factus10/tspico-hardware/hardware/bom/tspico-v3-bom-full.csv

Value | Reference | Footprint | MPN | LCSC | Qty | Fitted by
100n | C1-C6,C10,C21,C23-C31,C37,C38,C47,C48,C51,C61,C79 | Capacitor_SMD:C_0603_1608Metric | CC0603KRX7R9BB104 | C14663 | 24 | JLCPCB
4.7u | C20,C22,C39 | Capacitor_SMD:C_0402_1005Metric | CL05A475MP5NRNC | C23733 | 3 | JLCPCB
15p | C35,C36 | Capacitor_SMD:C_0603_1608Metric | CL10C150JB8NNNC | C1644 | 2 | JLCPCB
220u | C40,C41,C46 | Capacitor_SMD:CP_Elec_6.3x5.4 | RVT220UF10V67RV0037 | C2833309 | 3 | JLCPCB
10u | C42-C45,C50,C60,C80,C81 | Capacitor_SMD:C_0603_1608Metric | CL10A106KP8NNNC | C19702 | 8 | JLCPCB
1u | C52,C53,C70 | Capacitor_SMD:C_0603_1608Metric | CL10A105KB8NNNC | C15849 | 3 | JLCPCB
10n | C71,C72,C75,C76 | Capacitor_SMD:C_0603_1608Metric | CL10B103KB8NNNC | C57112 | 4 | JLCPCB
100p | C90-C95 | Capacitor_SMD:C_0603_1608Metric | CL10C101JB8NNNC | C14858 | 6 | JLCPCB
SS34 | D2,D3 | Diode_SMD:D_SMA | SS34 | C8678 | 2 | JLCPCB
green | D4 | LED_SMD:LED_0805_2012Metric | KT-0805G | C2297 | 1 | JLCPCB
USB-C | J1 | Connector_USB:USB_C_Receptacle_HRO_TYPE-C-31-M-12 | TYPE-C-31-M-12 | C165948 | 1 | JLCPCB
microSD | J2 | tspico:microSD_TF-01A | TF-01A | C91145 | 1 | JLCPCB
OLED 1.54in 128x64 I2C | J3 | Connector_PinHeader_2.54mm:PinHeader_1x04_P2.54mm_Vertical | 2.54-1x40P (cut to 4) | C2337 | 1 | hand
3.5mm stereo | J4 | Connector_Audio:Jack_3.5mm_PJ320D_Horizontal | PJ-320D | C431535 | 1 | JLCPCB
Joystick | J5 | Connector_Dsub:DSUB-9_Pins_Horizontal_P2.77x2.84mm_EdgePinOffset7.70mm_Housed_MountingHolesOffset9.12mm | DS1037-09MNAKT74-0CC | C75750 | 1 | hand
JOY +5V | JP10 | Jumper:SolderJumper-2_P1.3mm_Open_RoundedPad1.0x1.5mm |  |  | 1 | none (board feature)
TS2068_Edge | P1 | tspico:TS2068_EdgeConnector_2x32 |  |  | 1 | none (board feature)
4k7 | R1,R2,R6,R7,R44,R45 | Resistor_SMD:R_0603_1608Metric | 0603WAF4701T5E | C23162 | 6 | JLCPCB
1k | R3,R20,R23,R71,R72,R75,R76 | Resistor_SMD:R_0603_1608Metric | 0603WAF1001T5E | C21190 | 7 | JLCPCB
100 | R5,R80,R81,R90-R95 | Resistor_SMD:R_0603_1608Metric | 0603WAF1000T5E | C22775 | 9 | JLCPCB
10k | R8-R10,R12,R13,R15-R17,R21,R22,R34-R38,R40,R41,R43,R73,R77,R96-R101 | Resistor_SMD:R_0603_1608Metric | 0603WAF1002T5E | C25804 | 26 | JLCPCB
2k2 | R14 | Resistor_SMD:R_0603_1608Metric | 0603WAF2201T5E | C4190 | 1 | JLCPCB
5k1 | R24,R25 | Resistor_SMD:R_0603_1608Metric | 0603WAF5101T5E | C23186 | 2 | JLCPCB
33 | R26-R28,R30-R33 | Resistor_SMD:R_0603_1608Metric | 0603WAF330JT5E | C23140 | 7 | JLCPCB
0 | R39 | Resistor_SMD:R_0603_1608Metric | 0603WAF0000T5E | C21189 | 1 | JLCPCB
15k | R42 | Resistor_SMD:R_0603_1608Metric | 0603WAF1502T5E | C22809 | 1 | JLCPCB
100k | R70 | Resistor_SMD:R_0603_1608Metric | 0603WAF1003T5E | C25803 | 1 | JLCPCB
22k | R74,R78 | Resistor_SMD:R_0603_1608Metric | 0603WAF2202T5E | C31850 | 2 | JLCPCB
TS Reset | SW1 | Button_Switch_SMD:SW_Push_1P1T_XKB_TS-1187A | TS-1187A-B-A-B | C318884 | 1 | JLCPCB
NMI | SW2 | Button_Switch_SMD:SW_Push_1P1T_XKB_TS-1187A | TS-1187A-B-A-B | C318884 | 1 | JLCPCB
RUN | SW3 | Button_Switch_SMD:SW_Push_1P1T_XKB_TS-1187A | TS-1187A-B-A-B | C318884 | 1 | JLCPCB
BOOTSEL | SW4 | Button_Switch_SMD:SW_Push_1P1T_XKB_TS-1187A | TS-1187A-B-A-B | C318884 | 1 | JLCPCB
SWCLK | TP1 | TestPoint:TestPoint_Pad_1.5x1.5mm |  |  | 1 | none (board feature)
SWDIO | TP2 | TestPoint:TestPoint_Pad_1.5x1.5mm |  |  | 1 | none (board feature)
GND | TP3 | TestPoint:TestPoint_Pad_1.5x1.5mm |  |  | 1 | none (board feature)
74LVC245APW | U1-U4 | Package_SO:TSSOP-20_4.4x6.5mm_P0.65mm | 74LVC245APW,118 | C6082 | 4 | JLCPCB
74LVC32APW | U6 | Package_SO:TSSOP-14_4.4x5mm_P0.65mm | 74LVC32APW,118 | C6087 | 1 | JLCPCB
74LVC06AD | U7 | Package_SO:SOIC-14_3.9x8.7mm_P1.27mm | EM74LVC06AD | C49188178 | 1 | JLCPCB
XL9555 | U15 | Package_SO:TSSOP-24_4.4x7.8mm_P0.65mm | XL9555 | C609791 | 1 | JLCPCB
RP2350B | U20 | Package_DFN_QFN:QFN-80-1EP_10x10mm_P0.4mm_EP3.4x3.4mm | RP2350B | C42415655 | 1 | JLCPCB
GD25Q128ESIGR | U21 | Package_SO:SOIC-8_5.3x5.3mm_P1.27mm | GD25Q128ESIGR | C2928891 | 1 | JLCPCB
APS6404L-3SQR-SN | U22 | Package_SO:SOIC-8_3.9x4.9mm_P1.27mm | APS6404L-3SQR-SN | C5333729 | 1 | hand (DNP)
TLV1117LV33 | U30,U31 | Package_TO_SOT_SMD:SOT-223-3_TabPin2 | TLV1117LV33DCYR | C15578 | 2 | JLCPCB
SY6280AAC | U32 | Package_TO_SOT_SMD:SOT-23-5 | SY6280AAC | C55136 | 1 | JLCPCB
ME6211C12M5G-N | U33 | Package_TO_SOT_SMD:SOT-23-5 | ME6211C12M5G-N | C236672 | 1 | JLCPCB
ESP32-C3-WROOM-02-N4 | U40 | RF_Module:ESP32-C3-WROOM-02 | ESP32-C3-WROOM-02-N4 | C2934560 | 1 | JLCPCB
MCP6002 | U50 | Package_SO:SOIC-8_3.9x4.9mm_P1.27mm | MCP6002T-I/SN | C7377 | 1 | JLCPCB
12MHz | Y1 | Crystal:Crystal_SMD_3225-4Pin_3.2x2.5mm | ABM8-272-T3 | C20625731 | 1 | JLCPCB
