factus10/tspico-hardware/hardware/docs/tspico-v3-pcb.pdf

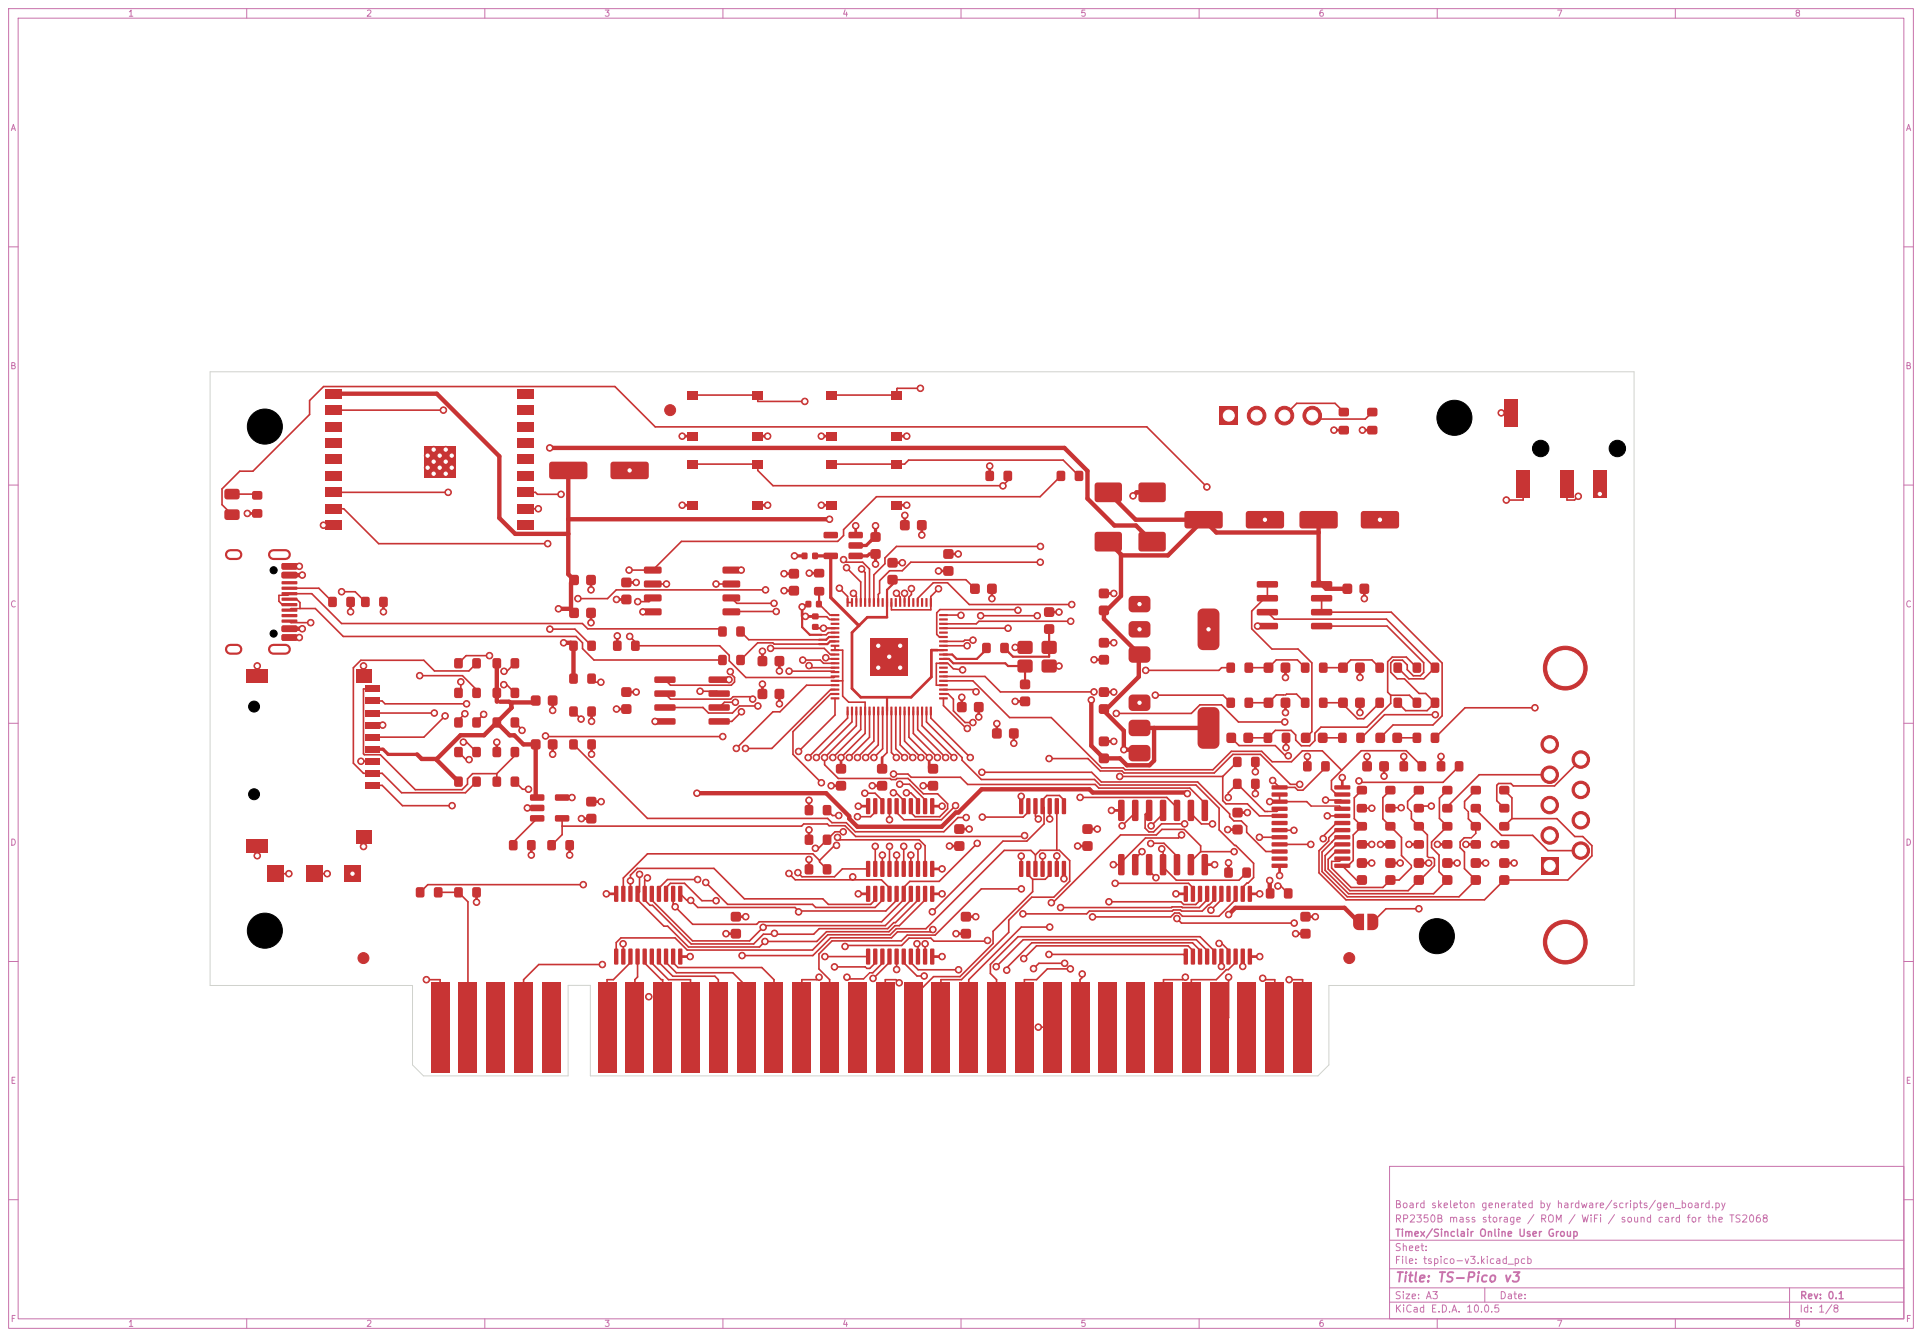
[picture p6: page 1]

Board skeleton generated by hardware/scripts/gen_board.py
RP2350B mass storage / ROM / WiFi / sound card for the TS2068
Timex/Sinclair Online User Group
Sheet:
File: tspico-v3.kicad_pcb
Title: TS-Pico v3

Size: A3 | Rev: 0.1 | F Date:
KiCad E.D.A. 10.0.5 | Id: 1/8

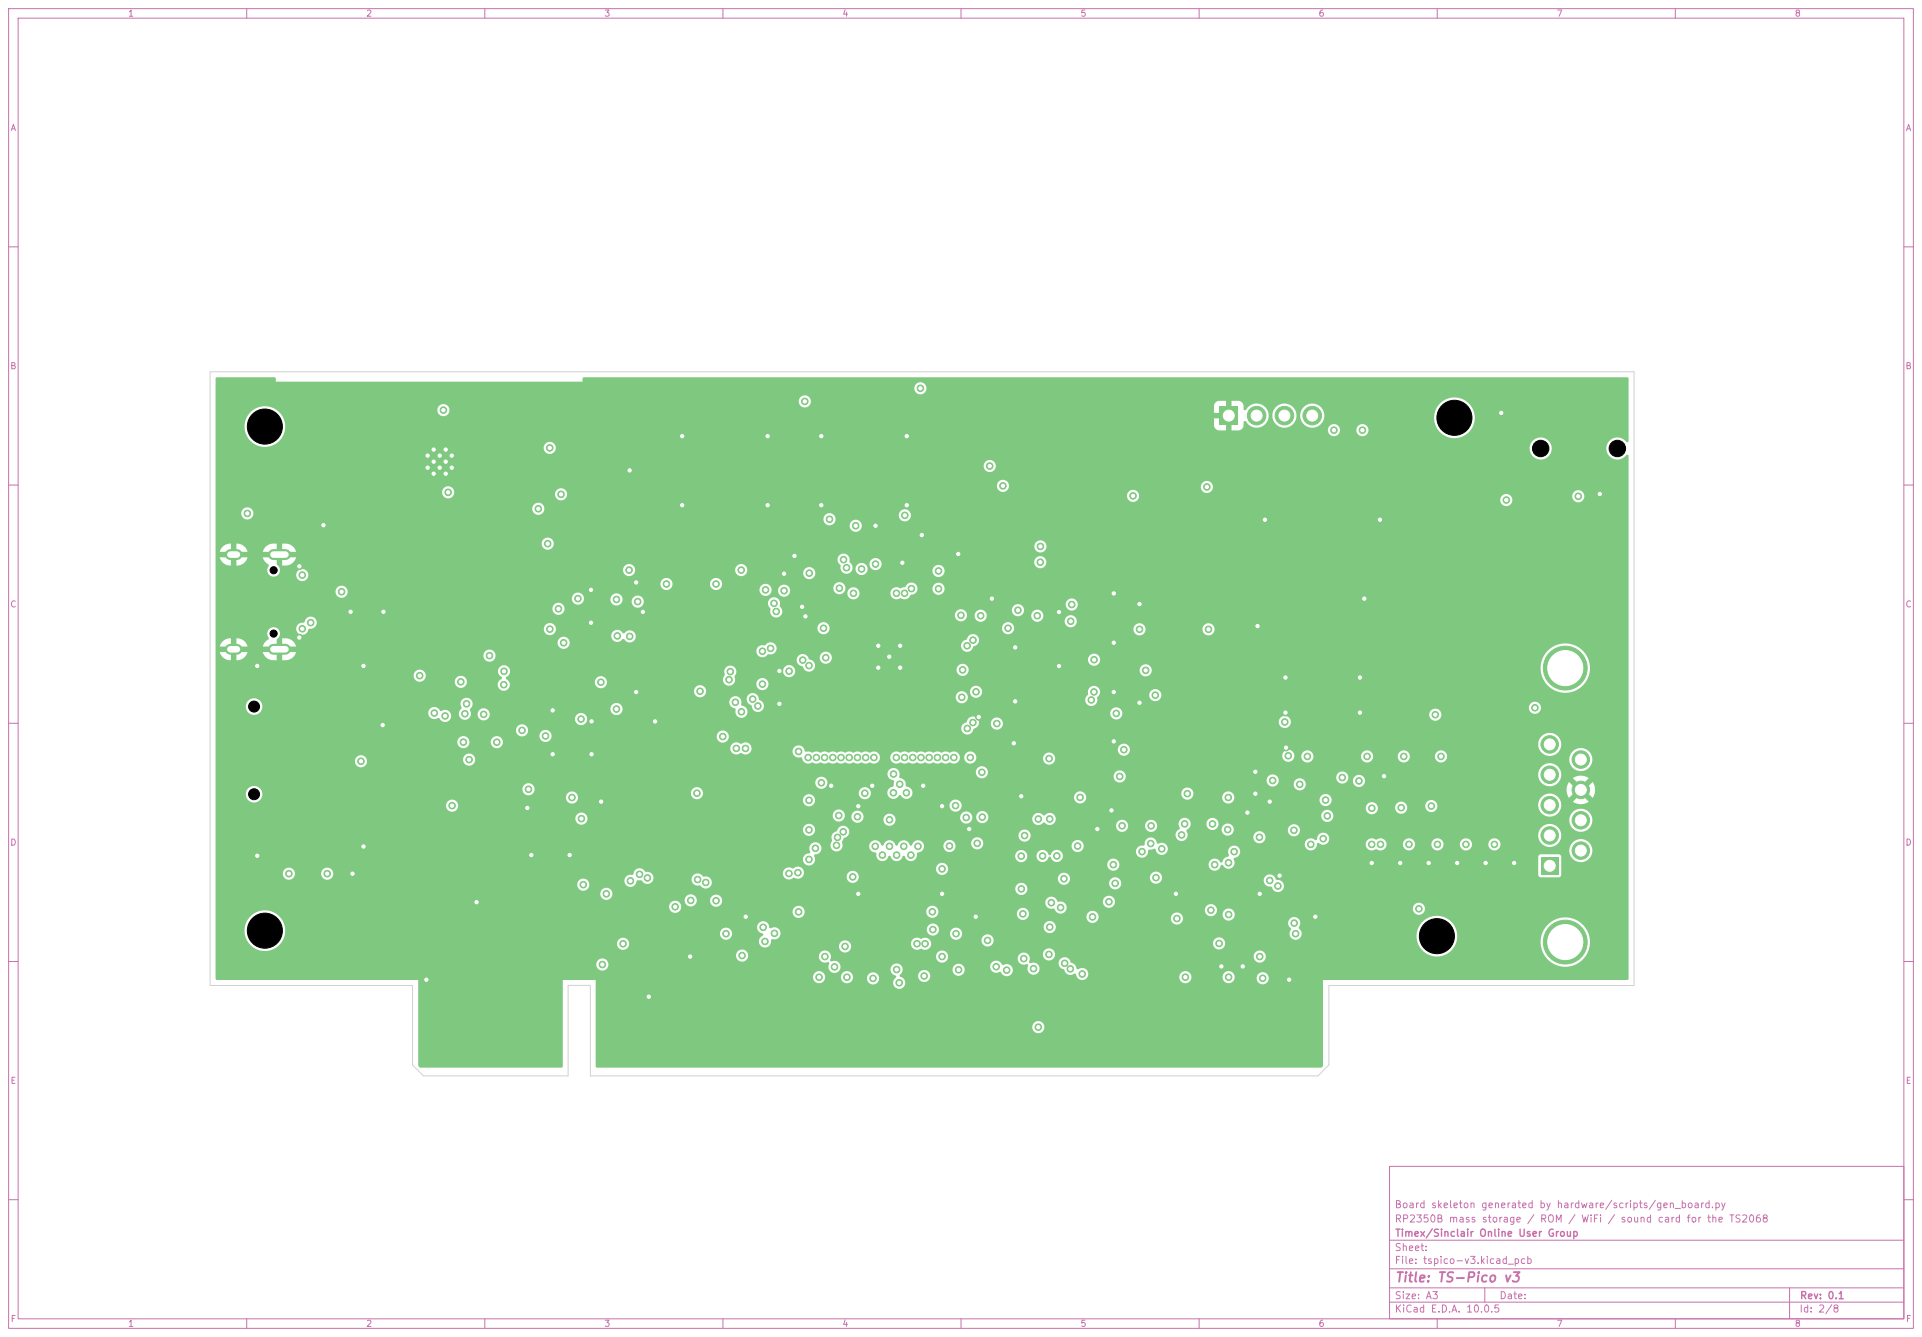
[picture p7: page 2]
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

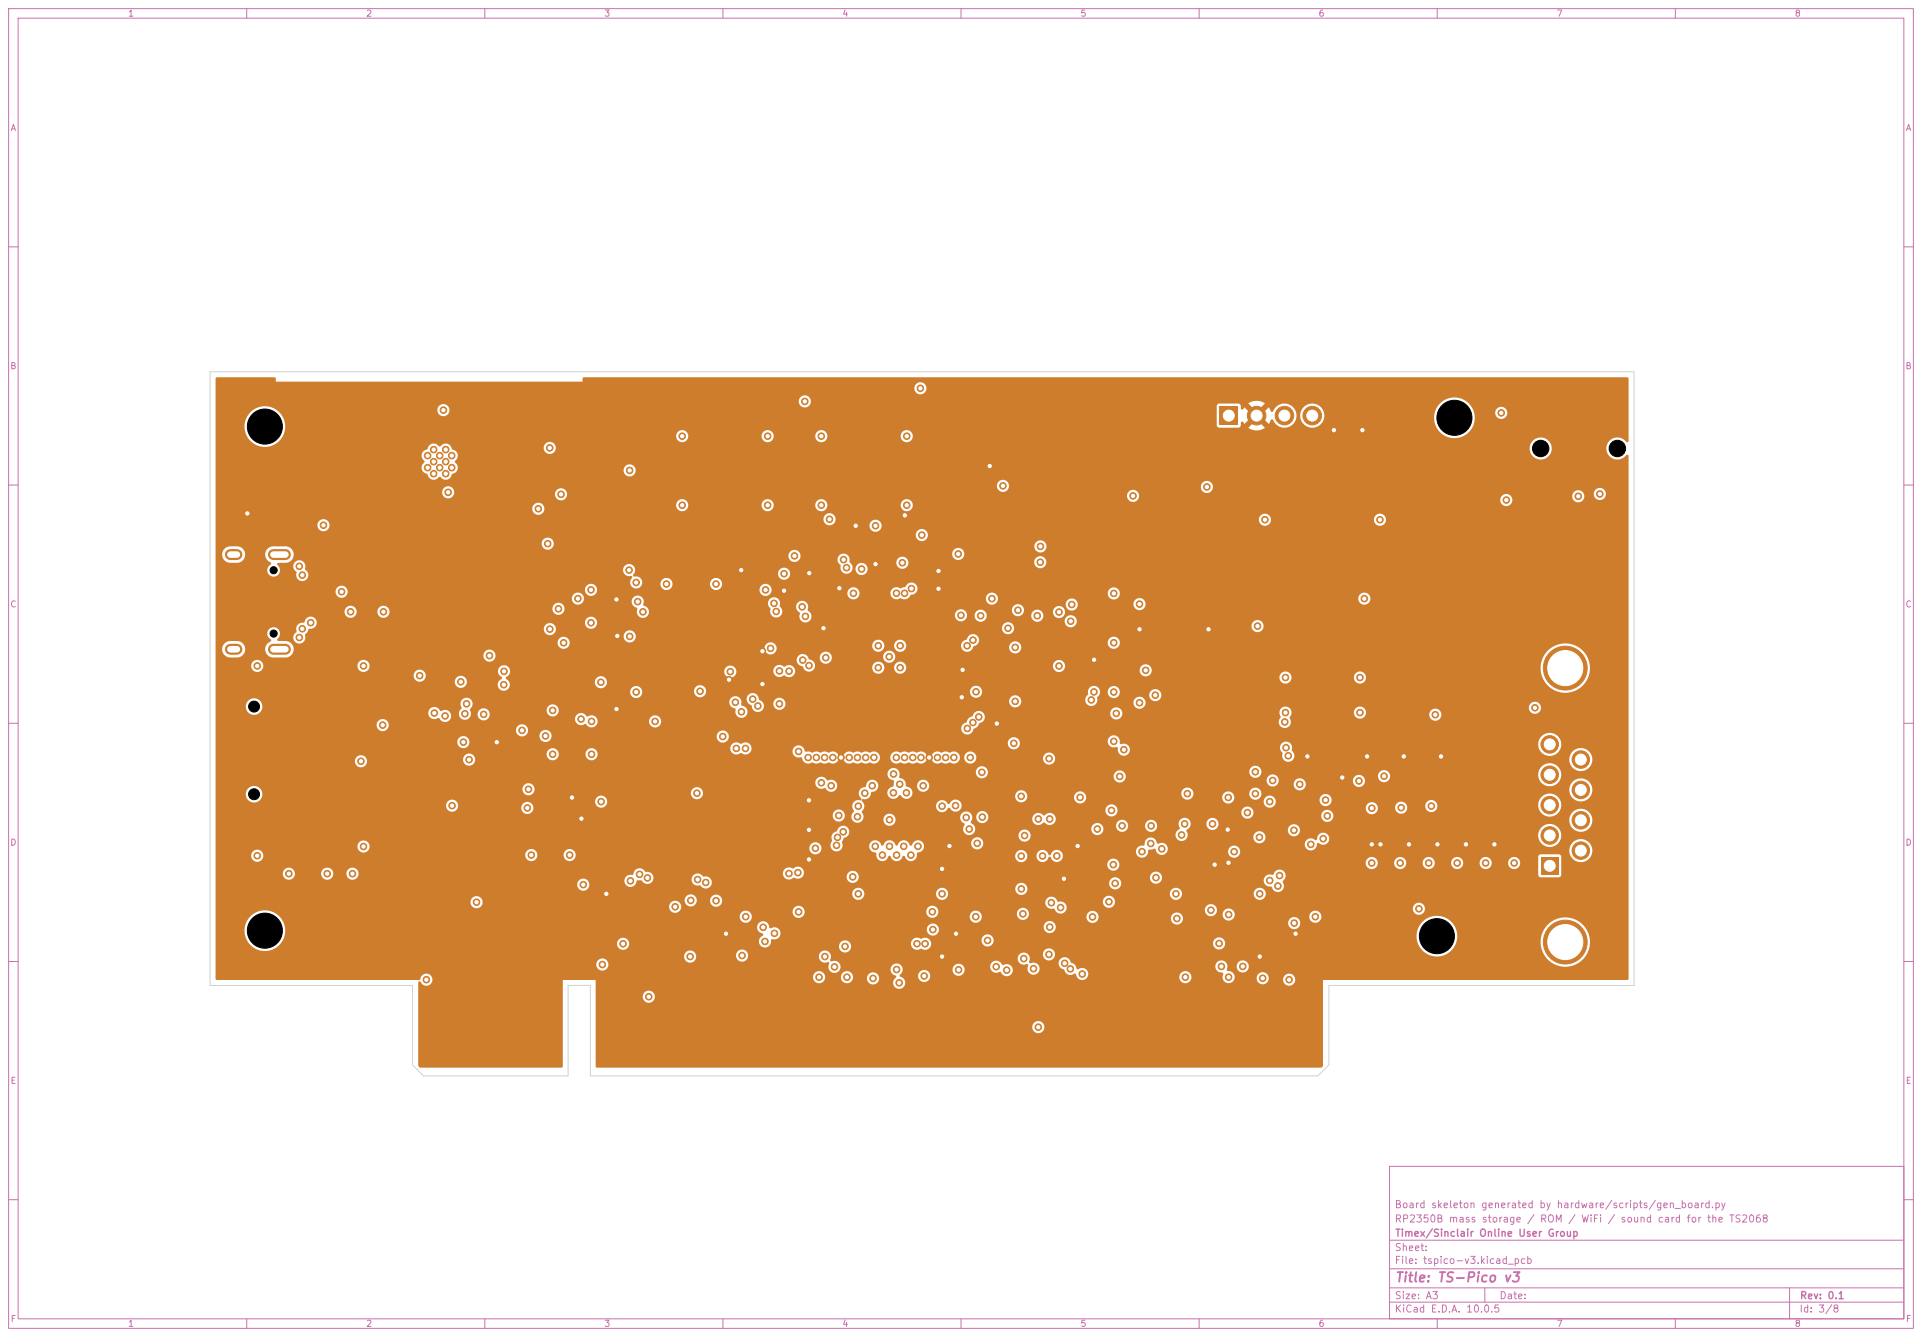
[picture p8: page 3]
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

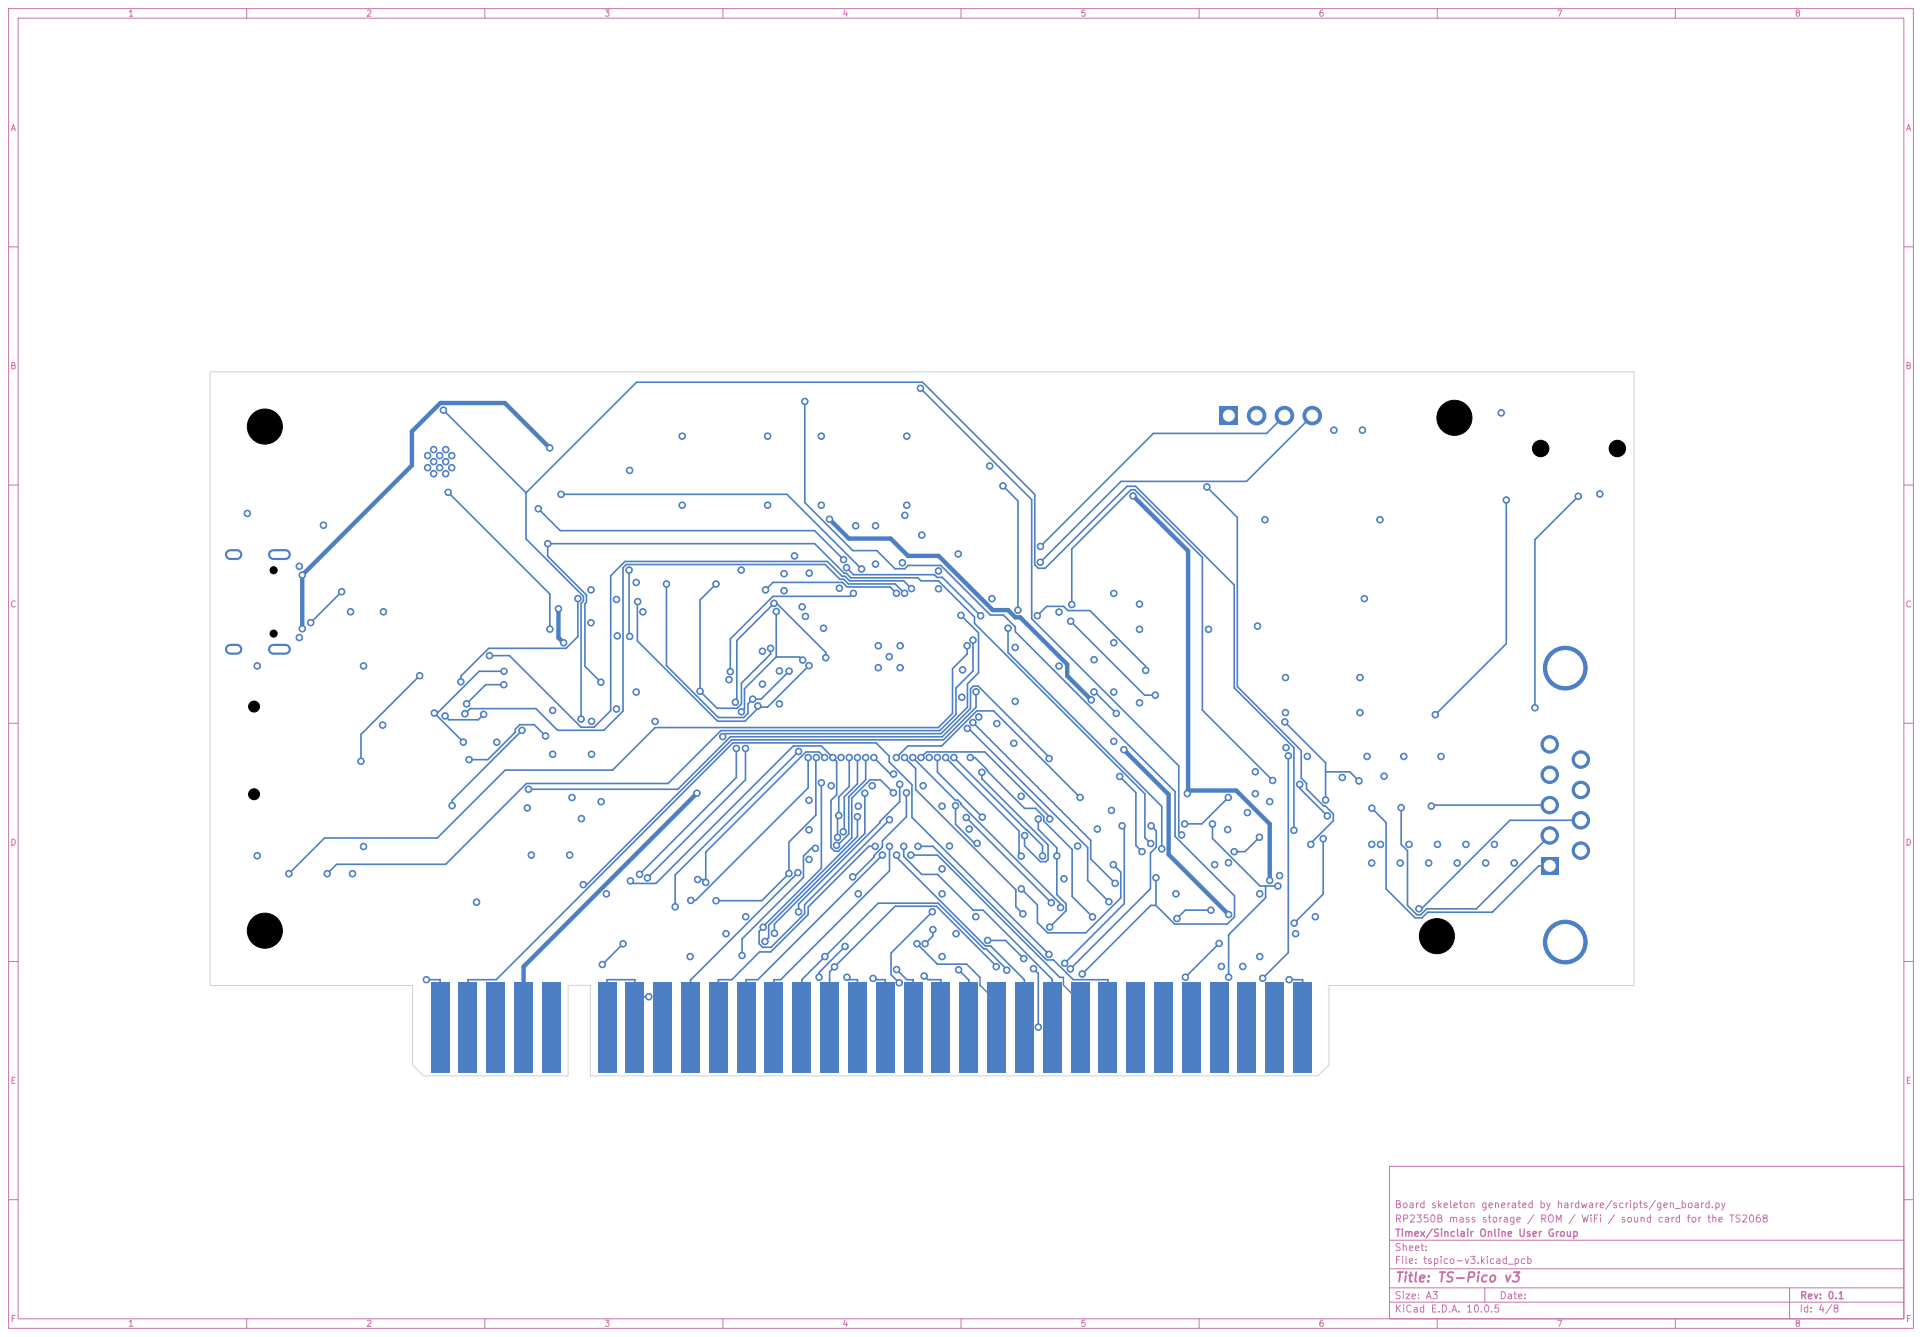
[picture p9: page 4]
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

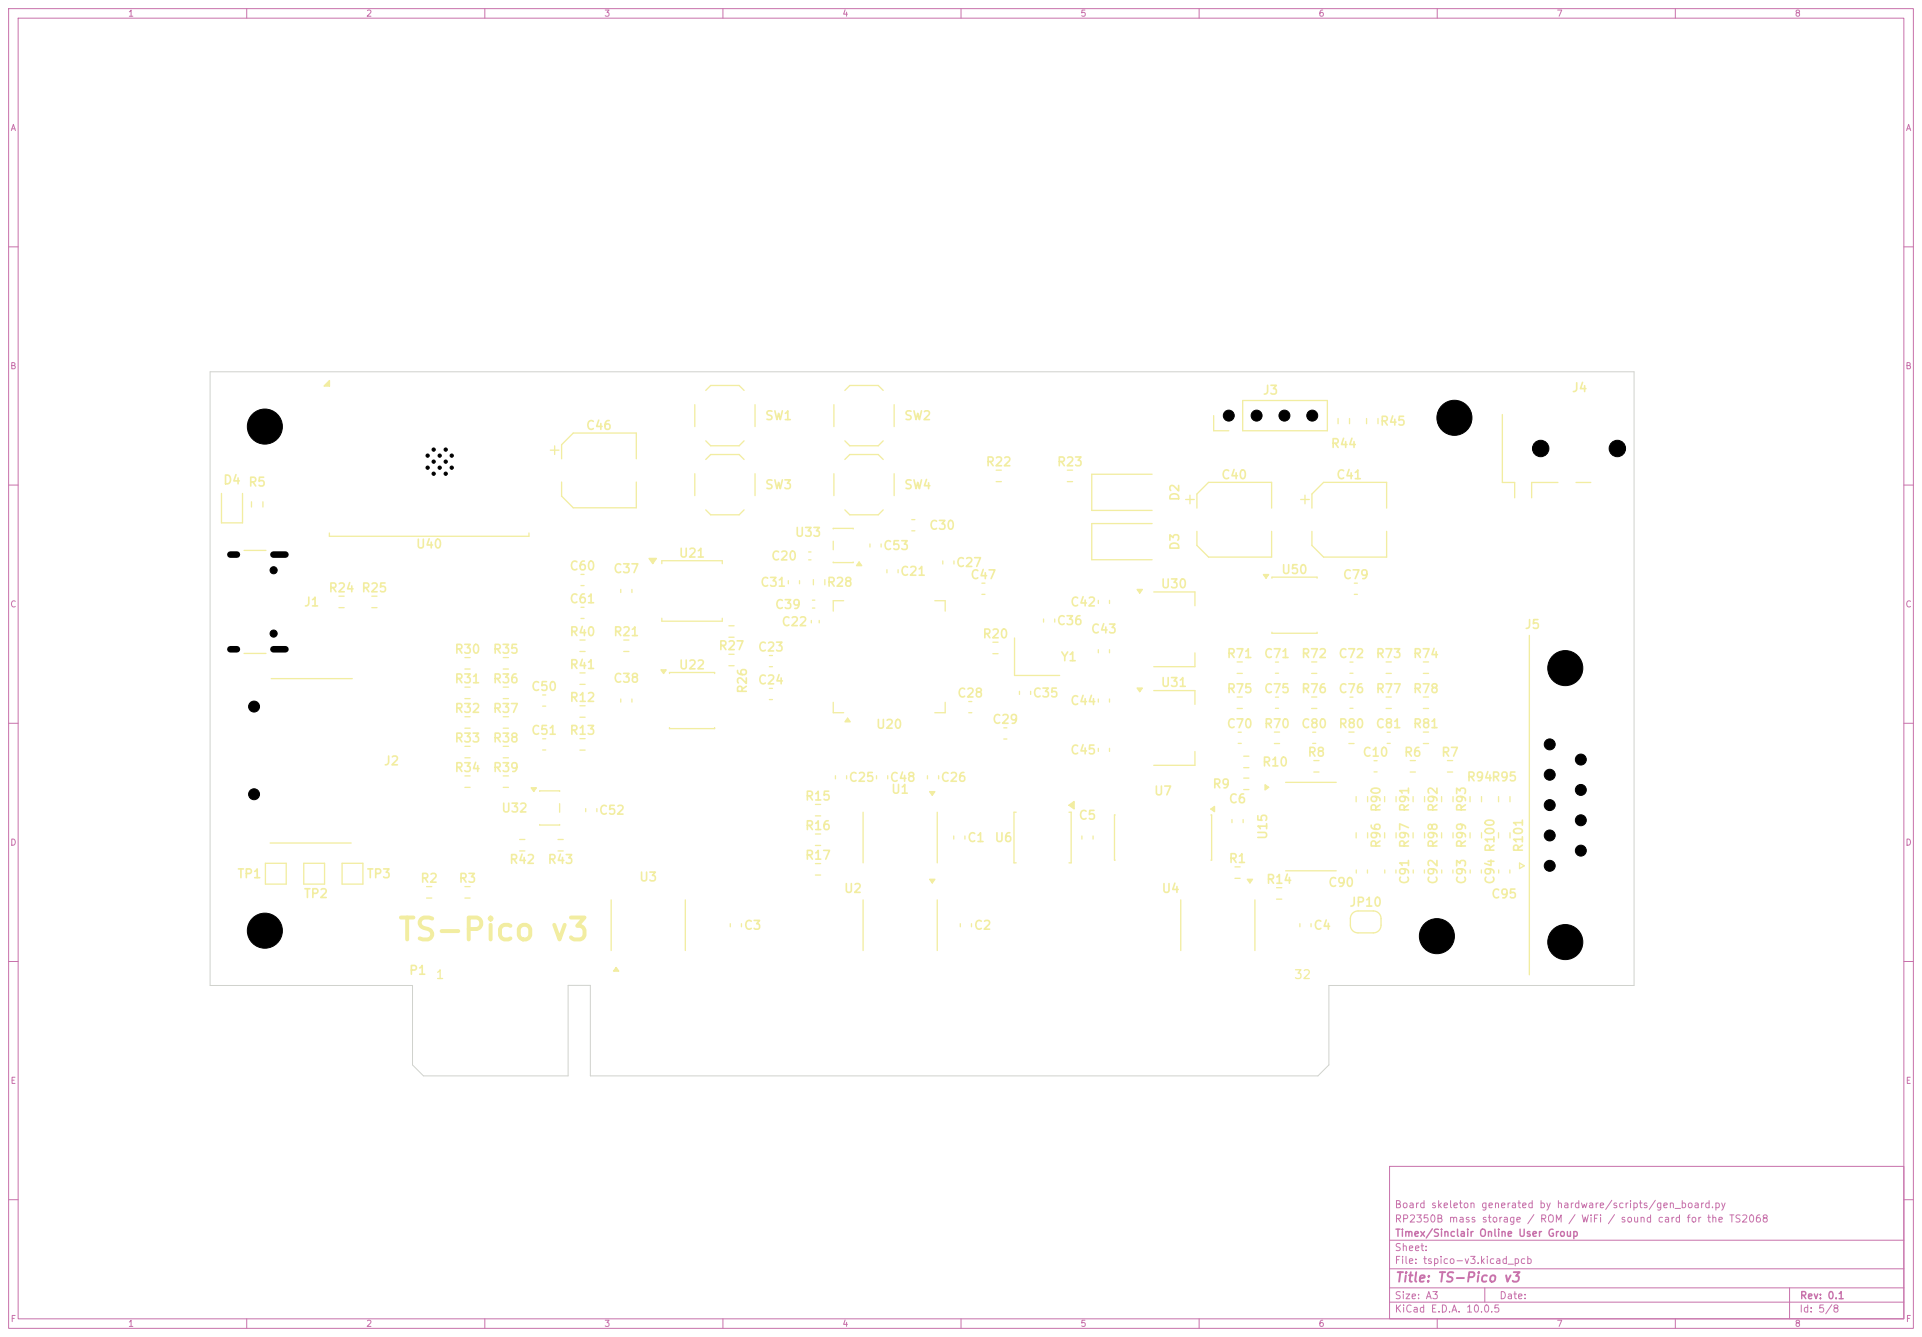
[picture p10: page 5]
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

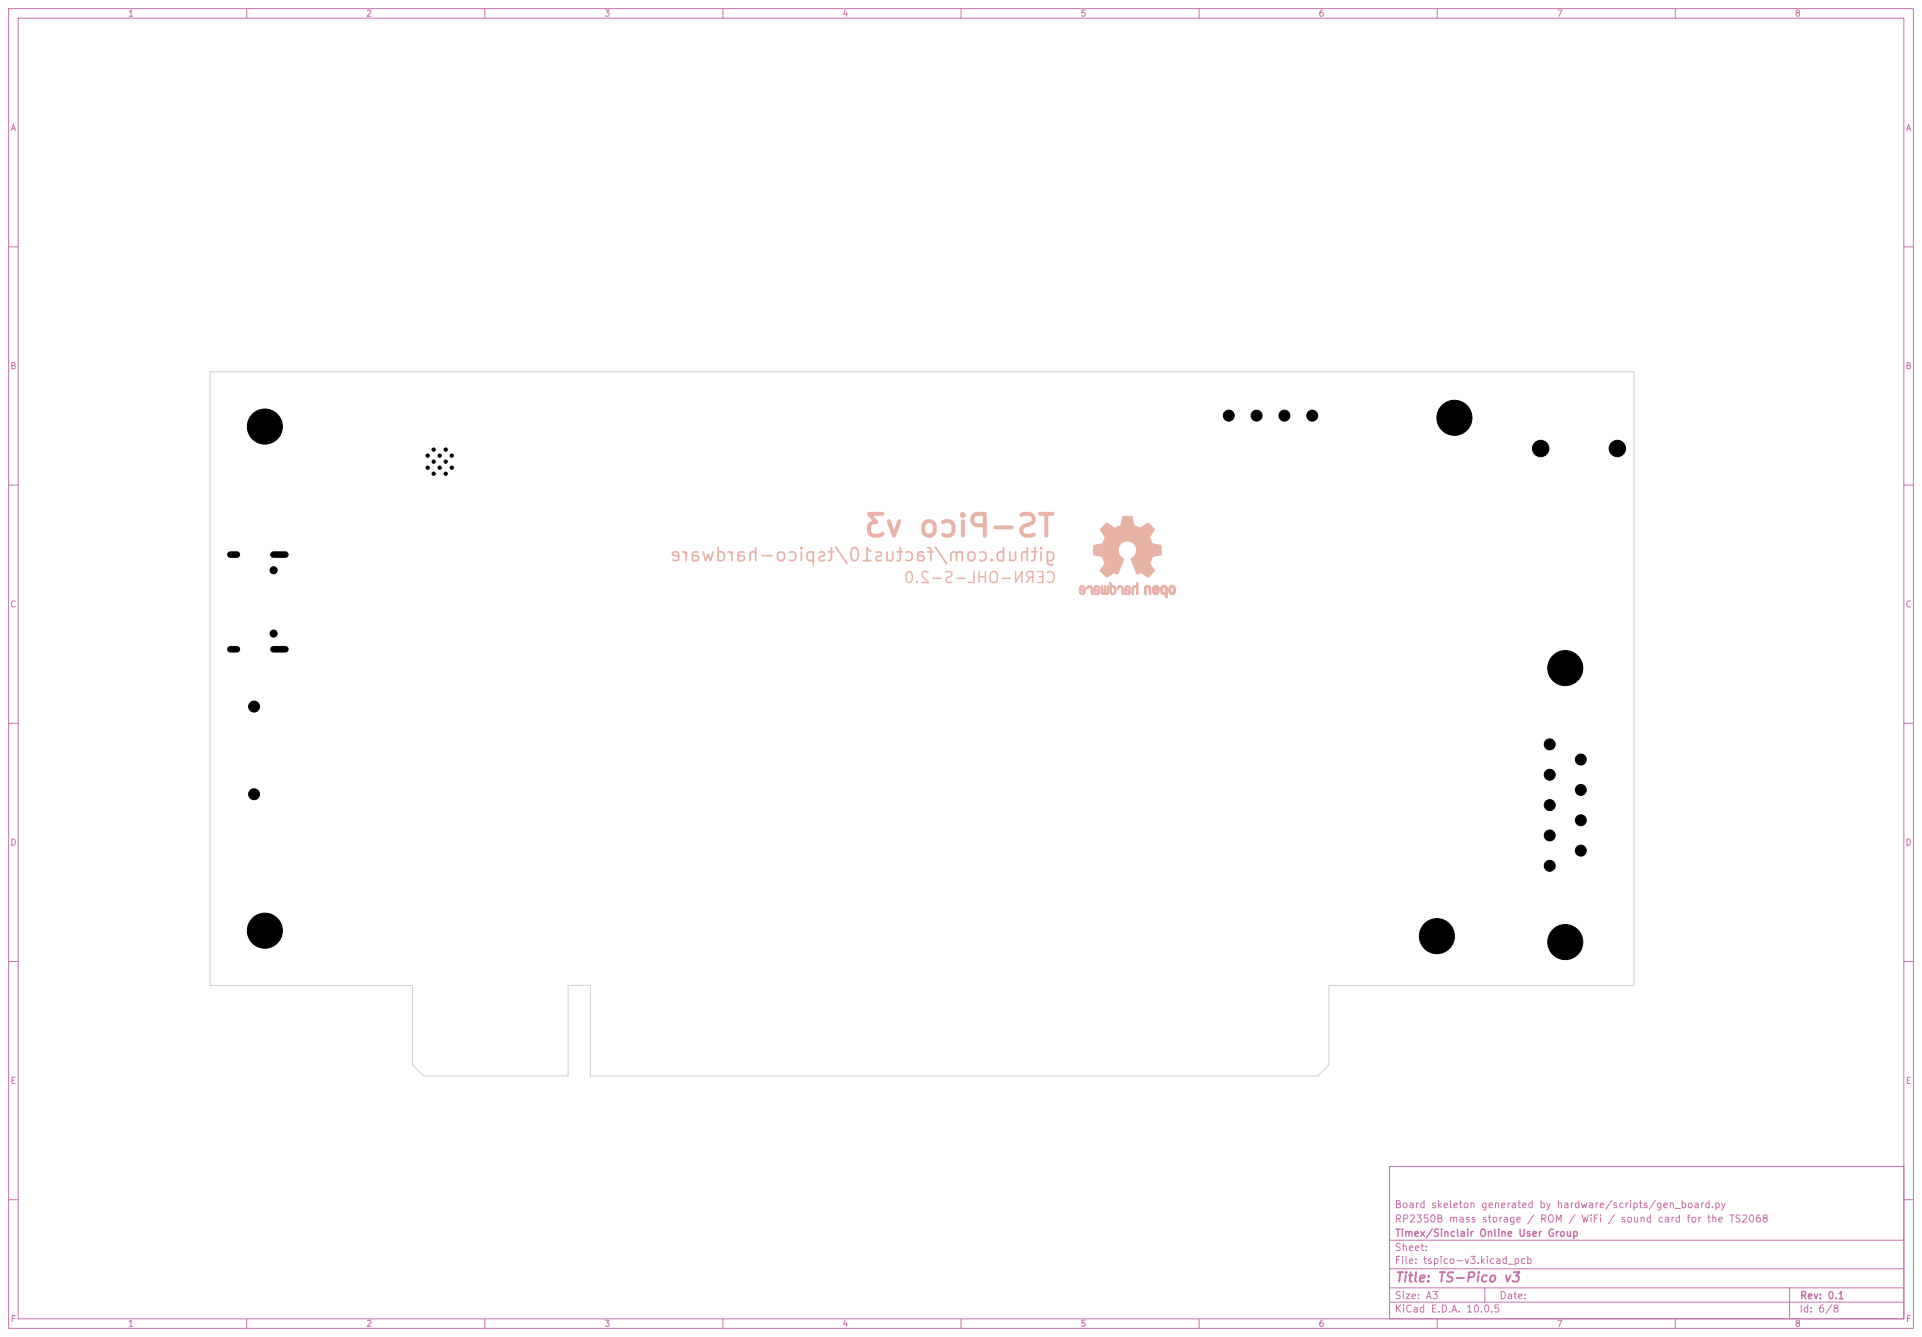
[picture p11: page 6]
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

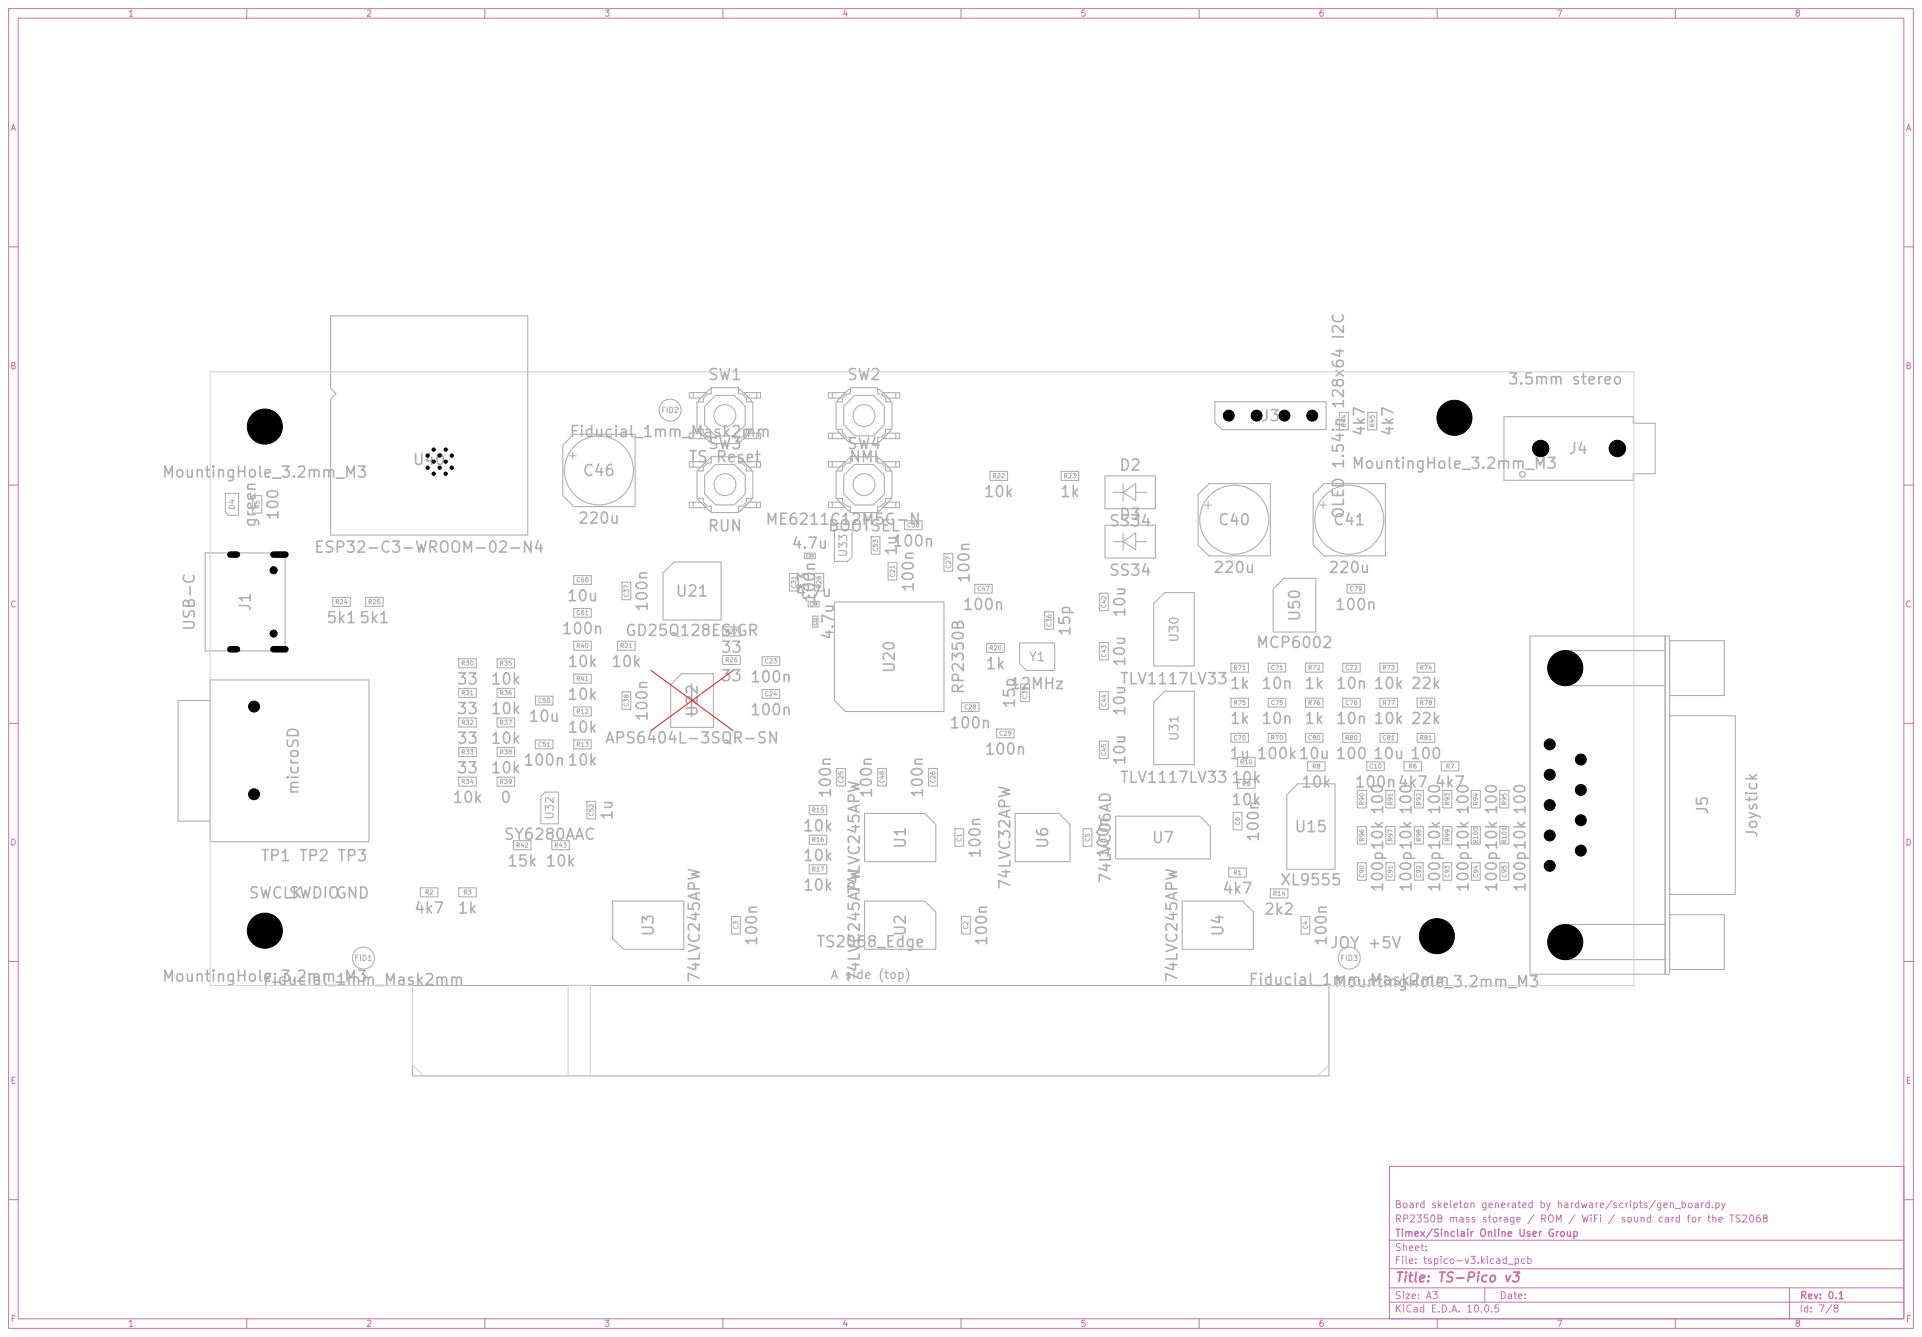
[picture p12: page 7]
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

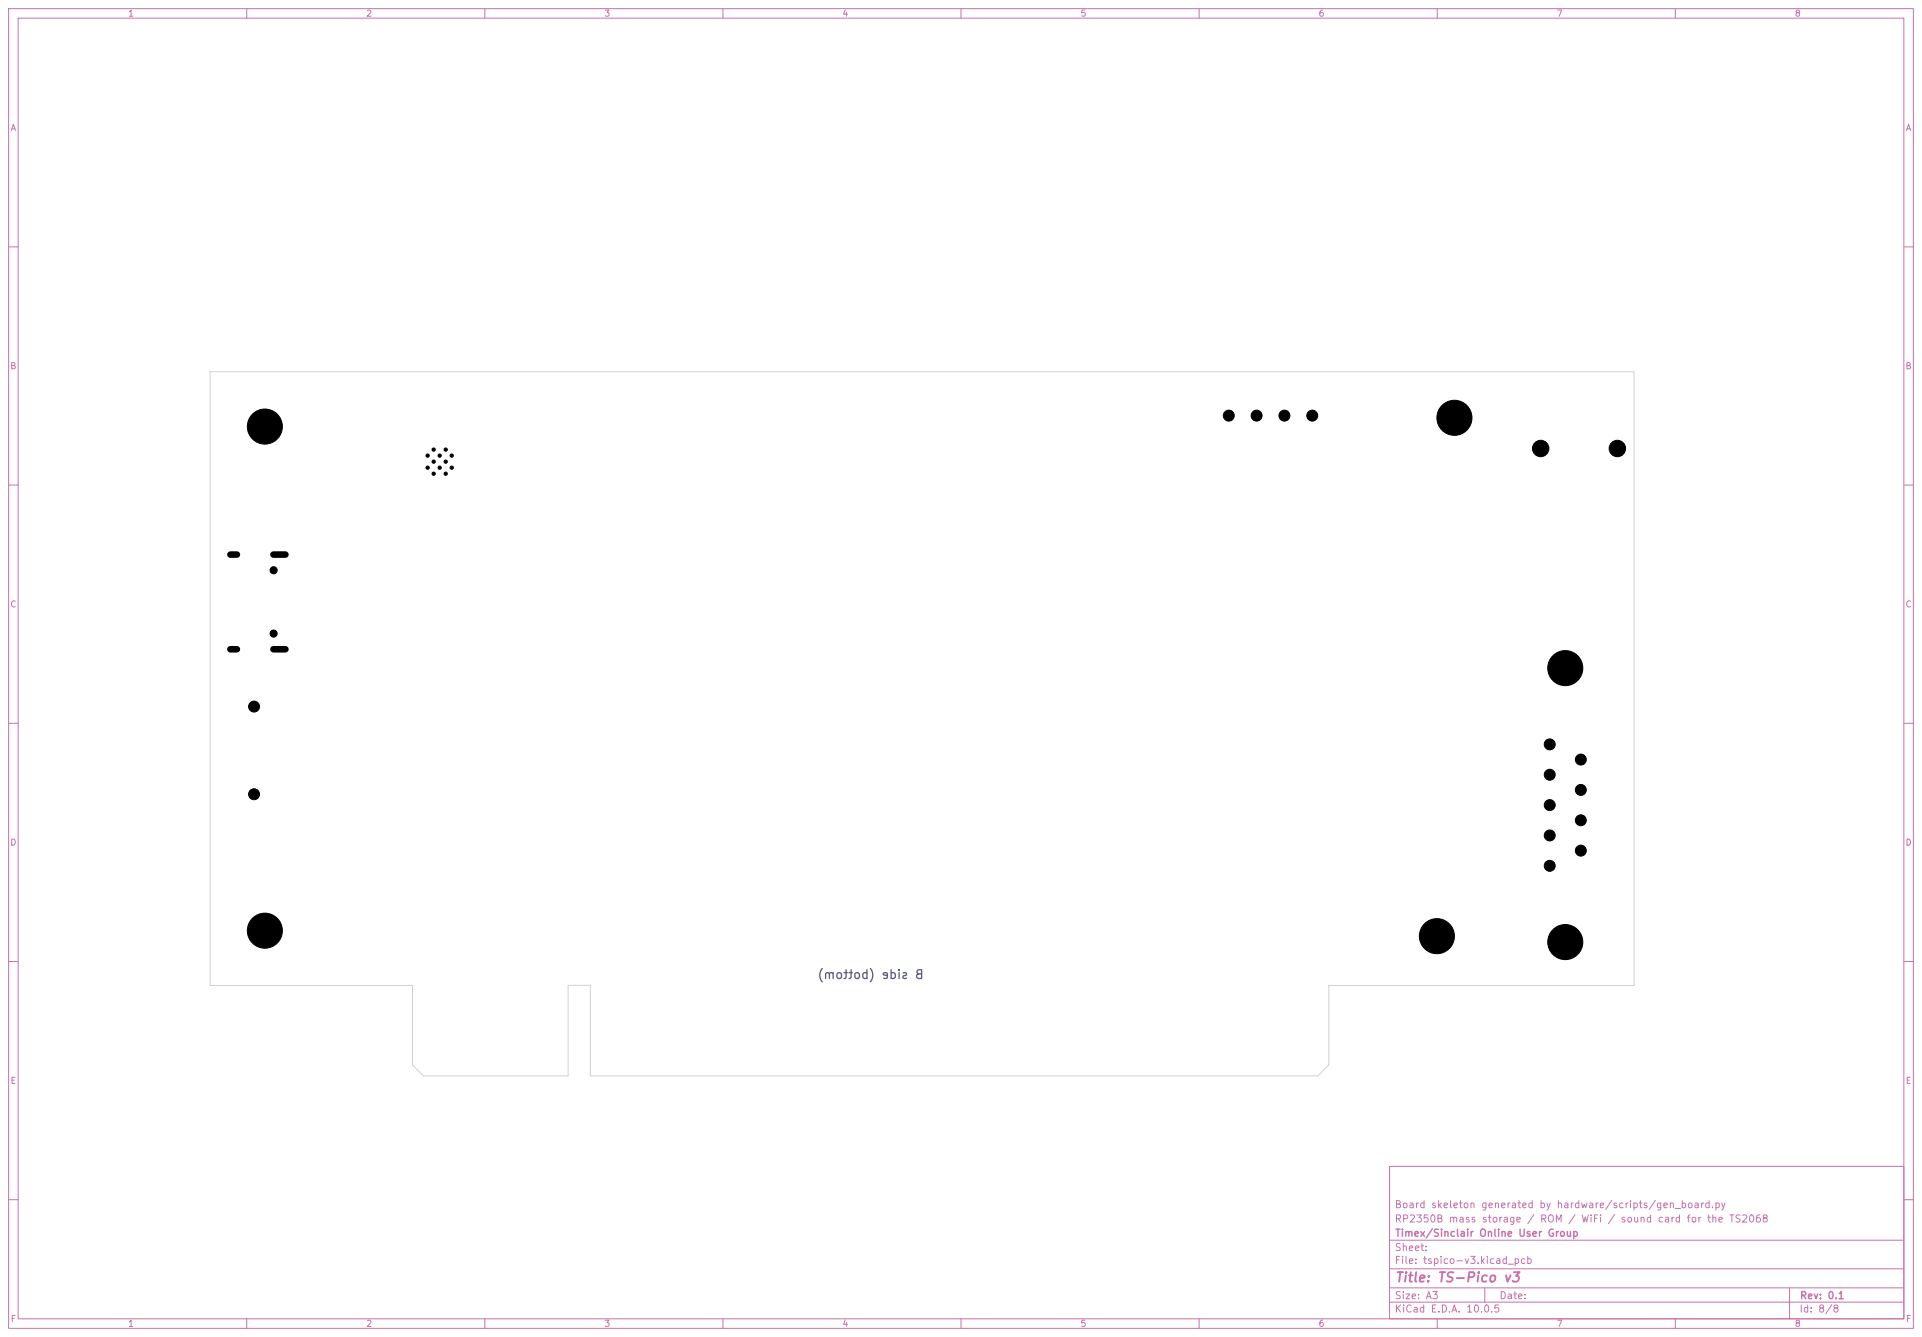
[picture p13: page 8]
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
