factus10/tspico-hardware/hardware/docs/tspico-v3-schematic.pdf

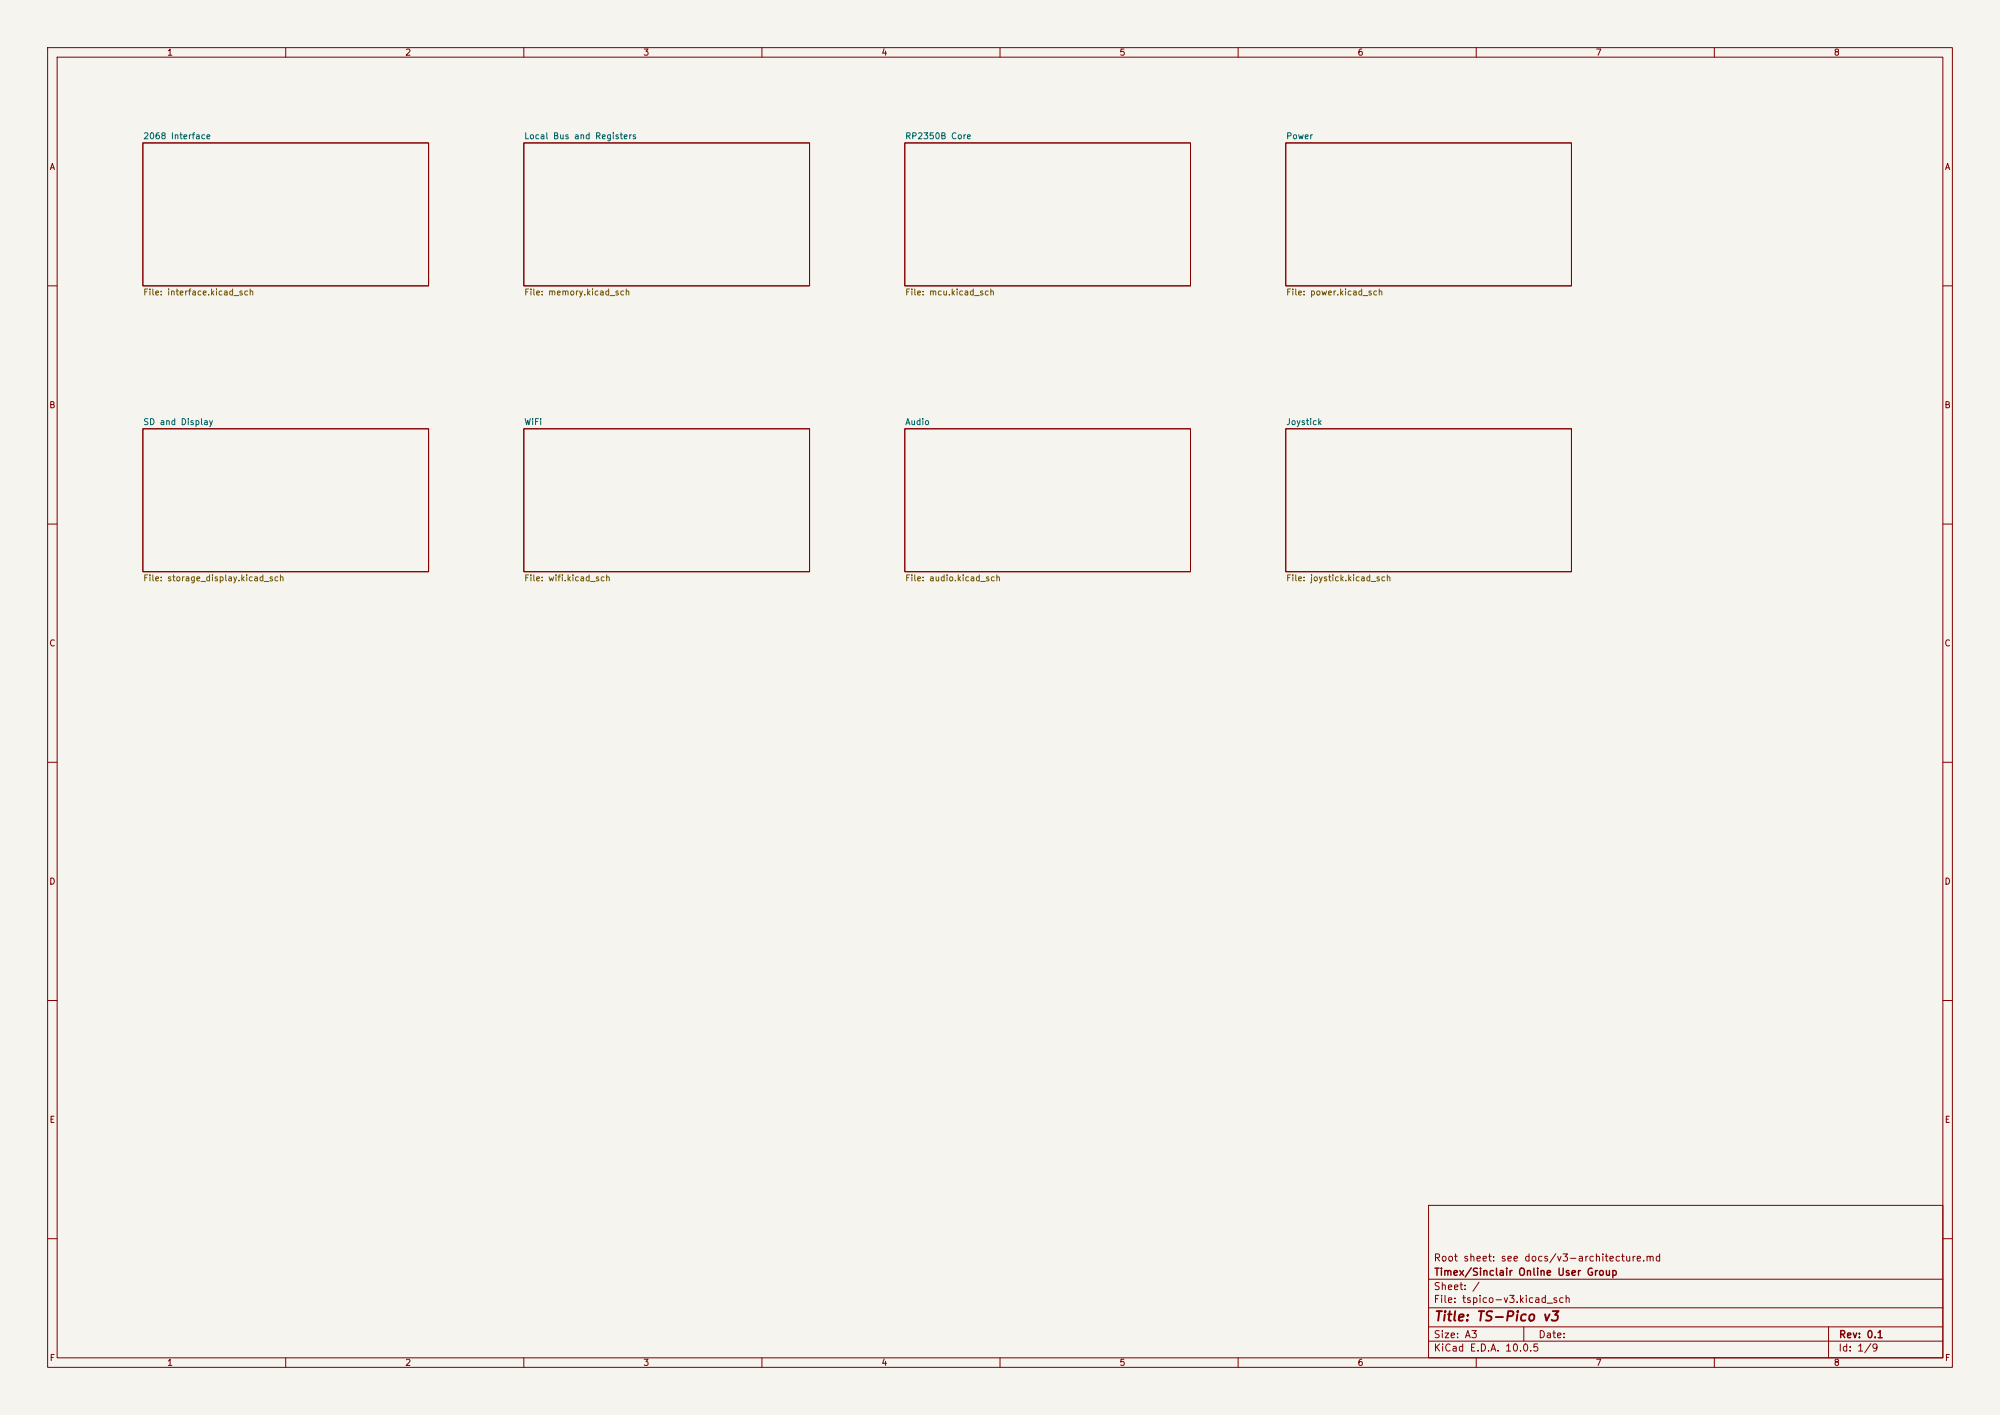
[picture p14: page 1]

Root sheet: see docs/v3-architecture.md
Timex/Sinclair Online User Group
Sheet: /
File: tspico-v3.kicad_sch
Title: TS-Pico v3

Size: A3 | Rev: 0.1 | F Date:
KiCad E.D.A. 10.0.5 | Id: 1/9

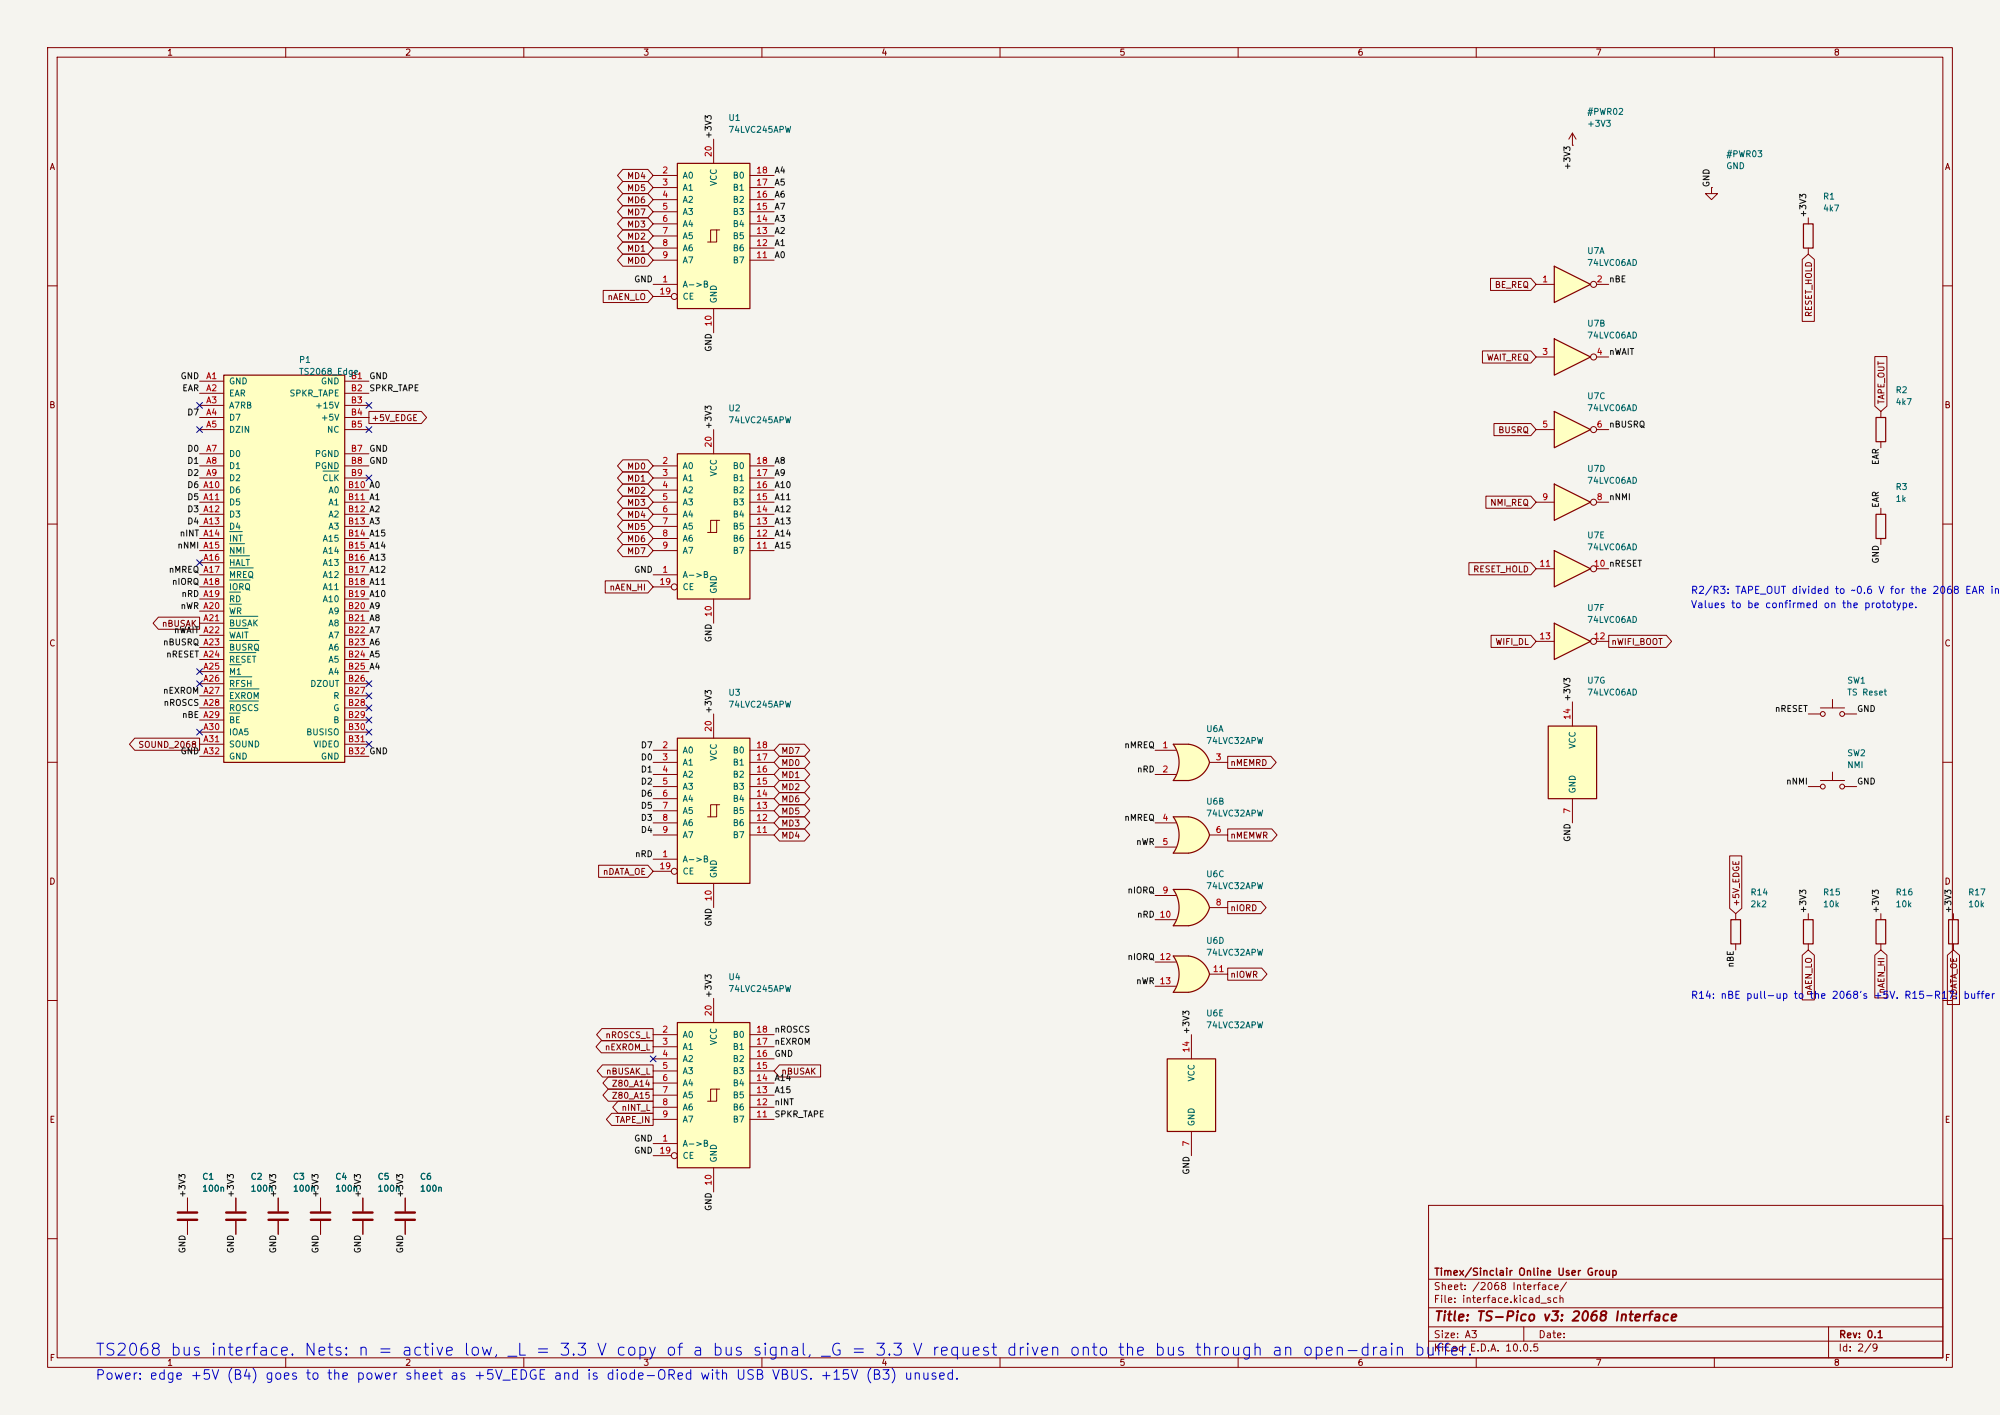
[picture p15: page 2]

R2/R3: TAPE_OUT divided to ~0.6 V for the 2068 EAR input.

Values to be confirmed on the prototype. C6

R14: nBE pull-up to the 2068's +5V. R15-R17: buffer enables held off until the firmware drives GP8-GP10.

Timex/Sinclair Online User Group
Sheet: /2068 Interface/
File: interface.kicad_sch
Title: TS-Pico v3: 2068 Interface

TS2068 bus interface. Nets: n = active low, _L = 3.3 V copy of a bus signal, _G = 3.3 V request driven onto the bus through an open-drain buffer.
Power: edge +5V (B4) goes to the power sheet as +5V_EDGE and is diode-ORed with USB VBUS. +15V (B3) unused.

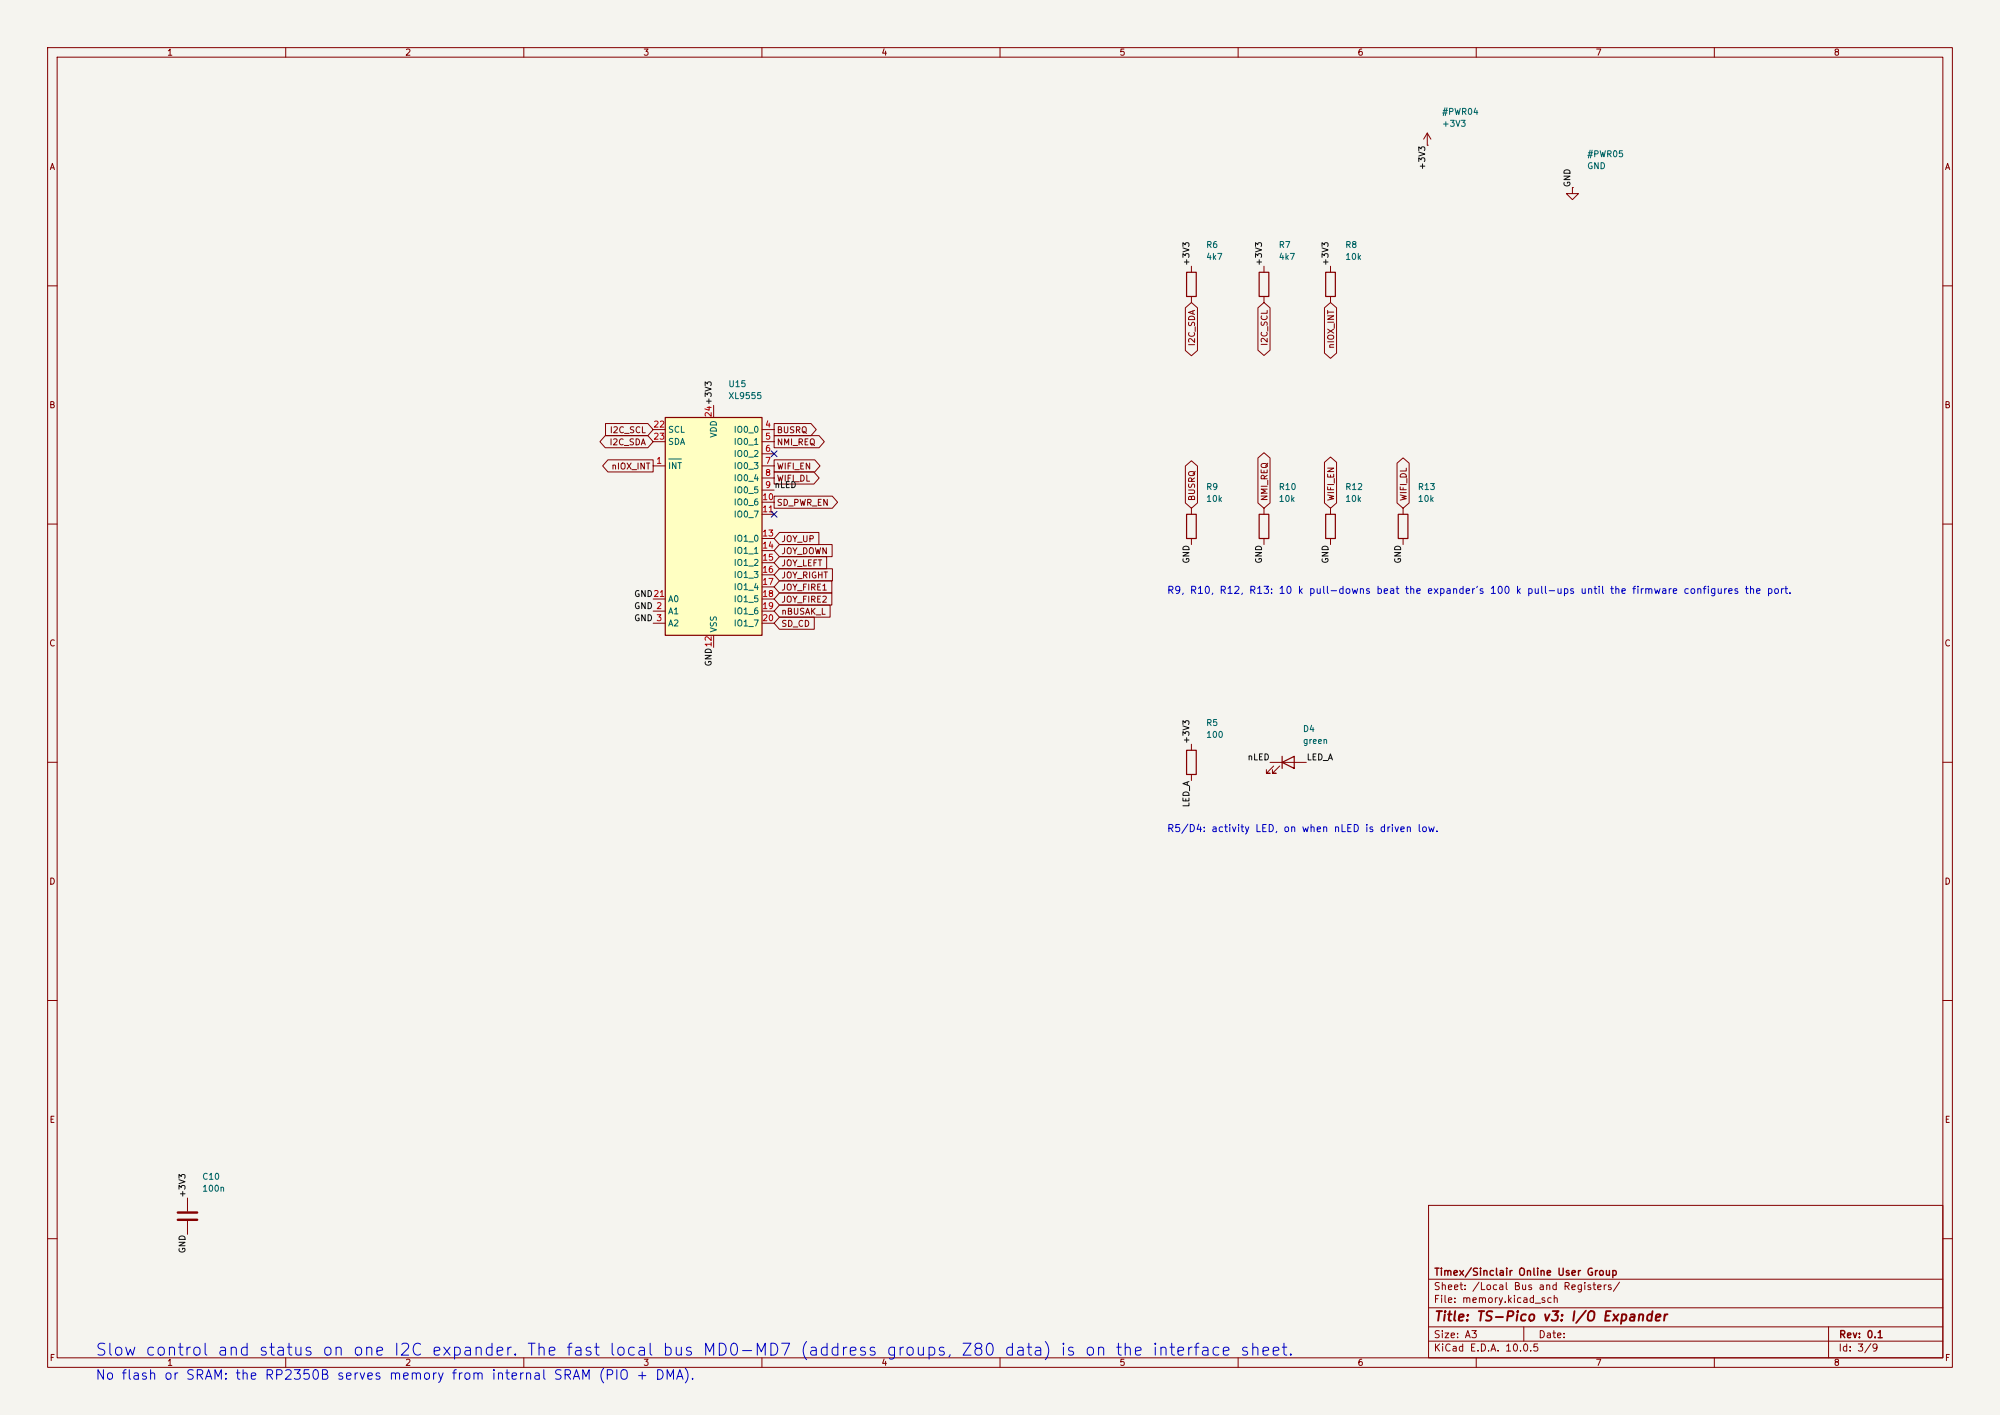
[picture p16: page 3]

R9, R10, R12, R13: 10 k pull-downs beat the expander's 100 k pull-ups until the firmware configures the port.

Timex/Sinclair Online User Group
Sheet: /Local Bus and Registers/
File: memory.kicad_sch
Title: TS-Pico v3: I/O Expander

Slow control and status on one I2C expander. The fast local bus MD0-MD7 (address groups, Z80 data) is on the interface sheet.
No flash or SRAM: the RP2350B serves memory from internal SRAM (PIO + DMA).

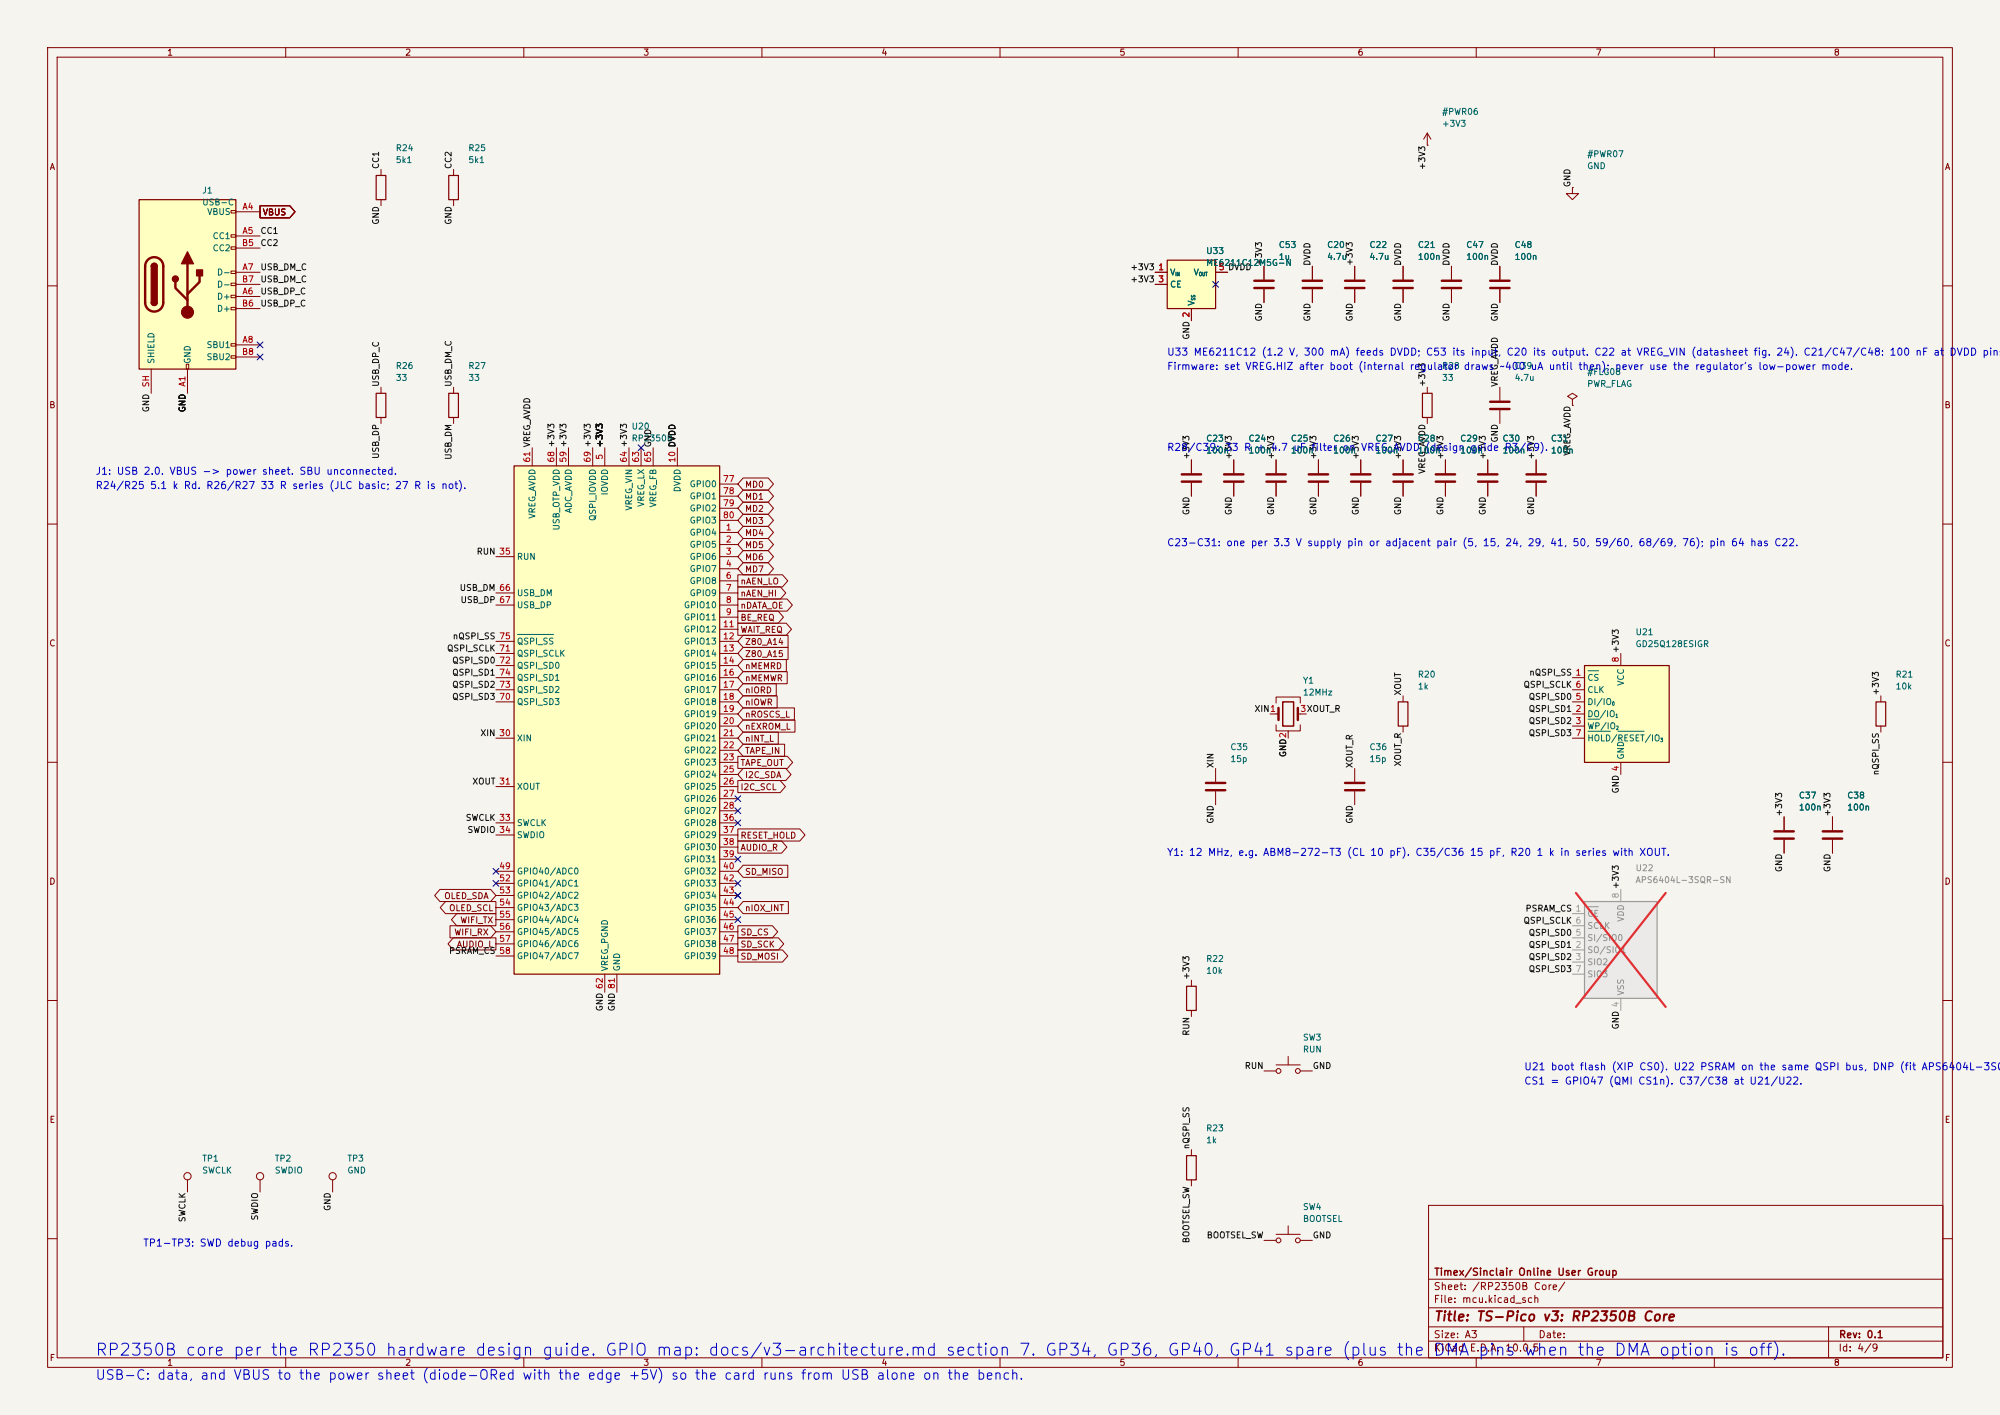
[picture p17: page 4]

C23-C31: one per 3.3 V supply pin or adjacent pair (5, 15, 24, 29, 41, 50, 59/60, 68/69, 76); pin 64 has C22. U33 ME6211C12M5G-N

Timex/Sinclair Online User Group GND A1

U33 ME6211C12 (1.2 V, 300 mA) feeds DVDD; C53 its input, C20 its output. C22 at VREG_VIN (datasheet fig. 24). C21/C47/C48: 100 nF at DVDD pins 51, 32, 10.
Firmware: set VREG.HIZ after boot (internal regulator draws ~400 uA until then); never use the regulator's low-power mode.

R28/C39: 33 R + 4.7 uF filter on VREG_AVDD (design guide R3/C9).

J1: USB 2.0. VBUS -> power sheet. SBU unconnected.
R24/R25 5.1 k Rd. R26/R27 33 R series (JLC basic; 27 R is not).

4 DI/IO0 5 CLK 6 HOLD/RESET/IO3 7 VCC

Y1: 12 MHz, e.g. ABM8-272-T3 (CL 10 pF). C35/C36 15 pF, R20 1 k in series with XOUT.

U21 boot flash (XIP CS0). U22 PSRAM on the same QSPI bus, DNP (fit APS6404L-3SQR-SN or ESP-PSRAM64H; SD-image cache only),
CS1 = GPIO47 (QMI CS1n). C37/C38 at U21/U22.

Sheet: /RP2350B Core/
File: mcu.kicad_sch
Title: TS-Pico v3: RP2350B Core

USB-C: data, and VBUS to the power sheet (diode-ORed with the edge +5V) so the card runs from USB alone on the bench.

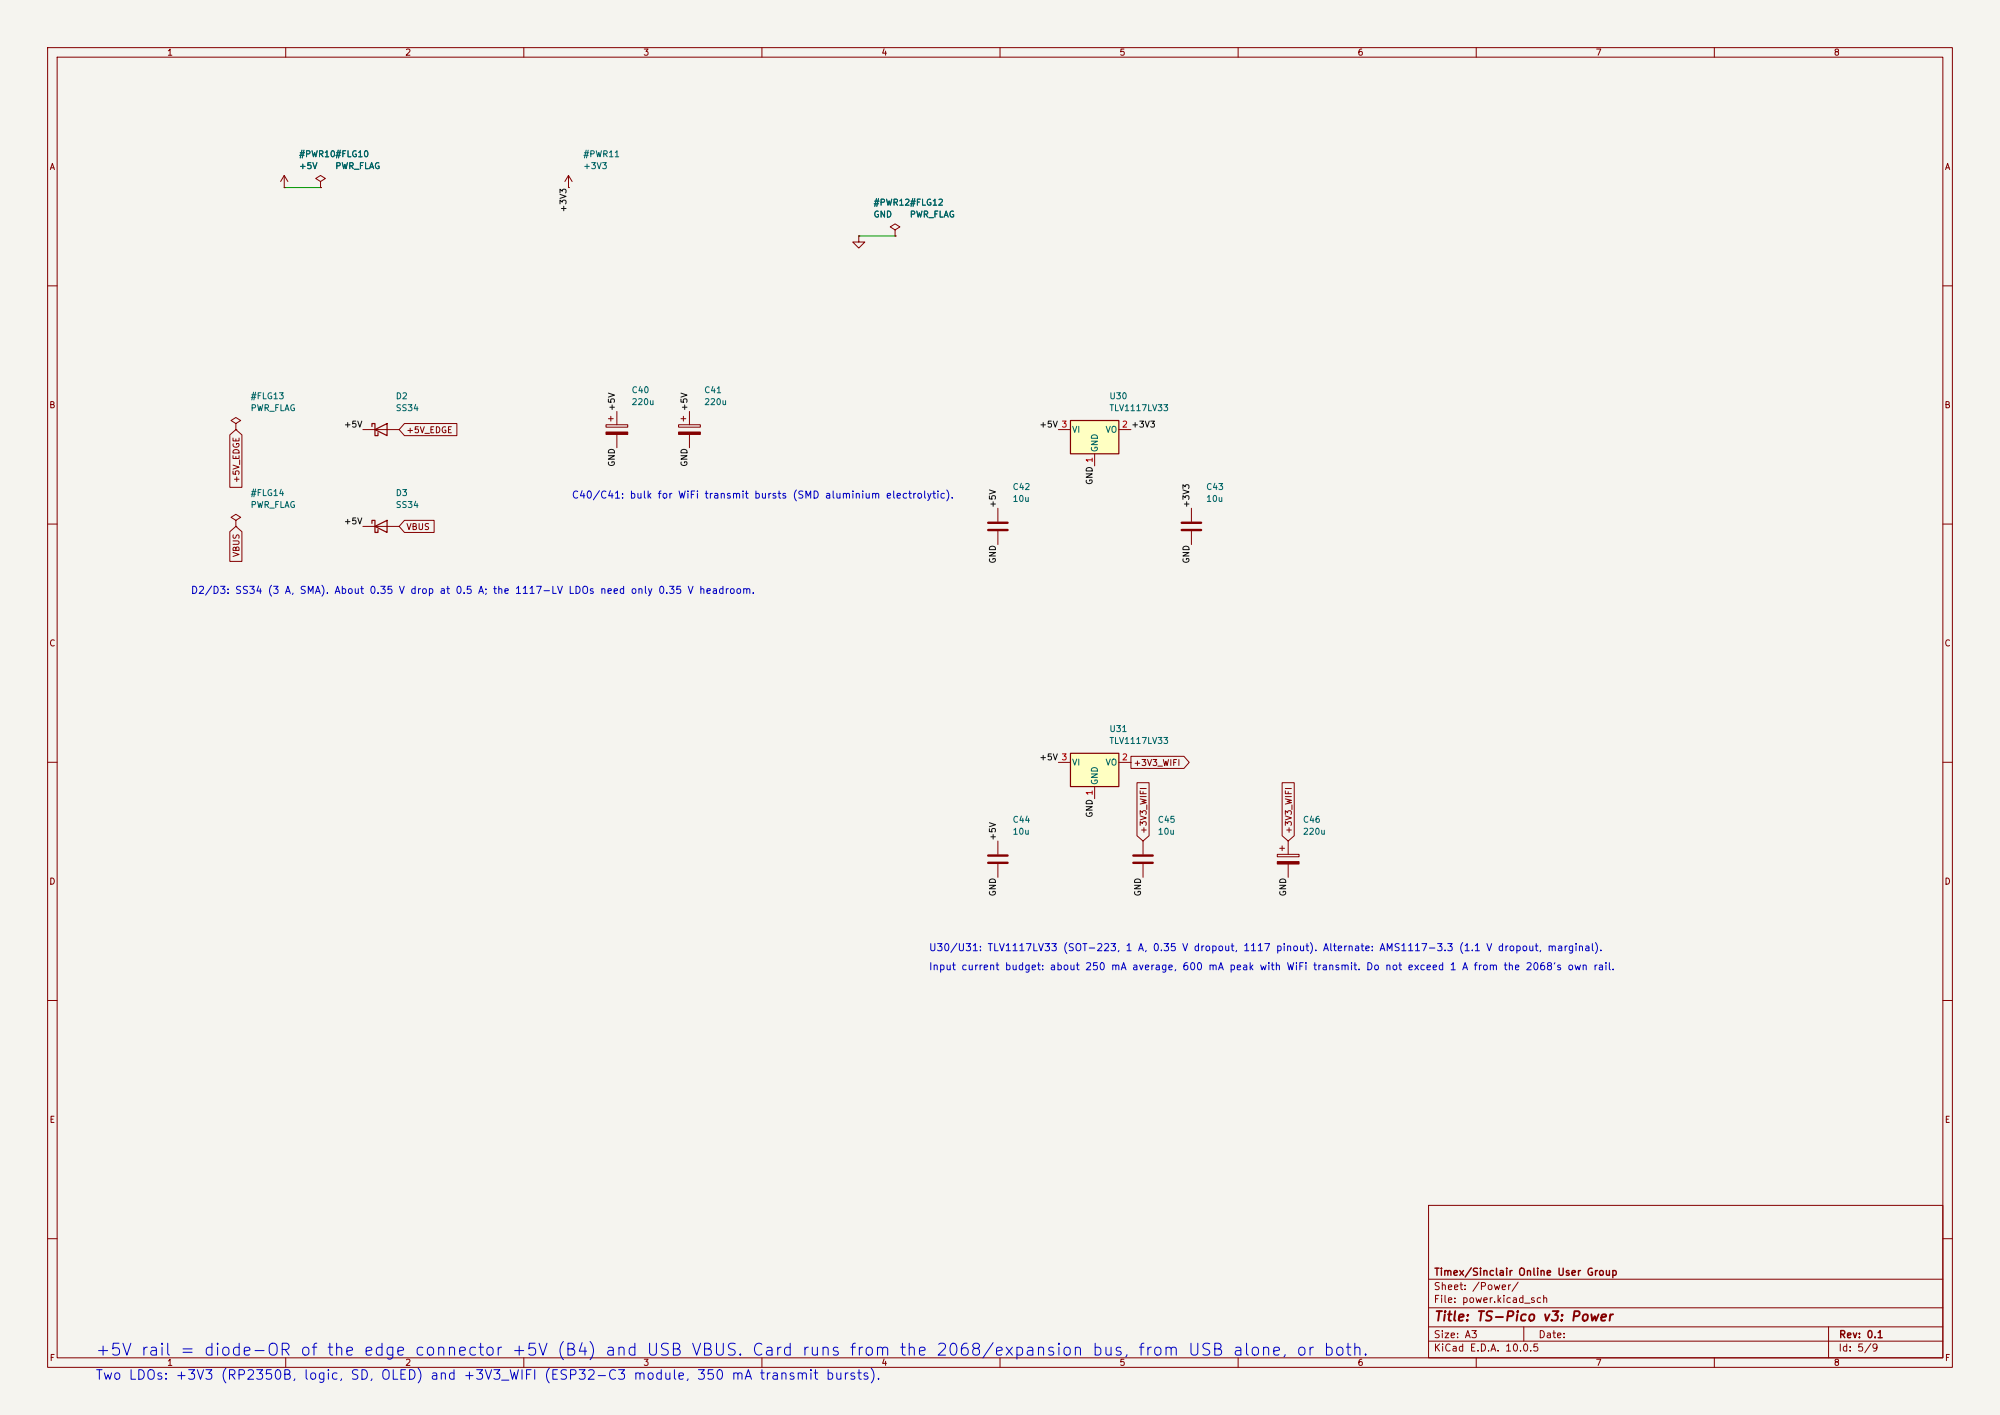
[picture p18: page 5]

C40/C41: bulk for WiFi transmit bursts (SMD aluminium electrolytic).

D2/D3: SS34 (3 A, SMA). About 0.35 V drop at 0.5 A; the 1117-LV LDOs need only 0.35 V headroom.

U30/U31: TLV1117LV33 (SOT-223, 1 A, 0.35 V dropout, 1117 pinout). Alternate: AMS1117-3.3 (1.1 V dropout, marginal).
Input current budget: about 250 mA average, 600 mA peak with WiFi transmit. Do not exceed 1 A from the 2068's own rail.

Timex/Sinclair Online User Group
Sheet: /Power/
File: power.kicad_sch
Title: TS-Pico v3: Power

+5V rail = diode-OR of the edge connector +5V (B4) and USB VBUS. Card runs from the 2068/expansion bus, from USB alone, or both.
Two LDOs: +3V3 (RP2350B, logic, SD, OLED) and +3V3_WIFI (ESP32-C3 module, 350 mA transmit bursts).

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
# Title: TS-Pico v3: SD and Display

## File: storage_display.kicad_sch

## Sheet: /SD and Display/

## Timex/Sinclair Online User Group

R34
10k R42
15k | R38
10k R43

10k OUT 1 GND

2

SET | 3 ON 4
IN 5 | U32
SY6280AAC

1
2
3
4

J3OLED 1.54in 128x64 I2C

R39

0 R33

33 R32
33 C50

10u C51

100n

#PWR14 GND

#PWR13 +3V3 R31

33 R30
33

C52

1u | R45

4k7 R44

4k7 R35

10k | R36
10k DAT2 1 | DAT3/CD 2 | CMD 3
VDD 4 | CLK 5
VSS 6 | DAT0 7 | DAT1 8 | DET_B 9 | DET_A 10
SHIELD | SH

J2microSD

R37

10k SD_CS | SD_MOSI +3V3_SD | SD_CD SD_PWR_EN SD_PWR_EN | +3V3_SD | OLED_SDA OLED_SCL +3V3_SD | SD_MISO | OLED_SDA +3V3_SD | OLED_SCL +3V3_SD | +3V3_SD
+3V3_SD | SD_SCK +3V3_SD SD_CS_J | +3V3 SD_MOSI_J
SD_MOSI_J SD_CS_J | GND | GND+3V3
SD_DAT2 GND | SD_SCK_J | SD_MISO_J | +3V3
SD_MISO_J | +3V3
SD_DAT1 GND | GND
+3V3
SD_CD_SW | SD_DAT1 GND GND | GND | GND GND | SD_CD_SW +3V3 | +3V3 | SD_DAT2

SD_ISET

GND SD_ISET | SD_CS_J | SD_MISO_J | SD_CD_SW
SD_SCK_J | Card present = SD_CD low (the TF-01A switch closes to GND; confirmed on proto1). U32: SD VDD switch, R42 sets 0.45 A, R43 holds it off.

Firmware order: card detected, settle, SD_PWR_EN on, then SPI. SPI lines released (inputs) before SD_PWR_EN goes off.

R30-R33 33 R series; R34-R37 10 k pull-ups (CS, MISO, DAT1, DAT2) on +3V3_SD; R38 pull-up on the detect switch (+3V3), R39 0 R link to SD_CD.

OLED: 4-pin header for a 1.54in 128x64 SSD1309 I2C module on I2C1 (GP42 SDA, GP43 SCL), its own bus so display updates never delay joystick reads.

Micro SD in SPI mode on the RP2350B SPI0 (GP36-GP39); card detect (switch to GND) into STAT bit 7.

J3 pin order matches the module: GND VCC SCL SDA. VCC is +3V3, so the module's own pull-ups stay at 3.3 V.

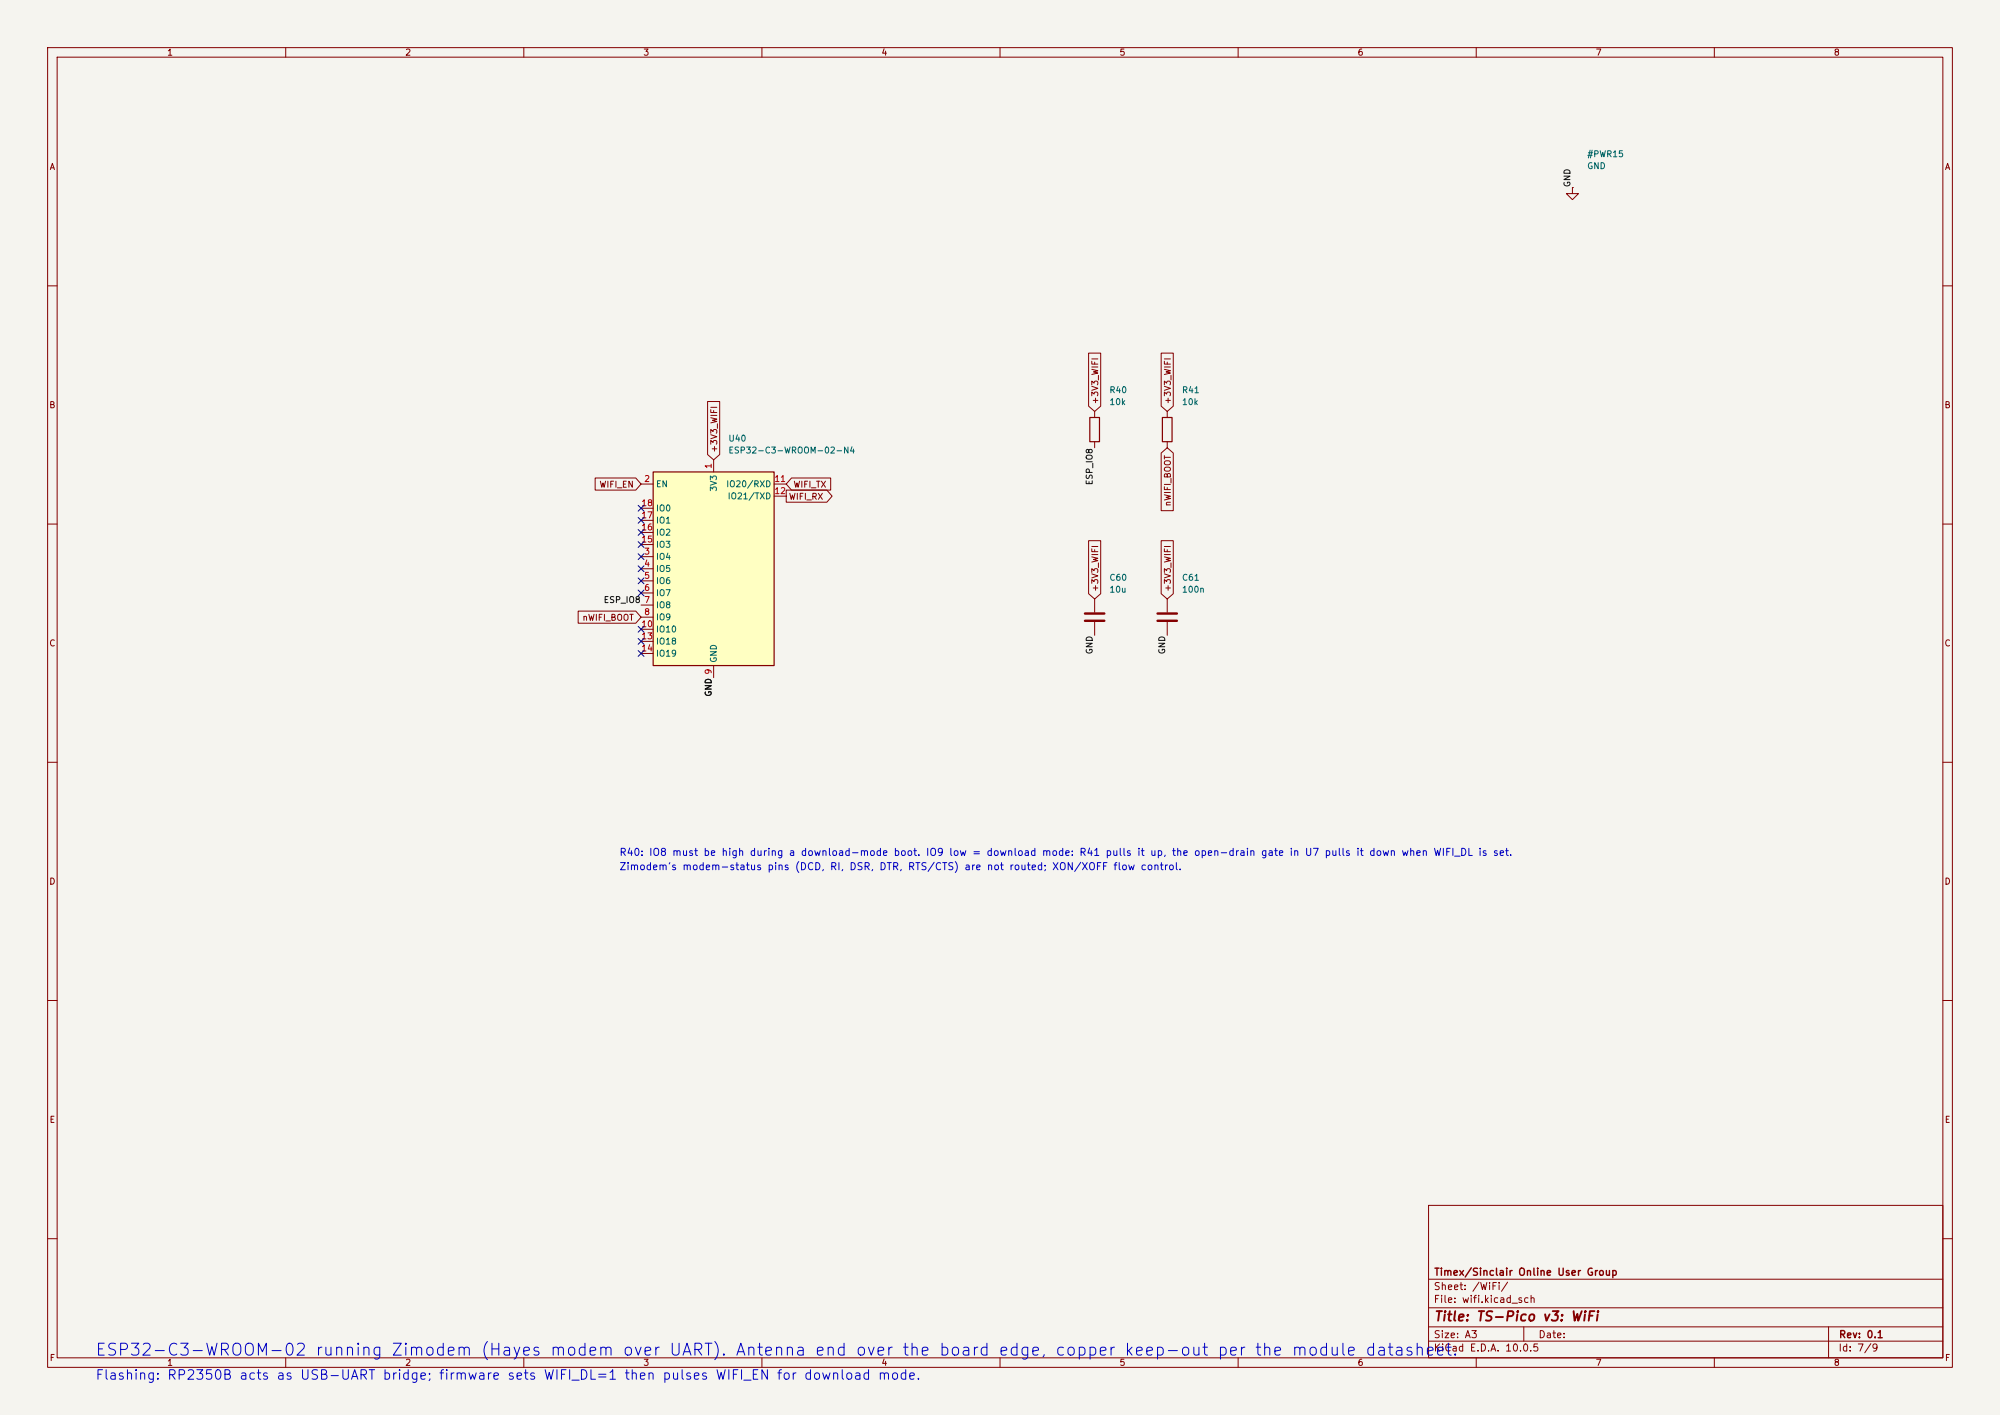
[picture p19: page 7]

ESP_IO8 Zimodem's modem-status pins (DCD, RI, DSR, DTR, RTS/CTS) are not routed; XON/XOFF flow control.

R40: IO8 must be high during a download-mode boot. IO9 low = download mode: R41 pulls it up, the open-drain gate in U7 pulls it down when WIFI_DL is set.

Sheet: /WiFi/
File: wifi.kicad_sch
Title: TS-Pico v3: WiFi

ESP32-C3-WROOM-02 running Zimodem (Hayes modem over UART). Antenna end over the board edge, copper keep-out per the module datasheet.

Flashing: RP2350B acts as USB-UART bridge; firmware sets WIFI_DL=1 then pulses WIFI_EN for download mode.

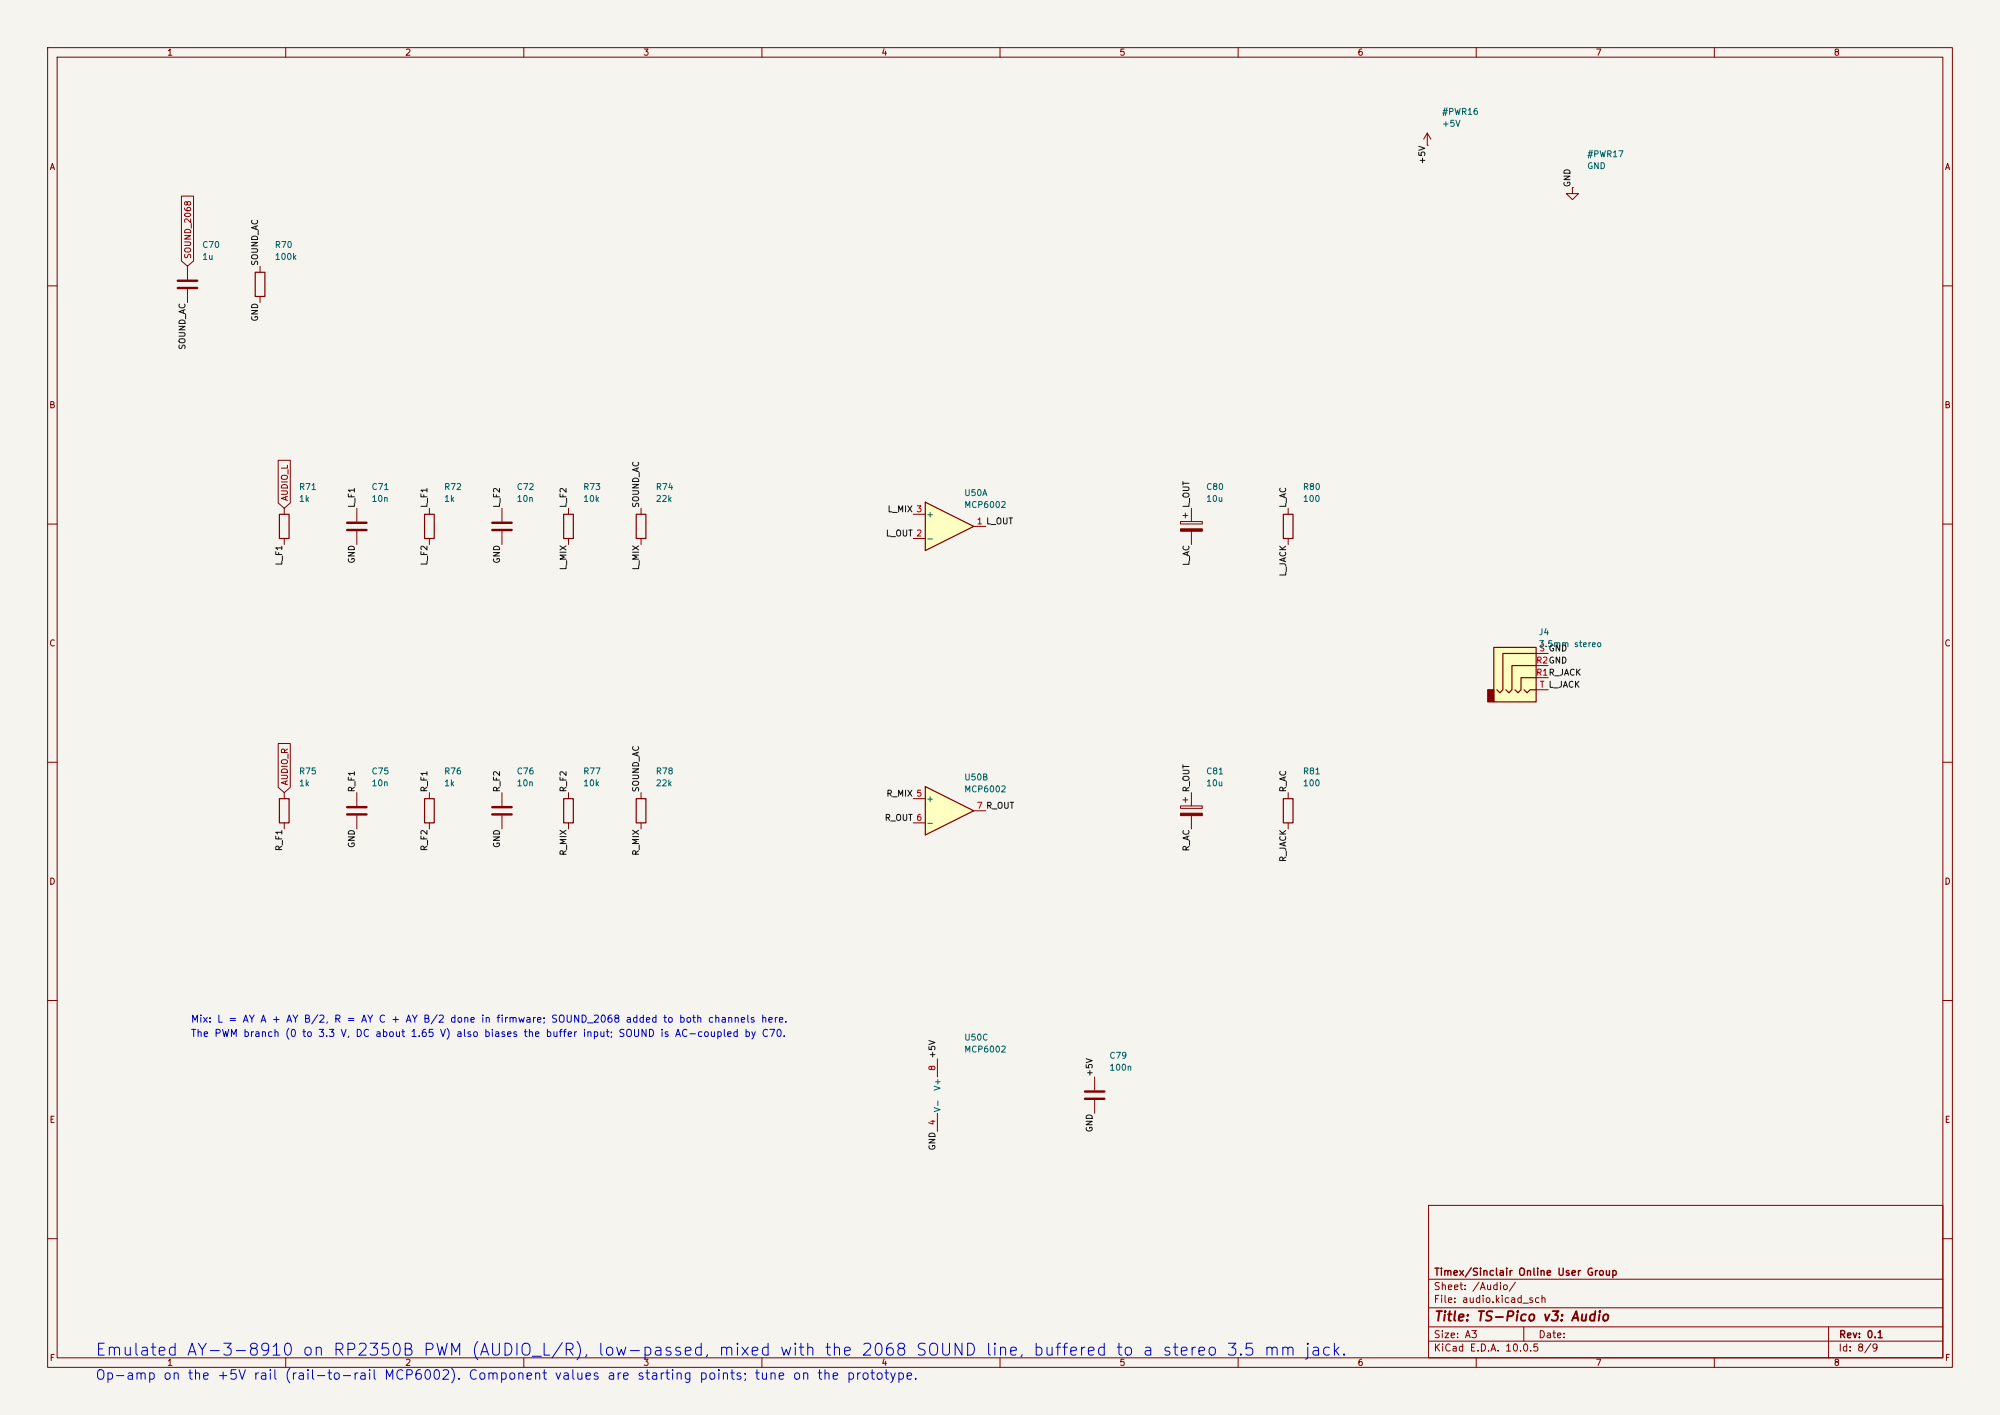
[picture p20: page 8]

Mix: L = AY A + AY B/2, R = AY C + AY B/2 done in firmware; SOUND_2068 added to both channels here.
The PWM branch (0 to 3.3 V, DC about 1.65 V) also biases the buffer input; SOUND is AC-coupled by C70.

Timex/Sinclair Online User Group
Sheet: /Audio/
File: audio.kicad_sch
Title: TS-Pico v3: Audio

Emulated AY-3-8910 on RP2350B PWM (AUDIO_L/R), low-passed, mixed with the 2068 SOUND line, buffered to a stereo 3.5 mm jack.
Op-amp on the +5V rail (rail-to-rail MCP6002). Component values are starting points; tune on the prototype.

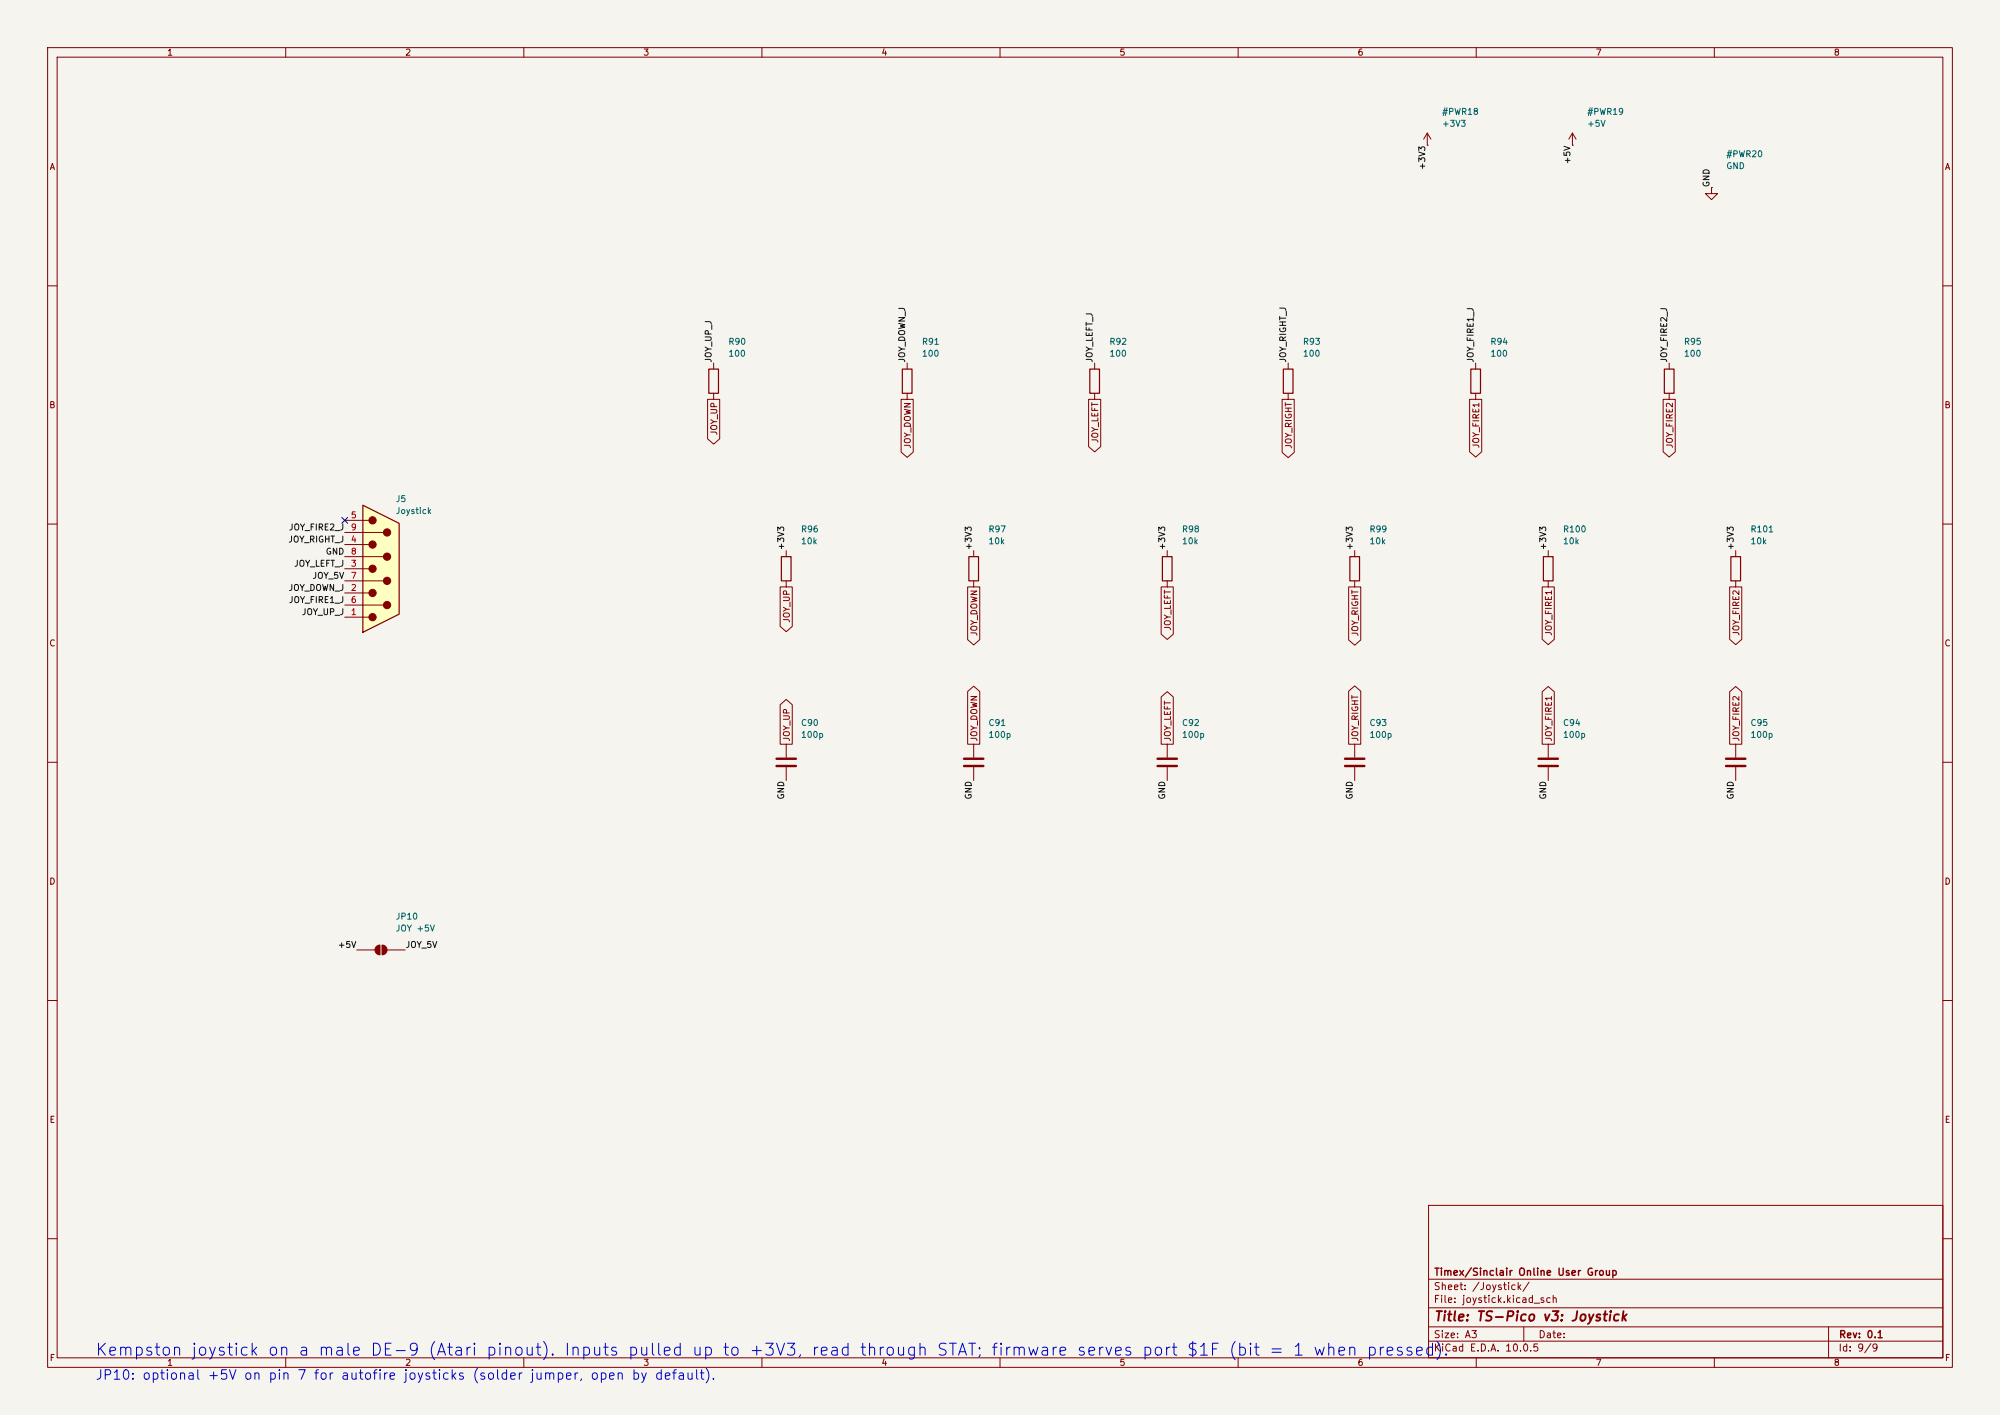
[picture p21: page 9]

Timex/Sinclair Online User Group
Sheet: /Joystick/
File: joystick.kicad_sch
Title: TS-Pico v3: Joystick

Kempston joystick on a male DE-9 (Atari pinout). Inputs pulled up to +3V3, read through STAT; firmware serves port $1F (bit = 1 when pressed).
JP10: optional +5V on pin 7 for autofire joysticks (solder jumper, open by default).
