factus10/tspico-hardware/old/tsPico2_2Fab/tsPico.PDF

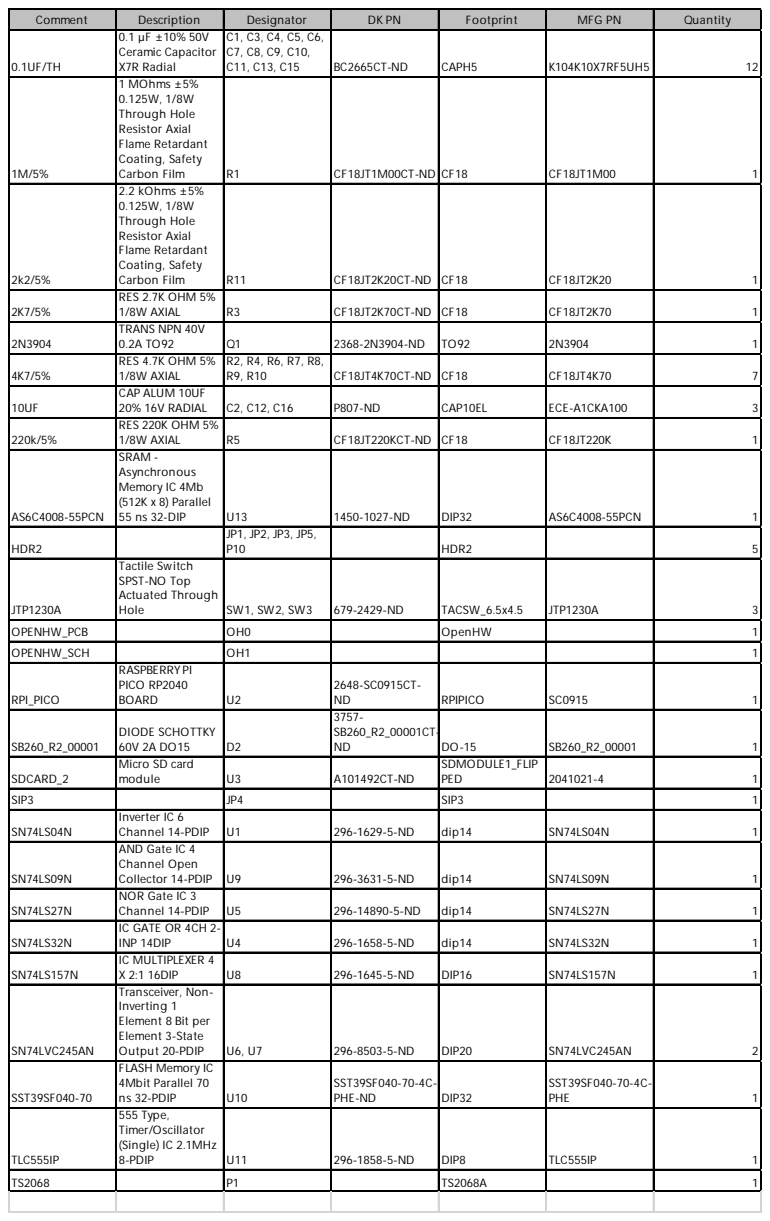
[picture p22: page 1]

Comment | Description | Designator | DK PN | Footprint | MFG PN | Quantity
0.1UF/TH | 0.1 µF ±10% 50V Ceramic Capacitor X7R Radial | C1, C3, C4, C5, C6, C7, C8, C9, C10, C11, C13, C15 | BC2665CT-ND | CAPH5 | K104K10X7RF5UH5 | 12

1M/5% | 1 MOhms ±5% 0.125W, 1/8W Through Hole Resistor Axial Flame Retardant Coating, Safety Carbon Film | R1 | CF18JT1M00CT-ND | CF18 | CF18JT1M00 | 1

2k2/5% | 2.2 kOhms ±5% 0.125W, 1/8W Through Hole Resistor Axial Flame Retardant Coating, Safety Carbon Film | R11 | CF18JT2K20CT-ND | CF18 | CF18JT2K20 | 1

2K7/5% | RES 2.7K OHM 5% 1/8W AXIAL | R3 | CF18JT2K70CT-ND | CF18 | CF18JT2K70 | 1

2N3904 | TRANS NPN 40V 0.2A TO92 | Q1 | 2368-2N3904-ND | TO92 | 2N3904 | 1

4K7/5% | RES 4.7K OHM 5% 1/8W AXIAL | R2, R4, R6, R7, R8, R9, R10 | CF18JT4K70CT-ND | CF18 | CF18JT4K70 | 7

10UF | CAP ALUM 10UF 20% 16V RADIAL | C2, C12, C16 | P807-ND | CAP10EL | ECE-A1CKA100 | 3

220k/5% | RES 220K OHM 5% 1/8W AXIAL | R5 | CF18JT220KCT-ND | CF18 | CF18JT220K | 1

AS6C4008-55PCN | SRAM -Asynchronous Memory IC 4Mb (512K x 8) Parallel 55 ns 32-DIP | U13 | 1450-1027-ND | DIP32 | AS6C4008-55PCN | 1

HDR2 | | JP1, JP2, JP3, JP5, P10 | | HDR2 | | 5

JTP1230A | Tactile Switch SPST-NO Top Actuated Through Hole | SW1, SW2, SW3 | 679-2429-ND | TACSW_6.5x4.5 | JTP1230A | 3

OPENHW_PCB | | OH0 | | OpenHW | | 1

OPENHW_SCH | | OH1 | | | | 1
RPI_PICO | RASPBERRY PI PICO RP2040 BOARD | U2 | 2648-SC0915CT-ND | RPIPICO | SC0915 | 1

SB260_R2_00001 | DIODE SCHOTTKY 60V 2A DO15 | D2 | 3757-SB260_R2_00001CT-ND | DO-15 | SB260_R2_00001 | 1

SDCARD_2 | Micro SD card module | U3 | A101492CT-ND | SDMODULE1_FLIP PED | 2041021-4 | 1

SIP3 | | JP4 | | SIP3 | | 1
SN74LS04N | Inverter IC 6 Channel 14-PDIP | U1 | 296-1629-5-ND | dip14 | SN74LS04N | 1

SN74LS09N | AND Gate IC 4 Channel Open Collector 14-PDIP | U9 | 296-3631-5-ND | dip14 | SN74LS09N | 1

SN74LS27N | NOR Gate IC 3 Channel 14-PDIP | U5 | 296-14890-5-ND | dip14 | SN74LS27N | 1

SN74LS32N | IC GATE OR 4CH 2-INP 14DIP | U4 | 296-1658-5-ND | dip14 | SN74LS32N | 1

SN74LS157N | IC MULTIPLEXER 4 X 2:1 16DIP | U8 | 296-1645-5-ND | DIP16 | SN74LS157N | 1

SN74LVC245AN | Transceiver, Non-Inverting 1 Element 8 Bit per Element 3-State Output 20-PDIP | U6, U7 | 296-8503-5-ND | DIP20 | SN74LVC245AN | 2

SST39SF040-70 | FLASH Memory IC 4Mbit Parallel 70 ns 32-PDIP | U10 | SST39SF040-70-4C-PHE-ND | DIP32 | SST39SF040-70-4C-PHE | 1

TLC555IP | 555 Type, Timer/Oscillator (Single) IC 2.1MHz 8-PDIP | U11 | 296-1858-5-ND | DIP8 | TLC555IP | 1

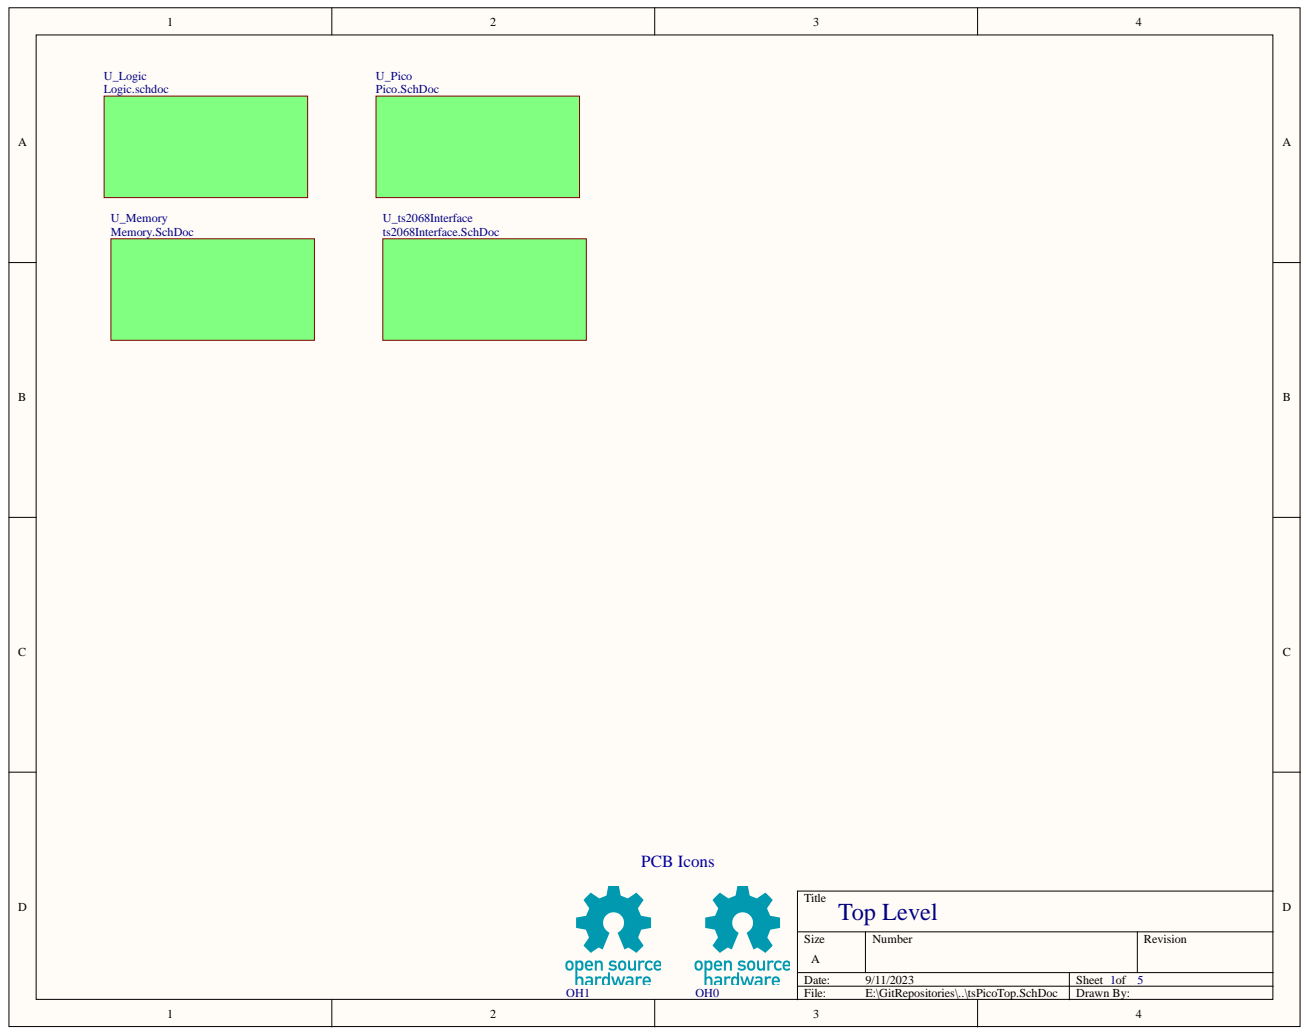
[picture p23: page 2]
Date:; Sheet of; File:; E:\GitRepositories\..\tsPicoTop.SchDoc; Drawn By:; Top Level; PCB Icons

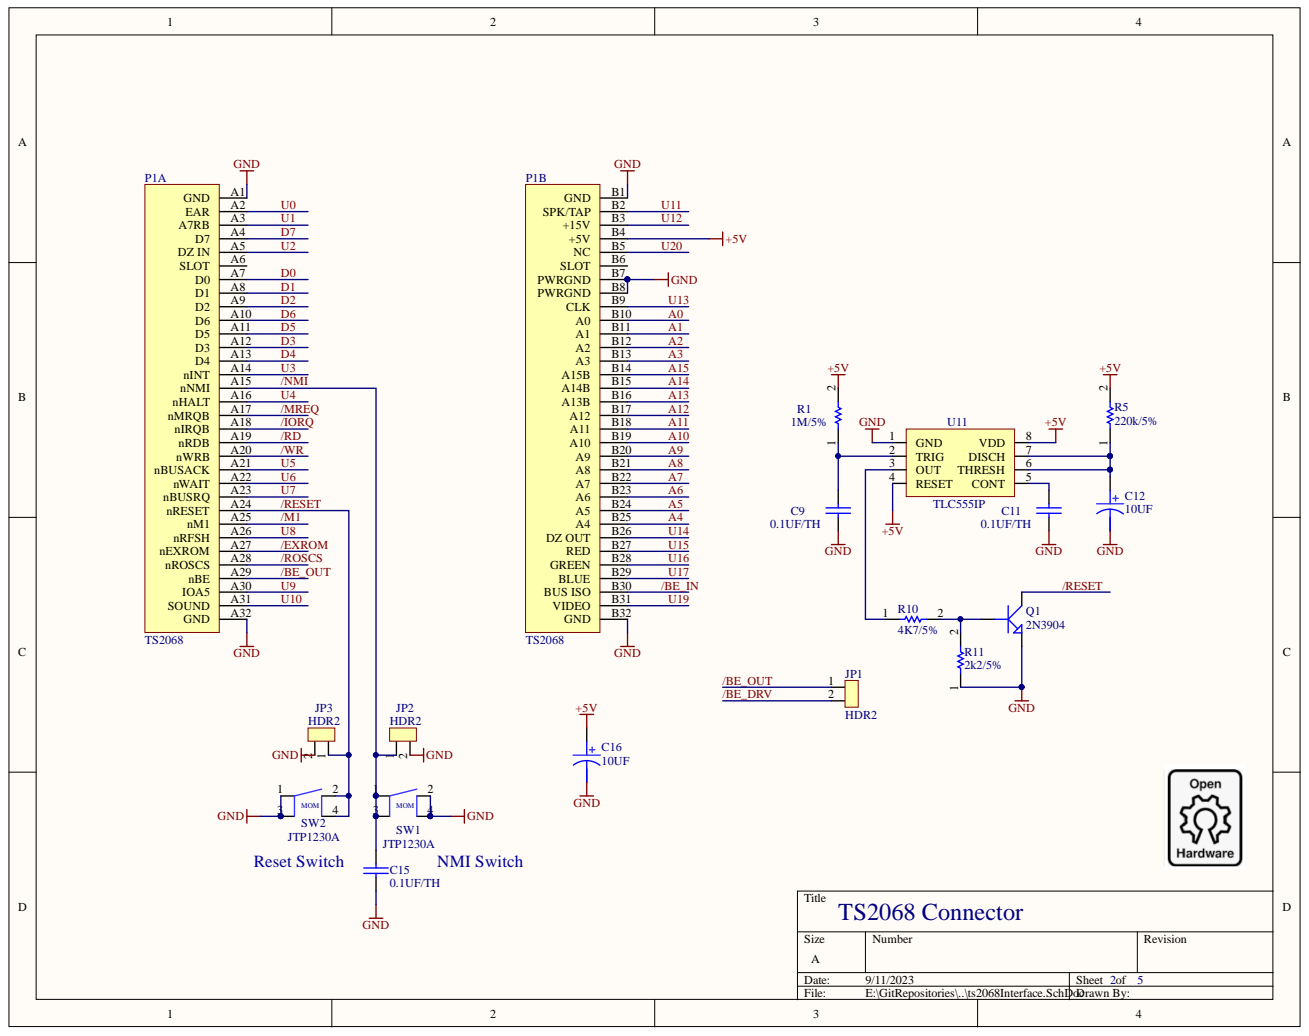
[picture p24: page 3]

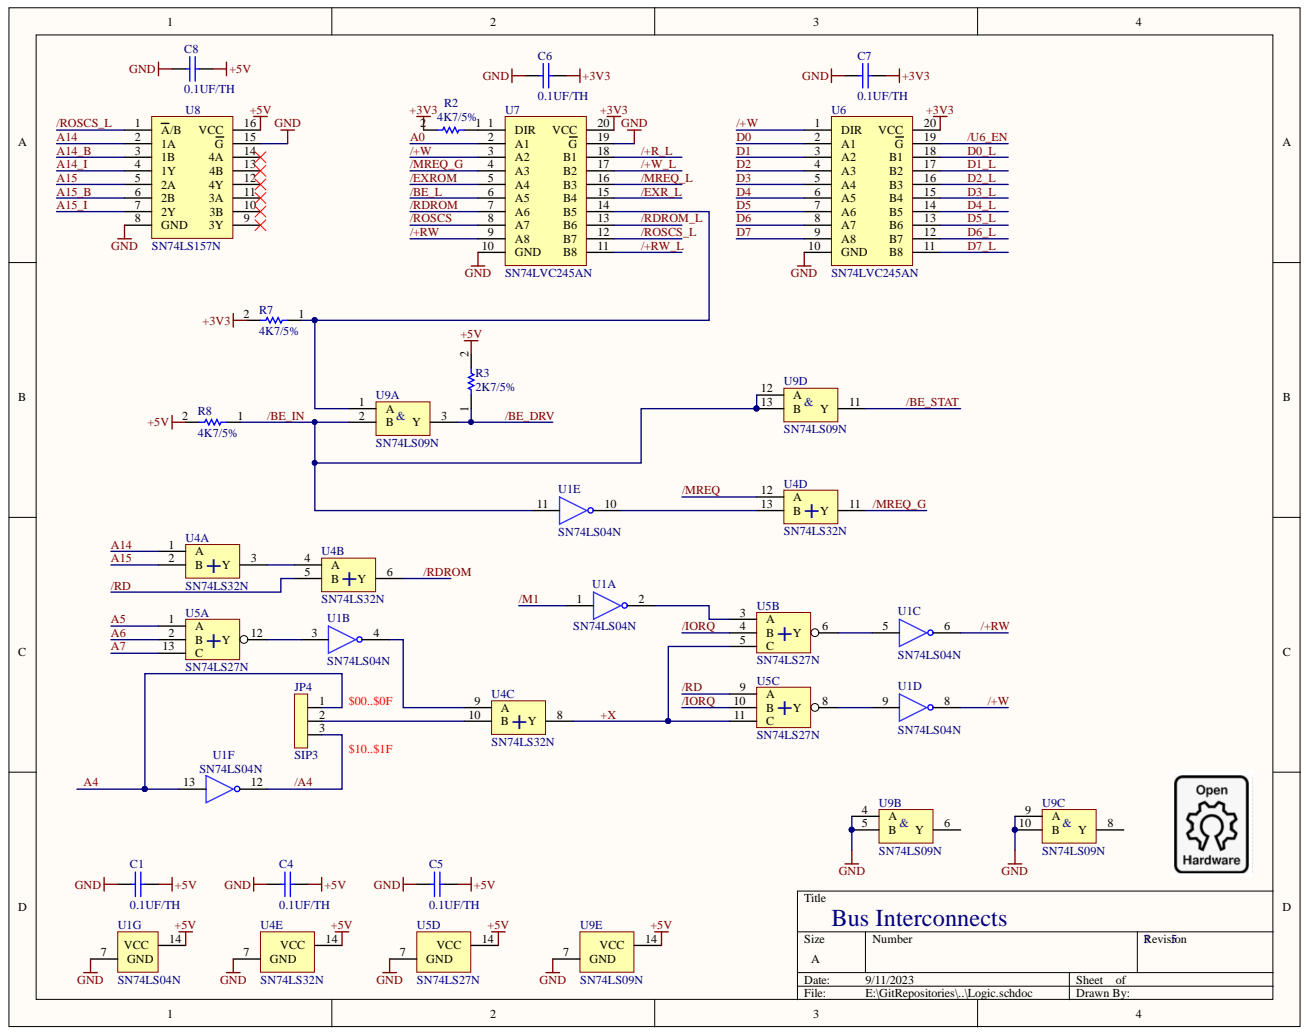
[picture p25: page 4]

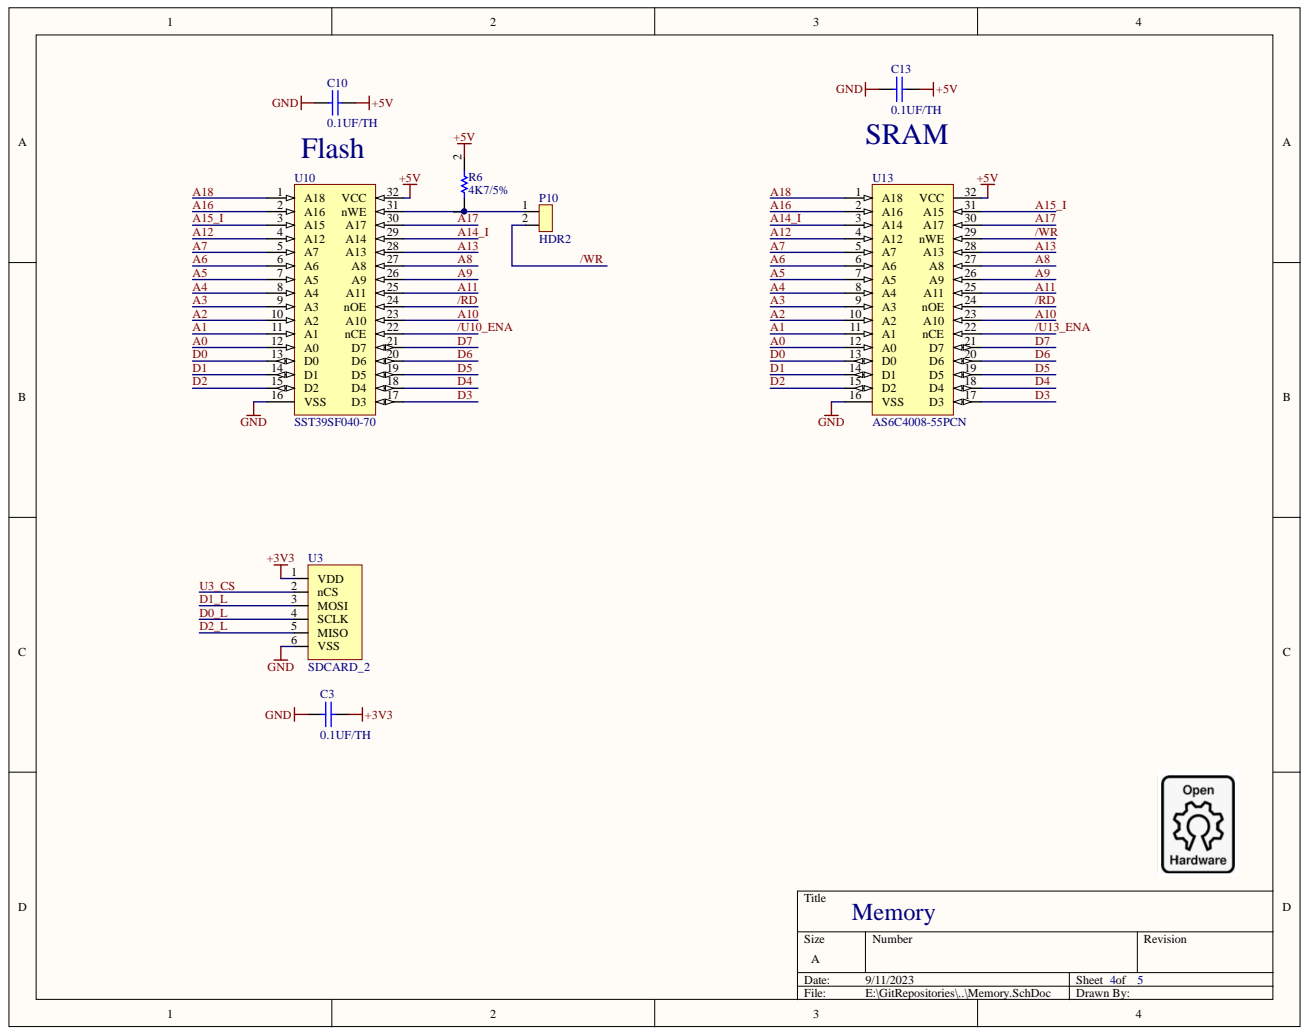
[picture p26: page 5]

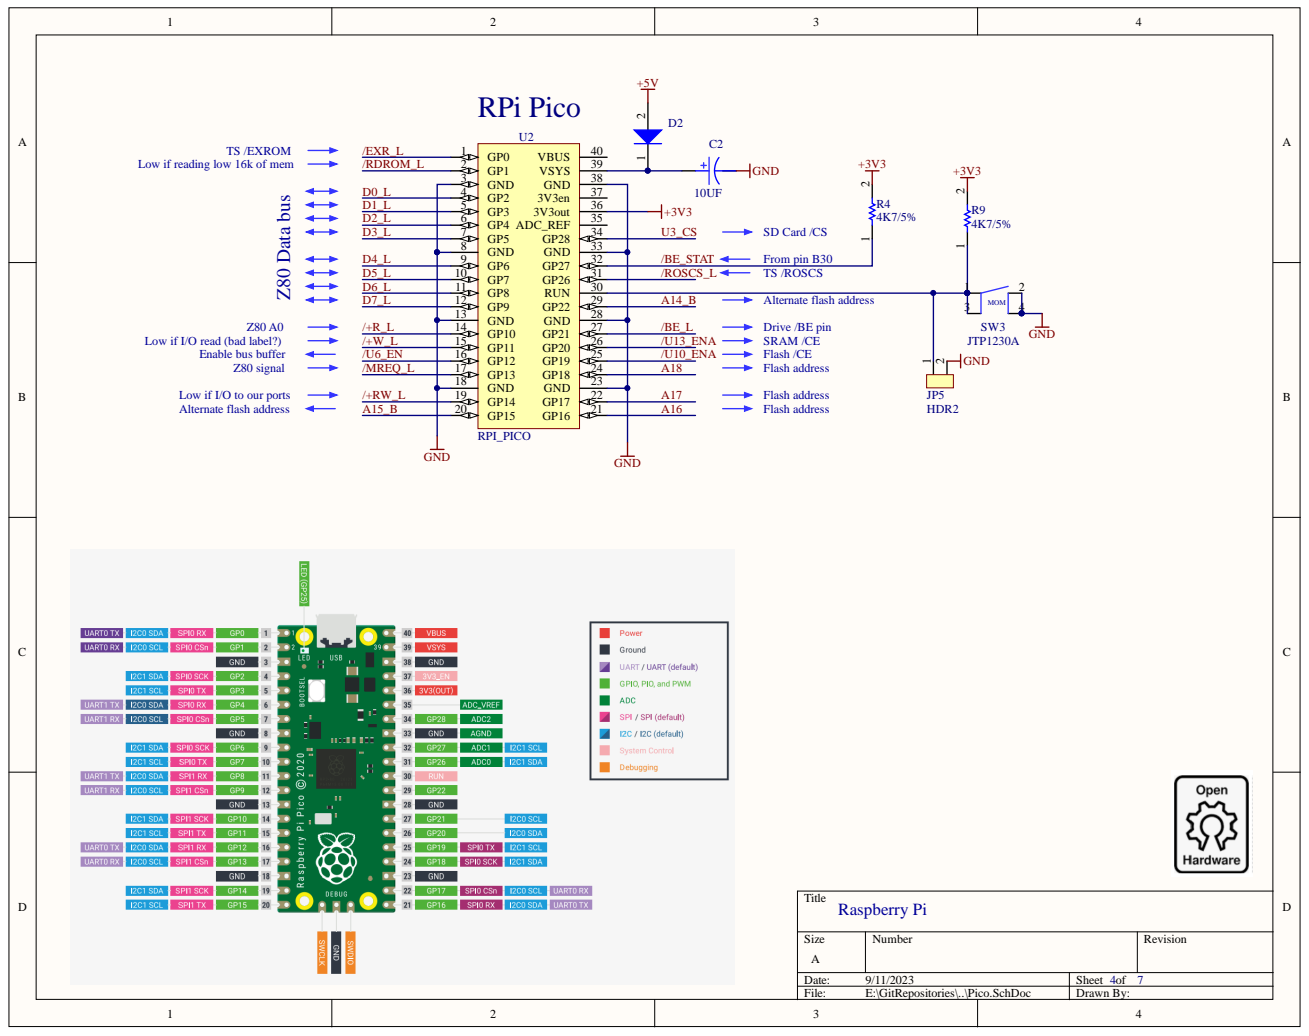
[picture p27: page 6]
GND 13; GND 18; 22 GND; 27 GND; 29 RUN; 32 GND; 35 3V3out; 37 GND; 38 VSYS; 39 VBUS; RPi Pico; D0_L D1_L D2_L D3_L D4_L D5_L D6_L D7_L /+R_L /+W_L /U6_EN /MREQ_L /+RW_L A15_B; /BE_L /ROSCS_L /U10_ENA U3_CS; MZ80 Data bus; D Card; e bus buffe; ad (bad; low 16k of

From pin B30 SRAM /CE Alternate flash

to our port

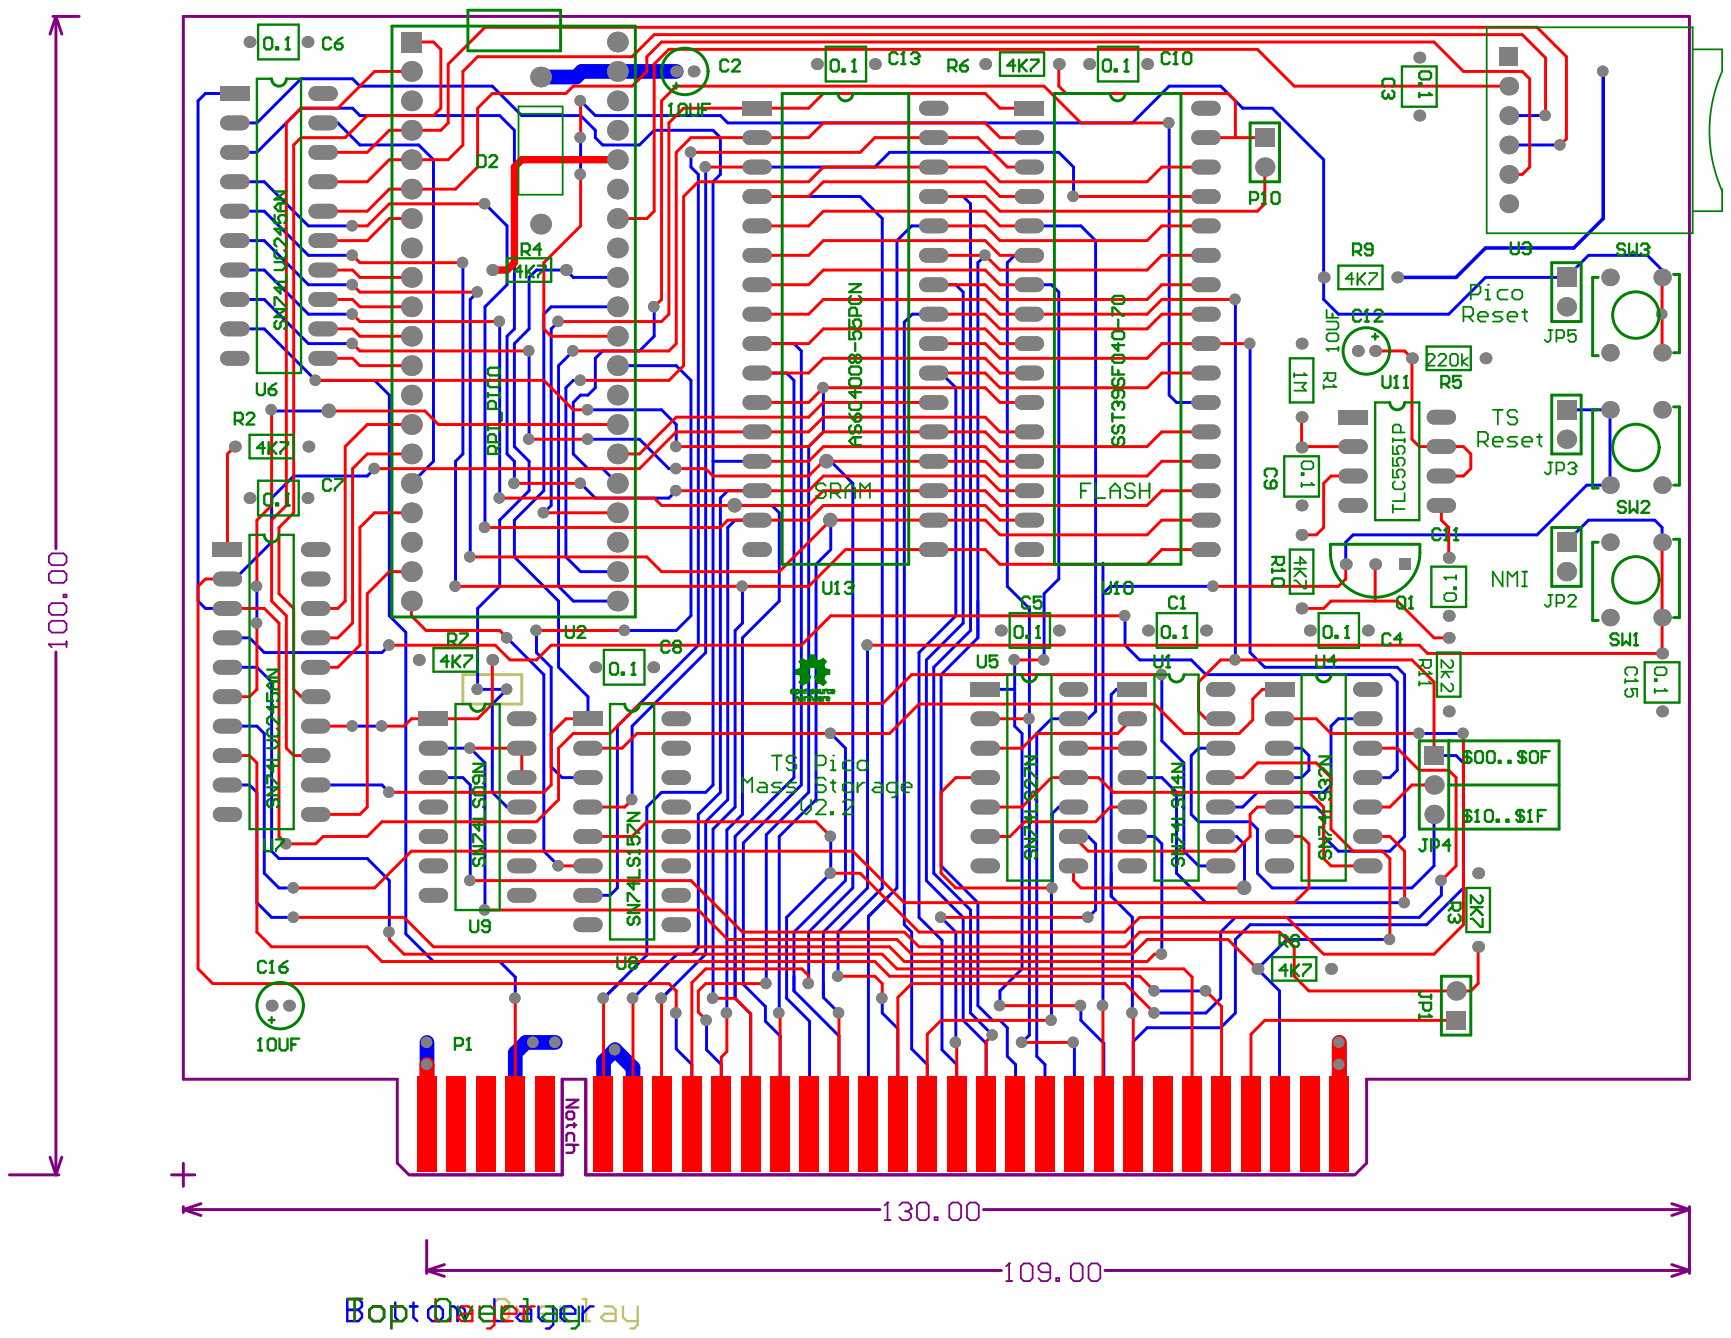
[picture p28: page 7]

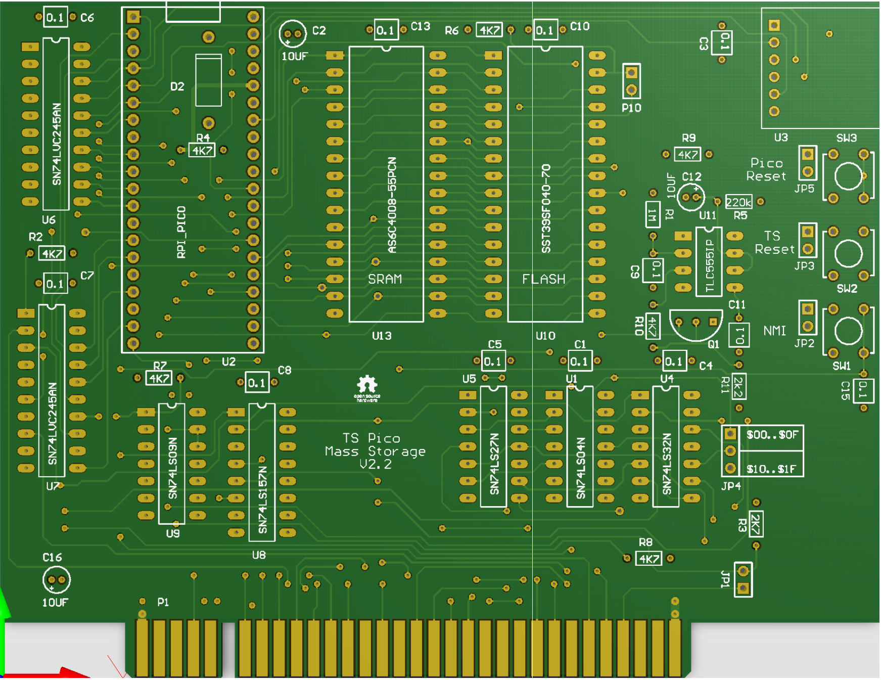
[picture p29: page 8]

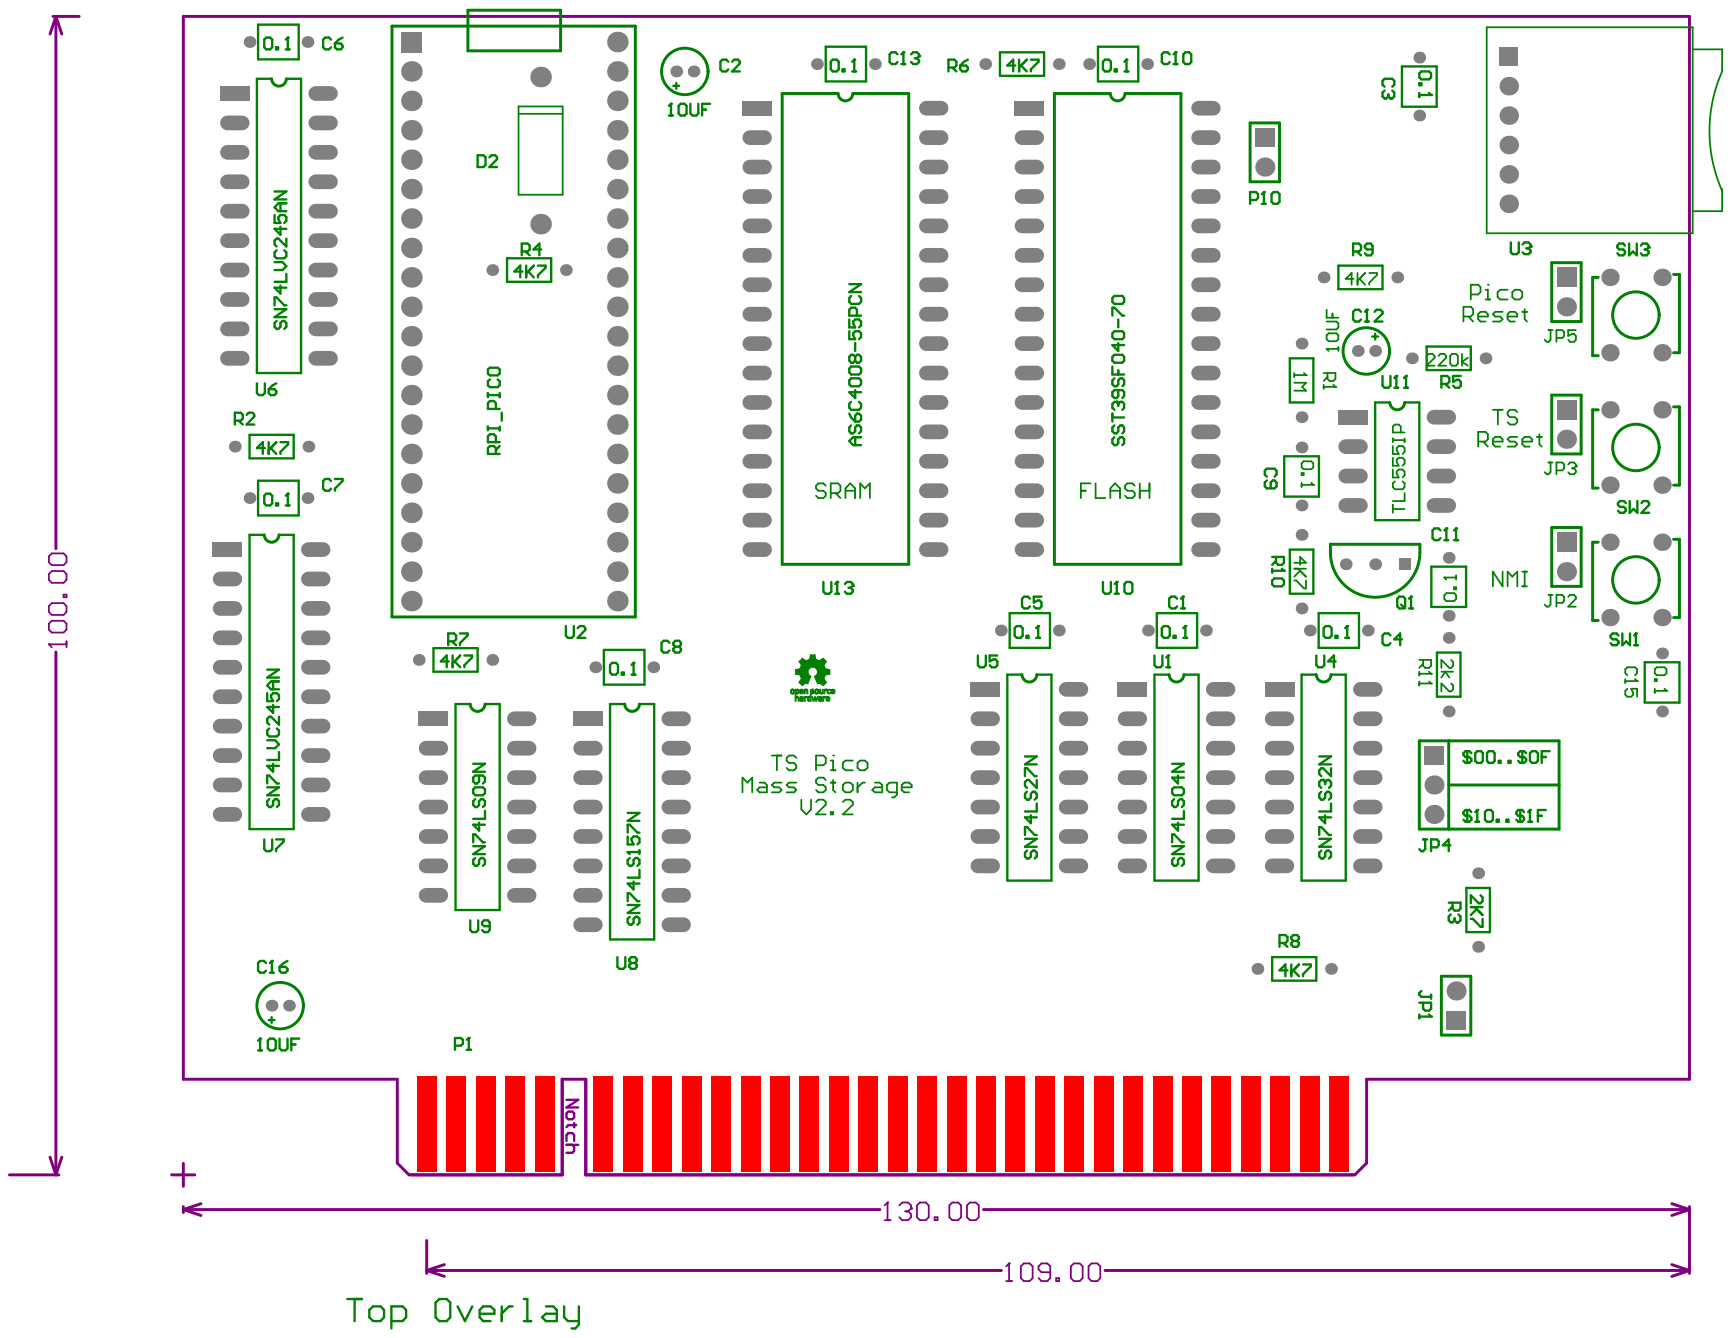
[picture p30: page 9]

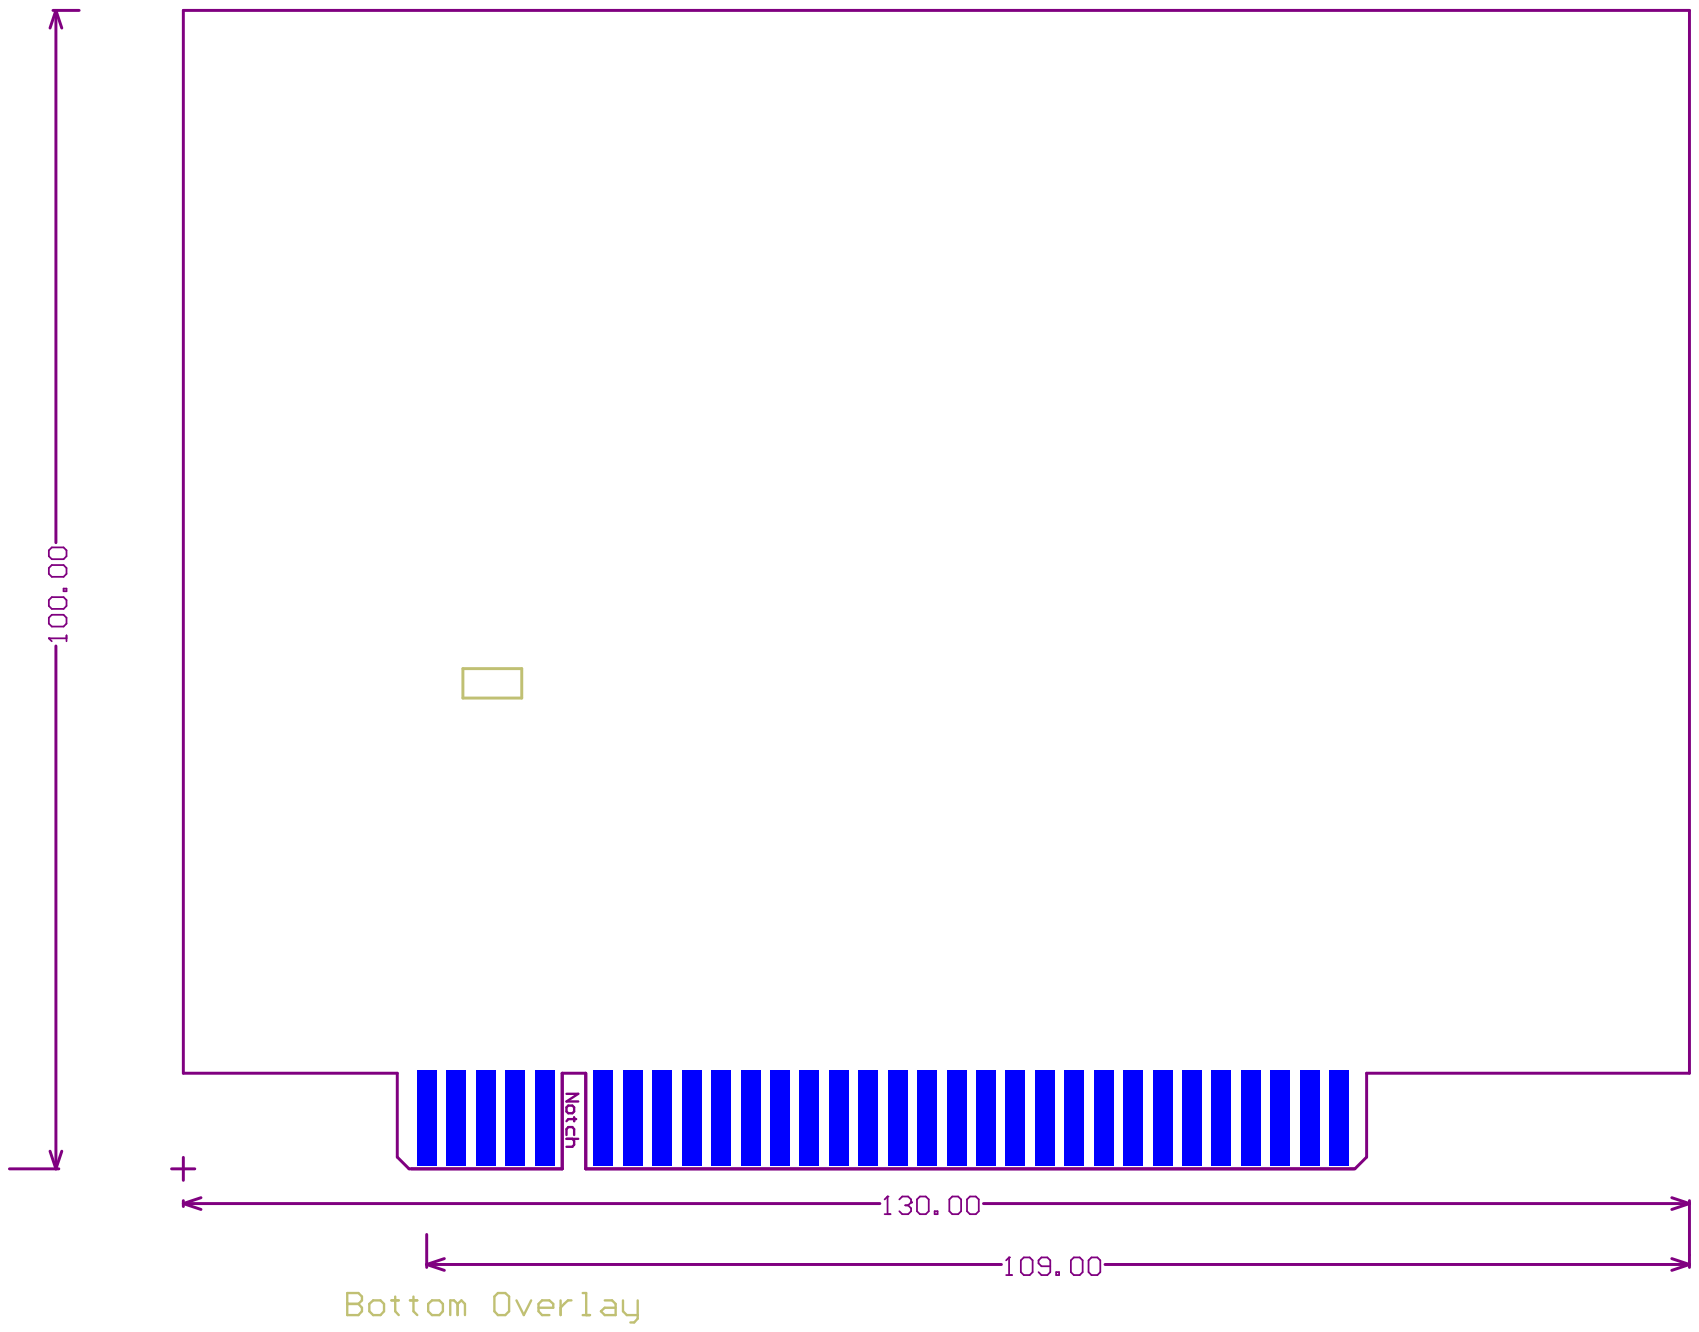
[picture p31: page 10]
