factus10/tspico-hardware/(list of files, drawings)

Other design files:
old/tsPico2_2Altium/Logic.schdoc
old/tsPico2_2Altium/Memory.SchDoc
old/tsPico2_2Altium/Pico.SchDoc
old/tsPico2_2Altium/ts2068Interface.SchDoc
old/tsPico2_2Altium/tsPico.PrjPcb
old/tsPico2_2Altium/tsPicoTop.SchDoc
