factus10/tspico-hardware/hardware/tspico-v3.kicad_pcb

## KiCad design hardware/tspico-v3.kicad_pcb (2026-11-13)

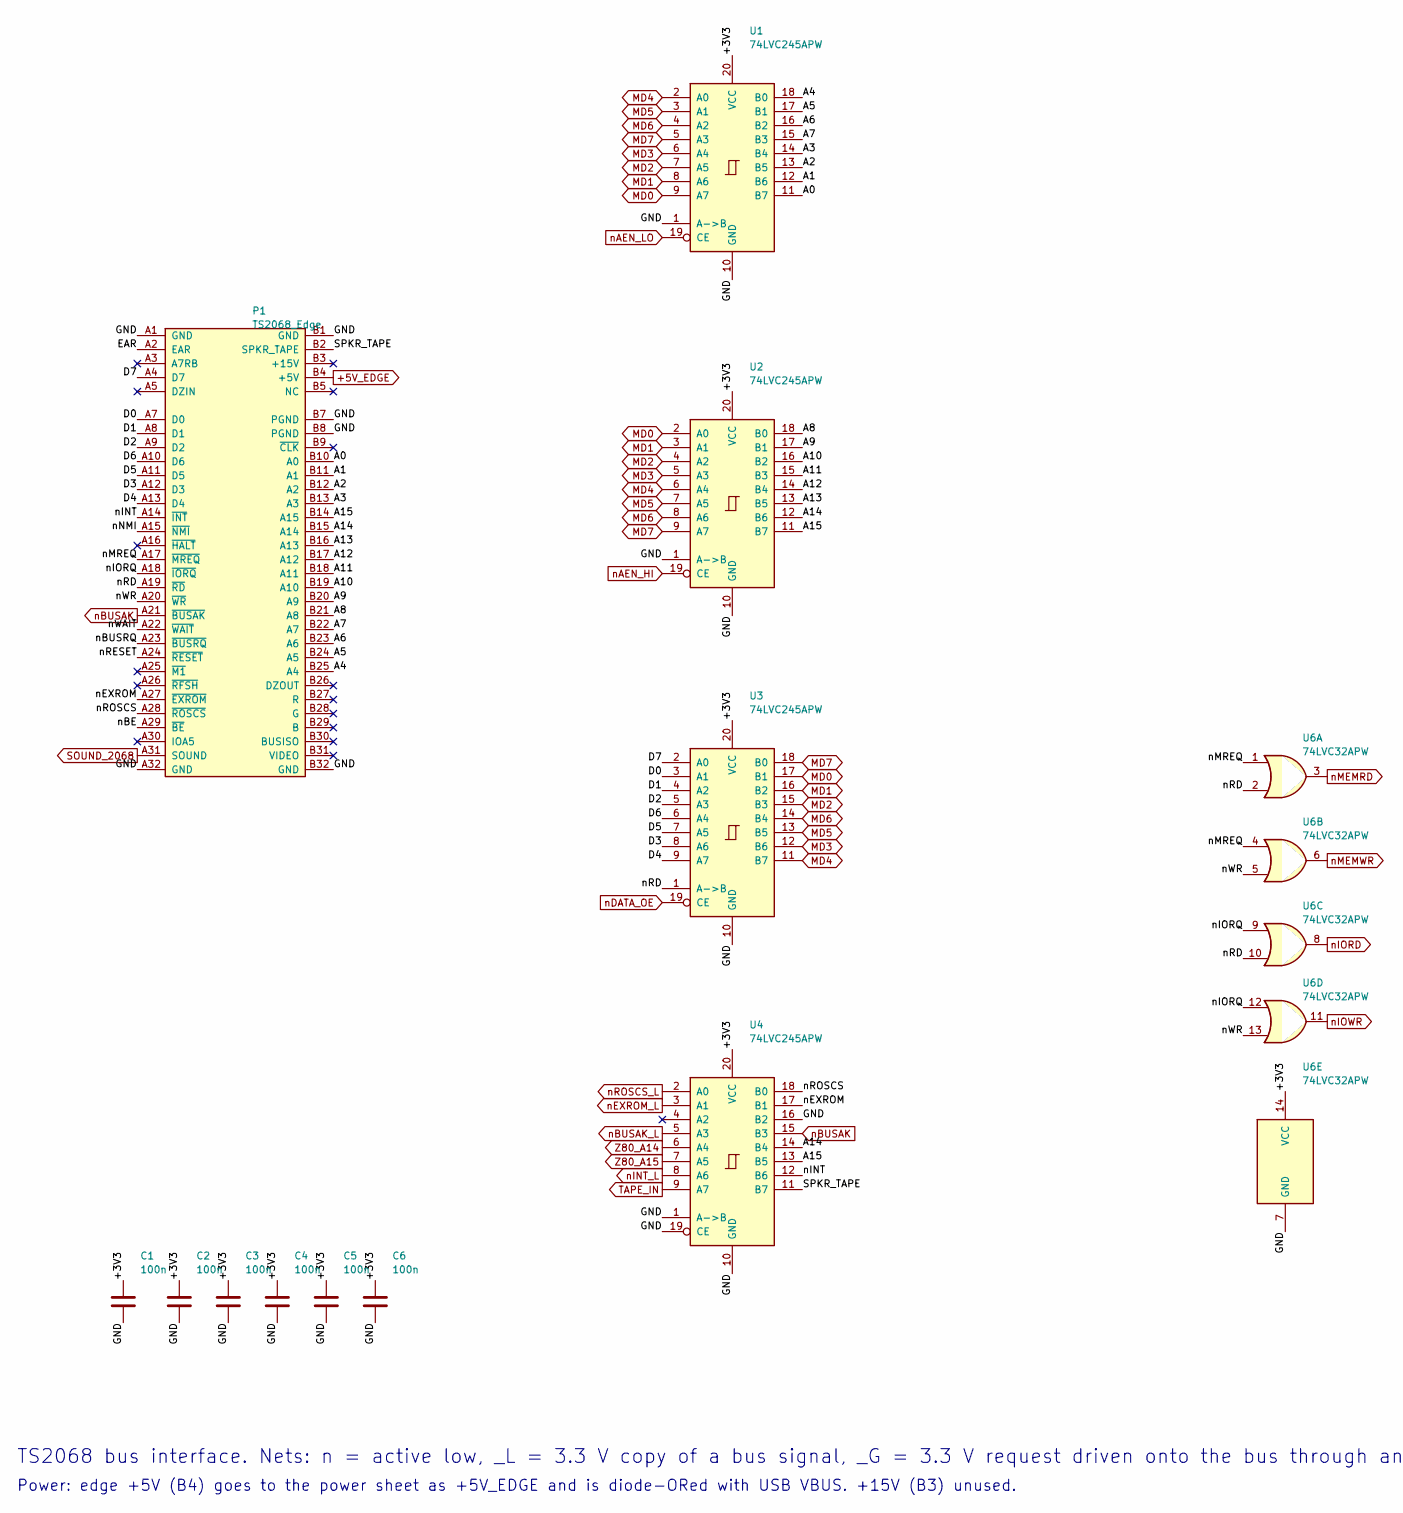
[picture p32: schematic interface.kicad_sch, TS-Pico v3: 2068 Interface, part in row 1, column 1]

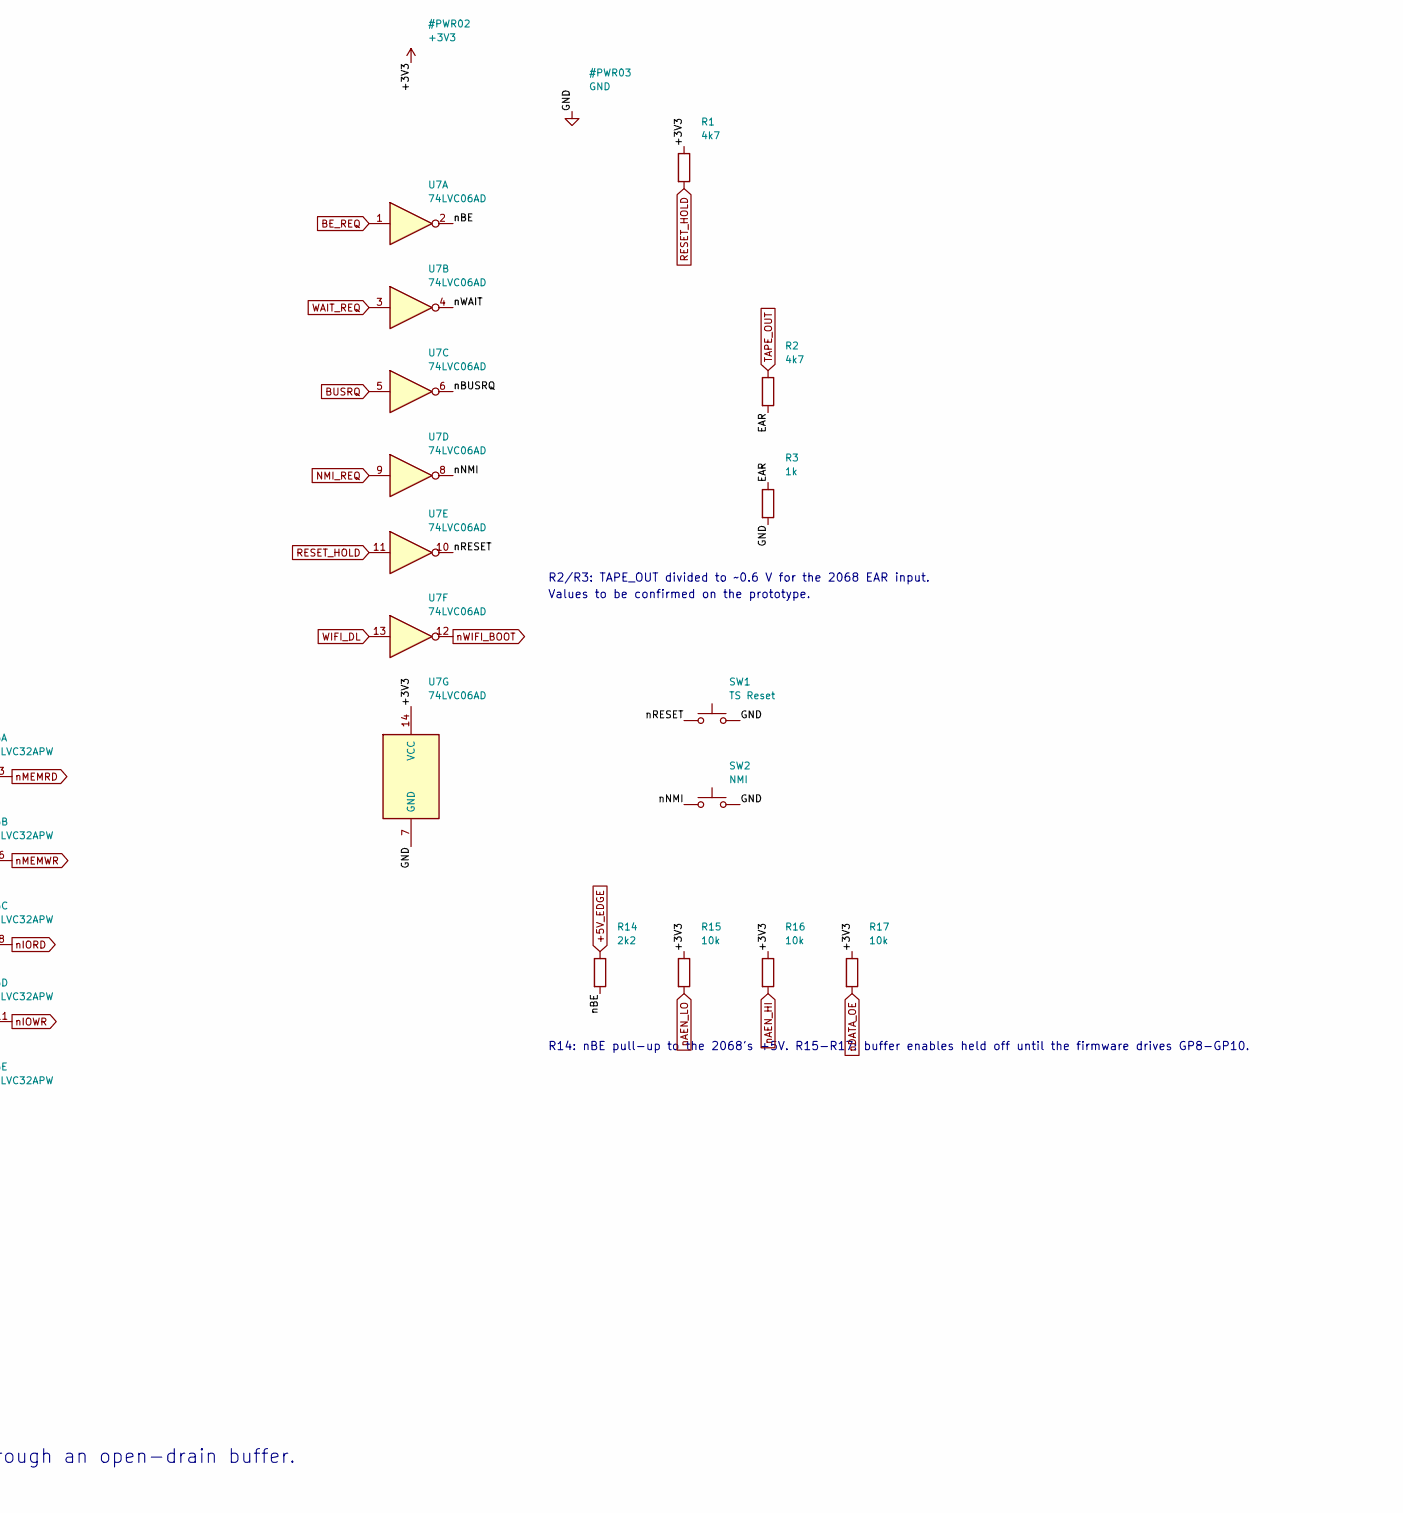
[picture p33: schematic interface.kicad_sch, TS-Pico v3: 2068 Interface, part in row 1, column 2]

Parts:
C1, C2, C3, C4, C5, C6: 100n; C_0603_1608Metric; MPN CC0603KRX7R9BB104; LCSC C14663
P1: TS2068_Edge; TS2068_EdgeConnector_2x32
R1, R2: 4k7; R_0603_1608Metric; MPN 0603WAF4701T5E; LCSC C23162
R3: 1k; R_0603_1608Metric; MPN 0603WAF1001T5E; LCSC C21190
R14: 2k2; R_0603_1608Metric; MPN 0603WAF2201T5E; LCSC C4190
R15, R16, R17: 10k; R_0603_1608Metric; MPN 0603WAF1002T5E; LCSC C25804
SW1: TS Reset; SW_Push_1P1T_XKB_TS-1187A; MPN TS-1187A-B-A-B; LCSC C318884
SW2: NMI; SW_Push_1P1T_XKB_TS-1187A; MPN TS-1187A-B-A-B; LCSC C318884
U1, U2, U3, U4: 74LVC245APW; TSSOP-20_4.4x6.5mm_P0.65mm; MPN 74LVC245APW,118; LCSC C6082
U6: 74LVC32APW; TSSOP-14_4.4x5mm_P0.65mm; MPN 74LVC32APW,118; LCSC C6087
U7: 74LVC06AD; SOIC-14_3.9x8.7mm_P1.27mm; MPN EM74LVC06AD; LCSC C49188178

Connections:
+3V3: C1.1, C2.1, C3.1, C4.1, C5.1, C6.1, R1.1, R15.1, R16.1, R17.1, U1.20 (VCC), U2.20 (VCC), U3.20 (VCC), U4.20 (VCC), U6.14 (VCC), U7.14 (VCC); also elsewhere on the board
+5V_EDGE: P1.B4 (+5V), R14.1; also elsewhere on the board
/2068 Interface/A0: P1.B10 (A0), U1.11 (B7)
/2068 Interface/A1: P1.B11 (A1), U1.12 (B6)
/2068 Interface/A2: P1.B12 (A2), U1.13 (B5)
/2068 Interface/A3: P1.B13 (A3), U1.14 (B4)
/2068 Interface/A4: P1.B25 (A4), U1.18 (B0)
/2068 Interface/A5: P1.B24 (A5), U1.17 (B1)
/2068 Interface/A6: P1.B23 (A6), U1.16 (B2)
/2068 Interface/A7: P1.B22 (A7), U1.15 (B3)
/2068 Interface/A8: P1.B21 (A8), U2.18 (B0)
/2068 Interface/A9: P1.B20 (A9), U2.17 (B1)
/2068 Interface/A10: P1.B19 (A10), U2.16 (B2)
/2068 Interface/A11: P1.B18 (A11), U2.15 (B3)
/2068 Interface/A12: P1.B17 (A12), U2.14 (B4)
/2068 Interface/A13: P1.B16 (A13), U2.13 (B5)
/2068 Interface/A14: P1.B15 (A14), U2.12 (B6), U4.14 (B4)
/2068 Interface/A15: P1.B14 (A15), U2.11 (B7), U4.13 (B5)
/2068 Interface/D0: P1.A7 (D0), U3.3 (A1)
/2068 Interface/D1: P1.A8 (D1), U3.4 (A2)
/2068 Interface/D2: P1.A9 (D2), U3.5 (A3)
/2068 Interface/D3: P1.A12 (D3), U3.8 (A6)
/2068 Interface/D4: P1.A13 (D4), U3.9 (A7)
/2068 Interface/D5: P1.A11 (D5), U3.7 (A5)
/2068 Interface/D6: P1.A10 (D6), U3.6 (A4)
/2068 Interface/D7: P1.A4 (D7), U3.2 (A0)
/2068 Interface/EAR: P1.A2 (EAR), R2.2, R3.1
/2068 Interface/SPKR_TAPE: P1.B2 (SPKR_TAPE), U4.11 (B7)
/2068 Interface/nBE: P1.A29 (~BE), R14.2, U7.2
/2068 Interface/nBUSRQ: P1.A23 (~BUSRQ), U7.6
/2068 Interface/nEXROM: P1.A27 (~EXROM), U4.17 (B1)
/2068 Interface/nINT: P1.A14 (~INT), U4.12 (B6)
/2068 Interface/nIORQ: P1.A18 (~IORQ), U6.9, U6.12
/2068 Interface/nMREQ: P1.A17 (~MREQ), U6.1, U6.4
/2068 Interface/nNMI: P1.A15 (~NMI), SW2.1, U7.8
/2068 Interface/nRD: P1.A19 (~RD), U3.1 (A->B), U6.2, U6.10
/2068 Interface/nRESET: P1.A24 (~RESET), SW1.1, U7.10
/2068 Interface/nROSCS: P1.A28 (~ROSCS), U4.18 (B0)
/2068 Interface/nWAIT: P1.A22 (~WAIT), U7.4
/2068 Interface/nWR: P1.A20 (~WR), U6.5, U6.13
BE_REQ: U7.1; also elsewhere on the board
BUSRQ: U7.5; also elsewhere on the board
GND: C1.2, C2.2, C3.2, C4.2, C5.2, C6.2, P1.A1 (GND), P1.A32 (GND), P1.B1 (GND), P1.B7 (PGND), P1.B8 (PGND), P1.B32 (GND), R3.2, SW1.2, SW2.2, U1.1 (A->B), U1.10 (GND), U2.1 (A->B), U2.10 (GND), U3.10 (GND), U4.1 (A->B), U4.10 (GND), U4.16 (B2), U4.19 (CE), U6.7 (GND), U7.7 (GND); also elsewhere on the board
MD0: U1.9 (A7), U2.2 (A0), U3.17 (B1); also elsewhere on the board
MD1: U1.8 (A6), U2.3 (A1), U3.16 (B2); also elsewhere on the board
MD2: U1.7 (A5), U2.4 (A2), U3.15 (B3); also elsewhere on the board
MD3: U1.6 (A4), U2.5 (A3), U3.12 (B6); also elsewhere on the board
MD4: U1.2 (A0), U2.6 (A4), U3.11 (B7); also elsewhere on the board
MD5: U1.3 (A1), U2.7 (A5), U3.13 (B5); also elsewhere on the board
MD6: U1.4 (A2), U2.8 (A6), U3.14 (B4); also elsewhere on the board
MD7: U1.5 (A3), U2.9 (A7), U3.18 (B0); also elsewhere on the board
NMI_REQ: U7.9; also elsewhere on the board
RESET_HOLD: R1.2, U7.11; also elsewhere on the board
SOUND_2068: P1.A31 (SOUND); also elsewhere on the board
TAPE_IN: U4.9 (A7); also elsewhere on the board
TAPE_OUT: R2.1; also elsewhere on the board
WAIT_REQ: U7.3; also elsewhere on the board
WIFI_DL: U7.13; also elsewhere on the board
Z80_A14: U4.6 (A4); also elsewhere on the board
Z80_A15: U4.7 (A5); also elsewhere on the board
nAEN_HI: R16.2, U2.19 (CE); also elsewhere on the board
nAEN_LO: R15.2, U1.19 (CE); also elsewhere on the board
nBUSAK: P1.A21 (~BUSAK), U4.15 (B3)
nBUSAK_L: U4.5 (A3); also elsewhere on the board
nDATA_OE: R17.2, U3.19 (CE); also elsewhere on the board
nEXROM_L: U4.3 (A1); also elsewhere on the board
nINT_L: U4.8 (A6); also elsewhere on the board
nIORD: U6.8; also elsewhere on the board
nIOWR: U6.11; also elsewhere on the board
nMEMRD: U6.3; also elsewhere on the board
nMEMWR: U6.6; also elsewhere on the board
nROSCS_L: U4.2 (A0); also elsewhere on the board
nWIFI_BOOT: U7.12; also elsewhere on the board

Notes on the sheet:
TS2068 bus interface. Nets: n = active low, _L = 3.3 V copy of a bus signal, _G = 3.3 V request driven onto the bus through an open-drain buffer.
Power: edge +5V (B4) goes to the power sheet as +5V_EDGE and is diode-ORed with USB VBUS. +15V (B3) unused.
R2/R3: TAPE_OUT divided to ~0.6 V for the 2068 EAR input.
Values to be confirmed on the prototype.
R14: nBE pull-up to the 2068's +5V. R15-R17: buffer enables held off until the firmware drives GP8-GP10.

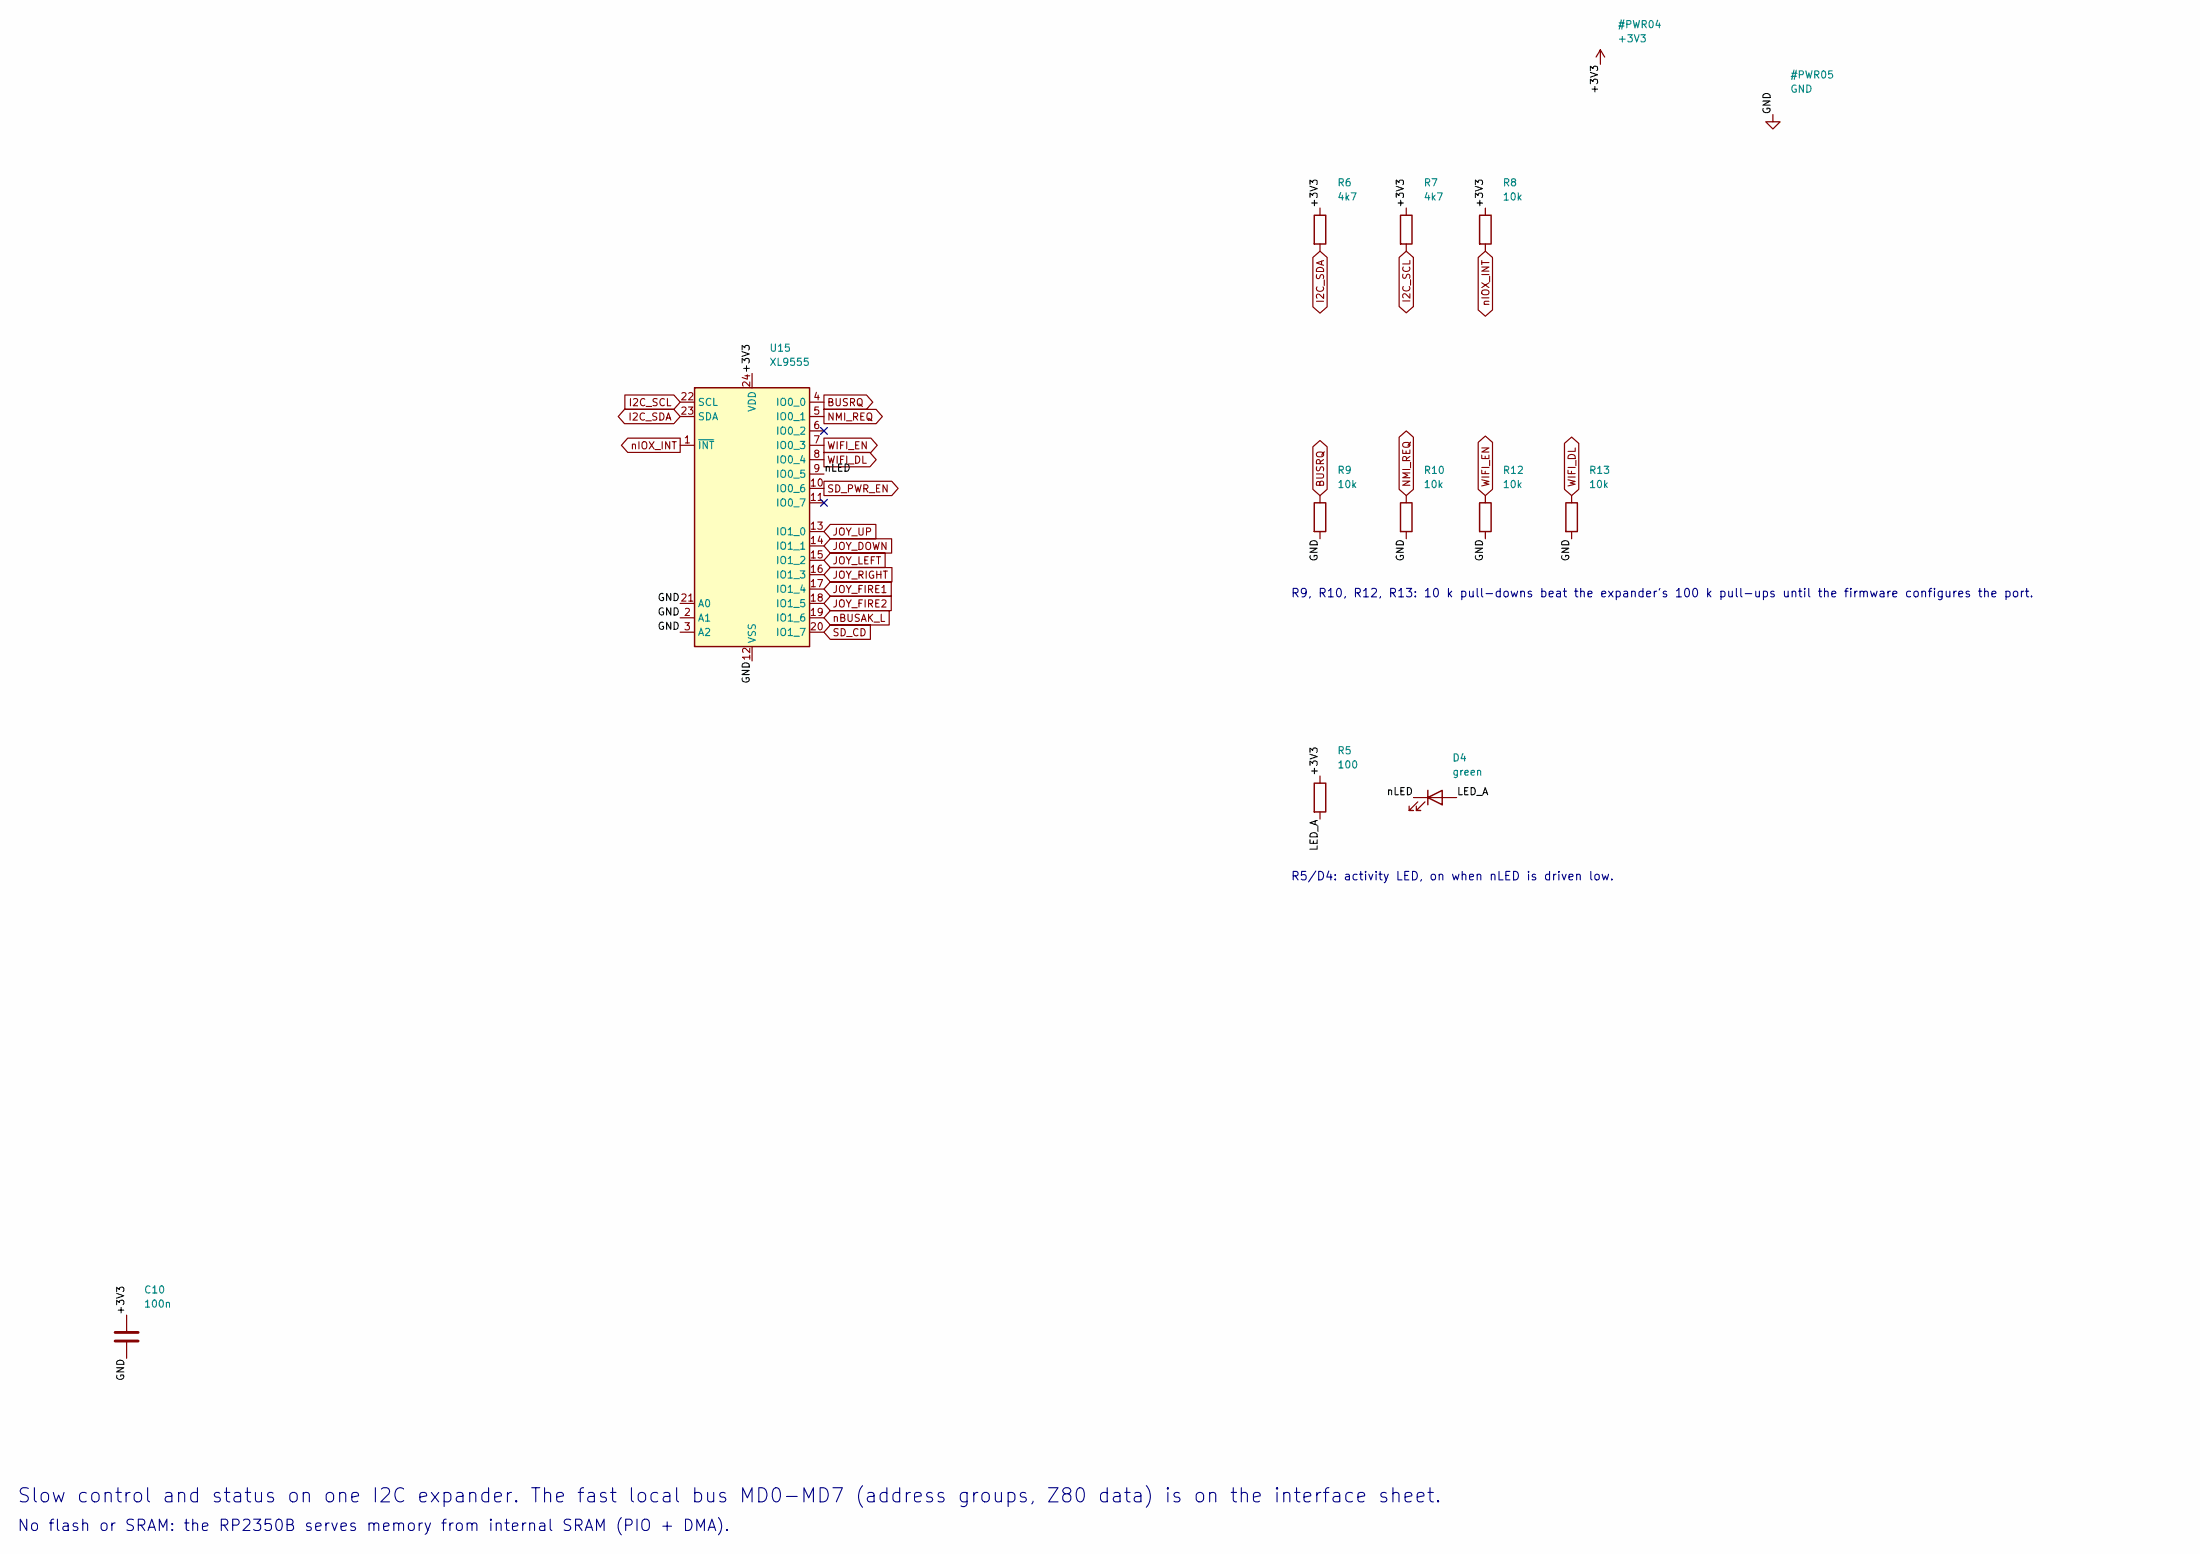
[picture p34: schematic memory.kicad_sch, TS-Pico v3: I/O Expander]

Parts:
C10: 100n; C_0603_1608Metric; MPN CC0603KRX7R9BB104; LCSC C14663
D4: green; LED_0805_2012Metric; MPN KT-0805G; LCSC C2297
R5: 100; R_0603_1608Metric; MPN 0603WAF1000T5E; LCSC C22775
R6, R7: 4k7; R_0603_1608Metric; MPN 0603WAF4701T5E; LCSC C23162
R8, R9, R10, R12, R13: 10k; R_0603_1608Metric; MPN 0603WAF1002T5E; LCSC C25804
U15: XL9555; TSSOP-24_4.4x7.8mm_P0.65mm; MPN XL9555; LCSC C609791

Connections:
+3V3: C10.1, R5.1, R6.1, R7.1, R8.1, U15.24 (VDD); also elsewhere on the board
/Local Bus and Registers/LED_A: D4.2 (A), R5.2
/Local Bus and Registers/nLED: D4.1 (K), U15.9 (IO0_5)
BUSRQ: R9.1, U15.4 (IO0_0); also elsewhere on the board
GND: C10.2, R9.2, R10.2, R12.2, R13.2, U15.2 (A1), U15.3 (A2), U15.12 (VSS), U15.21 (A0); also elsewhere on the board
I2C_SCL: R7.2, U15.22 (SCL); also elsewhere on the board
I2C_SDA: R6.2, U15.23 (SDA); also elsewhere on the board
JOY_DOWN: U15.14 (IO1_1); also elsewhere on the board
JOY_FIRE1: U15.17 (IO1_4); also elsewhere on the board
JOY_FIRE2: U15.18 (IO1_5); also elsewhere on the board
JOY_LEFT: U15.15 (IO1_2); also elsewhere on the board
JOY_RIGHT: U15.16 (IO1_3); also elsewhere on the board
JOY_UP: U15.13 (IO1_0); also elsewhere on the board
NMI_REQ: R10.1, U15.5 (IO0_1); also elsewhere on the board
SD_CD: U15.20 (IO1_7); also elsewhere on the board
SD_PWR_EN: U15.10 (IO0_6); also elsewhere on the board
WIFI_DL: R13.1, U15.8 (IO0_4); also elsewhere on the board
WIFI_EN: R12.1, U15.7 (IO0_3); also elsewhere on the board
nBUSAK_L: U15.19 (IO1_6); also elsewhere on the board
nIOX_INT: R8.2, U15.1 (~INT); also elsewhere on the board

Notes on the sheet:
Slow control and status on one I2C expander. The fast local bus MD0-MD7 (address groups, Z80 data) is on the interface sheet.
No flash or SRAM: the RP2350B serves memory from internal SRAM (PIO + DMA).
R9, R10, R12, R13: 10 k pull-downs beat the expander's 100 k pull-ups until the firmware configures the port.
R5/D4: activity LED, on when nLED is driven low.

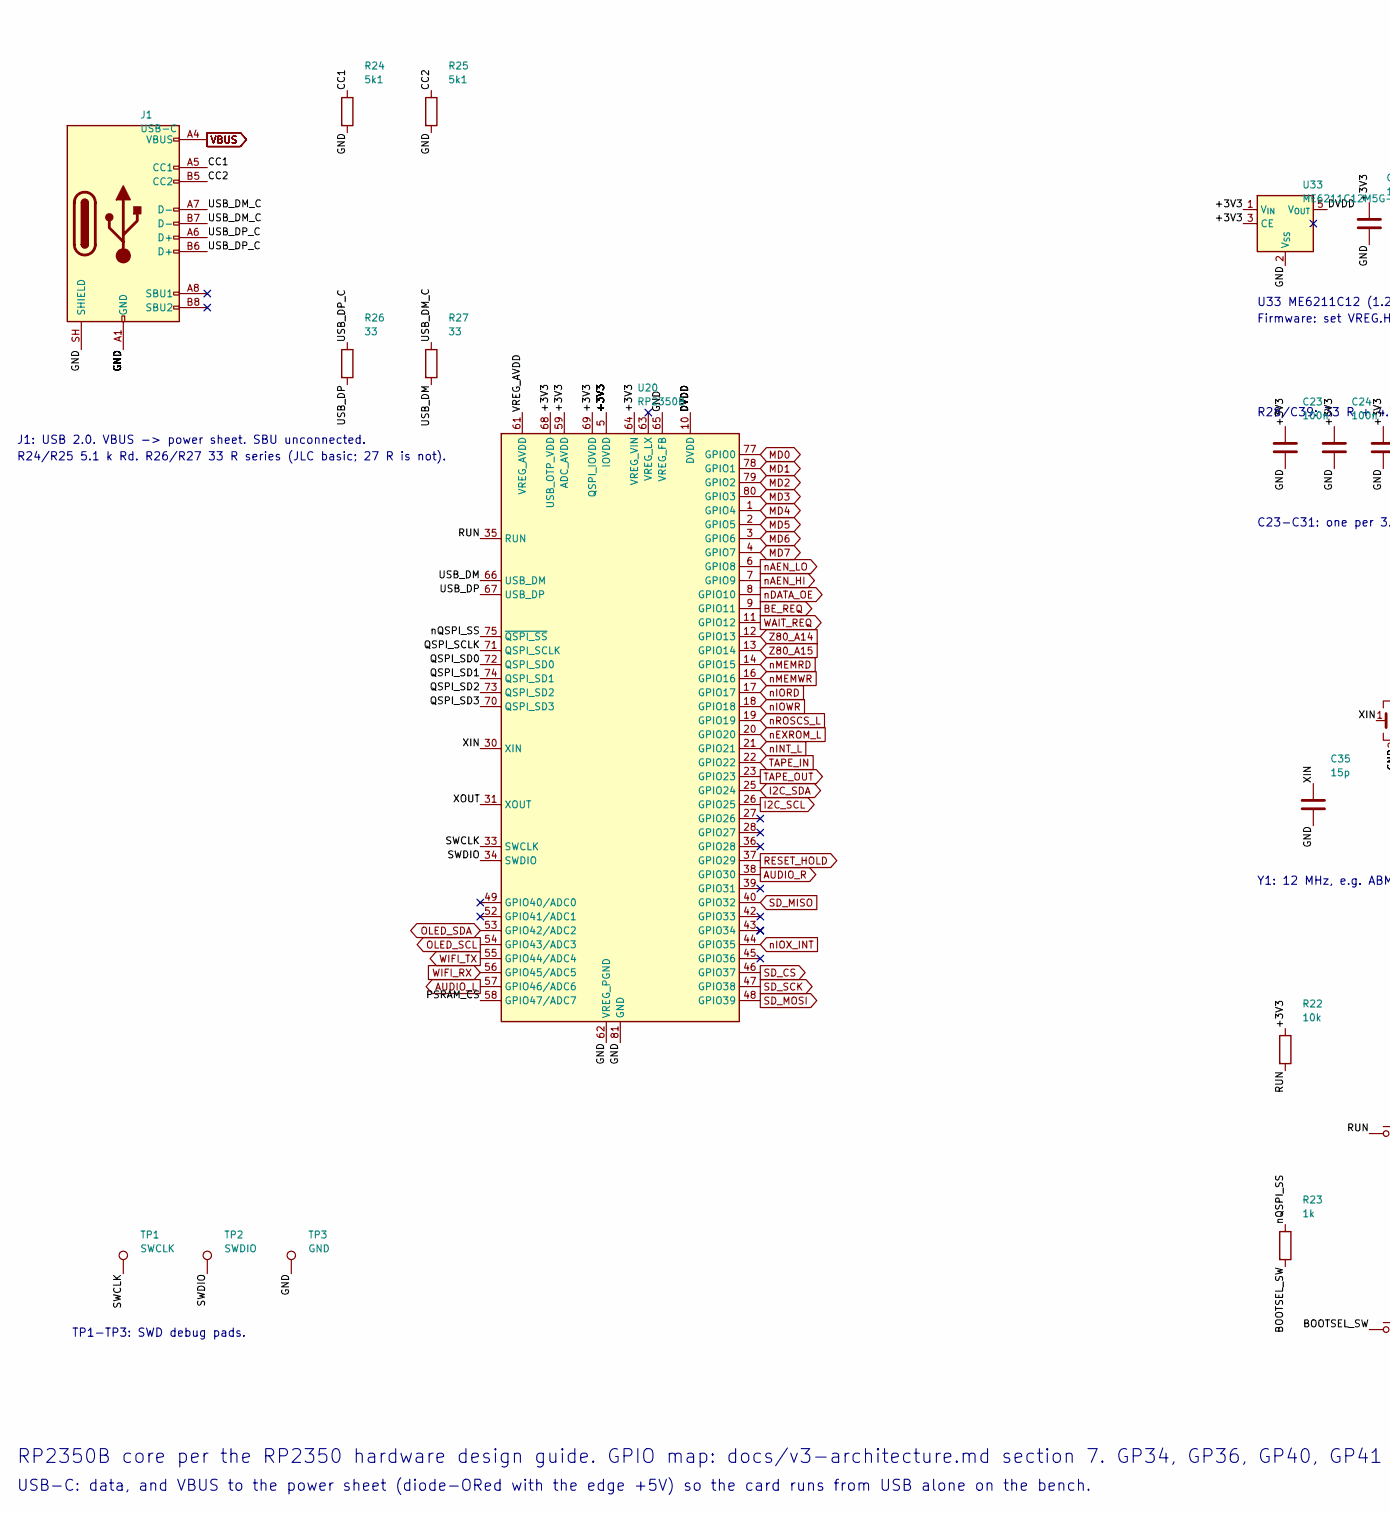
[picture p35: schematic mcu.kicad_sch, TS-Pico v3: RP2350B Core, part in row 1, column 1]

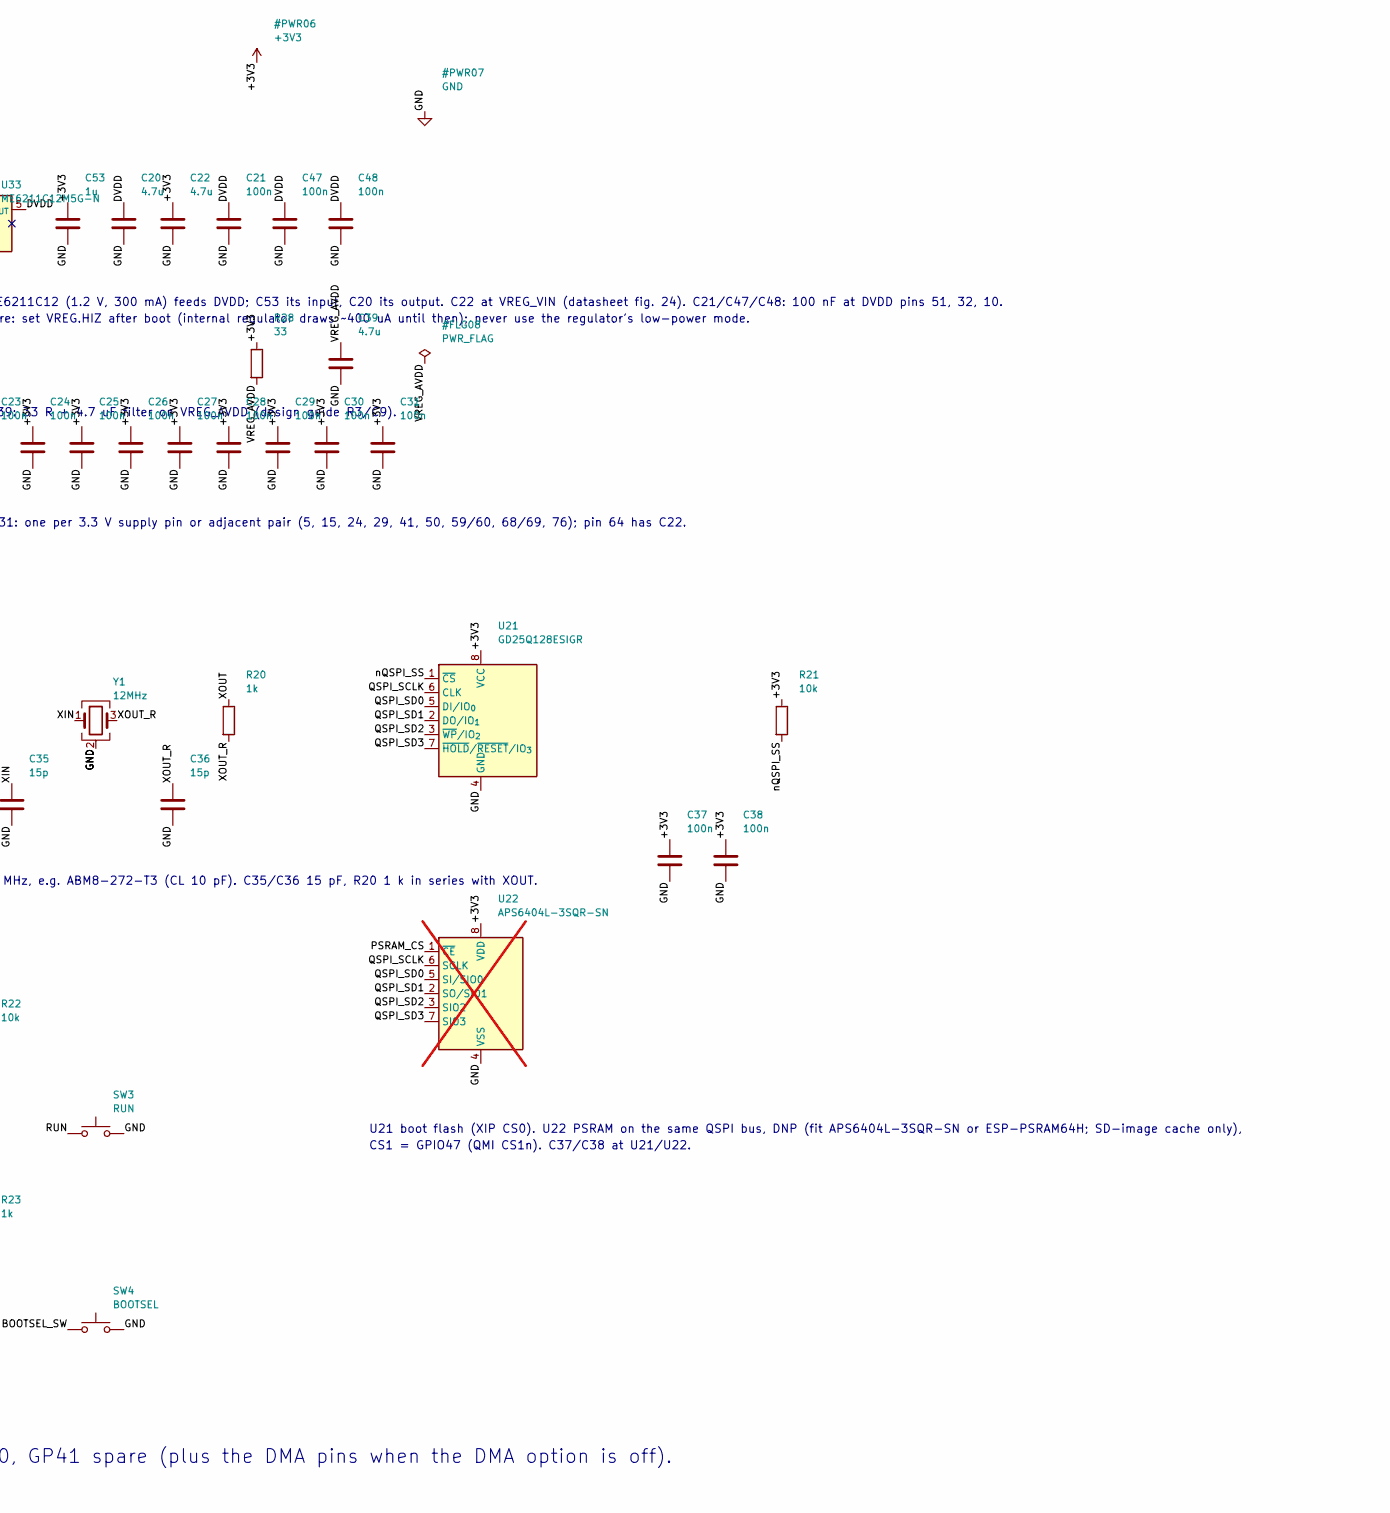
[picture p36: schematic mcu.kicad_sch, TS-Pico v3: RP2350B Core, part in row 1, column 2]

Parts:
C20, C22, C39: 4.7u; C_0402_1005Metric; MPN CL05A475MP5NRNC; LCSC C23733
C21, C23, C24, C25, C26, C27, C28, C29, C30, C31, C37, C38, C47, C48: 100n; C_0603_1608Metric; MPN CC0603KRX7R9BB104; LCSC C14663
C35, C36: 15p; C_0603_1608Metric; MPN CL10C150JB8NNNC; LCSC C1644
C53: 1u; C_0603_1608Metric; MPN CL10A105KB8NNNC; LCSC C15849
J1: USB-C; USB_C_Receptacle_HRO_TYPE-C-31-M-12; MPN TYPE-C-31-M-12; LCSC C165948
R20, R23: 1k; R_0603_1608Metric; MPN 0603WAF1001T5E; LCSC C21190
R21, R22: 10k; R_0603_1608Metric; MPN 0603WAF1002T5E; LCSC C25804
R24, R25: 5k1; R_0603_1608Metric; MPN 0603WAF5101T5E; LCSC C23186
R26, R27, R28: 33; R_0603_1608Metric; MPN 0603WAF330JT5E; LCSC C23140
SW3: RUN; SW_Push_1P1T_XKB_TS-1187A; MPN TS-1187A-B-A-B; LCSC C318884
SW4: BOOTSEL; SW_Push_1P1T_XKB_TS-1187A; MPN TS-1187A-B-A-B; LCSC C318884
TP1: SWCLK; TestPoint_Pad_1.5x1.5mm
TP2: SWDIO; TestPoint_Pad_1.5x1.5mm
TP3: GND; TestPoint_Pad_1.5x1.5mm
U20: RP2350B; QFN-80-1EP_10x10mm_P0.4mm_EP3.4x3.4mm; MPN RP2350B; LCSC C42415655
U21: GD25Q128ESIGR; SOIC-8_5.3x5.3mm_P1.27mm; MPN GD25Q128ESIGR; LCSC C2928891
U22: APS6404L-3SQR-SN; SOIC-8_3.9x4.9mm_P1.27mm; MPN APS6404L-3SQR-SN; LCSC C5333729; not fitted
U33: ME6211C12M5G-N; SOT-23-5; MPN ME6211C12M5G-N; LCSC C236672
Y1: 12MHz; Crystal_SMD_3225-4Pin_3.2x2.5mm; MPN ABM8-272-T3; LCSC C20625731

Connections:
+3V3: C22.1, C23.1, C24.1, C25.1, C26.1, C27.1, C28.1, C29.1, C30.1, C31.1, C37.1, C38.1, C53.1, R21.1, R22.1, R28.1, U20.5 (IOVDD), U20.15 (IOVDD), U20.24 (IOVDD), U20.29 (IOVDD), U20.41 (IOVDD), U20.50 (IOVDD), U20.59 (ADC_AVDD), U20.60 (IOVDD), U20.64 (VREG_VIN), U20.68 (USB_OTP_VDD), U20.69 (QSPI_IOVDD), U20.76 (IOVDD), U21.8 (VCC), U22.8 (VDD), U33.1 (V_{IN}), U33.3 (CE); also elsewhere on the board
/RP2350B Core/BOOTSEL_SW: R23.2, SW4.1
/RP2350B Core/CC1: J1.A5 (CC1), R24.1
/RP2350B Core/CC2: J1.B5 (CC2), R25.1
/RP2350B Core/DVDD: C20.1, C21.1, C47.1, C48.1, U20.10 (DVDD), U20.32 (DVDD), U20.51 (DVDD), U33.5 (V_{OUT})
/RP2350B Core/PSRAM_CS: U20.58 (GPIO47/ADC7), U22.1 (~CE)
/RP2350B Core/QSPI_SCLK: U20.71 (QSPI_SCLK), U21.6 (CLK), U22.6 (SCLK)
/RP2350B Core/QSPI_SD0: U20.72 (QSPI_SD0), U21.5 (DI/IO_{0}), U22.5 (SI/SIO0)
/RP2350B Core/QSPI_SD1: U20.74 (QSPI_SD1), U21.2 (DO/IO_{1}), U22.2 (SO/SIO1)
/RP2350B Core/QSPI_SD2: U20.73 (QSPI_SD2), U21.3 (~WP/IO_{2}), U22.3 (SIO2)
/RP2350B Core/QSPI_SD3: U20.70 (QSPI_SD3), U21.7 (~HOLD/~RESET/IO_{3}), U22.7 (SIO3)
/RP2350B Core/RUN: R22.2, SW3.1, U20.35 (RUN)
/RP2350B Core/SWCLK: TP1.1, U20.33 (SWCLK)
/RP2350B Core/SWDIO: TP2.1, U20.34 (SWDIO)
/RP2350B Core/USB_DM: R27.2, U20.66 (USB_DM)
/RP2350B Core/USB_DM_C: J1.A7 (D-), J1.B7 (D-), R27.1
/RP2350B Core/USB_DP: R26.2, U20.67 (USB_DP)
/RP2350B Core/USB_DP_C: J1.A6 (D+), J1.B6 (D+), R26.1
/RP2350B Core/VREG_AVDD: C39.1, R28.2, U20.61 (VREG_AVDD)
/RP2350B Core/XIN: C35.1, U20.30 (XIN), Y1.1
/RP2350B Core/XOUT: R20.1, U20.31 (XOUT)
/RP2350B Core/XOUT_R: C36.1, R20.2, Y1.3
/RP2350B Core/nQSPI_SS: R21.2, R23.1, U20.75 (~QSPI_SS), U21.1 (~CS)
AUDIO_L: U20.57 (GPIO46/ADC6); also elsewhere on the board
AUDIO_R: U20.38 (GPIO30); also elsewhere on the board
BE_REQ: U20.9 (GPIO11); also elsewhere on the board
GND: C20.2, C21.2, C22.2, C23.2, C24.2, C25.2, C26.2, C27.2, C28.2, C29.2, C30.2, C31.2, C35.2, C36.2, C37.2, C38.2, C39.2, C47.2, C48.2, C53.2, J1.A1 (GND), J1.A12 (GND), J1.B1 (GND), J1.B12 (GND), J1.SH (SHIELD), R24.2, R25.2, SW3.2, SW4.2, TP3.1, U20.62 (VREG_PGND), U20.65 (VREG_FB), U20.81 (GND), U21.4 (GND), U22.4 (VSS), U33.2 (V_{SS}), Y1.2 (G), Y1.4 (G); also elsewhere on the board
I2C_SCL: U20.26 (GPIO25); also elsewhere on the board
I2C_SDA: U20.25 (GPIO24); also elsewhere on the board
MD0: U20.77 (GPIO0); also elsewhere on the board
MD1: U20.78 (GPIO1); also elsewhere on the board
MD2: U20.79 (GPIO2); also elsewhere on the board
MD3: U20.80 (GPIO3); also elsewhere on the board
MD4: U20.1 (GPIO4); also elsewhere on the board
MD5: U20.2 (GPIO5); also elsewhere on the board
MD6: U20.3 (GPIO6); also elsewhere on the board
MD7: U20.4 (GPIO7); also elsewhere on the board
OLED_SCL: U20.54 (GPIO43/ADC3); also elsewhere on the board
OLED_SDA: U20.53 (GPIO42/ADC2); also elsewhere on the board
RESET_HOLD: U20.37 (GPIO29); also elsewhere on the board
SD_CS: U20.46 (GPIO37); also elsewhere on the board
SD_MISO: U20.40 (GPIO32); also elsewhere on the board
SD_MOSI: U20.48 (GPIO39); also elsewhere on the board
SD_SCK: U20.47 (GPIO38); also elsewhere on the board
TAPE_IN: U20.22 (GPIO22); also elsewhere on the board
TAPE_OUT: U20.23 (GPIO23); also elsewhere on the board
VBUS: J1.A4 (VBUS), J1.A9 (VBUS), J1.B4 (VBUS), J1.B9 (VBUS); also elsewhere on the board
WAIT_REQ: U20.11 (GPIO12); also elsewhere on the board
WIFI_RX: U20.56 (GPIO45/ADC5); also elsewhere on the board
WIFI_TX: U20.55 (GPIO44/ADC4); also elsewhere on the board
Z80_A14: U20.12 (GPIO13); also elsewhere on the board
Z80_A15: U20.13 (GPIO14); also elsewhere on the board
nAEN_HI: U20.7 (GPIO9); also elsewhere on the board
nAEN_LO: U20.6 (GPIO8); also elsewhere on the board
nDATA_OE: U20.8 (GPIO10); also elsewhere on the board
nEXROM_L: U20.20 (GPIO20); also elsewhere on the board
nINT_L: U20.21 (GPIO21); also elsewhere on the board
nIORD: U20.17 (GPIO17); also elsewhere on the board
nIOWR: U20.18 (GPIO18); also elsewhere on the board
nIOX_INT: U20.44 (GPIO35); also elsewhere on the board
nMEMRD: U20.14 (GPIO15); also elsewhere on the board
nMEMWR: U20.16 (GPIO16); also elsewhere on the board
nROSCS_L: U20.19 (GPIO19); also elsewhere on the board

Notes on the sheet:
RP2350B core per the RP2350 hardware design guide. GPIO map: docs/v3-architecture.md section 7. GP34, GP36, GP40, GP41 spare (plus the DMA pins when the DMA option is off).
USB-C: data, and VBUS to the power sheet (diode-ORed with the edge +5V) so the card runs from USB alone on the bench.
U33 ME6211C12 (1.2 V, 300 mA) feeds DVDD; C53 its input, C20 its output. C22 at VREG_VIN (datasheet fig. 24). C21/C47/C48: 100 nF at DVDD pins 51, 32, 10.
Firmware: set VREG.HIZ after boot (internal regulator draws ~400 uA until then); never use the regulator's low-power mode.
R28/C39: 33 R + 4.7 uF filter on VREG_AVDD (design guide R3/C9).
C23-C31: one per 3.3 V supply pin or adjacent pair (5, 15, 24, 29, 41, 50, 59/60, 68/69, 76); pin 64 has C22.
Y1: 12 MHz, e.g. ABM8-272-T3 (CL 10 pF). C35/C36 15 pF, R20 1 k in series with XOUT.
U21 boot flash (XIP CS0). U22 PSRAM on the same QSPI bus, DNP (fit APS6404L-3SQR-SN or ESP-PSRAM64H; SD-image cache only),
CS1 = GPIO47 (QMI CS1n). C37/C38 at U21/U22.
J1: USB 2.0. VBUS -> power sheet. SBU unconnected.
R24/R25 5.1 k Rd. R26/R27 33 R series (JLC basic; 27 R is not).
TP1-TP3: SWD debug pads.
