factus10/tspico-hardware/hardware/tspico-v3.kicad_pcb

## KiCad design hardware/tspico-v3.kicad_pcb (continued)

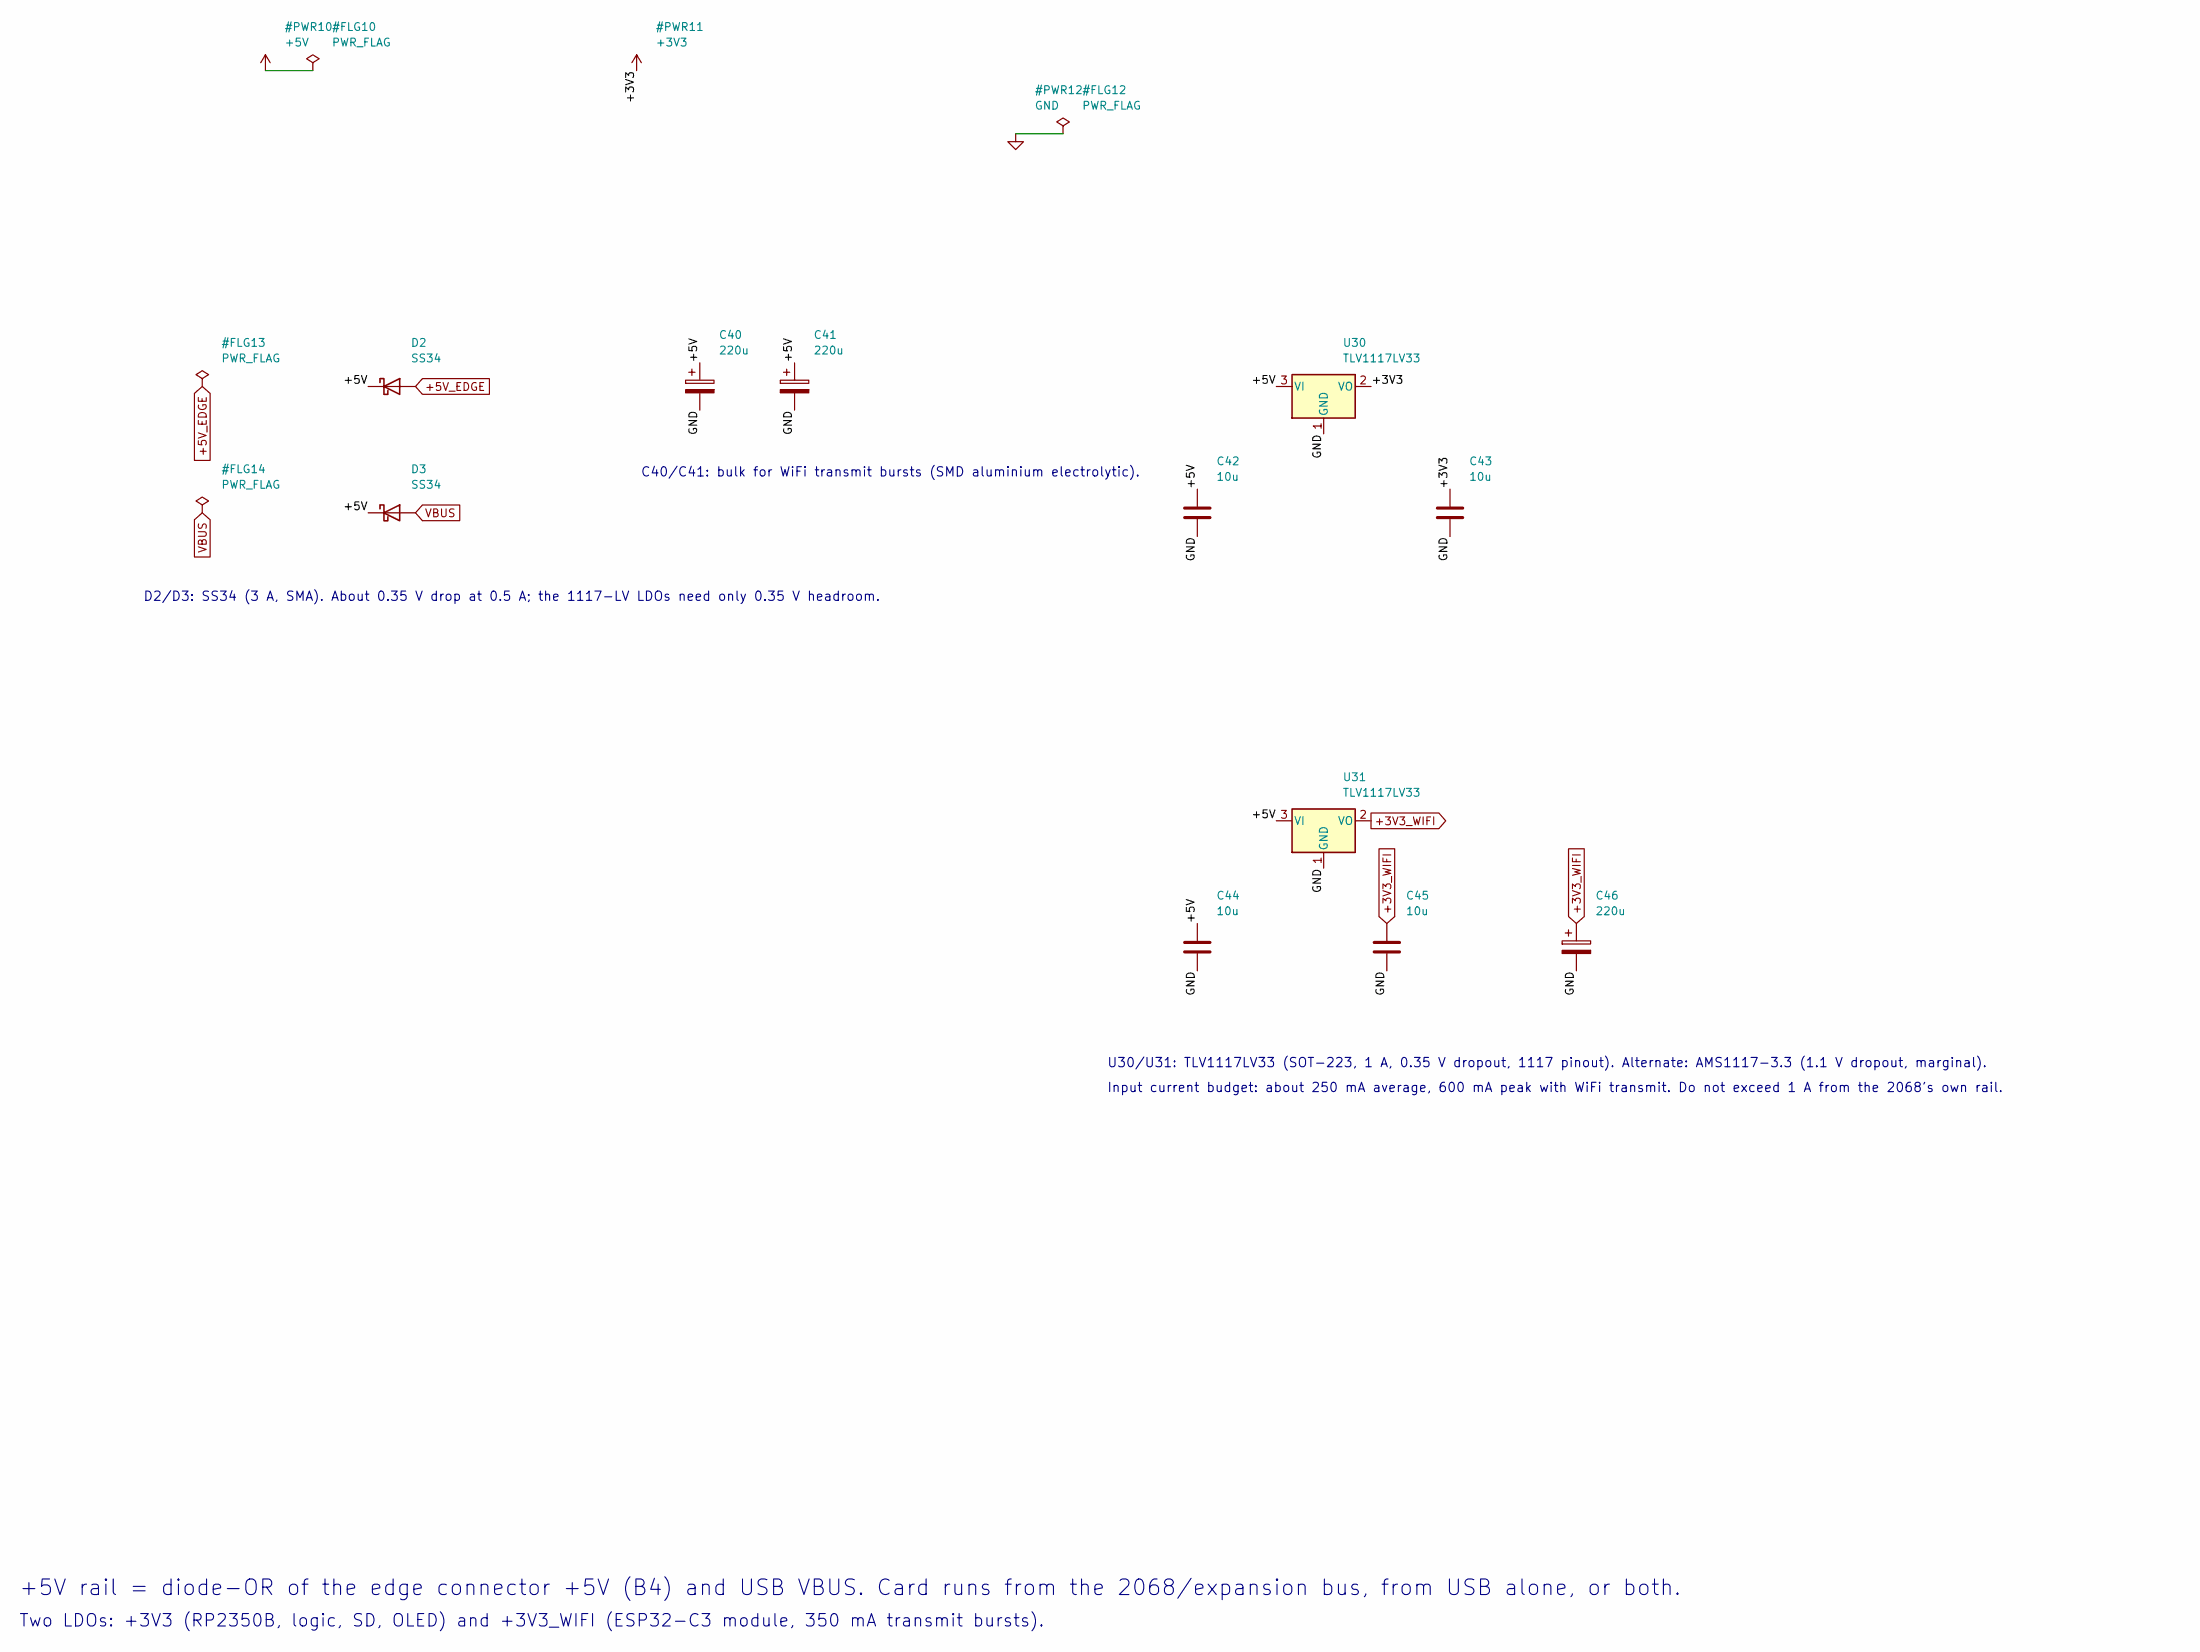
[picture p37: schematic power.kicad_sch, TS-Pico v3: Power]

Parts:
C40, C41, C46: 220u; CP_Elec_6.3x5.4; MPN RVT220UF10V67RV0037; LCSC C2833309
C42, C43, C44, C45: 10u; C_0603_1608Metric; MPN CL10A106KP8NNNC; LCSC C19702
D2, D3: SS34; D_SMA; MPN SS34; LCSC C8678
U30, U31: TLV1117LV33; SOT-223-3_TabPin2; MPN TLV1117LV33DCYR; LCSC C15578

Connections:
+3V3: C43.1, U30.2 (VO); also elsewhere on the board
+3V3_WIFI: C45.1, C46.1, U31.2 (VO); also elsewhere on the board
+5V: C40.1, C41.1, C42.1, C44.1, D2.1 (K), D3.1 (K), U30.3 (VI), U31.3 (VI); also elsewhere on the board
+5V_EDGE: D2.2 (A); also elsewhere on the board
GND: C40.2, C41.2, C42.2, C43.2, C44.2, C45.2, C46.2, U30.1 (GND), U31.1 (GND); also elsewhere on the board
VBUS: D3.2 (A); also elsewhere on the board

Notes on the sheet:
+5V rail = diode-OR of the edge connector +5V (B4) and USB VBUS. Card runs from the 2068/expansion bus, from USB alone, or both.
Two LDOs: +3V3 (RP2350B, logic, SD, OLED) and +3V3_WIFI (ESP32-C3 module, 350 mA transmit bursts).
D2/D3: SS34 (3 A, SMA). About 0.35 V drop at 0.5 A; the 1117-LV LDOs need only 0.35 V headroom.
C40/C41: bulk for WiFi transmit bursts (SMD aluminium electrolytic).
U30/U31: TLV1117LV33 (SOT-223, 1 A, 0.35 V dropout, 1117 pinout). Alternate: AMS1117-3.3 (1.1 V dropout, marginal).
Input current budget: about 250 mA average, 600 mA peak with WiFi transmit. Do not exceed 1 A from the 2068's own rail.

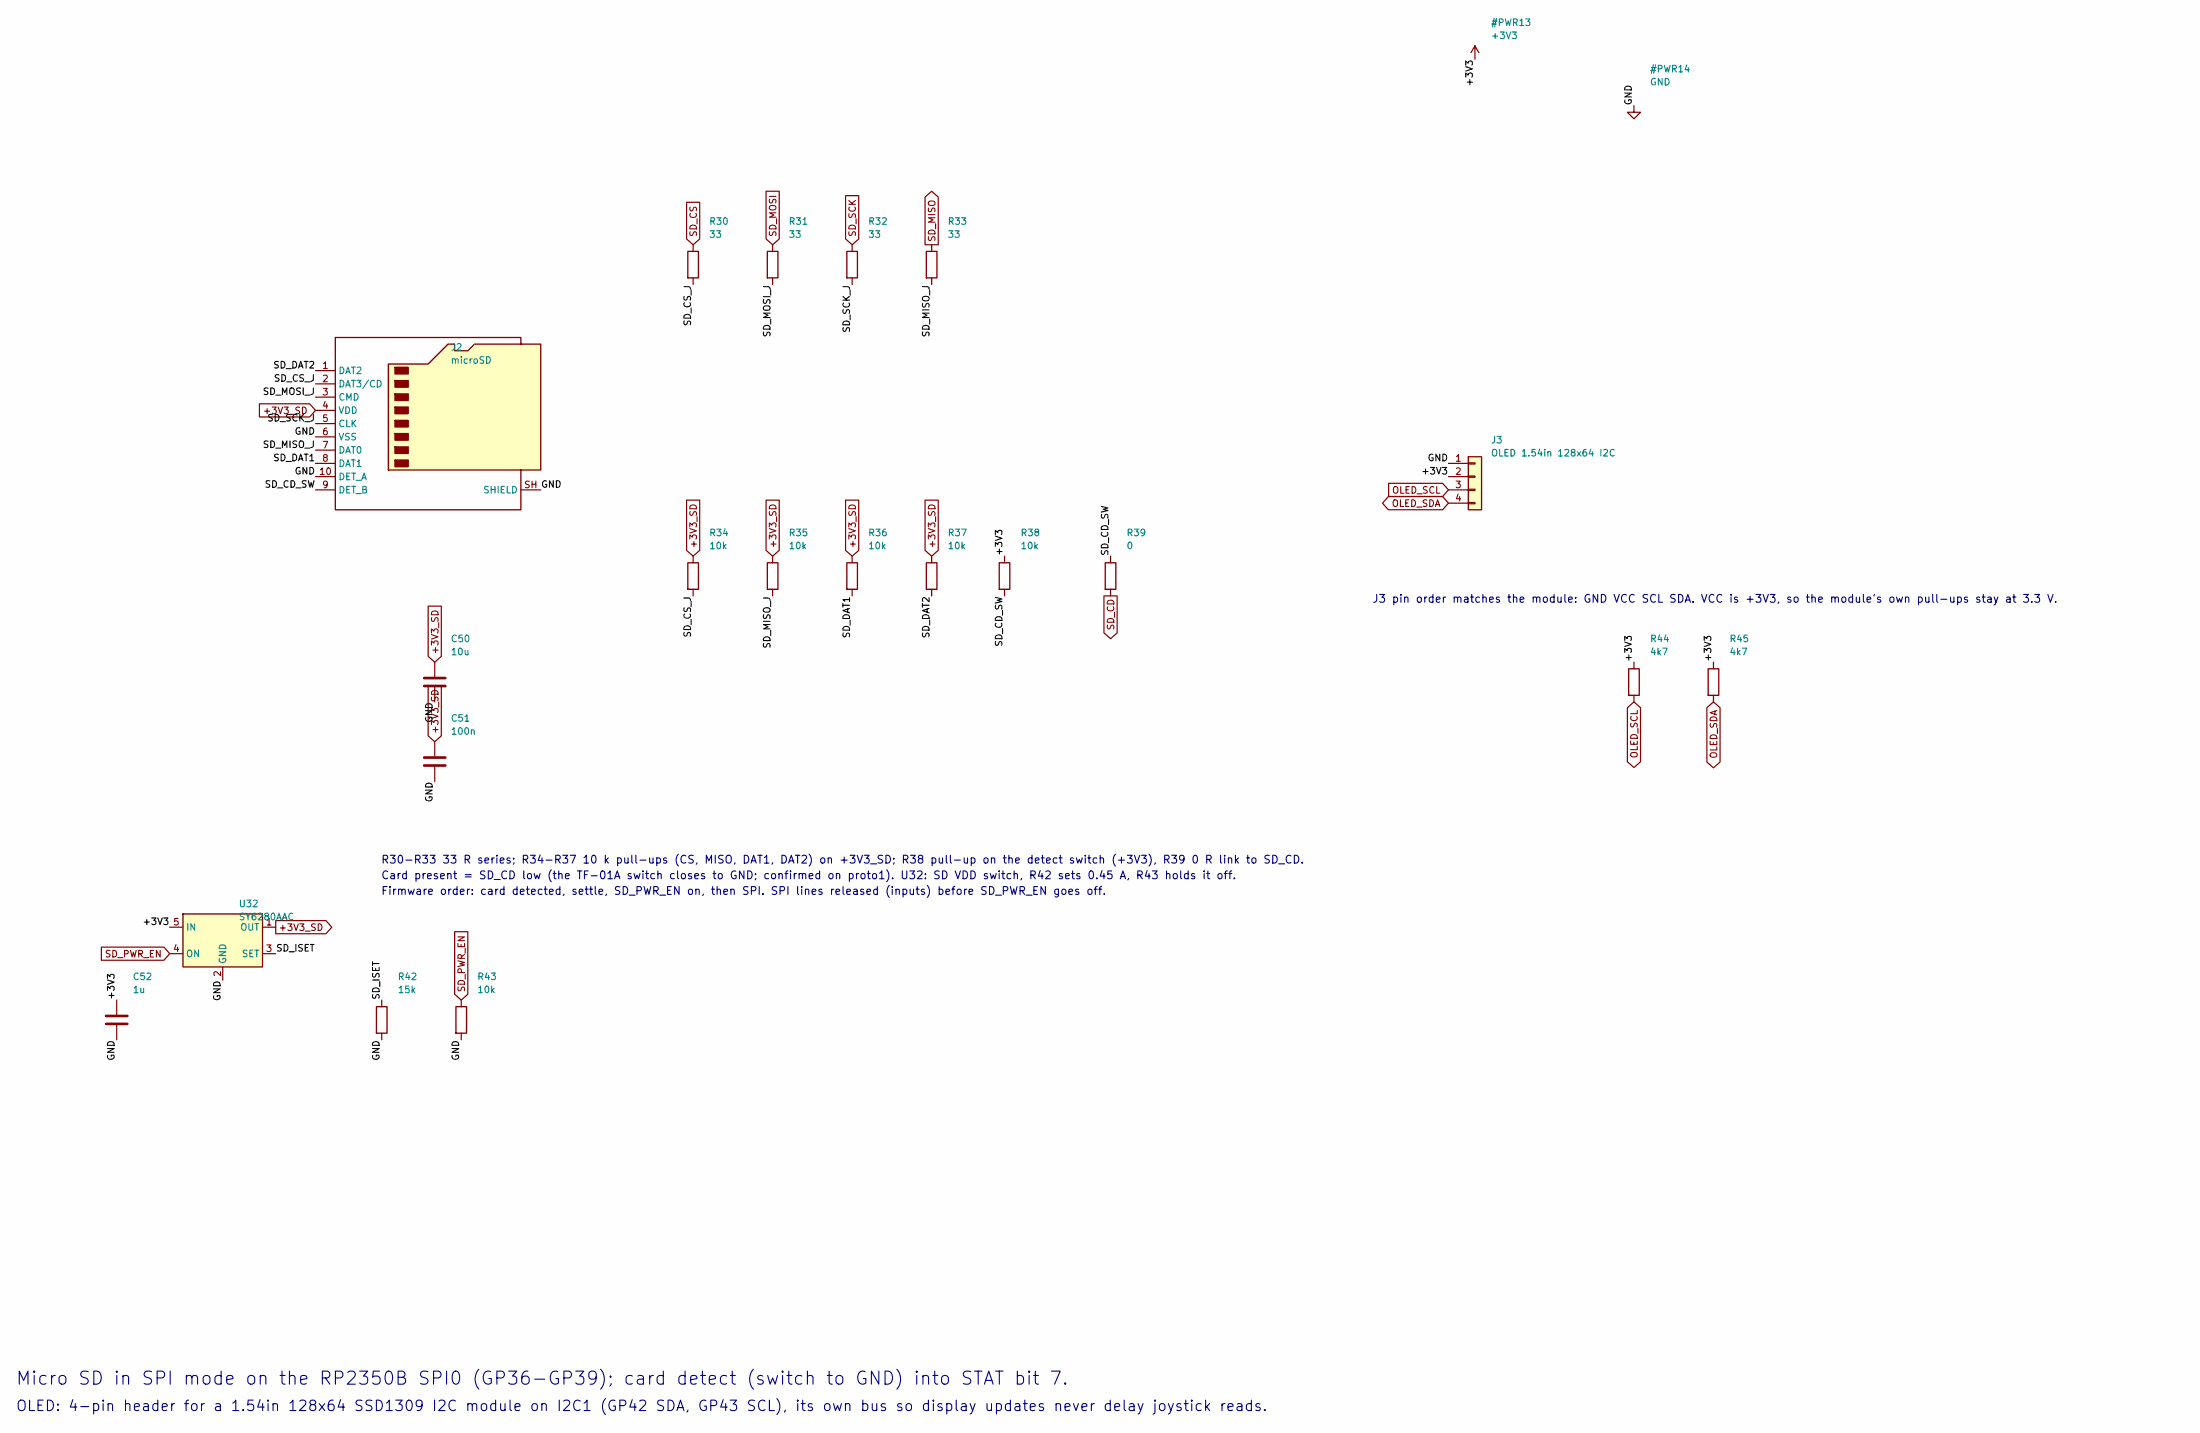
[picture p38: schematic storage_display.kicad_sch, TS-Pico v3: SD and Display]

Parts:
C50: 10u; C_0603_1608Metric; MPN CL10A106KP8NNNC; LCSC C19702
C51: 100n; C_0603_1608Metric; MPN CC0603KRX7R9BB104; LCSC C14663
C52: 1u; C_0603_1608Metric; MPN CL10A105KB8NNNC; LCSC C15849
J2: microSD; microSD_TF-01A; MPN TF-01A; LCSC C91145
J3: OLED 1.54in 128x64 I2C; PinHeader_1x04_P2.54mm_Vertical; MPN 2.54-1x40P (cut to 4); LCSC C2337
R30, R31, R32, R33: 33; R_0603_1608Metric; MPN 0603WAF330JT5E; LCSC C23140
R34, R35, R36, R37, R38, R43: 10k; R_0603_1608Metric; MPN 0603WAF1002T5E; LCSC C25804
R39: 0; R_0603_1608Metric; MPN 0603WAF0000T5E; LCSC C21189
R42: 15k; R_0603_1608Metric; MPN 0603WAF1502T5E; LCSC C22809
R44, R45: 4k7; R_0603_1608Metric; MPN 0603WAF4701T5E; LCSC C23162
U32: SY6280AAC; SOT-23-5; MPN SY6280AAC; LCSC C55136

Connections:
+3V3: C52.1, J3.2, R38.1, R44.1, R45.1, U32.5 (IN); also elsewhere on the board
+3V3_SD: C50.1, C51.1, J2.4 (VDD), R34.1, R35.1, R36.1, R37.1, U32.1 (OUT)
/SD and Display/SD_CD_SW: J2.9 (DET_B), R38.2, R39.1
/SD and Display/SD_CS_J: J2.2 (DAT3/CD), R30.2, R34.2
/SD and Display/SD_DAT1: J2.8 (DAT1), R36.2
/SD and Display/SD_DAT2: J2.1 (DAT2), R37.2
/SD and Display/SD_ISET: R42.1, U32.3 (SET)
/SD and Display/SD_MISO_J: J2.7 (DAT0), R33.2, R35.2
/SD and Display/SD_MOSI_J: J2.3 (CMD), R31.2
/SD and Display/SD_SCK_J: J2.5 (CLK), R32.2
GND: C50.2, C51.2, C52.2, J2.6 (VSS), J2.10 (DET_A), J2.SH (SHIELD), J3.1, R42.2, R43.2, U32.2 (GND); also elsewhere on the board
OLED_SCL: J3.3, R44.2; also elsewhere on the board
OLED_SDA: J3.4, R45.2; also elsewhere on the board
SD_CD: R39.2; also elsewhere on the board
SD_CS: R30.1; also elsewhere on the board
SD_MISO: R33.1; also elsewhere on the board
SD_MOSI: R31.1; also elsewhere on the board
SD_PWR_EN: R43.1, U32.4 (ON); also elsewhere on the board
SD_SCK: R32.1; also elsewhere on the board

Notes on the sheet:
Micro SD in SPI mode on the RP2350B SPI0 (GP36-GP39); card detect (switch to GND) into STAT bit 7.
OLED: 4-pin header for a 1.54in 128x64 SSD1309 I2C module on I2C1 (GP42 SDA, GP43 SCL), its own bus so display updates never delay joystick reads.
R30-R33 33 R series; R34-R37 10 k pull-ups (CS, MISO, DAT1, DAT2) on +3V3_SD; R38 pull-up on the detect switch (+3V3), R39 0 R link to SD_CD.
Card present = SD_CD low (the TF-01A switch closes to GND; confirmed on proto1). U32: SD VDD switch, R42 sets 0.45 A, R43 holds it off.
Firmware order: card detected, settle, SD_PWR_EN on, then SPI. SPI lines released (inputs) before SD_PWR_EN goes off.
J3 pin order matches the module: GND VCC SCL SDA. VCC is +3V3, so the module's own pull-ups stay at 3.3 V.

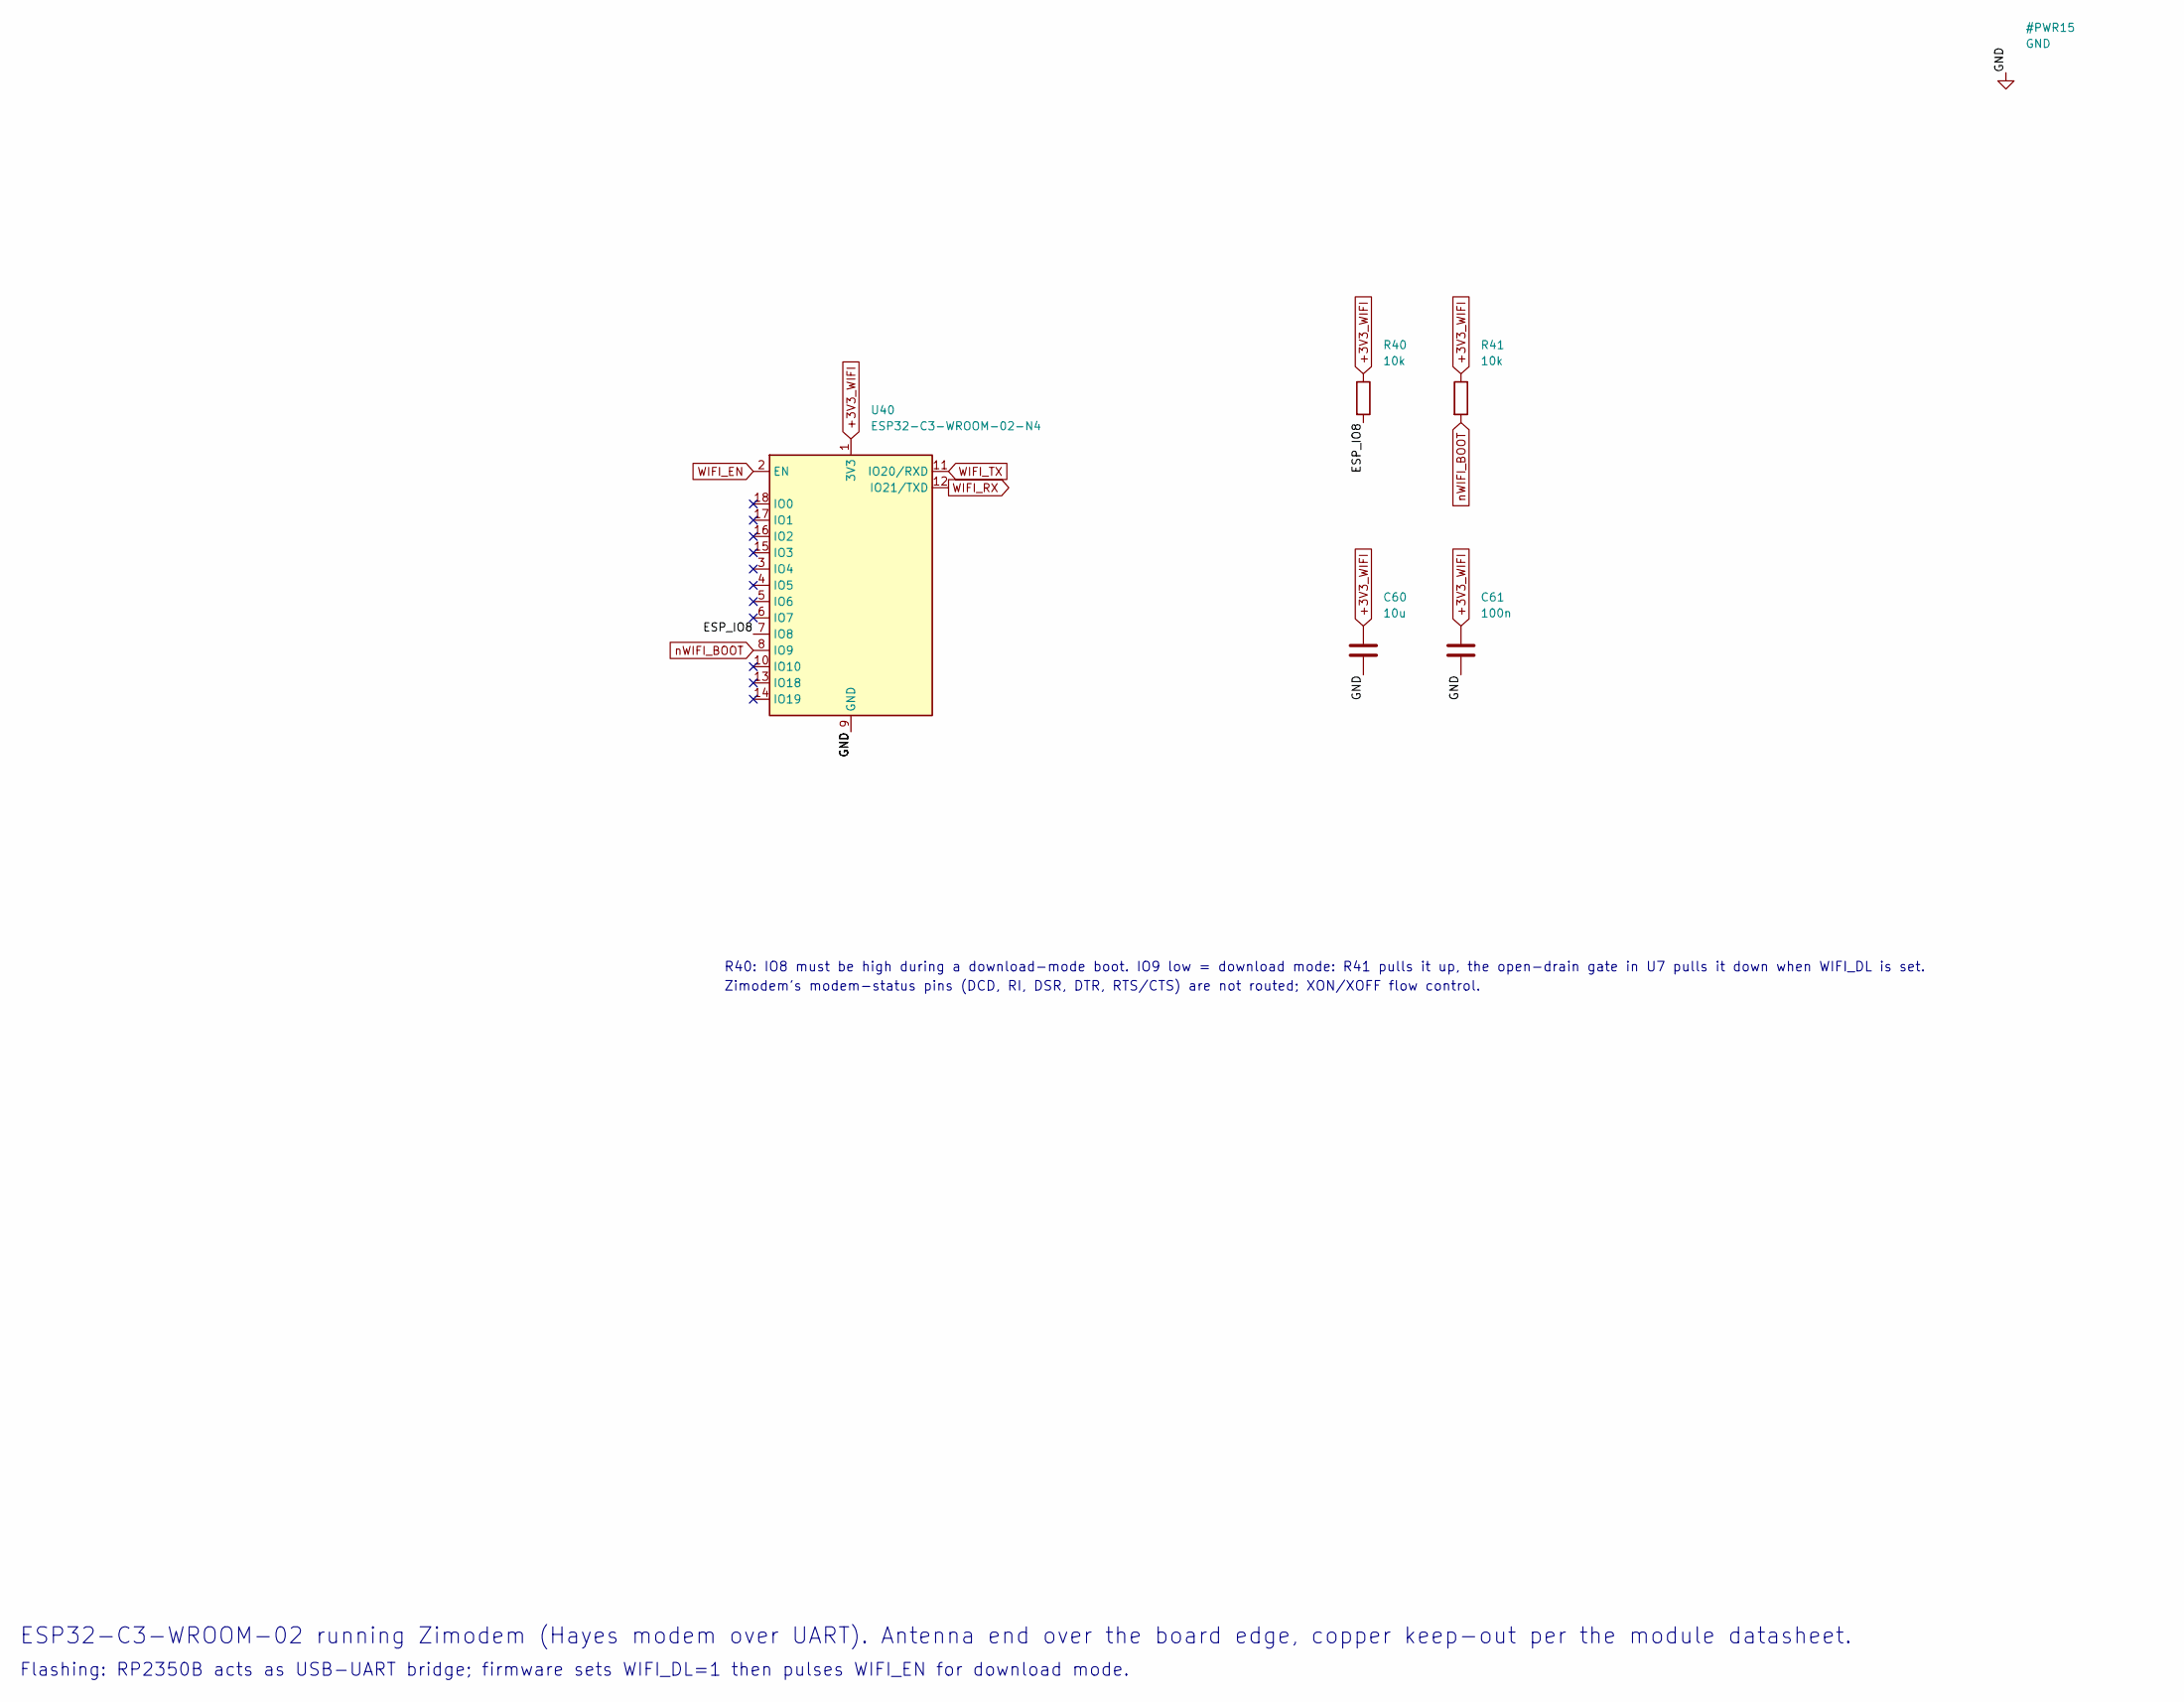
[picture p39: schematic wifi.kicad_sch, TS-Pico v3: WiFi]

Parts:
C60: 10u; C_0603_1608Metric; MPN CL10A106KP8NNNC; LCSC C19702
C61: 100n; C_0603_1608Metric; MPN CC0603KRX7R9BB104; LCSC C14663
R40, R41: 10k; R_0603_1608Metric; MPN 0603WAF1002T5E; LCSC C25804
U40: ESP32-C3-WROOM-02-N4; ESP32-C3-WROOM-02; MPN ESP32-C3-WROOM-02-N4; LCSC C2934560

Connections:
+3V3_WIFI: C60.1, C61.1, R40.1, R41.1, U40.1 (3V3); also elsewhere on the board
/WiFi/ESP_IO8: R40.2, U40.7 (IO8)
GND: C60.2, C61.2, U40.9 (GND), U40.19 (GND); also elsewhere on the board
WIFI_EN: U40.2 (EN); also elsewhere on the board
WIFI_RX: U40.12 (IO21/TXD); also elsewhere on the board
WIFI_TX: U40.11 (IO20/RXD); also elsewhere on the board
nWIFI_BOOT: R41.2, U40.8 (IO9); also elsewhere on the board

Notes on the sheet:
ESP32-C3-WROOM-02 running Zimodem (Hayes modem over UART). Antenna end over the board edge, copper keep-out per the module datasheet.
Flashing: RP2350B acts as USB-UART bridge; firmware sets WIFI_DL=1 then pulses WIFI_EN for download mode.
R40: IO8 must be high during a download-mode boot. IO9 low = download mode: R41 pulls it up, the open-drain gate in U7 pulls it down when WIFI_DL is set.
Zimodem's modem-status pins (DCD, RI, DSR, DTR, RTS/CTS) are not routed; XON/XOFF flow control.

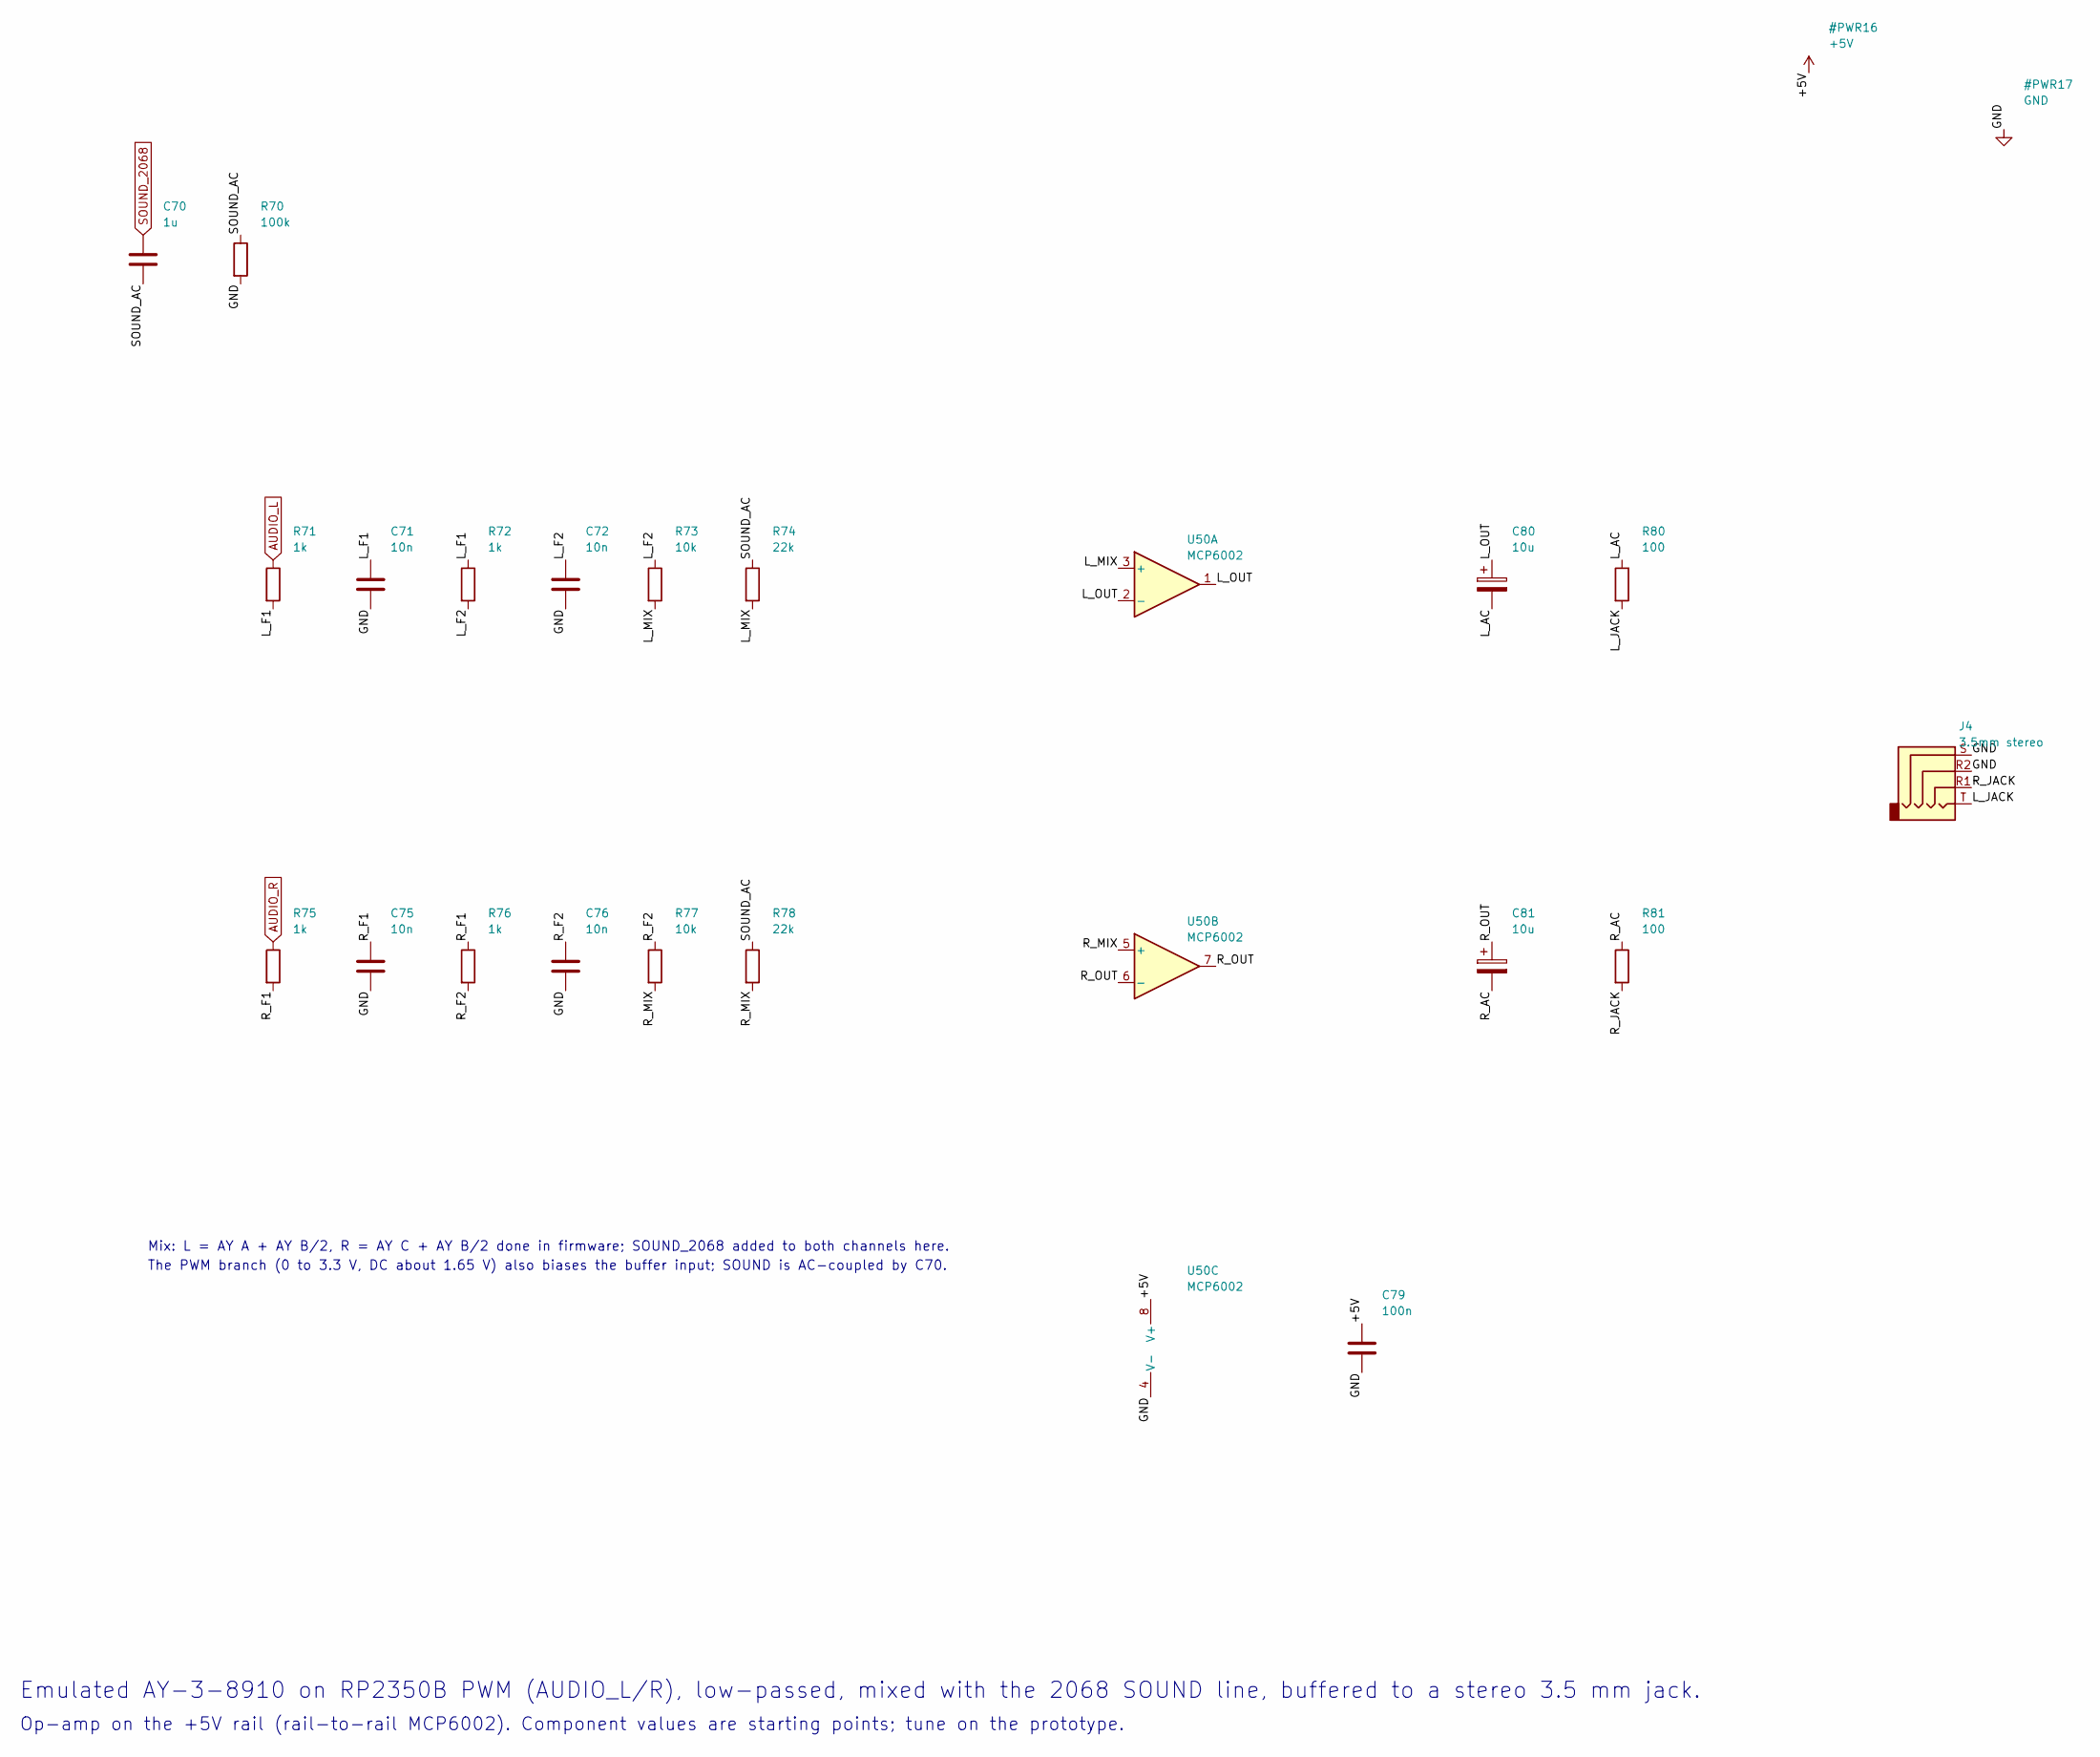
[picture p40: schematic audio.kicad_sch, TS-Pico v3: Audio]

Parts:
C70: 1u; C_0603_1608Metric; MPN CL10A105KB8NNNC; LCSC C15849
C71, C72, C75, C76: 10n; C_0603_1608Metric; MPN CL10B103KB8NNNC; LCSC C57112
C79: 100n; C_0603_1608Metric; MPN CC0603KRX7R9BB104; LCSC C14663
C80, C81: 10u; C_0603_1608Metric; MPN CL10A106KP8NNNC; LCSC C19702
J4: 3.5mm stereo; Jack_3.5mm_PJ320D_Horizontal; MPN PJ-320D; LCSC C431535
R70: 100k; R_0603_1608Metric; MPN 0603WAF1003T5E; LCSC C25803
R71, R72, R75, R76: 1k; R_0603_1608Metric; MPN 0603WAF1001T5E; LCSC C21190
R73, R77: 10k; R_0603_1608Metric; MPN 0603WAF1002T5E; LCSC C25804
R74, R78: 22k; R_0603_1608Metric; MPN 0603WAF2202T5E; LCSC C31850
R80, R81: 100; R_0603_1608Metric; MPN 0603WAF1000T5E; LCSC C22775
U50: MCP6002; SOIC-8_3.9x4.9mm_P1.27mm; MPN MCP6002T-I/SN; LCSC C7377

Connections:
+5V: C79.1, U50.8 (V+); also elsewhere on the board
/Audio/L_AC: C80.2, R80.1
/Audio/L_F1: C71.1, R71.2, R72.1
/Audio/L_F2: C72.1, R72.2, R73.1
/Audio/L_JACK: J4.T, R80.2
/Audio/L_MIX: R73.2, R74.2, U50.3 (+)
/Audio/L_OUT: C80.1, U50.1, U50.2 (-)
/Audio/R_AC: C81.2, R81.1
/Audio/R_F1: C75.1, R75.2, R76.1
/Audio/R_F2: C76.1, R76.2, R77.1
/Audio/R_JACK: J4.R1, R81.2
/Audio/R_MIX: R77.2, R78.2, U50.5 (+)
/Audio/R_OUT: C81.1, U50.6 (-), U50.7
/Audio/SOUND_AC: C70.2, R70.1, R74.1, R78.1
AUDIO_L: R71.1; also elsewhere on the board
AUDIO_R: R75.1; also elsewhere on the board
GND: C71.2, C72.2, C75.2, C76.2, C79.2, J4.R2, J4.S, R70.2, U50.4 (V-); also elsewhere on the board
SOUND_2068: C70.1; also elsewhere on the board

Notes on the sheet:
Emulated AY-3-8910 on RP2350B PWM (AUDIO_L/R), low-passed, mixed with the 2068 SOUND line, buffered to a stereo 3.5 mm jack.
Op-amp on the +5V rail (rail-to-rail MCP6002). Component values are starting points; tune on the prototype.
Mix: L = AY A + AY B/2, R = AY C + AY B/2 done in firmware; SOUND_2068 added to both channels here.
The PWM branch (0 to 3.3 V, DC about 1.65 V) also biases the buffer input; SOUND is AC-coupled by C70.

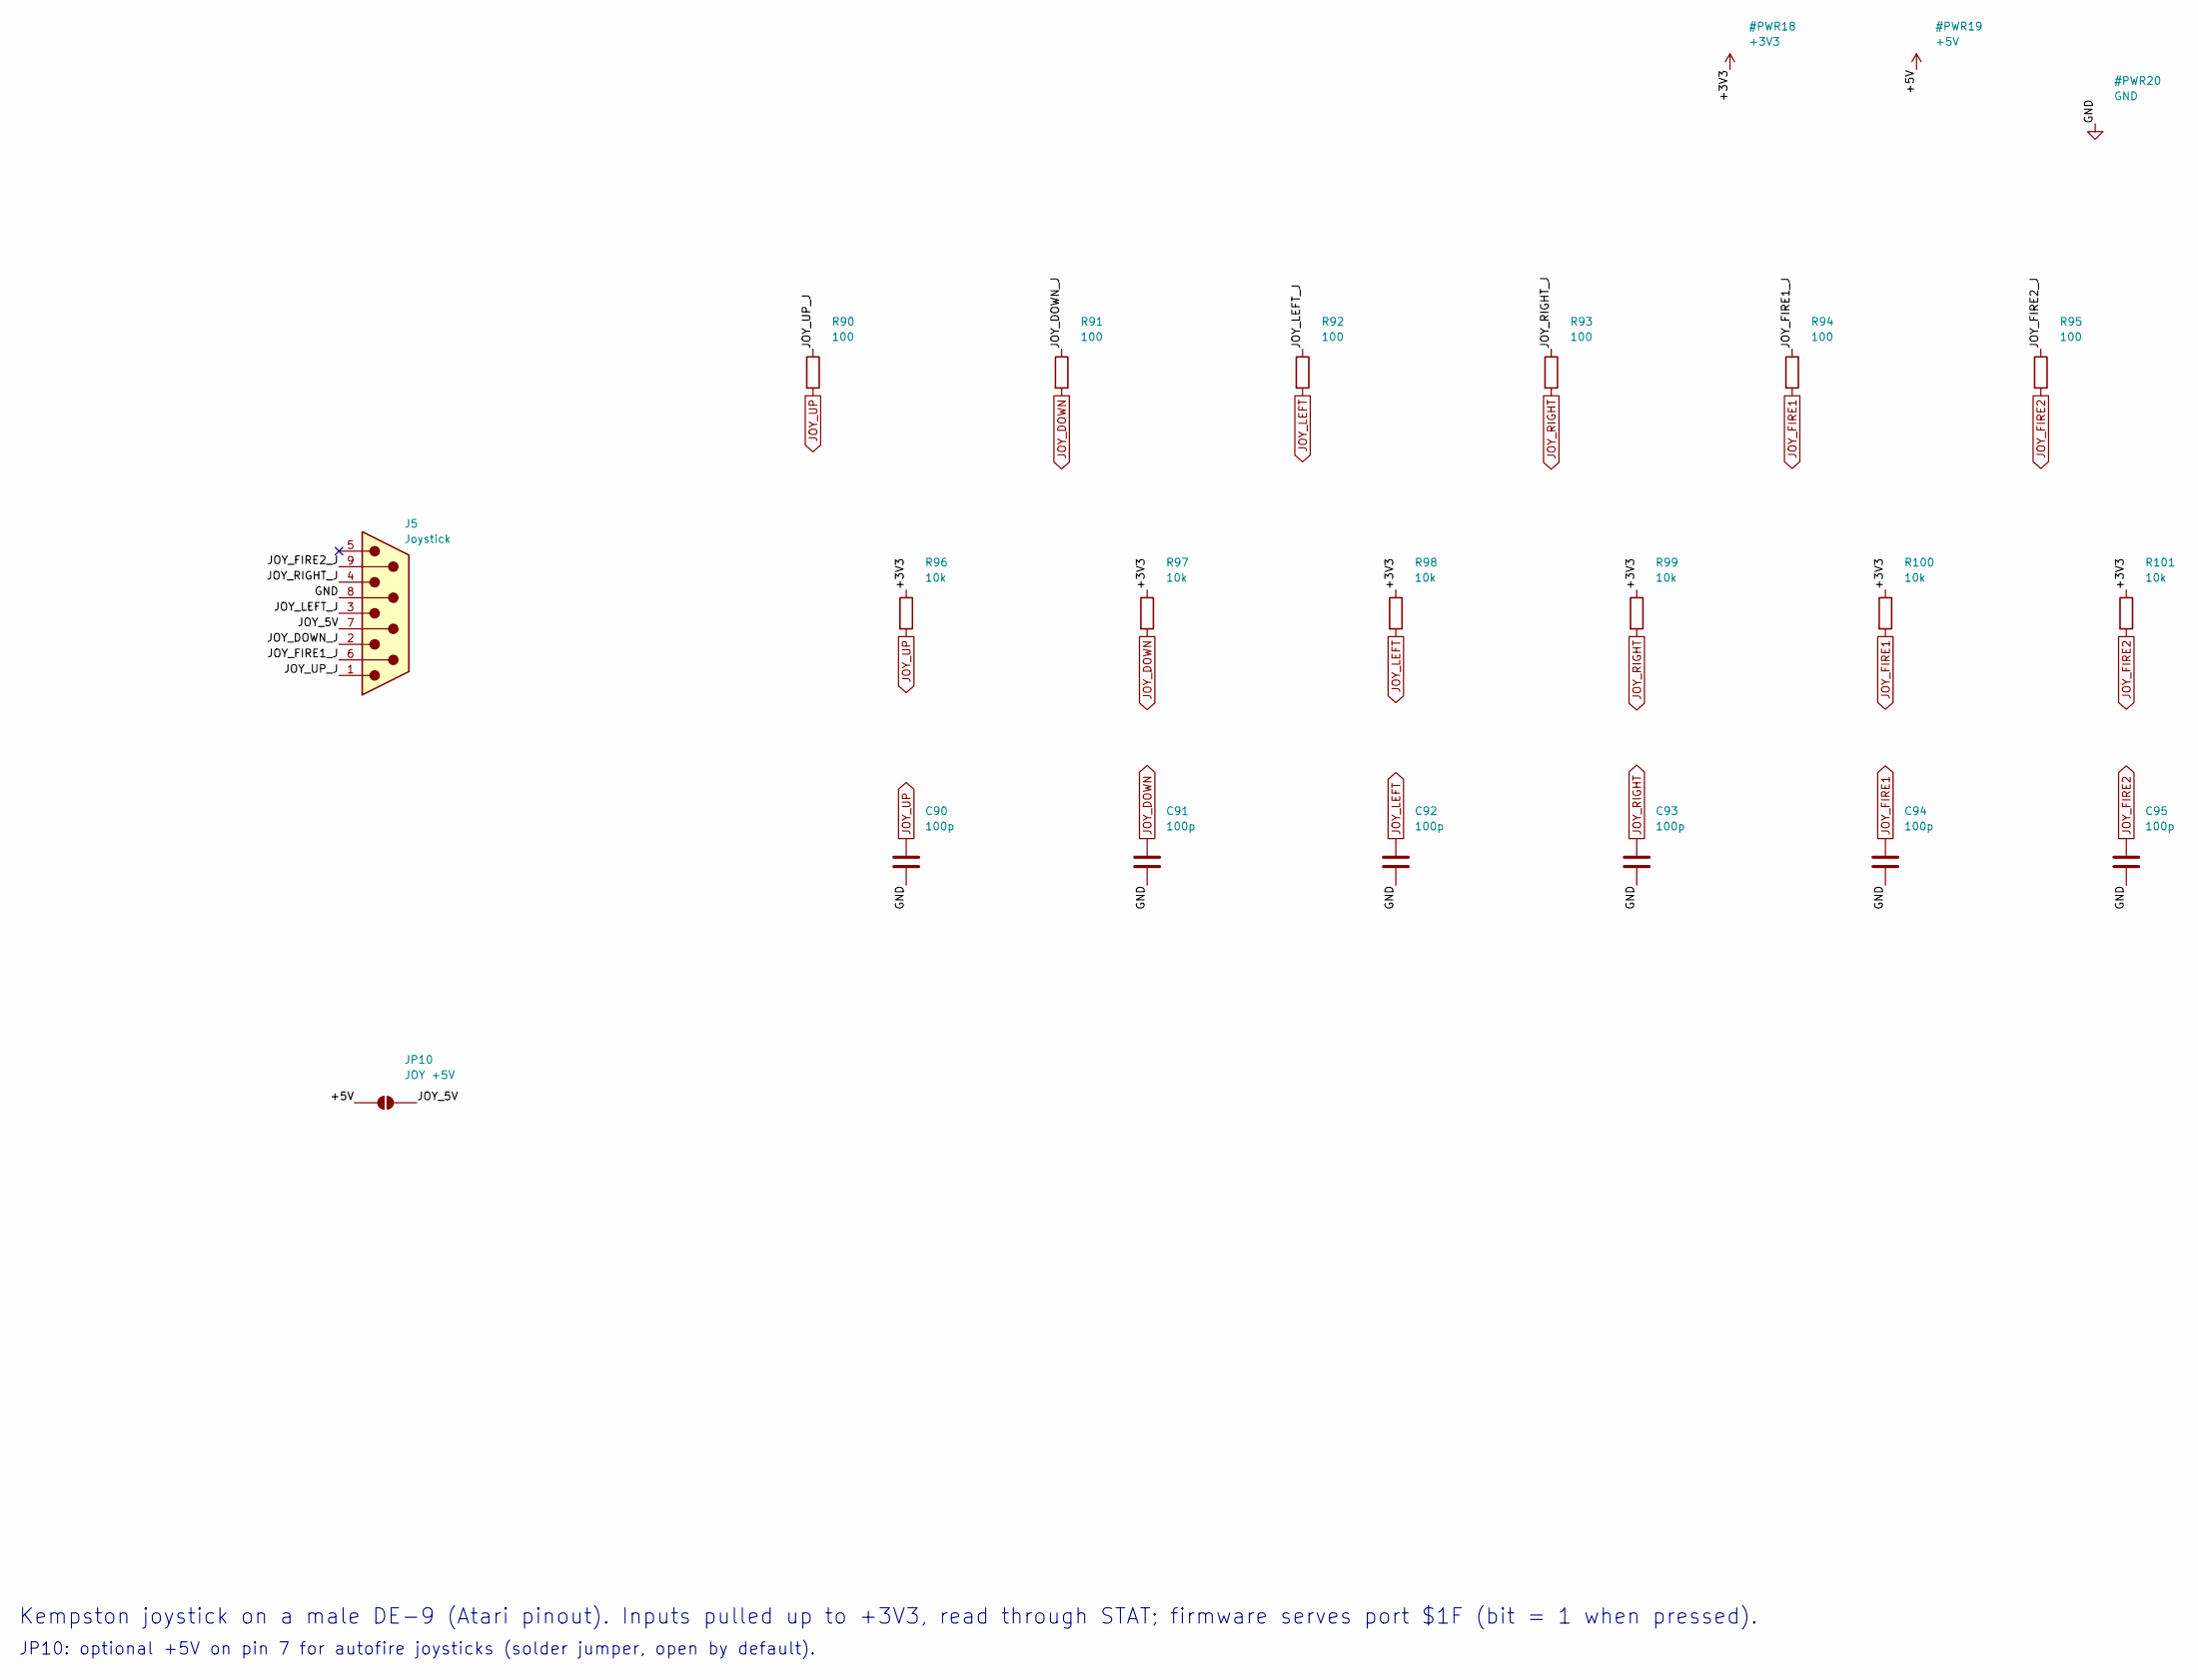
[picture p41: schematic joystick.kicad_sch, TS-Pico v3: Joystick]

Parts:
C90, C91, C92, C93, C94, C95: 100p; C_0603_1608Metric; MPN CL10C101JB8NNNC; LCSC C14858
J5: Joystick; DSUB-9_Pins_Horizontal_P2.77x2.84mm_EdgePinOffset7.70mm_Hou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; MPN DS1037-09MNAKT74-0CC; LCSC C75750
JP10: JOY +5V; SolderJumper-2_P1.3mm_Open_RoundedPad1.0x1.5mm
R90, R91, R92, R93, R94, R95: 100; R_0603_1608Metric; MPN 0603WAF1000T5E; LCSC C22775
R96, R97, R98, R99, R100, R101: 10k; R_0603_1608Metric; MPN 0603WAF1002T5E; LCSC C25804

Connections:
+3V3: R96.1, R97.1, R98.1, R99.1, R100.1, R101.1; also elsewhere on the board
+5V: JP10.1 (A); also elsewhere on the board
/Joystick/JOY_5V: J5.7, JP10.2 (B)
/Joystick/JOY_DOWN_J: J5.2, R91.1
/Joystick/JOY_FIRE1_J: J5.6, R94.1
/Joystick/JOY_FIRE2_J: J5.9, R95.1
/Joystick/JOY_LEFT_J: J5.3, R92.1
/Joystick/JOY_RIGHT_J: J5.4, R93.1
/Joystick/JOY_UP_J: J5.1, R90.1
GND: C90.2, C91.2, C92.2, C93.2, C94.2, C95.2, J5.8; also elsewhere on the board
JOY_DOWN: C91.1, R91.2, R97.2; also elsewhere on the board
JOY_FIRE1: C94.1, R94.2, R100.2; also elsewhere on the board
JOY_FIRE2: C95.1, R95.2, R101.2; also elsewhere on the board
JOY_LEFT: C92.1, R92.2, R98.2; also elsewhere on the board
JOY_RIGHT: C93.1, R93.2, R99.2; also elsewhere on the board
JOY_UP: C90.1, R90.2, R96.2; also elsewhere on the board

Notes on the sheet:
Kempston joystick on a male DE-9 (Atari pinout). Inputs pulled up to +3V3, read through STAT; firmware serves port $1F (bit = 1 when pressed).
JP10: optional +5V on pin 7 for autofire joysticks (solder jumper, open by default).
