factus10/tspico-hardware/hardware/tspico-v3.kicad_pcb

## KiCad design hardware/tspico-v3.kicad_pcb (continued)

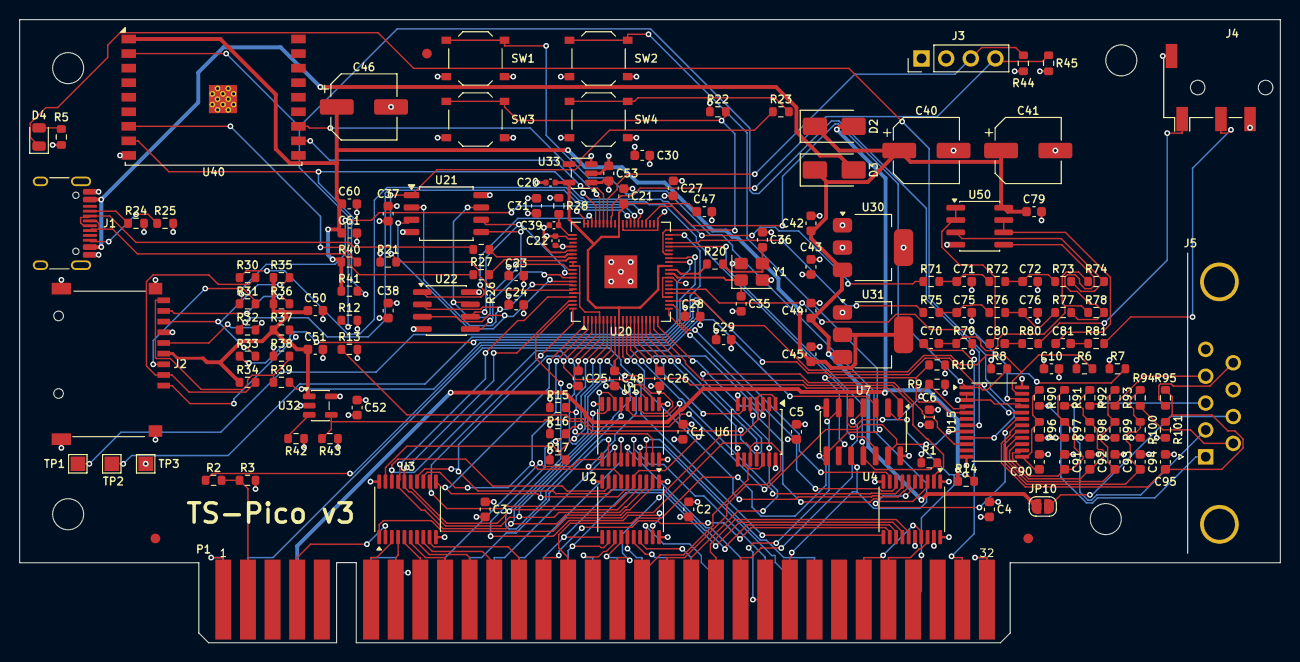
[picture p42: board tspico-v3.kicad_pcb from above]

Board: 4 copper layers, 130.0 x 64.2 mm, 157 parts (0 on the bottom side), 152 nets.

Other parts of the board:
FID1, FID2, FID3: Fiducial_1mm_Mask2mm
H1, H2, H3, H4: MountingHole_3.2mm_M3
