factus10/tspico-hardware/hardware-v2.6/tspico-v2.6.kicad_pcb

## KiCad design hardware-v2.6/tspico-v2.6.kicad_pcb (2026-10-19, an earlier design)

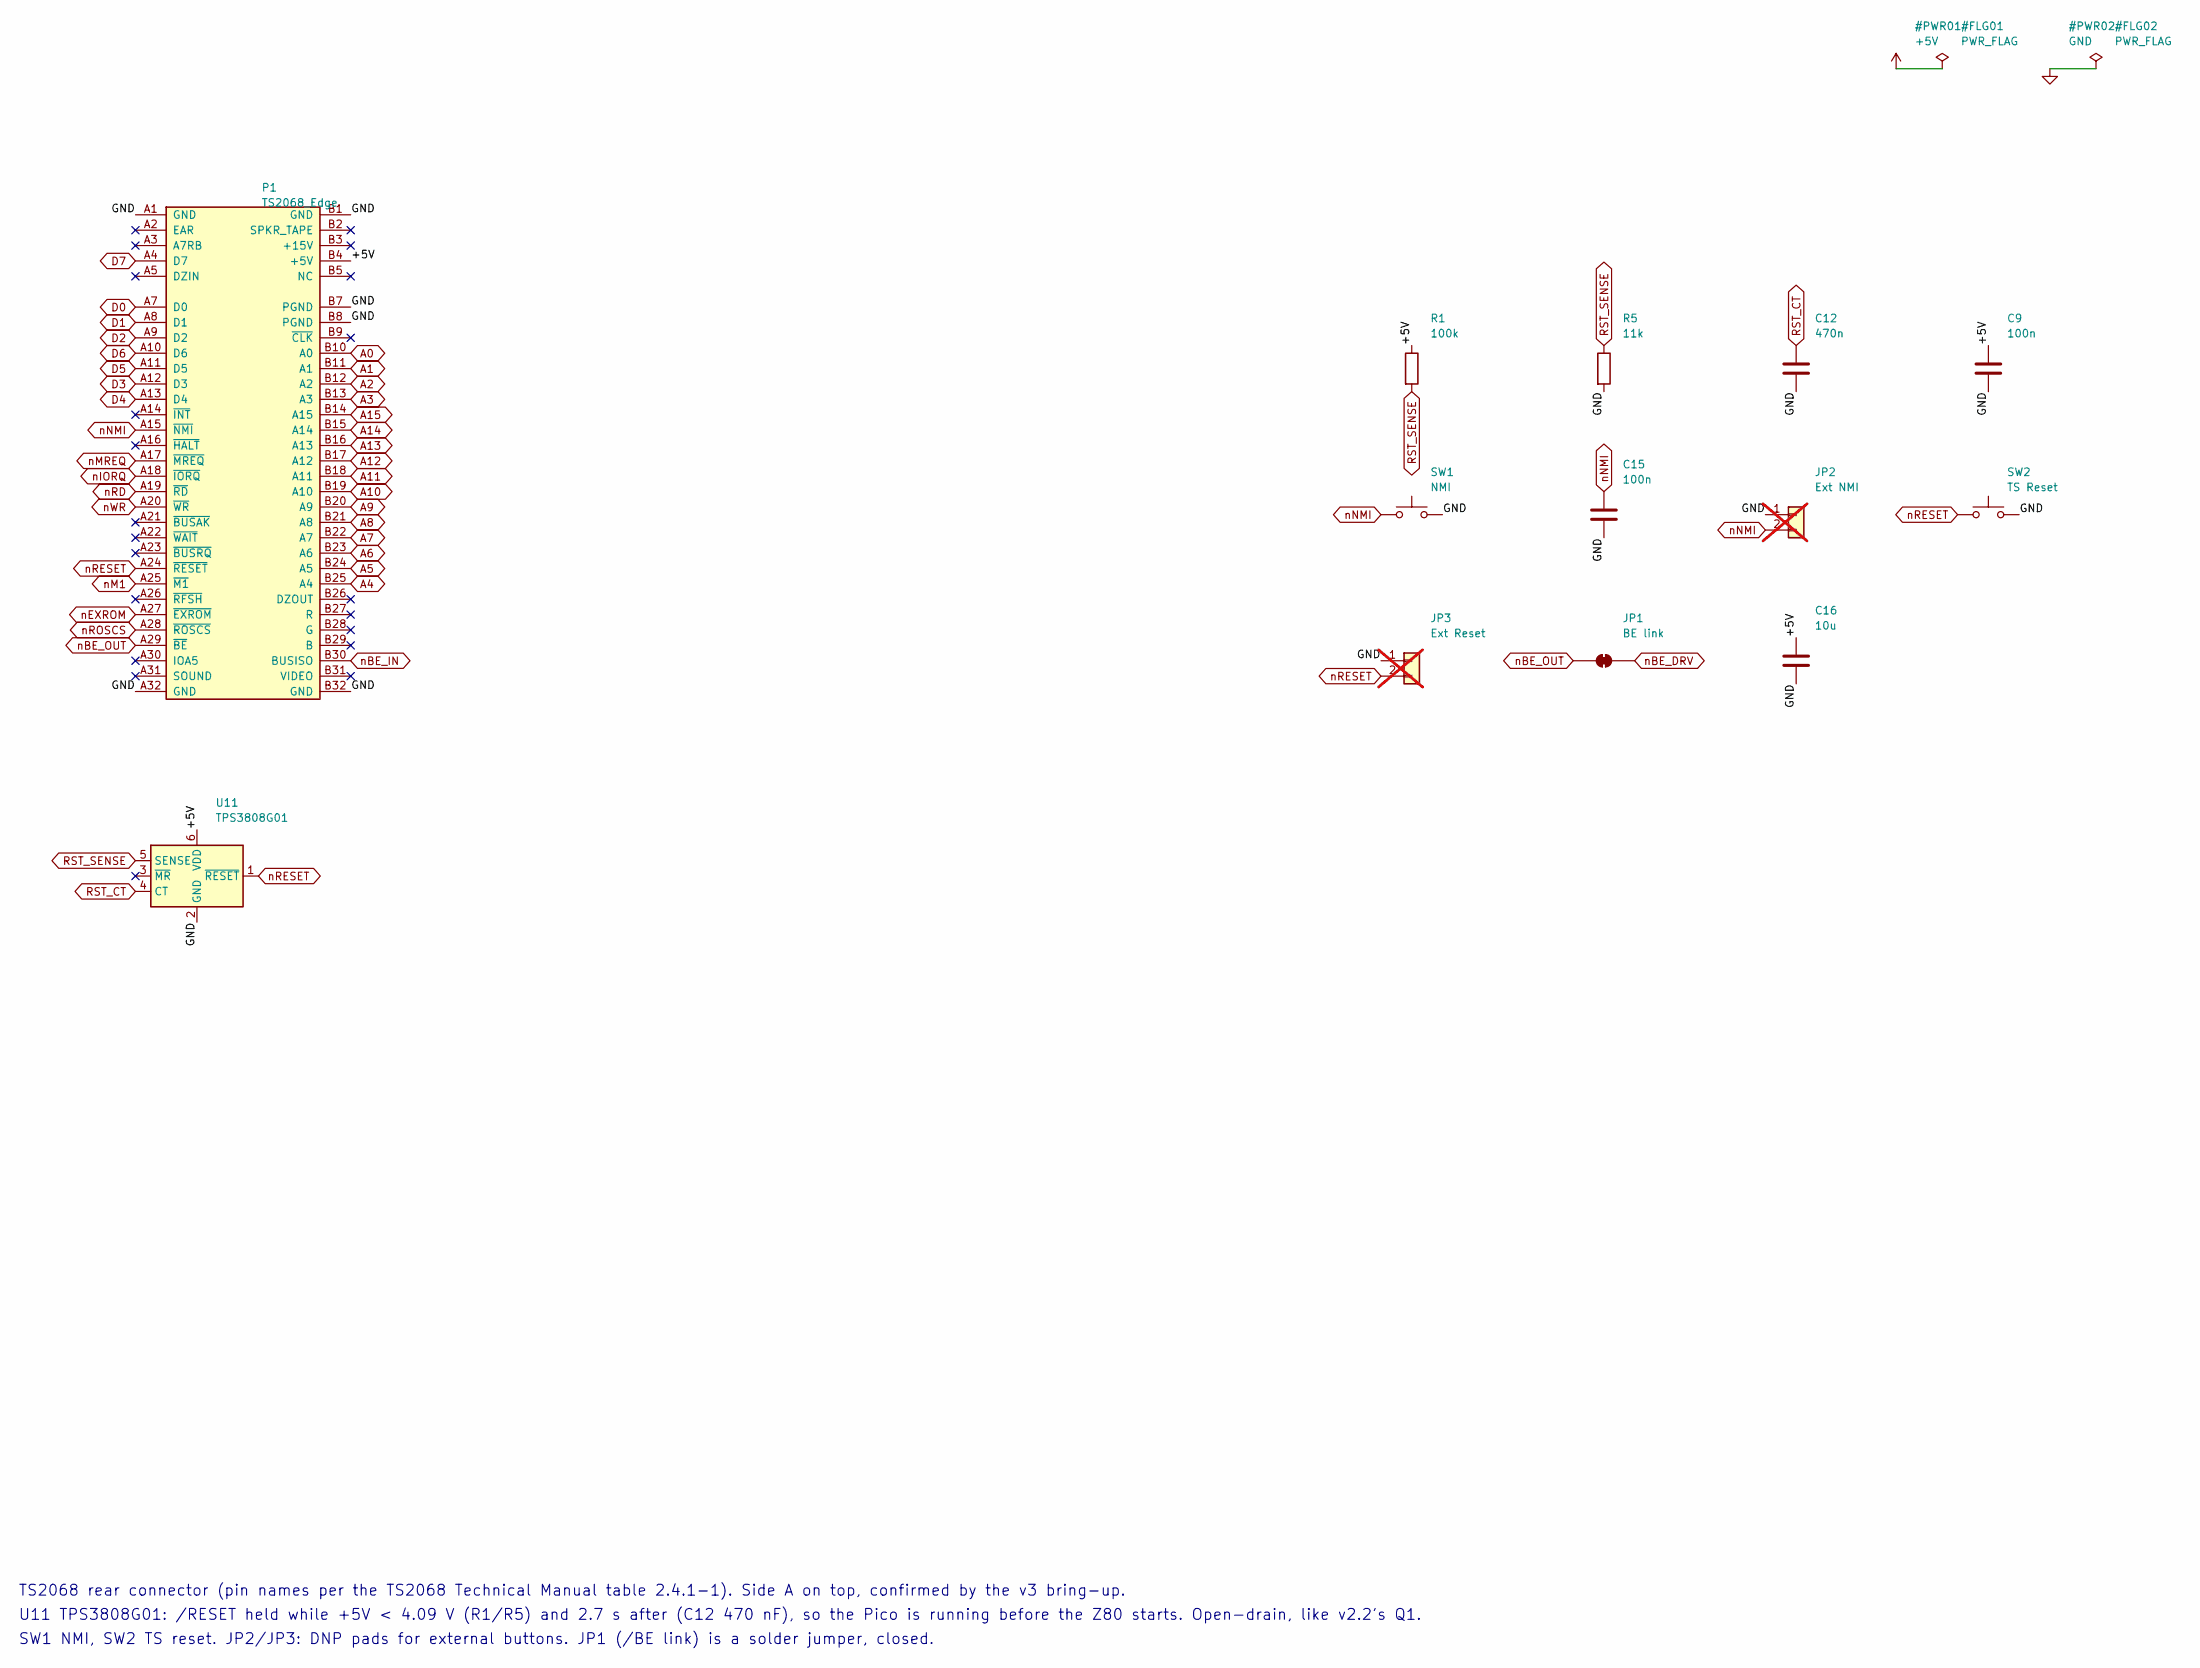
[picture p43: schematic interface.kicad_sch, TS-Pico v2.6: 2068 Interface and Reset]

Parts:
C9, C15: 100n; C_0603_1608Metric; MPN CC0603KRX7R9BB104; LCSC C14663
C12: 470n; C_0603_1608Metric; MPN CL10B474KA8NNNC; LCSC C1623
C16: 10u; C_0805_2012Metric; MPN CL21A106KAYNNNE; LCSC C15850
JP1: BE link; SolderJumper-2_P1.3mm_Bridged_RoundedPad1.0x1.5mm
JP2: Ext NMI; PinHeader_1x02_P2.54mm_Vertical_SMD_Pin1Left; not fitted
JP3: Ext Reset; PinHeader_1x02_P2.54mm_Vertical_SMD_Pin1Left; not fitted
P1: TS2068_Edge; TS2068_EdgeConnector_2x32
R1: 100k; R_0603_1608Metric; MPN 0603WAF1003T5E; LCSC C25803
R5: 11k; R_0603_1608Metric; MPN 0603WAF1102T5E; LCSC C25950
SW1: NMI; SW_Push_1P1T_XKB_TS-1187A; MPN TS-1187A-B-A-B; LCSC C318884
SW2: TS Reset; SW_Push_1P1T_XKB_TS-1187A; MPN TS-1187A-B-A-B; LCSC C318884
U11: TPS3808G01; SOT-23-6; MPN TPS3808G01DBVR; LCSC C19653

Connections:
+5V: C9.1, C16.1, P1.B4 (+5V), R1.1, U11.6 (VDD); also elsewhere on the board
A0: P1.B10 (A0); also elsewhere on the board
A1: P1.B11 (A1); also elsewhere on the board
A2: P1.B12 (A2); also elsewhere on the board
A3: P1.B13 (A3); also elsewhere on the board
A4: P1.B25 (A4); also elsewhere on the board
A5: P1.B24 (A5); also elsewhere on the board
A6: P1.B23 (A6); also elsewhere on the board
A7: P1.B22 (A7); also elsewhere on the board
A8: P1.B21 (A8); also elsewhere on the board
A9: P1.B20 (A9); also elsewhere on the board
A10: P1.B19 (A10); also elsewhere on the board
A11: P1.B18 (A11); also elsewhere on the board
A12: P1.B17 (A12); also elsewhere on the board
A13: P1.B16 (A13); also elsewhere on the board
A14: P1.B15 (A14); also elsewhere on the board
A15: P1.B14 (A15); also elsewhere on the board
D0: P1.A7 (D0); also elsewhere on the board
D1: P1.A8 (D1); also elsewhere on the board
D2: P1.A9 (D2); also elsewhere on the board
D3: P1.A12 (D3); also elsewhere on the board
D4: P1.A13 (D4); also elsewhere on the board
D5: P1.A11 (D5); also elsewhere on the board
D6: P1.A10 (D6); also elsewhere on the board
D7: P1.A4 (D7); also elsewhere on the board
GND: C9.2, C12.2, C15.2, C16.2, JP2.1, JP3.1, P1.A1 (GND), P1.A32 (GND), P1.B1 (GND), P1.B7 (PGND), P1.B8 (PGND), P1.B32 (GND), R5.2, SW1.2, SW2.2, U11.2 (GND); also elsewhere on the board
RST_CT: C12.1, U11.4 (CT)
RST_SENSE: R1.2, R5.1, U11.5 (SENSE)
nBE_DRV: JP1.2 (B); also elsewhere on the board
nBE_IN: P1.B30 (BUSISO); also elsewhere on the board
nBE_OUT: JP1.1 (A), P1.A29 (~BE)
nEXROM: P1.A27 (~EXROM); also elsewhere on the board
nIORQ: P1.A18 (~IORQ); also elsewhere on the board
nM1: P1.A25 (~M1); also elsewhere on the board
nMREQ: P1.A17 (~MREQ); also elsewhere on the board
nNMI: C15.1, JP2.2, P1.A15 (~NMI), SW1.1
nRD: P1.A19 (~RD); also elsewhere on the board
nRESET: JP3.2, P1.A24 (~RESET), SW2.1, U11.1 (~RESET)
nROSCS: P1.A28 (~ROSCS); also elsewhere on the board
nWR: P1.A20 (~WR); also elsewhere on the board

Notes on the sheet:
TS2068 rear connector (pin names per the TS2068 Technical Manual table 2.4.1-1). Side A on top, confirmed by the v3 bring-up.
U11 TPS3808G01: /RESET held while +5V < 4.09 V (R1/R5) and 2.7 s after (C12 470 nF), so the Pico is running before the Z80 starts. Open-drain, like v2.2's Q1.
SW1 NMI, SW2 TS reset. JP2/JP3: DNP pads for external buttons. JP1 (/BE link) is a solder jumper, closed.

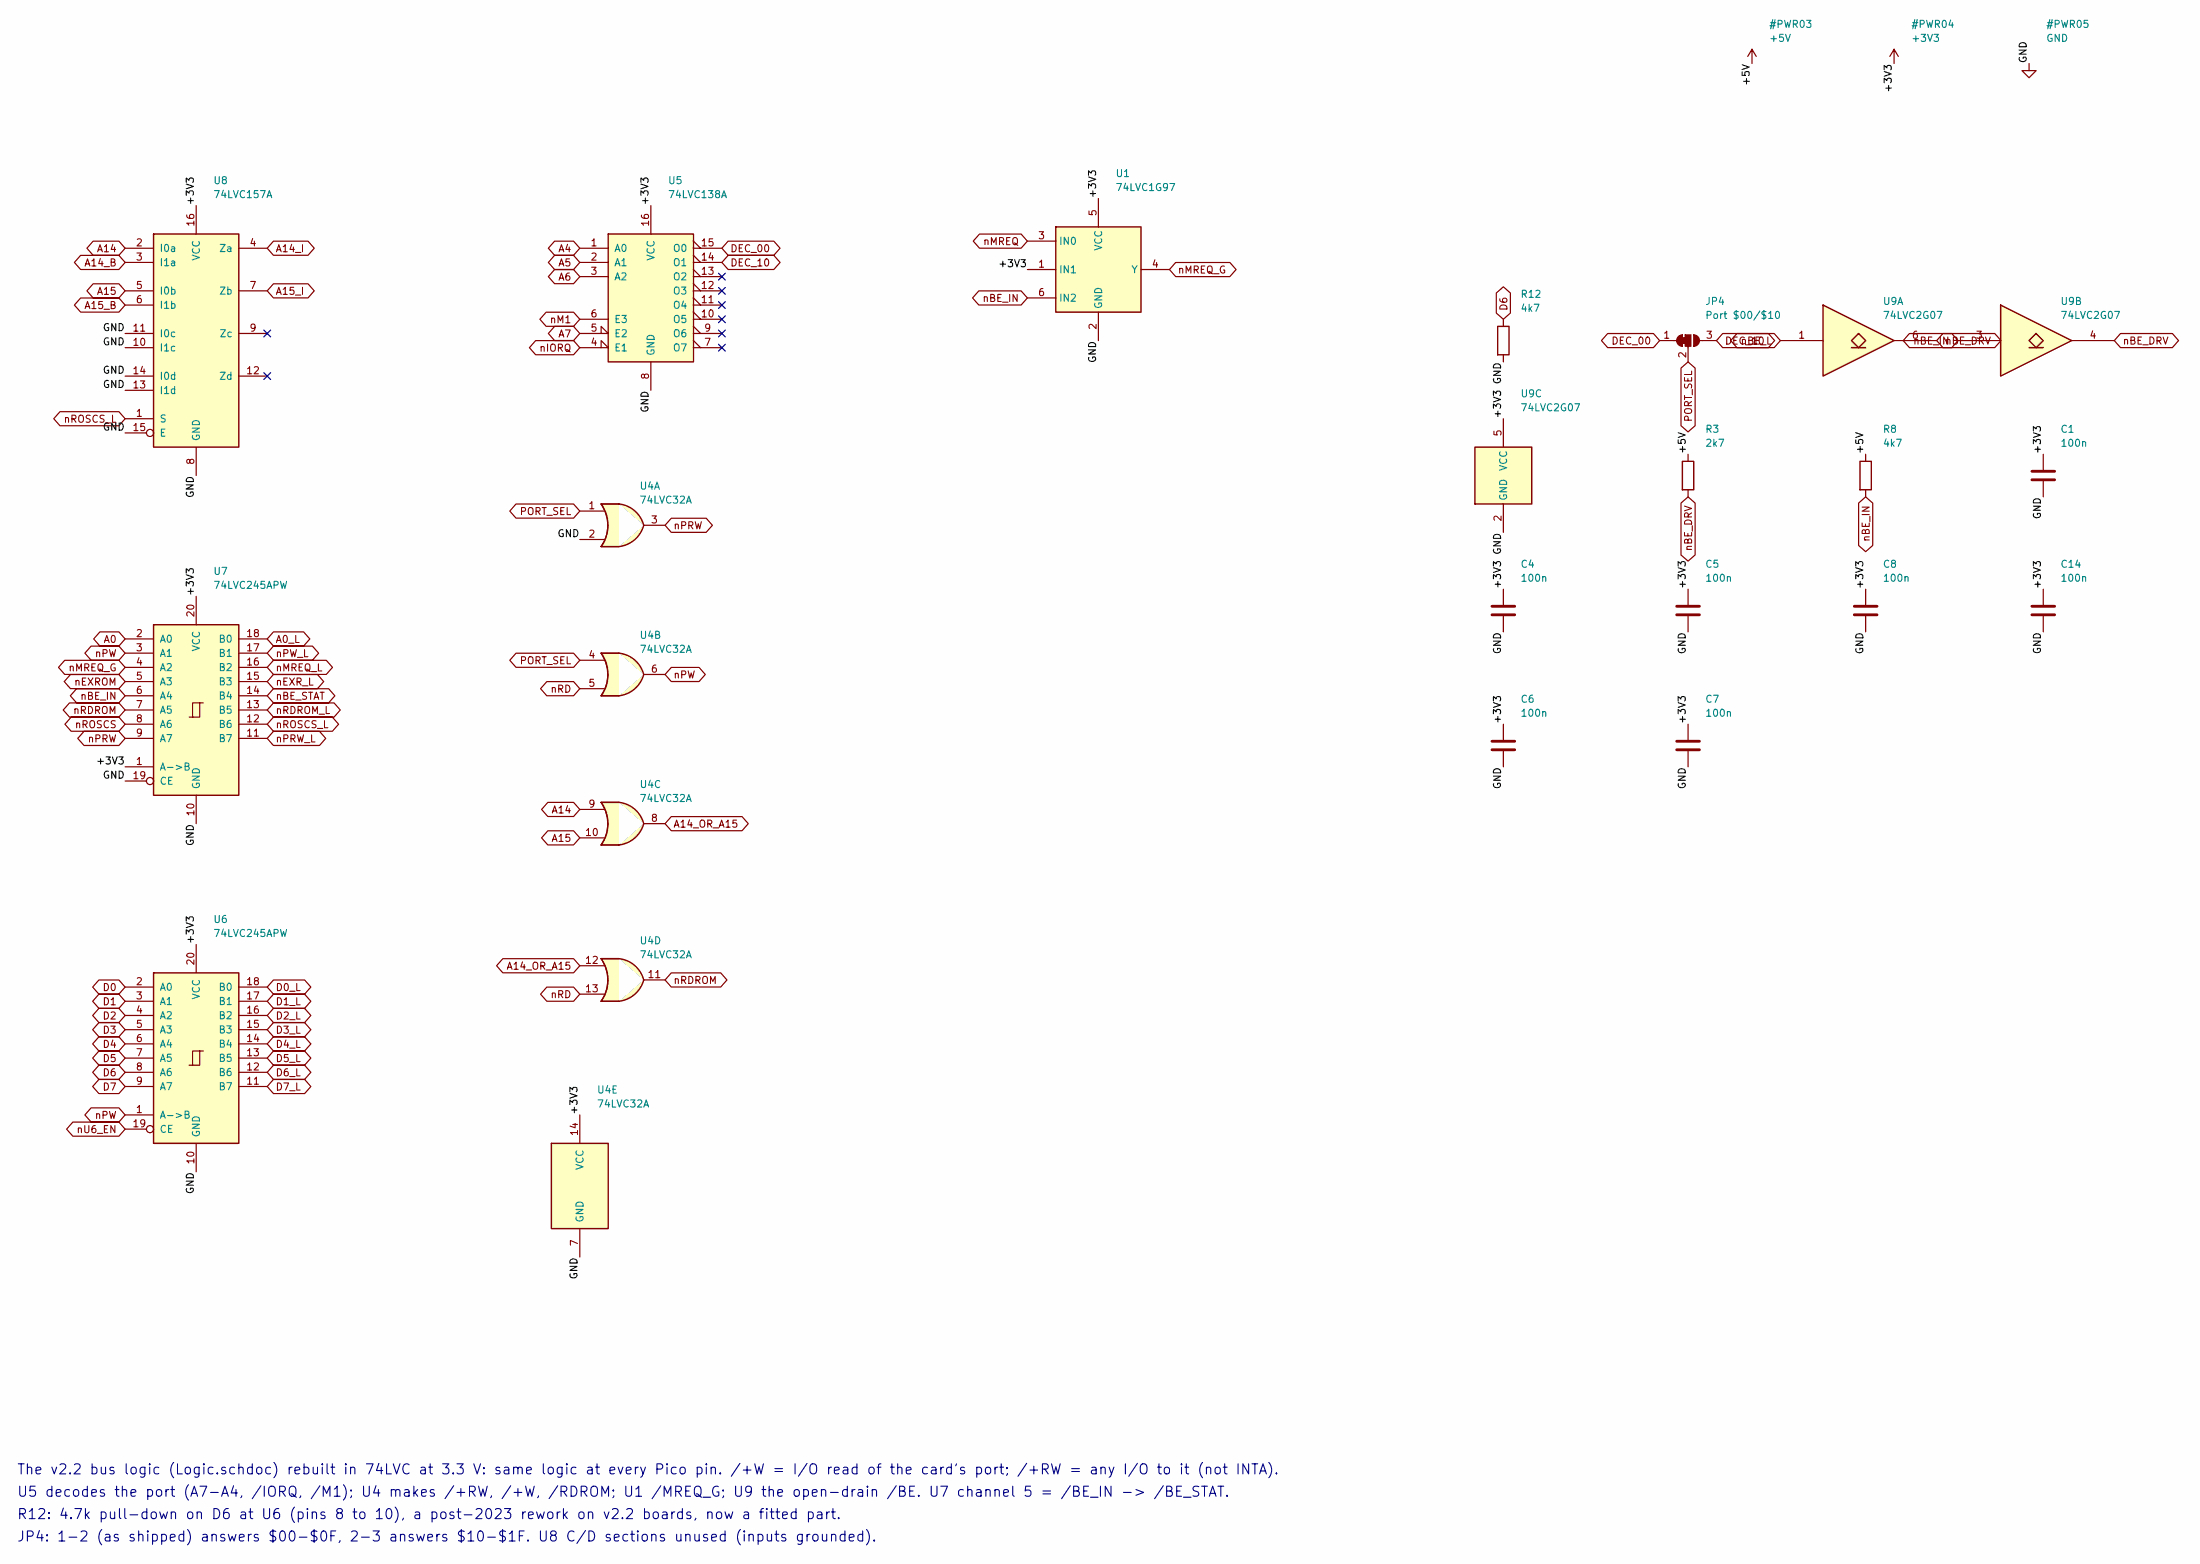
[picture p44: schematic logic.kicad_sch, TS-Pico v2.6: Bus Logic]

Parts:
C1, C4, C5, C6, C7, C8, C14: 100n; C_0603_1608Metric; MPN CC0603KRX7R9BB104; LCSC C14663
JP4: Port $00/$10; SolderJumper-3_P1.3mm_Bridged12_RoundedPad1.0x1.5mm_NumberL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
R3: 2k7; R_0603_1608Metric; MPN 0603WAF2701T5E; LCSC C13167
R8, R12: 4k7; R_0603_1608Metric; MPN 0603WAF4701T5E; LCSC C23162
U1: 74LVC1G97; SOT-23-6; MPN SN74LVC1G97DBVR; LCSC C128411
U4: 74LVC32A; TSSOP-14_4.4x5mm_P0.65mm; MPN 74LVC32APW,118; LCSC C6087
U5: 74LVC138A; TSSOP-16_4.4x5mm_P0.65mm; MPN SN74LVC138APWR; LCSC C485077
U6, U7: 74LVC245APW; TSSOP-20_4.4x6.5mm_P0.65mm; MPN 74LVC245APW,118; LCSC C6082
U8: 74LVC157A; TSSOP-16_4.4x5mm_P0.65mm; MPN SN74LVC157APWR; LCSC C406871
U9: 74LVC2G07; SOT-23-6; MPN 74LVC2G07GV; LCSC C19829597

Connections:
+3V3: C1.1, C4.1, C5.1, C6.1, C7.1, C8.1, C14.1, U1.1 (IN1), U1.5 (VCC), U4.14 (VCC), U5.16 (VCC), U6.20 (VCC), U7.1 (A->B), U7.20 (VCC), U8.16 (VCC), U9.5 (VCC); also elsewhere on the board
+5V: R3.1, R8.1; also elsewhere on the board
A0: U7.2 (A0); also elsewhere on the board
A0_L: U7.18 (B0); also elsewhere on the board
A4: U5.1 (A0); also elsewhere on the board
A5: U5.2 (A1); also elsewhere on the board
A6: U5.3 (A2); also elsewhere on the board
A7: U5.5 (E2); also elsewhere on the board
A14: U4.9, U8.2 (I0a); also elsewhere on the board
A14_B: U8.3 (I1a); also elsewhere on the board
A14_I: U8.4 (Za); also elsewhere on the board
A14_OR_A15: U4.8, U4.12
A15: U4.10, U8.5 (I0b); also elsewhere on the board
A15_B: U8.6 (I1b); also elsewhere on the board
A15_I: U8.7 (Zb); also elsewhere on the board
D0: U6.2 (A0); also elsewhere on the board
D0_L: U6.18 (B0); also elsewhere on the board
D1: U6.3 (A1); also elsewhere on the board
D1_L: U6.17 (B1); also elsewhere on the board
D2: U6.4 (A2); also elsewhere on the board
D2_L: U6.16 (B2); also elsewhere on the board
D3: U6.5 (A3); also elsewhere on the board
D3_L: U6.15 (B3); also elsewhere on the board
D4: U6.6 (A4); also elsewhere on the board
D4_L: U6.14 (B4); also elsewhere on the board
D5: U6.7 (A5); also elsewhere on the board
D5_L: U6.13 (B5); also elsewhere on the board
D6: R12.1, U6.8 (A6); also elsewhere on the board
D6_L: U6.12 (B6); also elsewhere on the board
D7: U6.9 (A7); also elsewhere on the board
D7_L: U6.11 (B7); also elsewhere on the board
DEC_00: JP4.1 (A), U5.15 (O0)
DEC_10: JP4.3 (B), U5.14 (O1)
GND: C1.2, C4.2, C5.2, C6.2, C7.2, C8.2, C14.2, R12.2, U1.2 (GND), U4.2, U4.7 (GND), U5.8 (GND), U6.10 (GND), U7.10 (GND), U7.19 (CE), U8.8 (GND), U8.10 (I1c), U8.11 (I0c), U8.13 (I1d), U8.14 (I0d), U8.15 (E), U9.2 (GND); also elsewhere on the board
PORT_SEL: JP4.2 (C), U4.1, U4.4
nBE_DRV: R3.2, U9.4, U9.6; also elsewhere on the board
nBE_IN: R8.2, U1.6 (IN2), U7.6 (A4), U9.3; also elsewhere on the board
nBE_L: U9.1; also elsewhere on the board
nBE_STAT: U7.14 (B4); also elsewhere on the board
nEXROM: U7.5 (A3); also elsewhere on the board
nEXR_L: U7.15 (B3); also elsewhere on the board
nIORQ: U5.4 (E1); also elsewhere on the board
nM1: U5.6 (E3); also elsewhere on the board
nMREQ: U1.3 (IN0); also elsewhere on the board
nMREQ_G: U1.4 (Y), U7.4 (A2)
nMREQ_L: U7.16 (B2); also elsewhere on the board
nPRW: U4.3, U7.9 (A7)
nPRW_L: U7.11 (B7); also elsewhere on the board
nPW: U4.6, U6.1 (A->B), U7.3 (A1)
nPW_L: U7.17 (B1); also elsewhere on the board
nRD: U4.5, U4.13; also elsewhere on the board
nRDROM: U4.11, U7.7 (A5)
nRDROM_L: U7.13 (B5); also elsewhere on the board
nROSCS: U7.8 (A6); also elsewhere on the board
nROSCS_L: U7.12 (B6), U8.1 (S); also elsewhere on the board
nU6_EN: U6.19 (CE); also elsewhere on the board

Notes on the sheet:
The v2.2 bus logic (Logic.schdoc) rebuilt in 74LVC at 3.3 V: same logic at every Pico pin. /+W = I/O read of the card's port; /+RW = any I/O to it (not INTA).
U5 decodes the port (A7-A4, /IORQ, /M1); U4 makes /+RW, /+W, /RDROM; U1 /MREQ_G; U9 the open-drain /BE. U7 channel 5 = /BE_IN -> /BE_STAT.
R12: 4.7k pull-down on D6 at U6 (pins 8 to 10), a post-2023 rework on v2.2 boards, now a fitted part.
JP4: 1-2 (as shipped) answers $00-$0F, 2-3 answers $10-$1F. U8 C/D sections unused (inputs grounded).

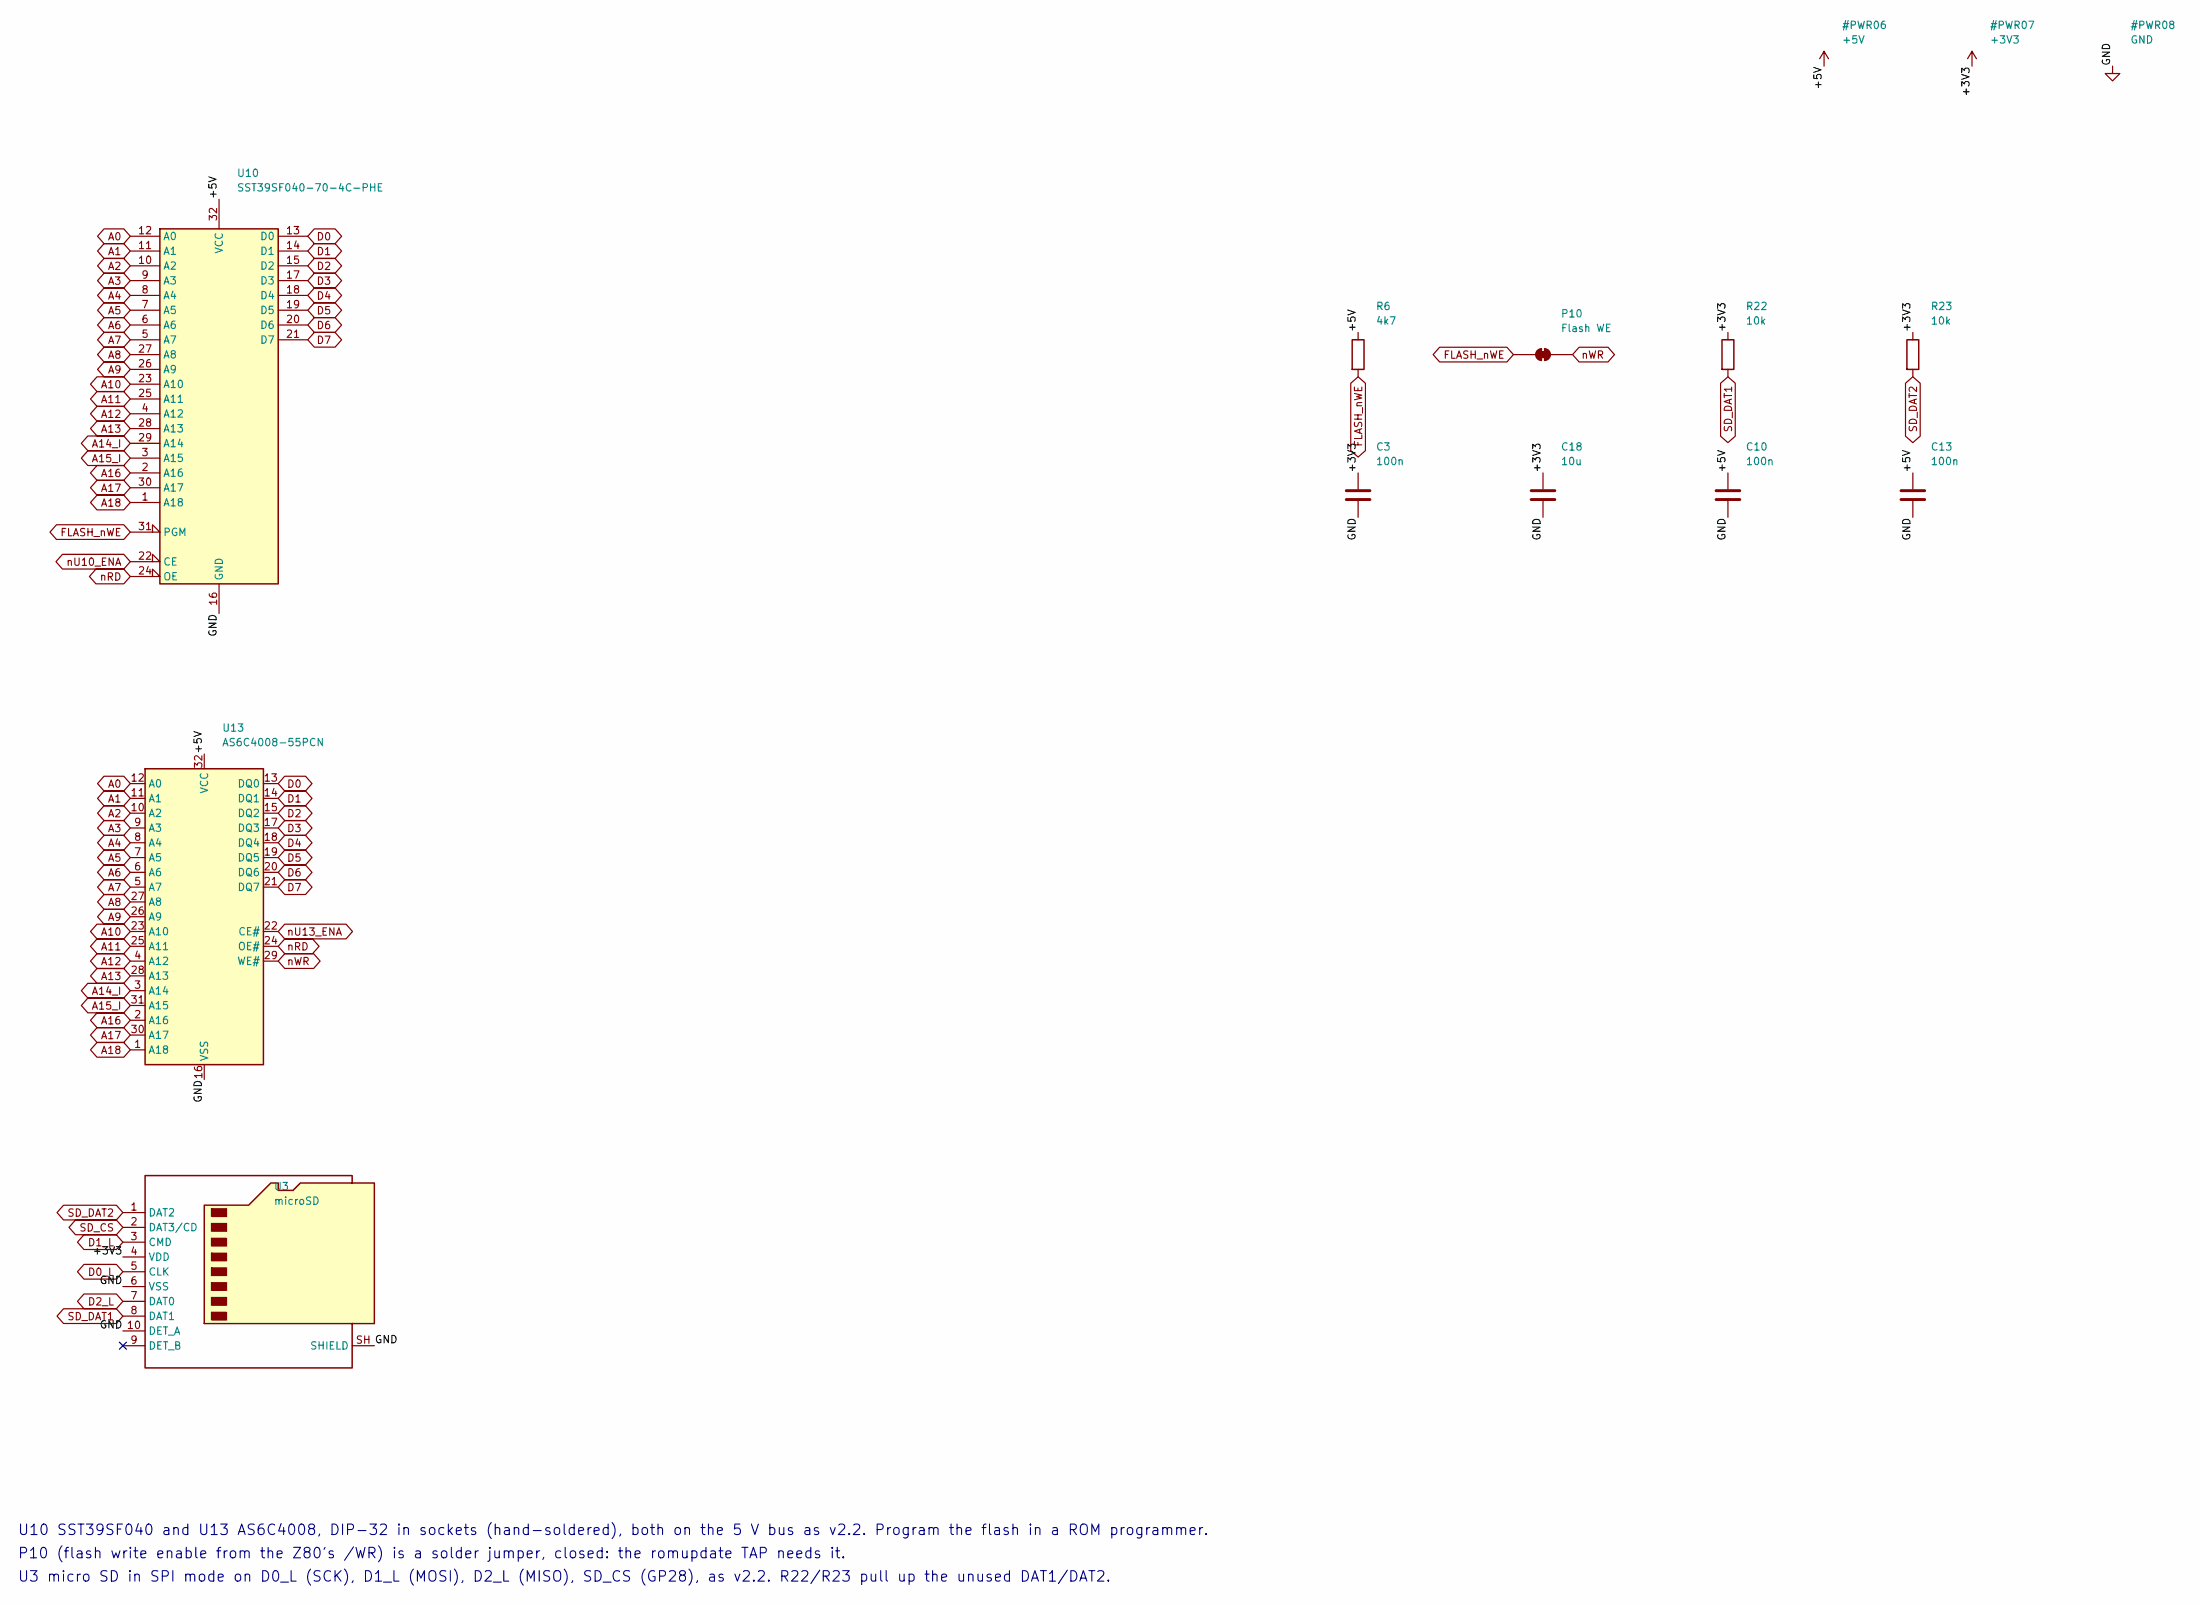
[picture p45: schematic memory.kicad_sch, TS-Pico v2.6: Memory and SD]

Parts:
C3, C10, C13: 100n; C_0603_1608Metric; MPN CC0603KRX7R9BB104; LCSC C14663
C18: 10u; C_0805_2012Metric; MPN CL21A106KAYNNNE; LCSC C15850
P10: Flash WE; SolderJumper-2_P1.3mm_Bridged_RoundedPad1.0x1.5mm
R6: 4k7; R_0603_1608Metric; MPN 0603WAF4701T5E; LCSC C23162
R22, R23: 10k; R_0603_1608Metric; MPN 0603WAF1002T5E; LCSC C25804
U3: microSD; microSD_TF-01A; MPN TF-01A; LCSC C91145
U10: SST39SF040-70-4C-PHE; DIP-32_W15.24mm_Socket
U13: AS6C4008-55PCN; DIP-32_W15.24mm_Socket

Connections:
+3V3: C3.1, C18.1, R22.1, R23.1, U3.4 (VDD); also elsewhere on the board
+5V: C10.1, C13.1, R6.1, U10.32 (VCC), U13.32 (VCC); also elsewhere on the board
A0: U10.12 (A0), U13.12 (A0); also elsewhere on the board
A1: U10.11 (A1), U13.11 (A1); also elsewhere on the board
A2: U10.10 (A2), U13.10 (A2); also elsewhere on the board
A3: U10.9 (A3), U13.9 (A3); also elsewhere on the board
A4: U10.8 (A4), U13.8 (A4); also elsewhere on the board
A5: U10.7 (A5), U13.7 (A5); also elsewhere on the board
A6: U10.6 (A6), U13.6 (A6); also elsewhere on the board
A7: U10.5 (A7), U13.5 (A7); also elsewhere on the board
A8: U10.27 (A8), U13.27 (A8); also elsewhere on the board
A9: U10.26 (A9), U13.26 (A9); also elsewhere on the board
A10: U10.23 (A10), U13.23 (A10); also elsewhere on the board
A11: U10.25 (A11), U13.25 (A11); also elsewhere on the board
A12: U10.4 (A12), U13.4 (A12); also elsewhere on the board
A13: U10.28 (A13), U13.28 (A13); also elsewhere on the board
A14_I: U10.29 (A14), U13.3 (A14); also elsewhere on the board
A15_I: U10.3 (A15), U13.31 (A15); also elsewhere on the board
A16: U10.2 (A16), U13.2 (A16); also elsewhere on the board
A17: U10.30 (A17), U13.30 (A17); also elsewhere on the board
A18: U10.1 (A18), U13.1 (A18); also elsewhere on the board
D0: U10.13 (D0), U13.13 (DQ0); also elsewhere on the board
D0_L: U3.5 (CLK); also elsewhere on the board
D1: U10.14 (D1), U13.14 (DQ1); also elsewhere on the board
D1_L: U3.3 (CMD); also elsewhere on the board
D2: U10.15 (D2), U13.15 (DQ2); also elsewhere on the board
D2_L: U3.7 (DAT0); also elsewhere on the board
D3: U10.17 (D3), U13.17 (DQ3); also elsewhere on the board
D4: U10.18 (D4), U13.18 (DQ4); also elsewhere on the board
D5: U10.19 (D5), U13.19 (DQ5); also elsewhere on the board
D6: U10.20 (D6), U13.20 (DQ6); also elsewhere on the board
D7: U10.21 (D7), U13.21 (DQ7); also elsewhere on the board
FLASH_nWE: P10.1 (A), R6.2, U10.31 (PGM)
GND: C3.2, C10.2, C13.2, C18.2, U3.6 (VSS), U3.10 (DET_A), U3.SH (SHIELD), U10.16 (GND), U13.16 (VSS); also elsewhere on the board
SD_CS: U3.2 (DAT3/CD); also elsewhere on the board
SD_DAT1: R22.2, U3.8 (DAT1)
SD_DAT2: R23.2, U3.1 (DAT2)
nRD: U10.24 (OE), U13.24 (OE#); also elsewhere on the board
nU10_ENA: U10.22 (CE); also elsewhere on the board
nU13_ENA: U13.22 (CE#); also elsewhere on the board
nWR: P10.2 (B), U13.29 (WE#); also elsewhere on the board

Notes on the sheet:
U10 SST39SF040 and U13 AS6C4008, DIP-32 in sockets (hand-soldered), both on the 5 V bus as v2.2. Program the flash in a ROM programmer.
P10 (flash write enable from the Z80's /WR) is a solder jumper, closed: the romupdate TAP needs it.
U3 micro SD in SPI mode on D0_L (SCK), D1_L (MOSI), D2_L (MISO), SD_CS (GP28), as v2.2. R22/R23 pull up the unused DAT1/DAT2.
