factus10/tspico-hardware/hardware-v2.6/tspico-v2.6.kicad_pcb

## KiCad design hardware-v2.6/tspico-v2.6.kicad_pcb (continued)

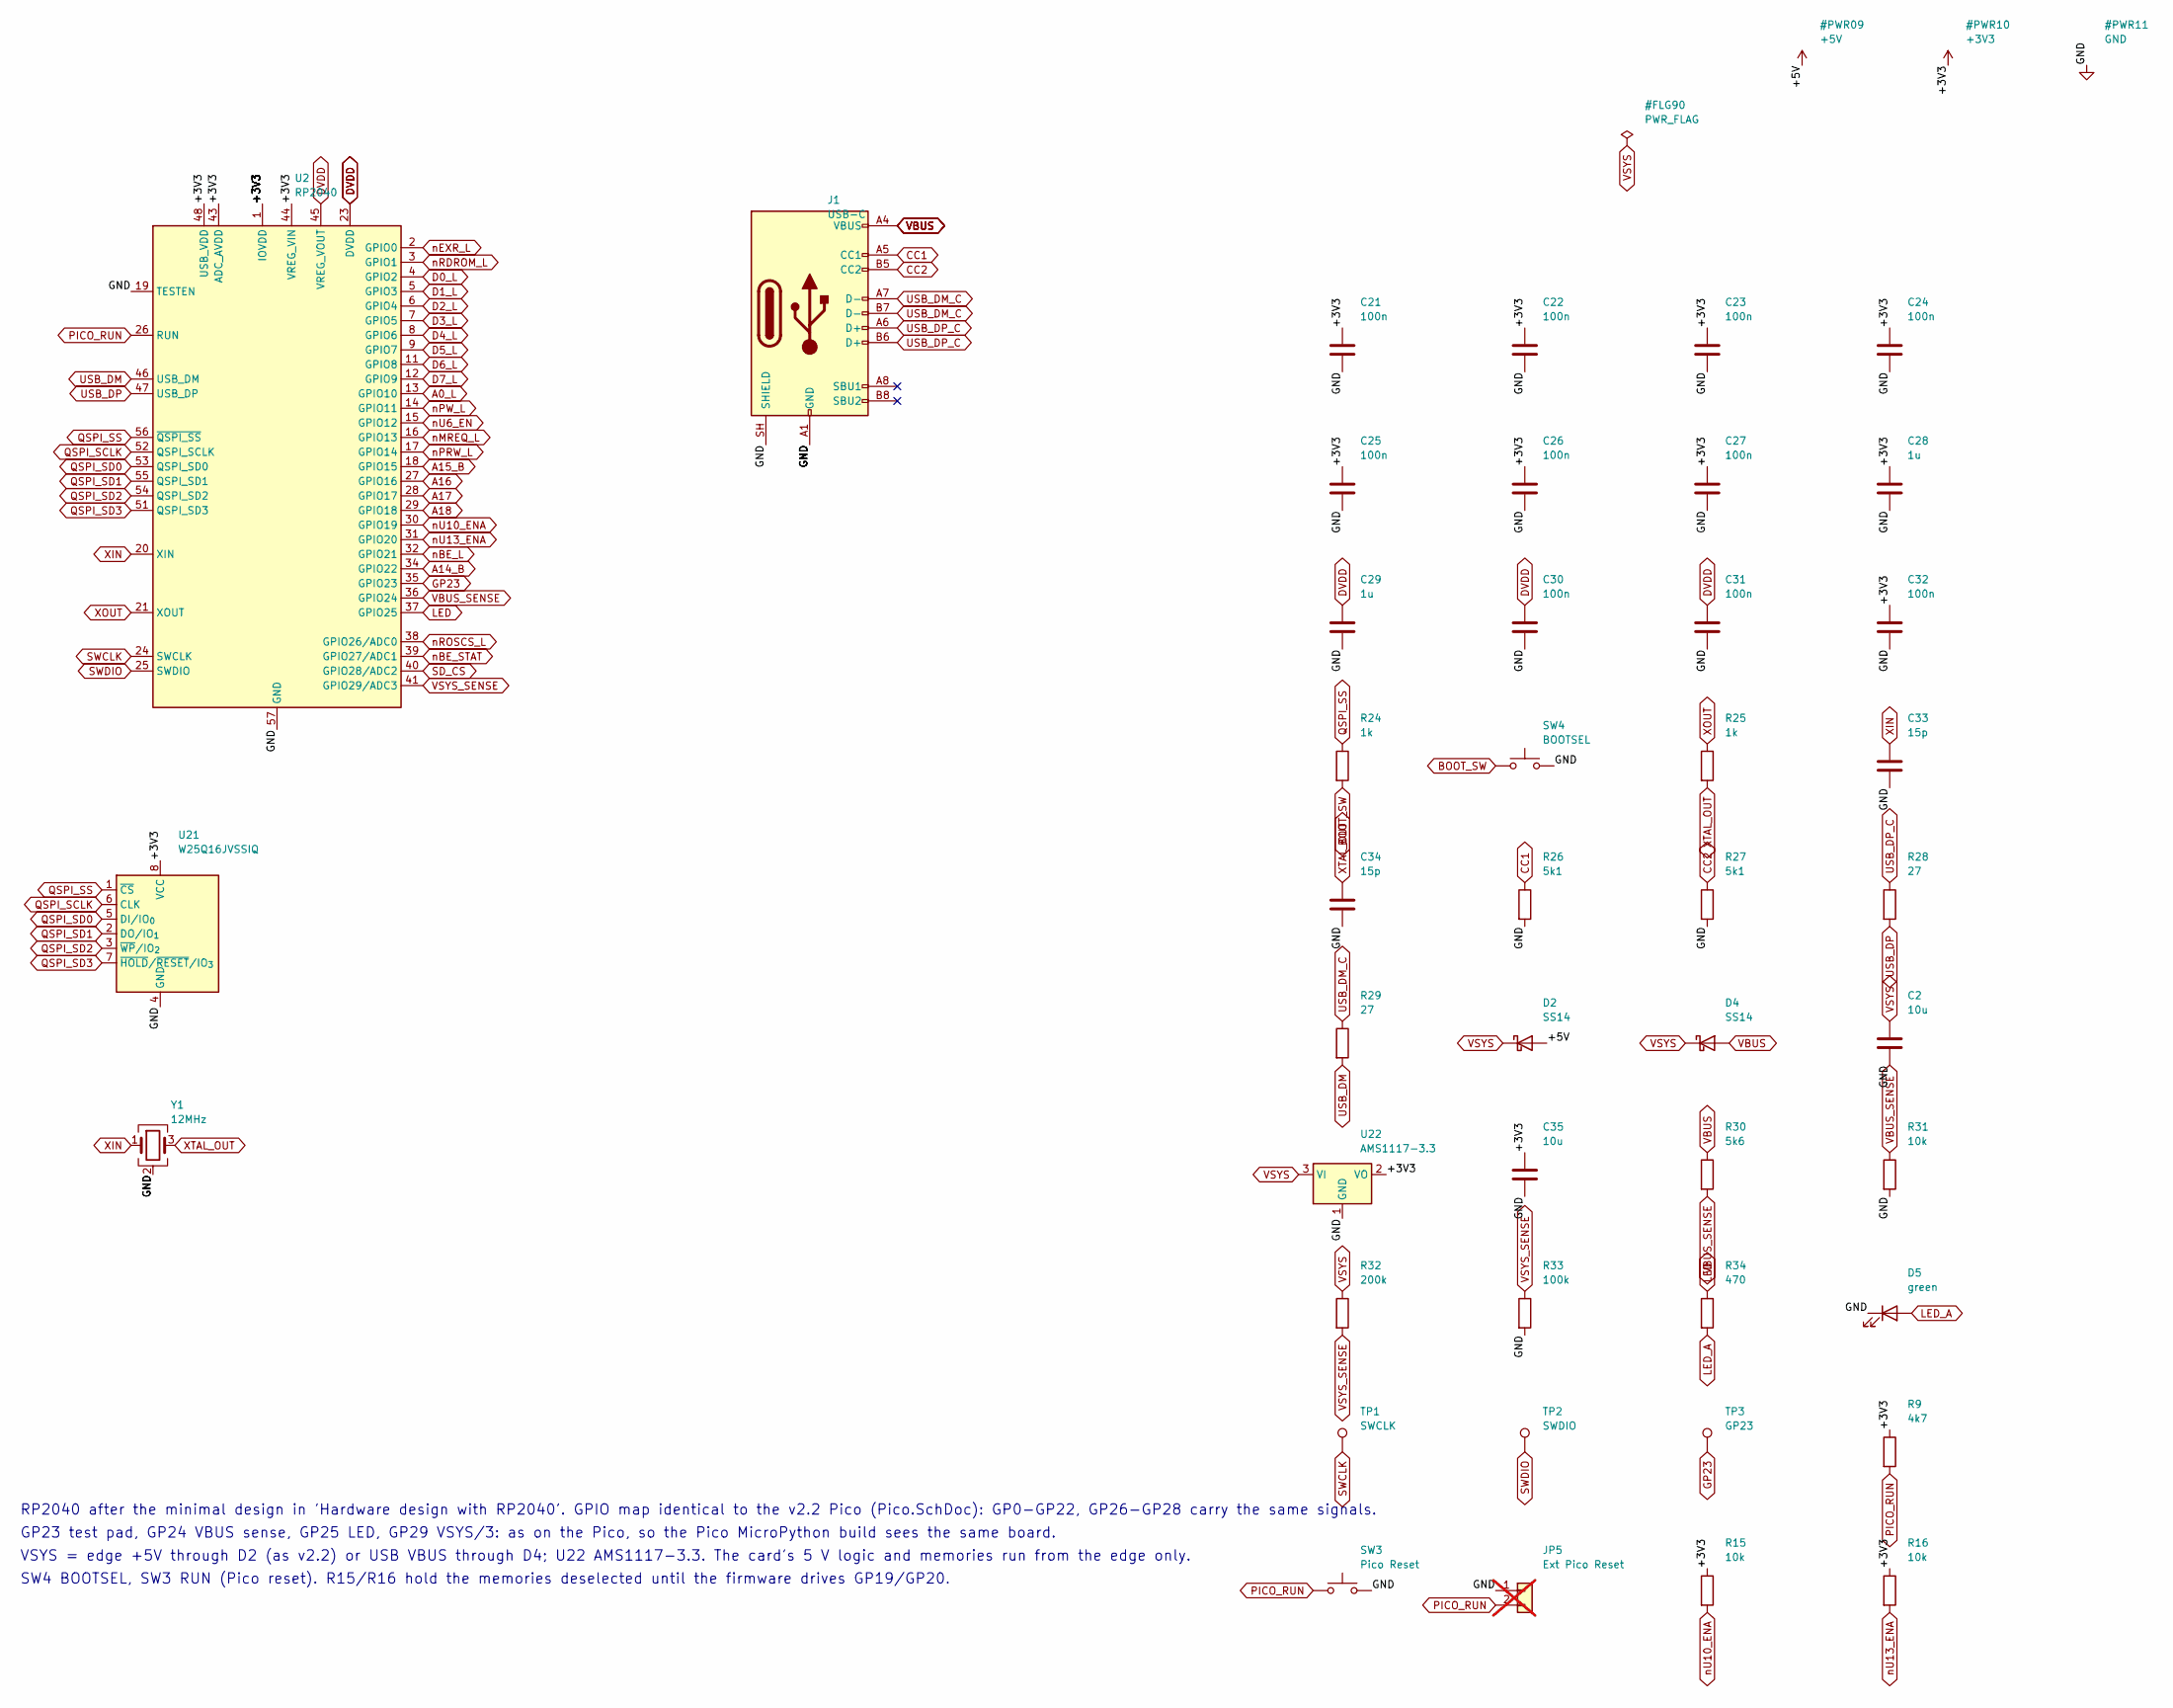
[picture p46: schematic mcu.kicad_sch, TS-Pico v2.6: RP2040]

Parts:
C2, C35: 10u; C_0805_2012Metric; MPN CL21A106KAYNNNE; LCSC C15850
C21, C22, C23, C24, C25, C26, C27, C30, C31, C32: 100n; C_0603_1608Metric; MPN CC0603KRX7R9BB104; LCSC C14663
C28, C29: 1u; C_0603_1608Metric; MPN CL10A105KB8NNNC; LCSC C15849
C33, C34: 15p; C_0603_1608Metric; MPN CL10C150JB8NNNC; LCSC C1644
D2, D4: SS14; D_SMA; MPN SS14; LCSC C2480
D5: green; LED_0805_2012Metric; MPN KT-0805G; LCSC C2297
J1: USB-C; USB_C_Receptacle_HRO_TYPE-C-31-M-12; MPN TYPE-C-31-M-12; LCSC C165948
JP5: Ext Pico Reset; PinHeader_1x02_P2.54mm_Vertical_SMD_Pin1Left; not fitted
R9: 4k7; R_0603_1608Metric; MPN 0603WAF4701T5E; LCSC C23162
R15, R16, R31: 10k; R_0603_1608Metric; MPN 0603WAF1002T5E; LCSC C25804
R24, R25: 1k; R_0603_1608Metric; MPN 0603WAF1001T5E; LCSC C21190
R26, R27: 5k1; R_0603_1608Metric; MPN 0603WAF5101T5E; LCSC C23186
R28, R29: 27; R_0603_1608Metric; MPN 0603WAF270JT5E; LCSC C25190
R30: 5k6; R_0603_1608Metric; MPN 0603WAF5601T5E; LCSC C23189
R32: 200k; R_0603_1608Metric; MPN 0603WAF2003T5E; LCSC C25811
R33: 100k; R_0603_1608Metric; MPN 0603WAF1003T5E; LCSC C25803
R34: 470; R_0603_1608Metric; MPN 0603WAF4700T5E; LCSC C23179
SW3: Pico Reset; SW_Push_1P1T_XKB_TS-1187A; MPN TS-1187A-B-A-B; LCSC C318884
SW4: BOOTSEL; SW_Push_1P1T_XKB_TS-1187A; MPN TS-1187A-B-A-B; LCSC C318884
TP1: SWCLK; TestPoint_Pad_D1.0mm
TP2: SWDIO; TestPoint_Pad_D1.0mm
TP3: GP23; TestPoint_Pad_D1.0mm
U2: RP2040; QFN-56-1EP_7x7mm_P0.4mm_EP3.2x3.2mm; MPN RP2040; LCSC C2040
U21: W25Q16JVSSIQ; SOIC-8_5.3x5.3mm_P1.27mm; MPN W25Q16JVSSIQ; LCSC C82317
U22: AMS1117-3.3; SOT-223-3_TabPin2; MPN AMS1117-3.3; LCSC C6186
Y1: 12MHz; Crystal_SMD_3225-4Pin_3.2x2.5mm; MPN ABM8-272-T3; LCSC C20625731

Connections:
+3V3: C21.1, C22.1, C23.1, C24.1, C25.1, C26.1, C27.1, C28.1, C32.1, C35.1, R9.1, R15.1, R16.1, U2.1 (IOVDD), U2.10 (IOVDD), U2.22 (IOVDD), U2.33 (IOVDD), U2.42 (IOVDD), U2.43 (ADC_AVDD), U2.44 (VREG_VIN), U2.48 (USB_VDD), U2.49 (IOVDD), U21.8 (VCC), U22.2 (VO); also elsewhere on the board
+5V: D2.2 (A); also elsewhere on the board
A0_L: U2.13 (GPIO10); also elsewhere on the board
A14_B: U2.34 (GPIO22); also elsewhere on the board
A15_B: U2.18 (GPIO15); also elsewhere on the board
A16: U2.27 (GPIO16); also elsewhere on the board
A17: U2.28 (GPIO17); also elsewhere on the board
A18: U2.29 (GPIO18); also elsewhere on the board
BOOT_SW: R24.2, SW4.1
CC1: J1.A5 (CC1), R26.1
CC2: J1.B5 (CC2), R27.1
D0_L: U2.4 (GPIO2); also elsewhere on the board
D1_L: U2.5 (GPIO3); also elsewhere on the board
D2_L: U2.6 (GPIO4); also elsewhere on the board
D3_L: U2.7 (GPIO5); also elsewhere on the board
D4_L: U2.8 (GPIO6); also elsewhere on the board
D5_L: U2.9 (GPIO7); also elsewhere on the board
D6_L: U2.11 (GPIO8); also elsewhere on the board
D7_L: U2.12 (GPIO9); also elsewhere on the board
DVDD: C29.1, C30.1, C31.1, U2.23 (DVDD), U2.45 (VREG_VOUT), U2.50 (DVDD)
GND: C2.2, C21.2, C22.2, C23.2, C24.2, C25.2, C26.2, C27.2, C28.2, C29.2, C30.2, C31.2, C32.2, C33.2, C34.2, C35.2, D5.1 (K), J1.A1 (GND), J1.A12 (GND), J1.B1 (GND), J1.B12 (GND), J1.SH (SHIELD), JP5.1, R26.2, R27.2, R31.2, R33.2, SW3.2, SW4.2, U2.19 (TESTEN), U2.57 (GND), U21.4 (GND), U22.1 (GND), Y1.2 (G), Y1.4 (G); also elsewhere on the board
GP23: TP3.1, U2.35 (GPIO23)
LED: R34.1, U2.37 (GPIO25)
LED_A: D5.2 (A), R34.2
PICO_RUN: JP5.2, R9.2, SW3.1, U2.26 (RUN)
QSPI_SCLK: U2.52 (QSPI_SCLK), U21.6 (CLK)
QSPI_SD0: U2.53 (QSPI_SD0), U21.5 (DI/IO_{0})
QSPI_SD1: U2.55 (QSPI_SD1), U21.2 (DO/IO_{1})
QSPI_SD2: U2.54 (QSPI_SD2), U21.3 (~WP/IO_{2})
QSPI_SD3: U2.51 (QSPI_SD3), U21.7 (~HOLD/~RESET/IO_{3})
QSPI_SS: R24.1, U2.56 (~QSPI_SS), U21.1 (~CS)
SD_CS: U2.40 (GPIO28/ADC2); also elsewhere on the board
SWCLK: TP1.1, U2.24 (SWCLK)
SWDIO: TP2.1, U2.25 (SWDIO)
USB_DM: R29.2, U2.46 (USB_DM)
USB_DM_C: J1.A7 (D-), J1.B7 (D-), R29.1
USB_DP: R28.2, U2.47 (USB_DP)
USB_DP_C: J1.A6 (D+), J1.B6 (D+), R28.1
VBUS: D4.2 (A), J1.A4 (VBUS), J1.A9 (VBUS), J1.B4 (VBUS), J1.B9 (VBUS), R30.1
VBUS_SENSE: R30.2, R31.1, U2.36 (GPIO24)
VSYS: C2.1, D2.1 (K), D4.1 (K), R32.1, U22.3 (VI)
VSYS_SENSE: R32.2, R33.1, U2.41 (GPIO29/ADC3)
XIN: C33.1, U2.20 (XIN), Y1.1
XOUT: R25.1, U2.21 (XOUT)
XTAL_OUT: C34.1, R25.2, Y1.3
nBE_L: U2.32 (GPIO21); also elsewhere on the board
nBE_STAT: U2.39 (GPIO27/ADC1); also elsewhere on the board
nEXR_L: U2.2 (GPIO0); also elsewhere on the board
nMREQ_L: U2.16 (GPIO13); also elsewhere on the board
nPRW_L: U2.17 (GPIO14); also elsewhere on the board
nPW_L: U2.14 (GPIO11); also elsewhere on the board
nRDROM_L: U2.3 (GPIO1); also elsewhere on the board
nROSCS_L: U2.38 (GPIO26/ADC0); also elsewhere on the board
nU6_EN: U2.15 (GPIO12); also elsewhere on the board
nU10_ENA: R15.2, U2.30 (GPIO19); also elsewhere on the board
nU13_ENA: R16.2, U2.31 (GPIO20); also elsewhere on the board

Notes on the sheet:
RP2040 after the minimal design in 'Hardware design with RP2040'. GPIO map identical to the v2.2 Pico (Pico.SchDoc): GP0-GP22, GP26-GP28 carry the same signals.
GP23 test pad, GP24 VBUS sense, GP25 LED, GP29 VSYS/3: as on the Pico, so the Pico MicroPython build sees the same board.
VSYS = edge +5V through D2 (as v2.2) or USB VBUS through D4; U22 AMS1117-3.3. The card's 5 V logic and memories run from the edge only.
SW4 BOOTSEL, SW3 RUN (Pico reset). R15/R16 hold the memories deselected until the firmware drives GP19/GP20.

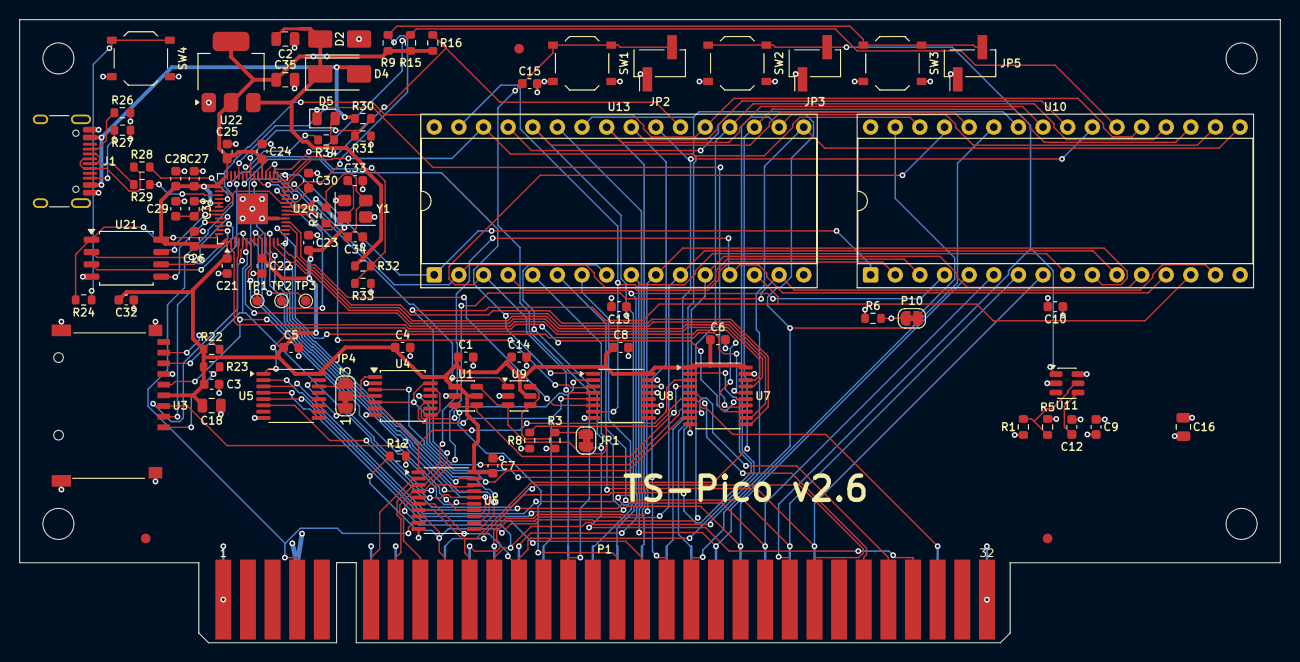
[picture p47: board tspico-v2.6.kicad_pcb from above]

Board: 4 copper layers, 130.0 x 64.2 mm, 93 parts (0 on the bottom side), 107 nets.

Other parts of the board:
FID1, FID2, FID3: Fiducial_1mm_Mask2mm
H1, H2, H3, H4: MountingHole_3.2mm_M3
