factus10/tspico-hardware/hardware-v2.5/tspico-v2.5.kicad_pcb

## KiCad design hardware-v2.5/tspico-v2.5.kicad_pcb (2026-10-11, an earlier design)

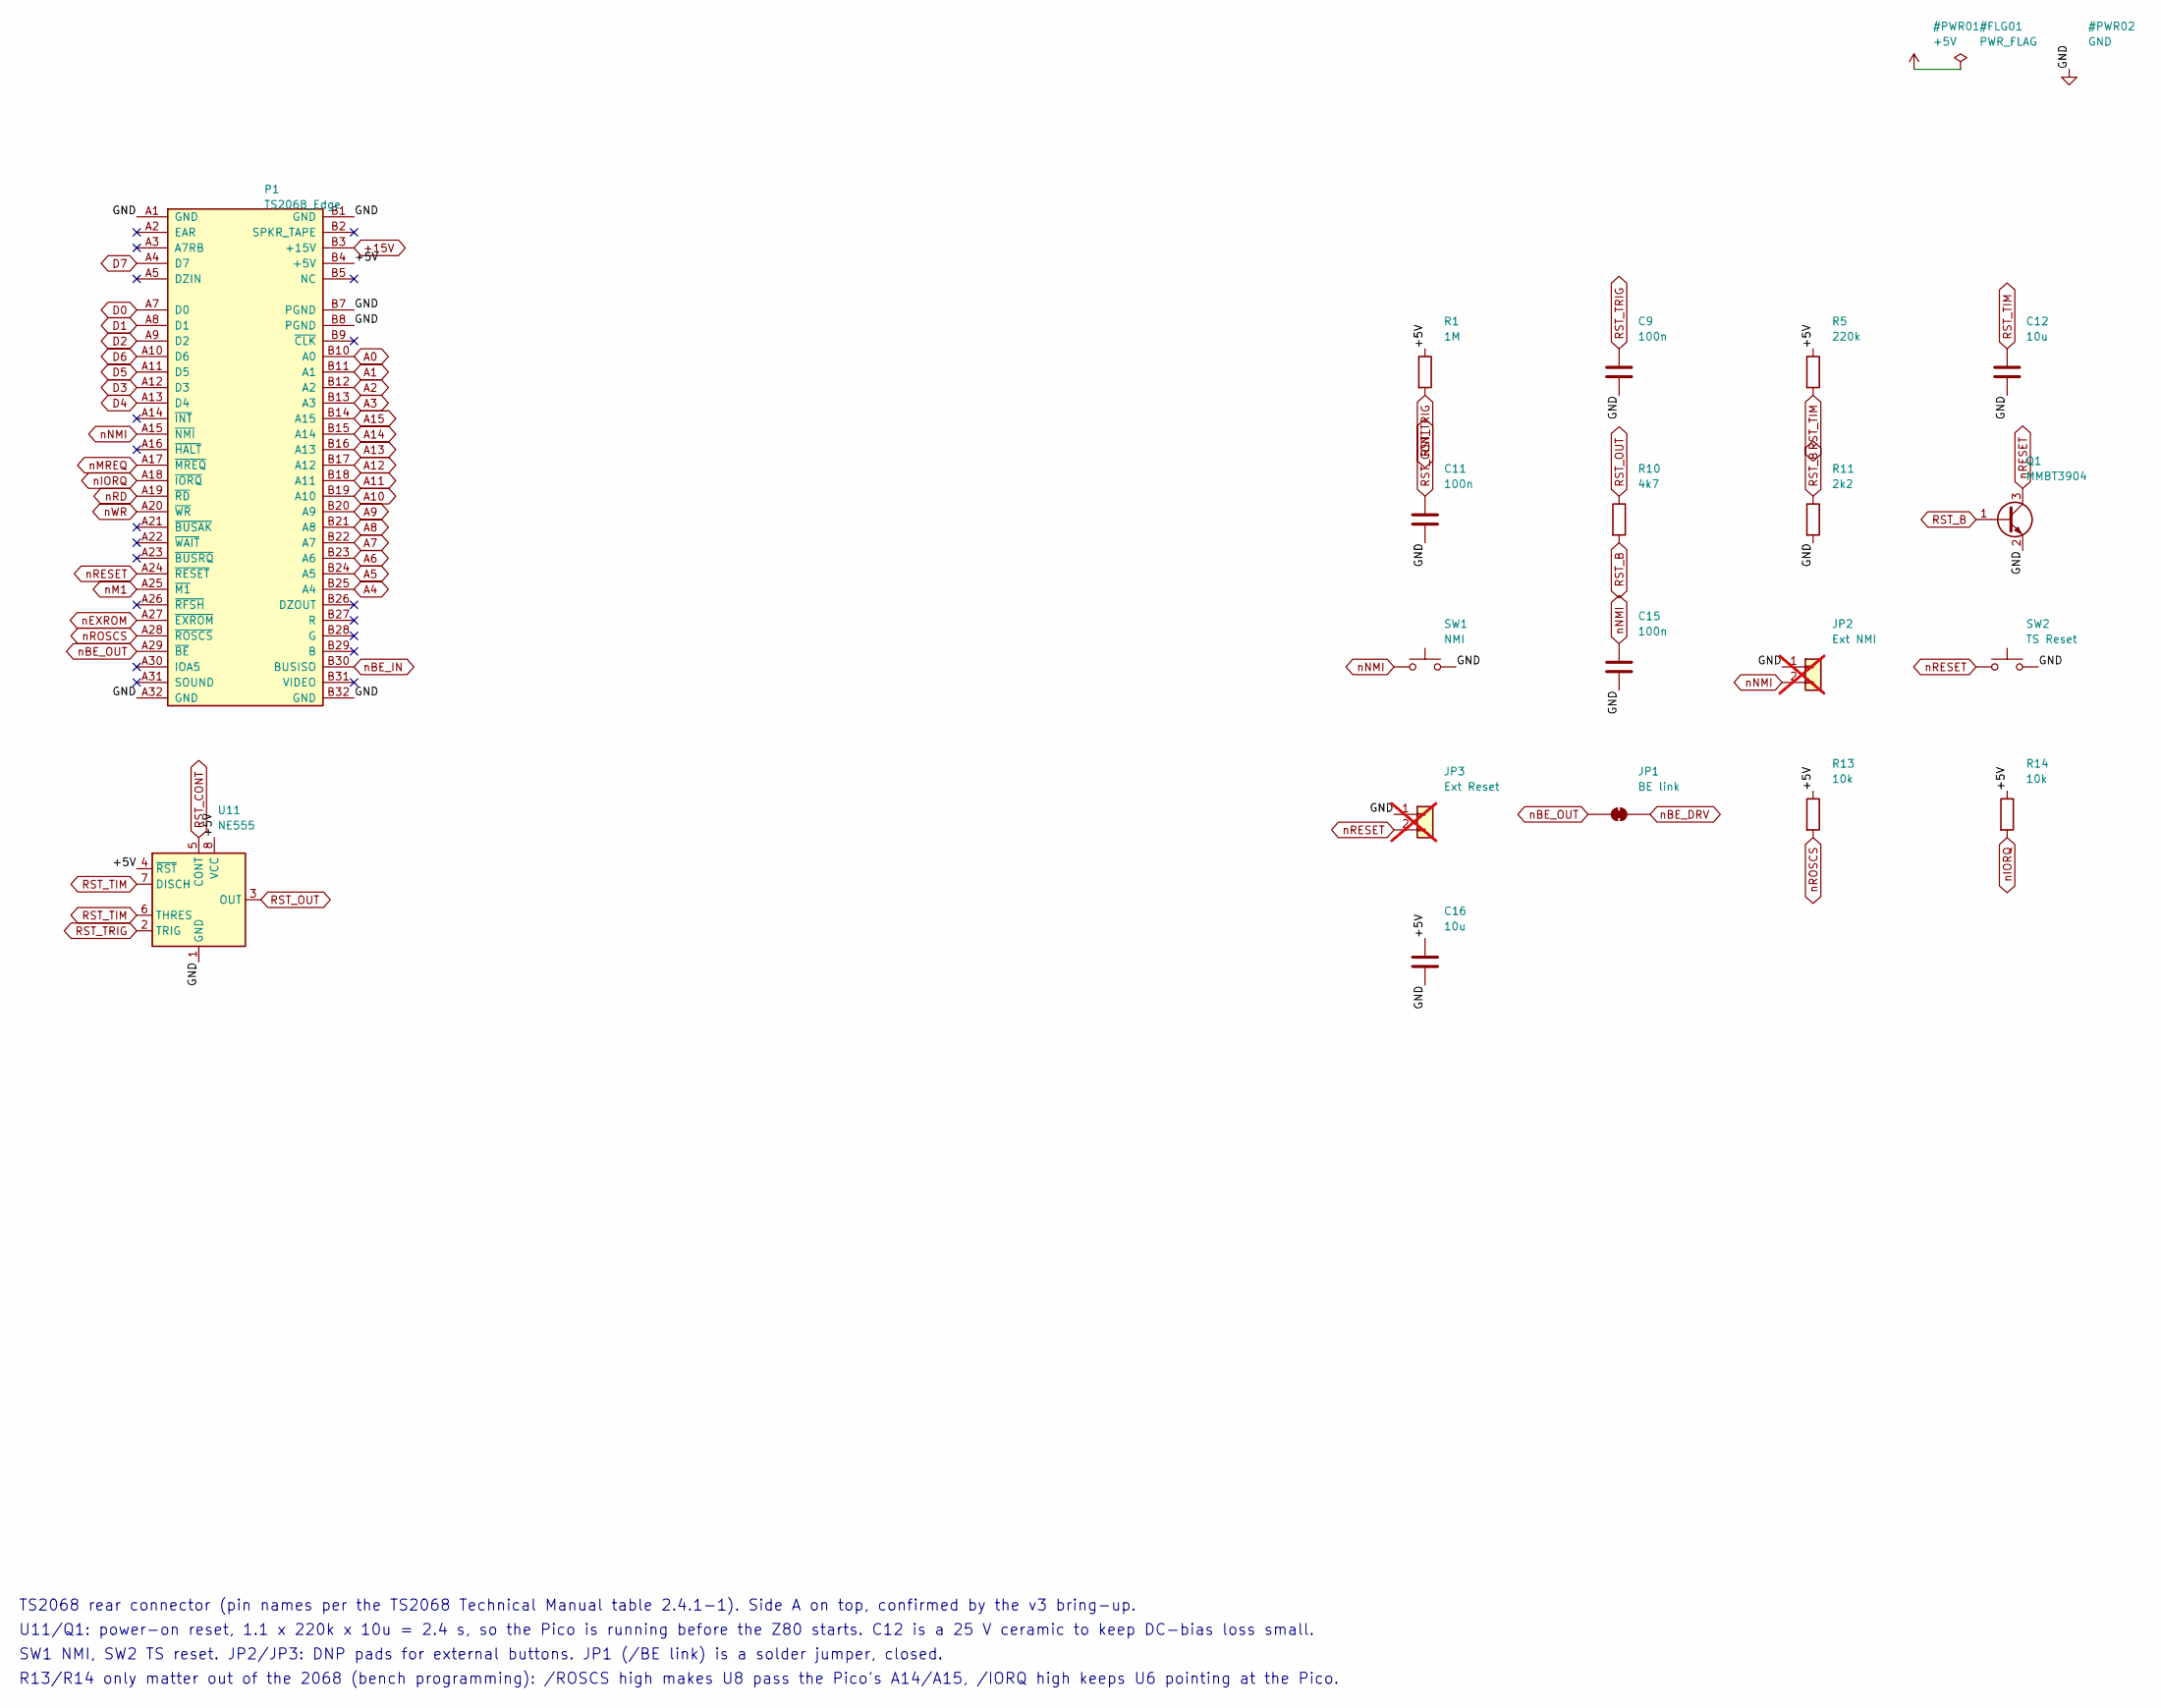
[picture p48: schematic interface.kicad_sch, TS-Pico v2.5: 2068 Interface and Reset]

Parts:
C9, C11, C15: 100n; C_0603_1608Metric; MPN CC0603KRX7R9BB104; LCSC C14663
C12, C16: 10u; C_0805_2012Metric; MPN CL21A106KAYNNNE; LCSC C15850
JP1: BE link; SolderJumper-2_P1.3mm_Bridged_RoundedPad1.0x1.5mm
JP2: Ext NMI; PinHeader_1x02_P2.54mm_Vertical_SMD_Pin1Left; not fitted
JP3: Ext Reset; PinHeader_1x02_P2.54mm_Vertical_SMD_Pin1Left; not fitted
P1: TS2068_Edge; TS2068_EdgeConnector_2x32
Q1: MMBT3904; SOT-23; MPN MMBT3904; LCSC C20526
R1: 1M; R_0603_1608Metric; MPN 0603WAF1004T5E; LCSC C22935
R5: 220k; R_0603_1608Metric; MPN 0603WAF2203T5E; LCSC C22961
R10: 4k7; R_0603_1608Metric; MPN 0603WAF4701T5E; LCSC C23162
R11: 2k2; R_0603_1608Metric; MPN 0603WAF2201T5E; LCSC C4190
R13, R14: 10k; R_0603_1608Metric; MPN 0603WAF1002T5E; LCSC C25804
SW1: NMI; SW_Push_1P1T_XKB_TS-1187A; MPN TS-1187A-B-A-B; LCSC C318884
SW2: TS Reset; SW_Push_1P1T_XKB_TS-1187A; MPN TS-1187A-B-A-B; LCSC C318884
U11: NE555; SOIC-8_3.9x4.9mm_P1.27mm; MPN NE555DR; LCSC C7593

Connections:
+5V: C16.1, P1.B4 (+5V), R1.1, R5.1, R13.1, R14.1, U11.4 (~RST), U11.8 (VCC); also elsewhere on the board
+15V: P1.B3 (+15V); also elsewhere on the board
A0: P1.B10 (A0); also elsewhere on the board
A1: P1.B11 (A1); also elsewhere on the board
A2: P1.B12 (A2); also elsewhere on the board
A3: P1.B13 (A3); also elsewhere on the board
A4: P1.B25 (A4); also elsewhere on the board
A5: P1.B24 (A5); also elsewhere on the board
A6: P1.B23 (A6); also elsewhere on the board
A7: P1.B22 (A7); also elsewhere on the board
A8: P1.B21 (A8); also elsewhere on the board
A9: P1.B20 (A9); also elsewhere on the board
A10: P1.B19 (A10); also elsewhere on the board
A11: P1.B18 (A11); also elsewhere on the board
A12: P1.B17 (A12); also elsewhere on the board
A13: P1.B16 (A13); also elsewhere on the board
A14: P1.B15 (A14); also elsewhere on the board
A15: P1.B14 (A15); also elsewhere on the board
D0: P1.A7 (D0); also elsewhere on the board
D1: P1.A8 (D1); also elsewhere on the board
D2: P1.A9 (D2); also elsewhere on the board
D3: P1.A12 (D3); also elsewhere on the board
D4: P1.A13 (D4); also elsewhere on the board
D5: P1.A11 (D5); also elsewhere on the board
D6: P1.A10 (D6); also elsewhere on the board
D7: P1.A4 (D7); also elsewhere on the board
GND: C9.2, C11.2, C12.2, C15.2, C16.2, JP2.1, JP3.1, P1.A1 (GND), P1.A32 (GND), P1.B1 (GND), P1.B7 (PGND), P1.B8 (PGND), P1.B32 (GND), Q1.2 (E), R11.2, SW1.2, SW2.2, U11.1 (GND); also elsewhere on the board
RST_B: Q1.1 (B), R10.2, R11.1
RST_CONT: C11.1, U11.5 (CONT)
RST_OUT: R10.1, U11.3 (OUT)
RST_TIM: C12.1, R5.2, U11.6 (THRES), U11.7 (DISCH)
RST_TRIG: C9.1, R1.2, U11.2 (TRIG)
nBE_DRV: JP1.2 (B); also elsewhere on the board
nBE_IN: P1.B30 (BUSISO); also elsewhere on the board
nBE_OUT: JP1.1 (A), P1.A29 (~BE)
nEXROM: P1.A27 (~EXROM); also elsewhere on the board
nIORQ: P1.A18 (~IORQ), R14.2; also elsewhere on the board
nM1: P1.A25 (~M1); also elsewhere on the board
nMREQ: P1.A17 (~MREQ); also elsewhere on the board
nNMI: C15.1, JP2.2, P1.A15 (~NMI), SW1.1
nRD: P1.A19 (~RD); also elsewhere on the board
nRESET: JP3.2, P1.A24 (~RESET), Q1.3 (C), SW2.1
nROSCS: P1.A28 (~ROSCS), R13.2; also elsewhere on the board
nWR: P1.A20 (~WR); also elsewhere on the board

Notes on the sheet:
TS2068 rear connector (pin names per the TS2068 Technical Manual table 2.4.1-1). Side A on top, confirmed by the v3 bring-up.
U11/Q1: power-on reset, 1.1 x 220k x 10u = 2.4 s, so the Pico is running before the Z80 starts. C12 is a 25 V ceramic to keep DC-bias loss small.
SW1 NMI, SW2 TS reset. JP2/JP3: DNP pads for external buttons. JP1 (/BE link) is a solder jumper, closed.
R13/R14 only matter out of the 2068 (bench programming): /ROSCS high makes U8 pass the Pico's A14/A15, /IORQ high keeps U6 pointing at the Pico.

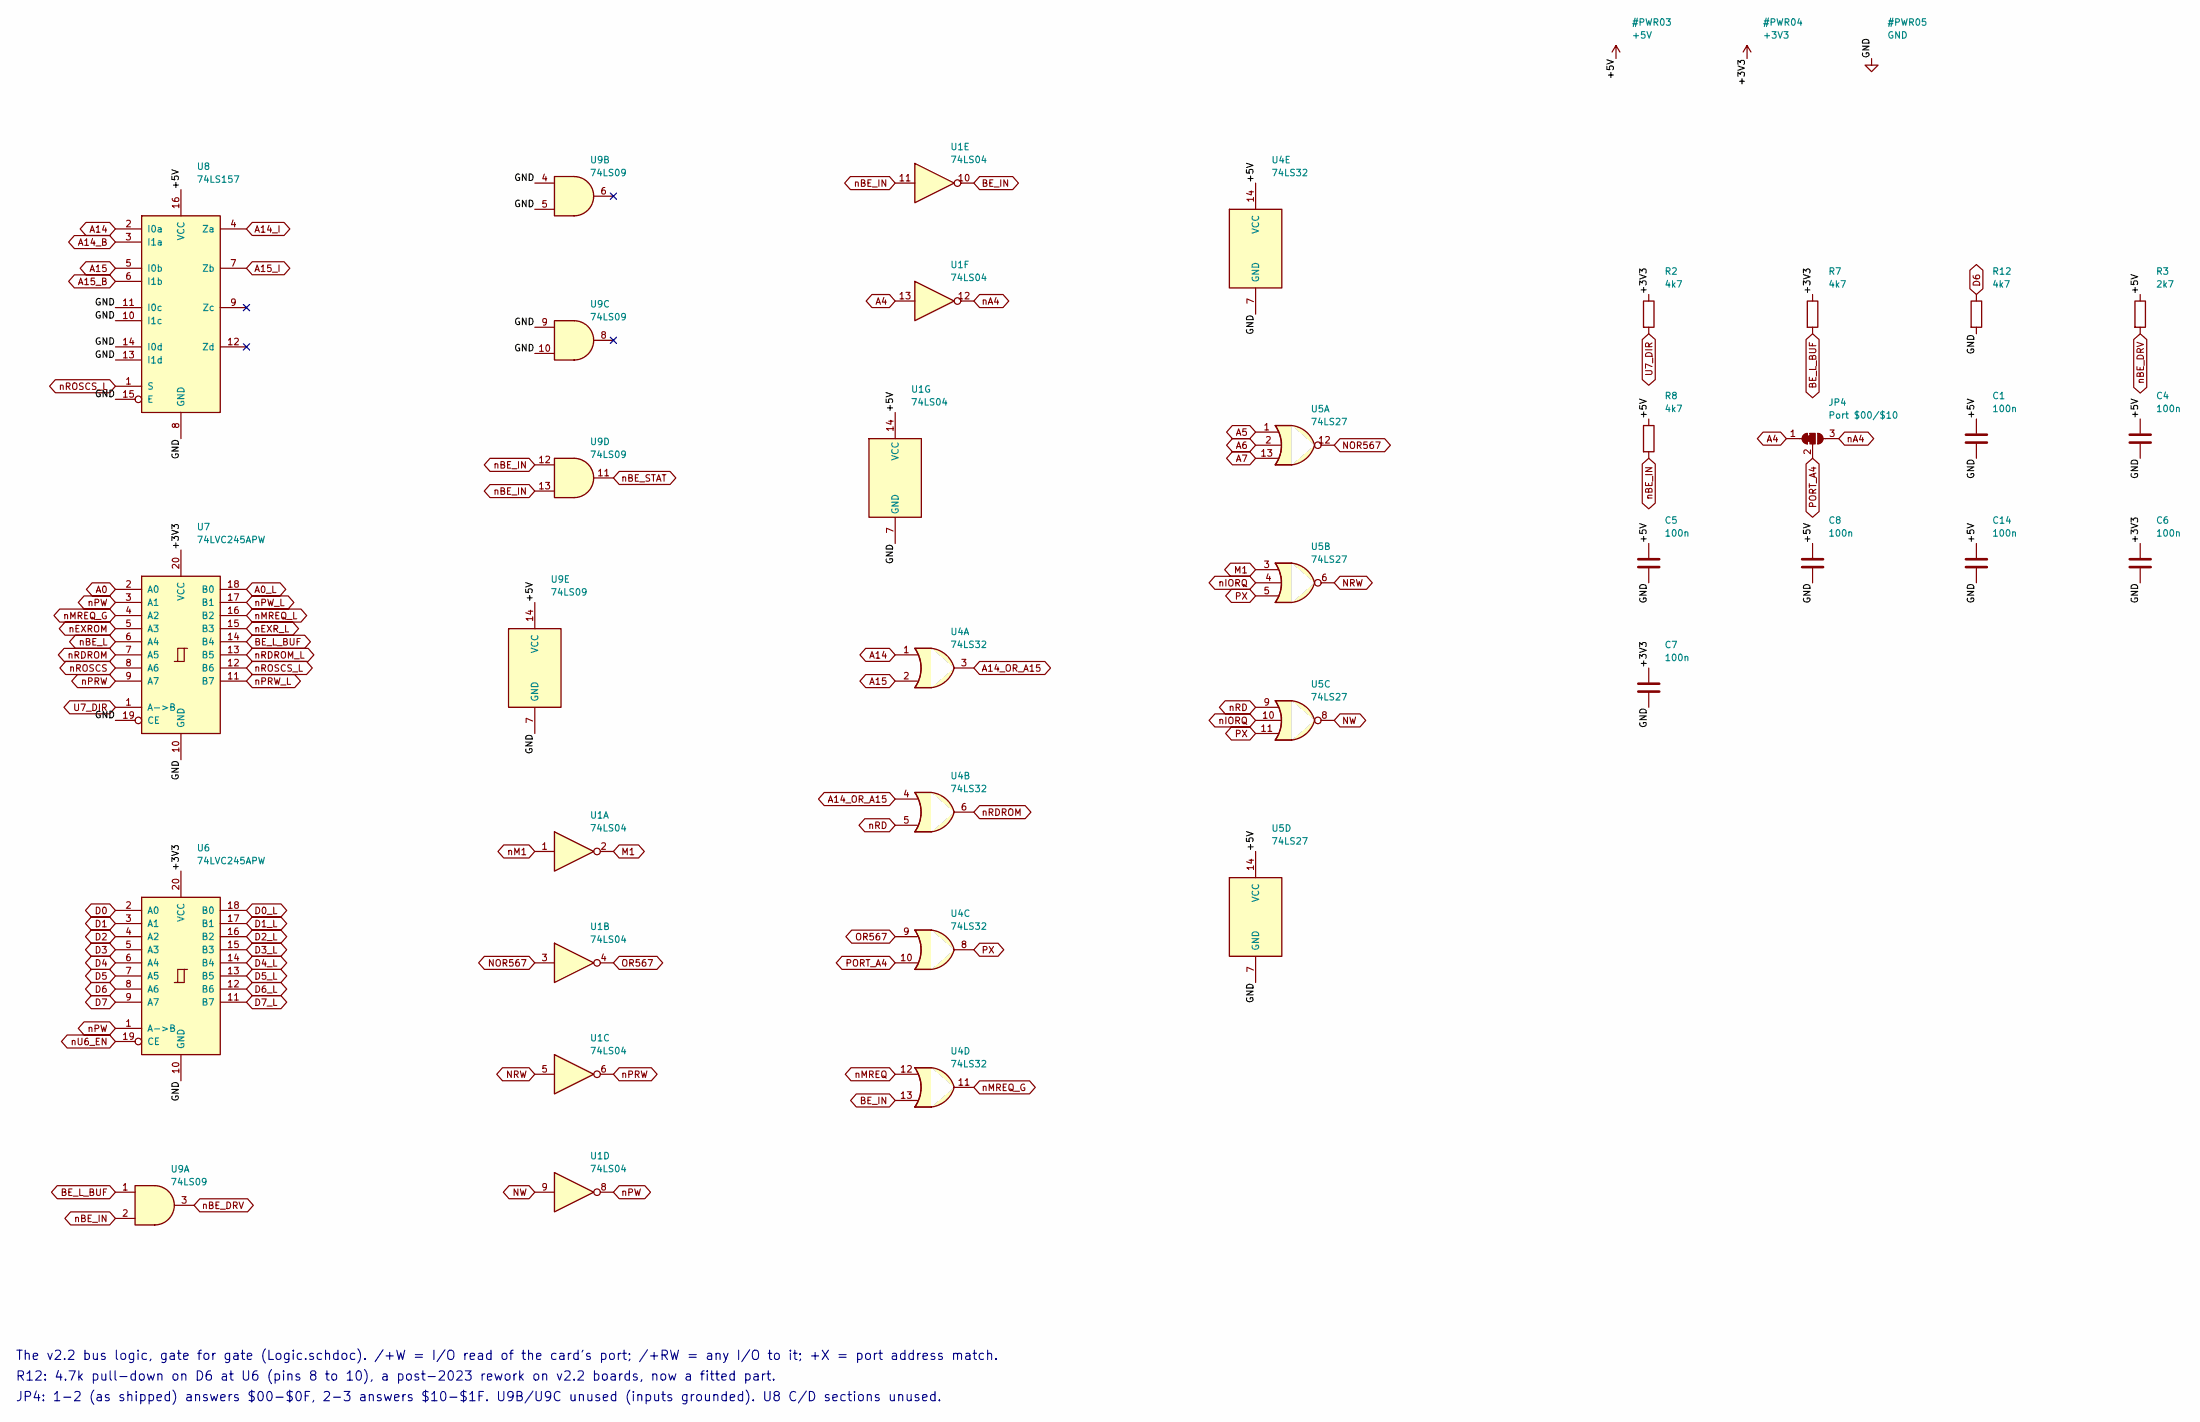
[picture p49: schematic logic.kicad_sch, TS-Pico v2.5: Bus Logic]

Parts:
C1, C4, C5, C6, C7, C8, C14: 100n; C_0603_1608Metric; MPN CC0603KRX7R9BB104; LCSC C14663
JP4: Port $00/$10; SolderJumper-3_P1.3mm_Bridged12_RoundedPad1.0x1.5mm_NumberL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
R2, R7, R8, R12: 4k7; R_0603_1608Metric; MPN 0603WAF4701T5E; LCSC C23162
R3: 2k7; R_0603_1608Metric; MPN 0603WAF2701T5E; LCSC C13167
U1: 74LS04; SOIC-14_3.9x8.7mm_P1.27mm; MPN SN74LS04DR; LCSC C6796
U4: 74LS32; SOIC-14_3.9x8.7mm_P1.27mm; MPN SN74LS32DR; LCSC C116812
U5: 74LS27; SOIC-14_3.9x8.7mm_P1.27mm; MPN XL74LS27; LCSC C707098
U6, U7: 74LVC245APW; TSSOP-20_4.4x6.5mm_P0.65mm; MPN 74LVC245APW,118; LCSC C6082
U8: 74LS157; SOIC-16_3.9x9.9mm_P1.27mm; MPN XL74LS157; LCSC C707097
U9: 74LS09; SOIC-14_3.9x8.7mm_P1.27mm; MPN SN74LS09DR; LCSC C7731

Connections:
+3V3: C6.1, C7.1, R2.1, R7.1, U6.20 (VCC), U7.20 (VCC); also elsewhere on the board
+5V: C1.1, C4.1, C5.1, C8.1, C14.1, R3.1, R8.1, U1.14 (VCC), U4.14 (VCC), U5.14 (VCC), U8.16 (VCC), U9.14 (VCC); also elsewhere on the board
A0: U7.2 (A0); also elsewhere on the board
A0_L: U7.18 (B0); also elsewhere on the board
A4: JP4.1 (A), U1.13; also elsewhere on the board
A5: U5.1; also elsewhere on the board
A6: U5.2; also elsewhere on the board
A7: U5.13; also elsewhere on the board
A14: U4.1, U8.2 (I0a); also elsewhere on the board
A14_B: U8.3 (I1a); also elsewhere on the board
A14_I: U8.4 (Za); also elsewhere on the board
A14_OR_A15: U4.3, U4.4
A15: U4.2, U8.5 (I0b); also elsewhere on the board
A15_B: U8.6 (I1b); also elsewhere on the board
A15_I: U8.7 (Zb); also elsewhere on the board
BE_IN: U1.10, U4.13
BE_L_BUF: R7.2, U7.14 (B4), U9.1
D0: U6.2 (A0); also elsewhere on the board
D0_L: U6.18 (B0); also elsewhere on the board
D1: U6.3 (A1); also elsewhere on the board
D1_L: U6.17 (B1); also elsewhere on the board
D2: U6.4 (A2); also elsewhere on the board
D2_L: U6.16 (B2); also elsewhere on the board
D3: U6.5 (A3); also elsewhere on the board
D3_L: U6.15 (B3); also elsewhere on the board
D4: U6.6 (A4); also elsewhere on the board
D4_L: U6.14 (B4); also elsewhere on the board
D5: U6.7 (A5); also elsewhere on the board
D5_L: U6.13 (B5); also elsewhere on the board
D6: R12.1, U6.8 (A6); also elsewhere on the board
D6_L: U6.12 (B6); also elsewhere on the board
D7: U6.9 (A7); also elsewhere on the board
D7_L: U6.11 (B7); also elsewhere on the board
GND: C1.2, C4.2, C5.2, C6.2, C7.2, C8.2, C14.2, R12.2, U1.7 (GND), U4.7 (GND), U5.7 (GND), U6.10 (GND), U7.10 (GND), U7.19 (CE), U8.8 (GND), U8.10 (I1c), U8.11 (I0c), U8.13 (I1d), U8.14 (I0d), U8.15 (E), U9.4, U9.5, U9.7 (GND), U9.9, U9.10; also elsewhere on the board
M1: U1.2, U5.3
NOR567: U1.3, U5.12
NRW: U1.5, U5.6
NW: U1.9, U5.8
OR567: U1.4, U4.9
PORT_A4: JP4.2 (C), U4.10
PX: U4.8, U5.5, U5.11
U7_DIR: R2.2, U7.1 (A->B)
nA4: JP4.3 (B), U1.12
nBE_DRV: R3.2, U9.3; also elsewhere on the board
nBE_IN: R8.2, U1.11, U9.2, U9.12, U9.13; also elsewhere on the board
nBE_L: U7.6 (A4); also elsewhere on the board
nBE_STAT: U9.11; also elsewhere on the board
nEXROM: U7.5 (A3); also elsewhere on the board
nEXR_L: U7.15 (B3); also elsewhere on the board
nIORQ: U5.4, U5.10; also elsewhere on the board
nM1: U1.1; also elsewhere on the board
nMREQ: U4.12; also elsewhere on the board
nMREQ_G: U4.11, U7.4 (A2)
nMREQ_L: U7.16 (B2); also elsewhere on the board
nPRW: U1.6, U7.9 (A7)
nPRW_L: U7.11 (B7); also elsewhere on the board
nPW: U1.8, U6.1 (A->B), U7.3 (A1)
nPW_L: U7.17 (B1); also elsewhere on the board
nRD: U4.5, U5.9; also elsewhere on the board
nRDROM: U4.6, U7.7 (A5)
nRDROM_L: U7.13 (B5); also elsewhere on the board
nROSCS: U7.8 (A6); also elsewhere on the board
nROSCS_L: U7.12 (B6), U8.1 (S); also elsewhere on the board
nU6_EN: U6.19 (CE); also elsewhere on the board

Notes on the sheet:
The v2.2 bus logic, gate for gate (Logic.schdoc). /+W = I/O read of the card's port; /+RW = any I/O to it; +X = port address match.
R12: 4.7k pull-down on D6 at U6 (pins 8 to 10), a post-2023 rework on v2.2 boards, now a fitted part.
JP4: 1-2 (as shipped) answers $00-$0F, 2-3 answers $10-$1F. U9B/U9C unused (inputs grounded). U8 C/D sections unused.
