factus10/tspico-hardware/hardware-v2.5/tspico-v2.5.kicad_pcb

## KiCad design hardware-v2.5/tspico-v2.5.kicad_pcb (continued)

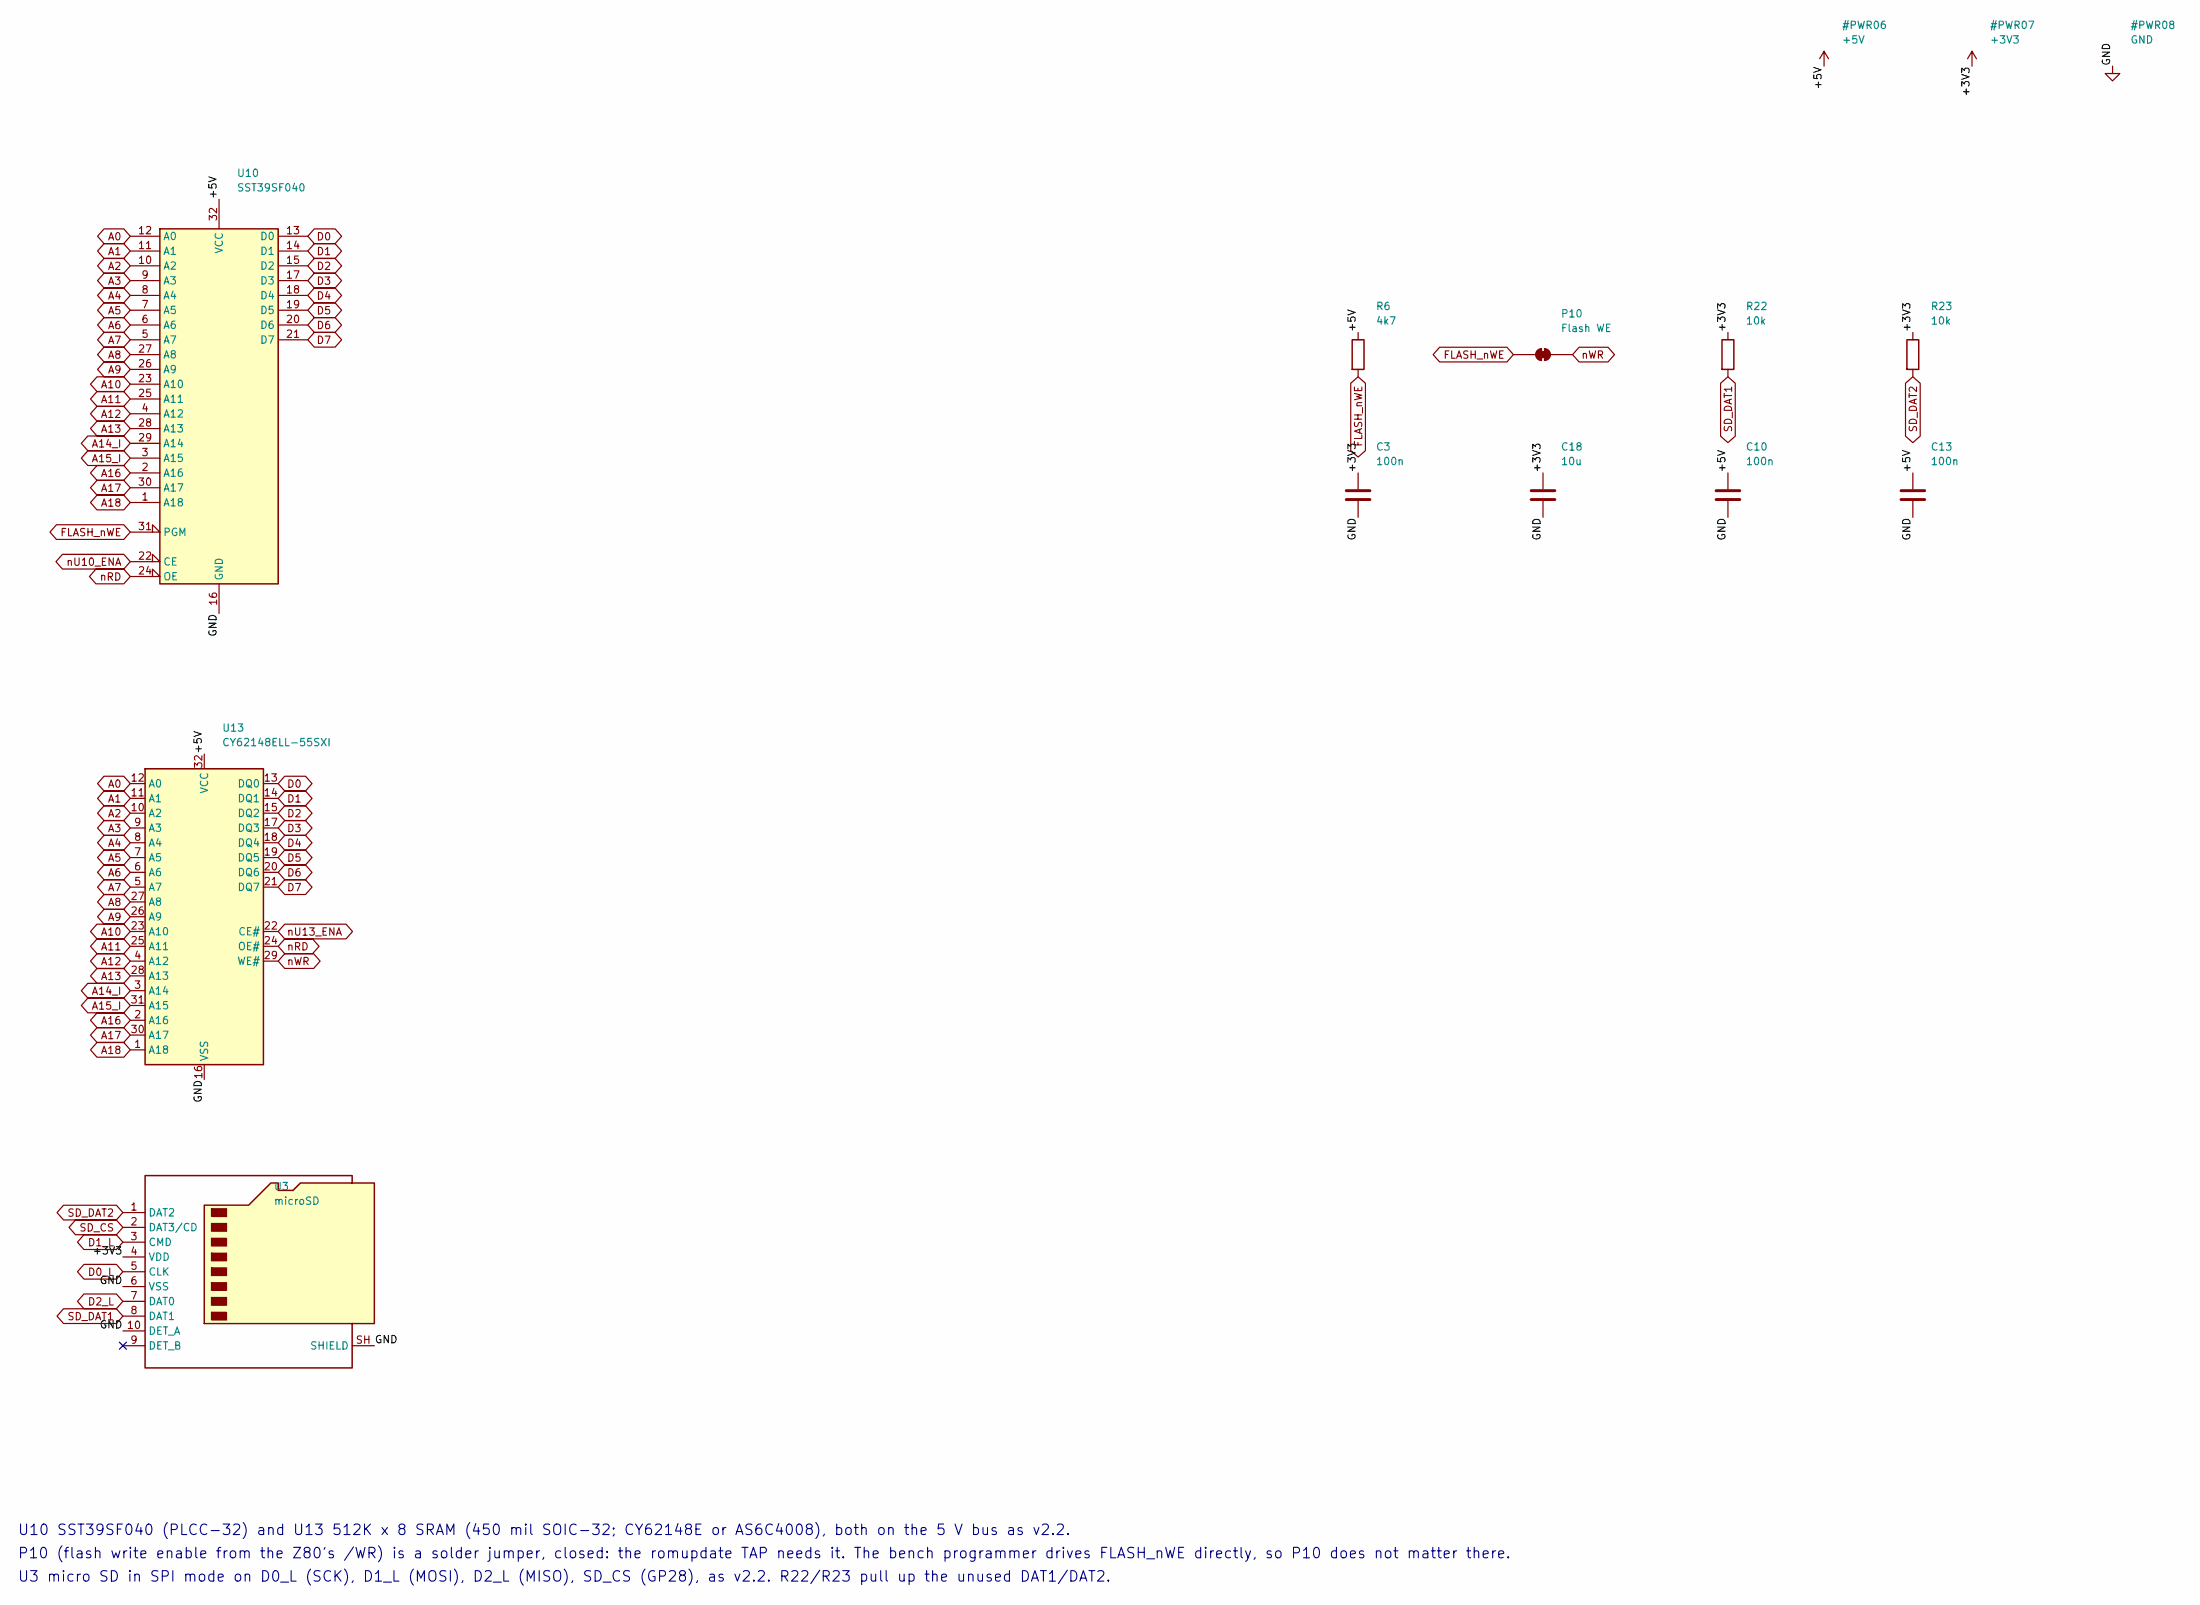
[picture p50: schematic memory.kicad_sch, TS-Pico v2.5: Memory and SD]

Parts:
C3, C10, C13: 100n; C_0603_1608Metric; MPN CC0603KRX7R9BB104; LCSC C14663
C18: 10u; C_0805_2012Metric; MPN CL21A106KAYNNNE; LCSC C15850
P10: Flash WE; SolderJumper-2_P1.3mm_Bridged_RoundedPad1.0x1.5mm
R6: 4k7; R_0603_1608Metric; MPN 0603WAF4701T5E; LCSC C23162
R22, R23: 10k; R_0603_1608Metric; MPN 0603WAF1002T5E; LCSC C25804
U3: microSD; microSD_TF-01A; MPN TF-01A; LCSC C91145
U10: SST39SF040; PLCC-32_11.4x14.0mm_P1.27mm; MPN SST39SF040-55-4I-NHE-T; LCSC C632847
U13: CY62148ELL-55SXI; SOP-32_11.305x20.495mm_P1.27mm; MPN CY62148ELL-55SXIT; LCSC C511135

Connections:
+3V3: C3.1, C18.1, R22.1, R23.1, U3.4 (VDD); also elsewhere on the board
+5V: C10.1, C13.1, R6.1, U10.32 (VCC), U13.32 (VCC); also elsewhere on the board
A0: U10.12 (A0), U13.12 (A0); also elsewhere on the board
A1: U10.11 (A1), U13.11 (A1); also elsewhere on the board
A2: U10.10 (A2), U13.10 (A2); also elsewhere on the board
A3: U10.9 (A3), U13.9 (A3); also elsewhere on the board
A4: U10.8 (A4), U13.8 (A4); also elsewhere on the board
A5: U10.7 (A5), U13.7 (A5); also elsewhere on the board
A6: U10.6 (A6), U13.6 (A6); also elsewhere on the board
A7: U10.5 (A7), U13.5 (A7); also elsewhere on the board
A8: U10.27 (A8), U13.27 (A8); also elsewhere on the board
A9: U10.26 (A9), U13.26 (A9); also elsewhere on the board
A10: U10.23 (A10), U13.23 (A10); also elsewhere on the board
A11: U10.25 (A11), U13.25 (A11); also elsewhere on the board
A12: U10.4 (A12), U13.4 (A12); also elsewhere on the board
A13: U10.28 (A13), U13.28 (A13); also elsewhere on the board
A14_I: U10.29 (A14), U13.3 (A14); also elsewhere on the board
A15_I: U10.3 (A15), U13.31 (A15); also elsewhere on the board
A16: U10.2 (A16), U13.2 (A16); also elsewhere on the board
A17: U10.30 (A17), U13.30 (A17); also elsewhere on the board
A18: U10.1 (A18), U13.1 (A18); also elsewhere on the board
D0: U10.13 (D0), U13.13 (DQ0); also elsewhere on the board
D0_L: U3.5 (CLK); also elsewhere on the board
D1: U10.14 (D1), U13.14 (DQ1); also elsewhere on the board
D1_L: U3.3 (CMD); also elsewhere on the board
D2: U10.15 (D2), U13.15 (DQ2); also elsewhere on the board
D2_L: U3.7 (DAT0); also elsewhere on the board
D3: U10.17 (D3), U13.17 (DQ3); also elsewhere on the board
D4: U10.18 (D4), U13.18 (DQ4); also elsewhere on the board
D5: U10.19 (D5), U13.19 (DQ5); also elsewhere on the board
D6: U10.20 (D6), U13.20 (DQ6); also elsewhere on the board
D7: U10.21 (D7), U13.21 (DQ7); also elsewhere on the board
FLASH_nWE: P10.1 (A), R6.2, U10.31 (PGM); also elsewhere on the board
GND: C3.2, C10.2, C13.2, C18.2, U3.6 (VSS), U3.10 (DET_A), U3.SH (SHIELD), U10.16 (GND), U13.16 (VSS); also elsewhere on the board
SD_CS: U3.2 (DAT3/CD); also elsewhere on the board
SD_DAT1: R22.2, U3.8 (DAT1)
SD_DAT2: R23.2, U3.1 (DAT2)
nRD: U10.24 (OE), U13.24 (OE#); also elsewhere on the board
nU10_ENA: U10.22 (CE); also elsewhere on the board
nU13_ENA: U13.22 (CE#); also elsewhere on the board
nWR: P10.2 (B), U13.29 (WE#); also elsewhere on the board

Notes on the sheet:
U10 SST39SF040 (PLCC-32) and U13 512K x 8 SRAM (450 mil SOIC-32; CY62148E or AS6C4008), both on the 5 V bus as v2.2.
P10 (flash write enable from the Z80's /WR) is a solder jumper, closed: the romupdate TAP needs it. The bench programmer drives FLASH_nWE directly, so P10 does not matter there.
U3 micro SD in SPI mode on D0_L (SCK), D1_L (MOSI), D2_L (MISO), SD_CS (GP28), as v2.2. R22/R23 pull up the unused DAT1/DAT2.

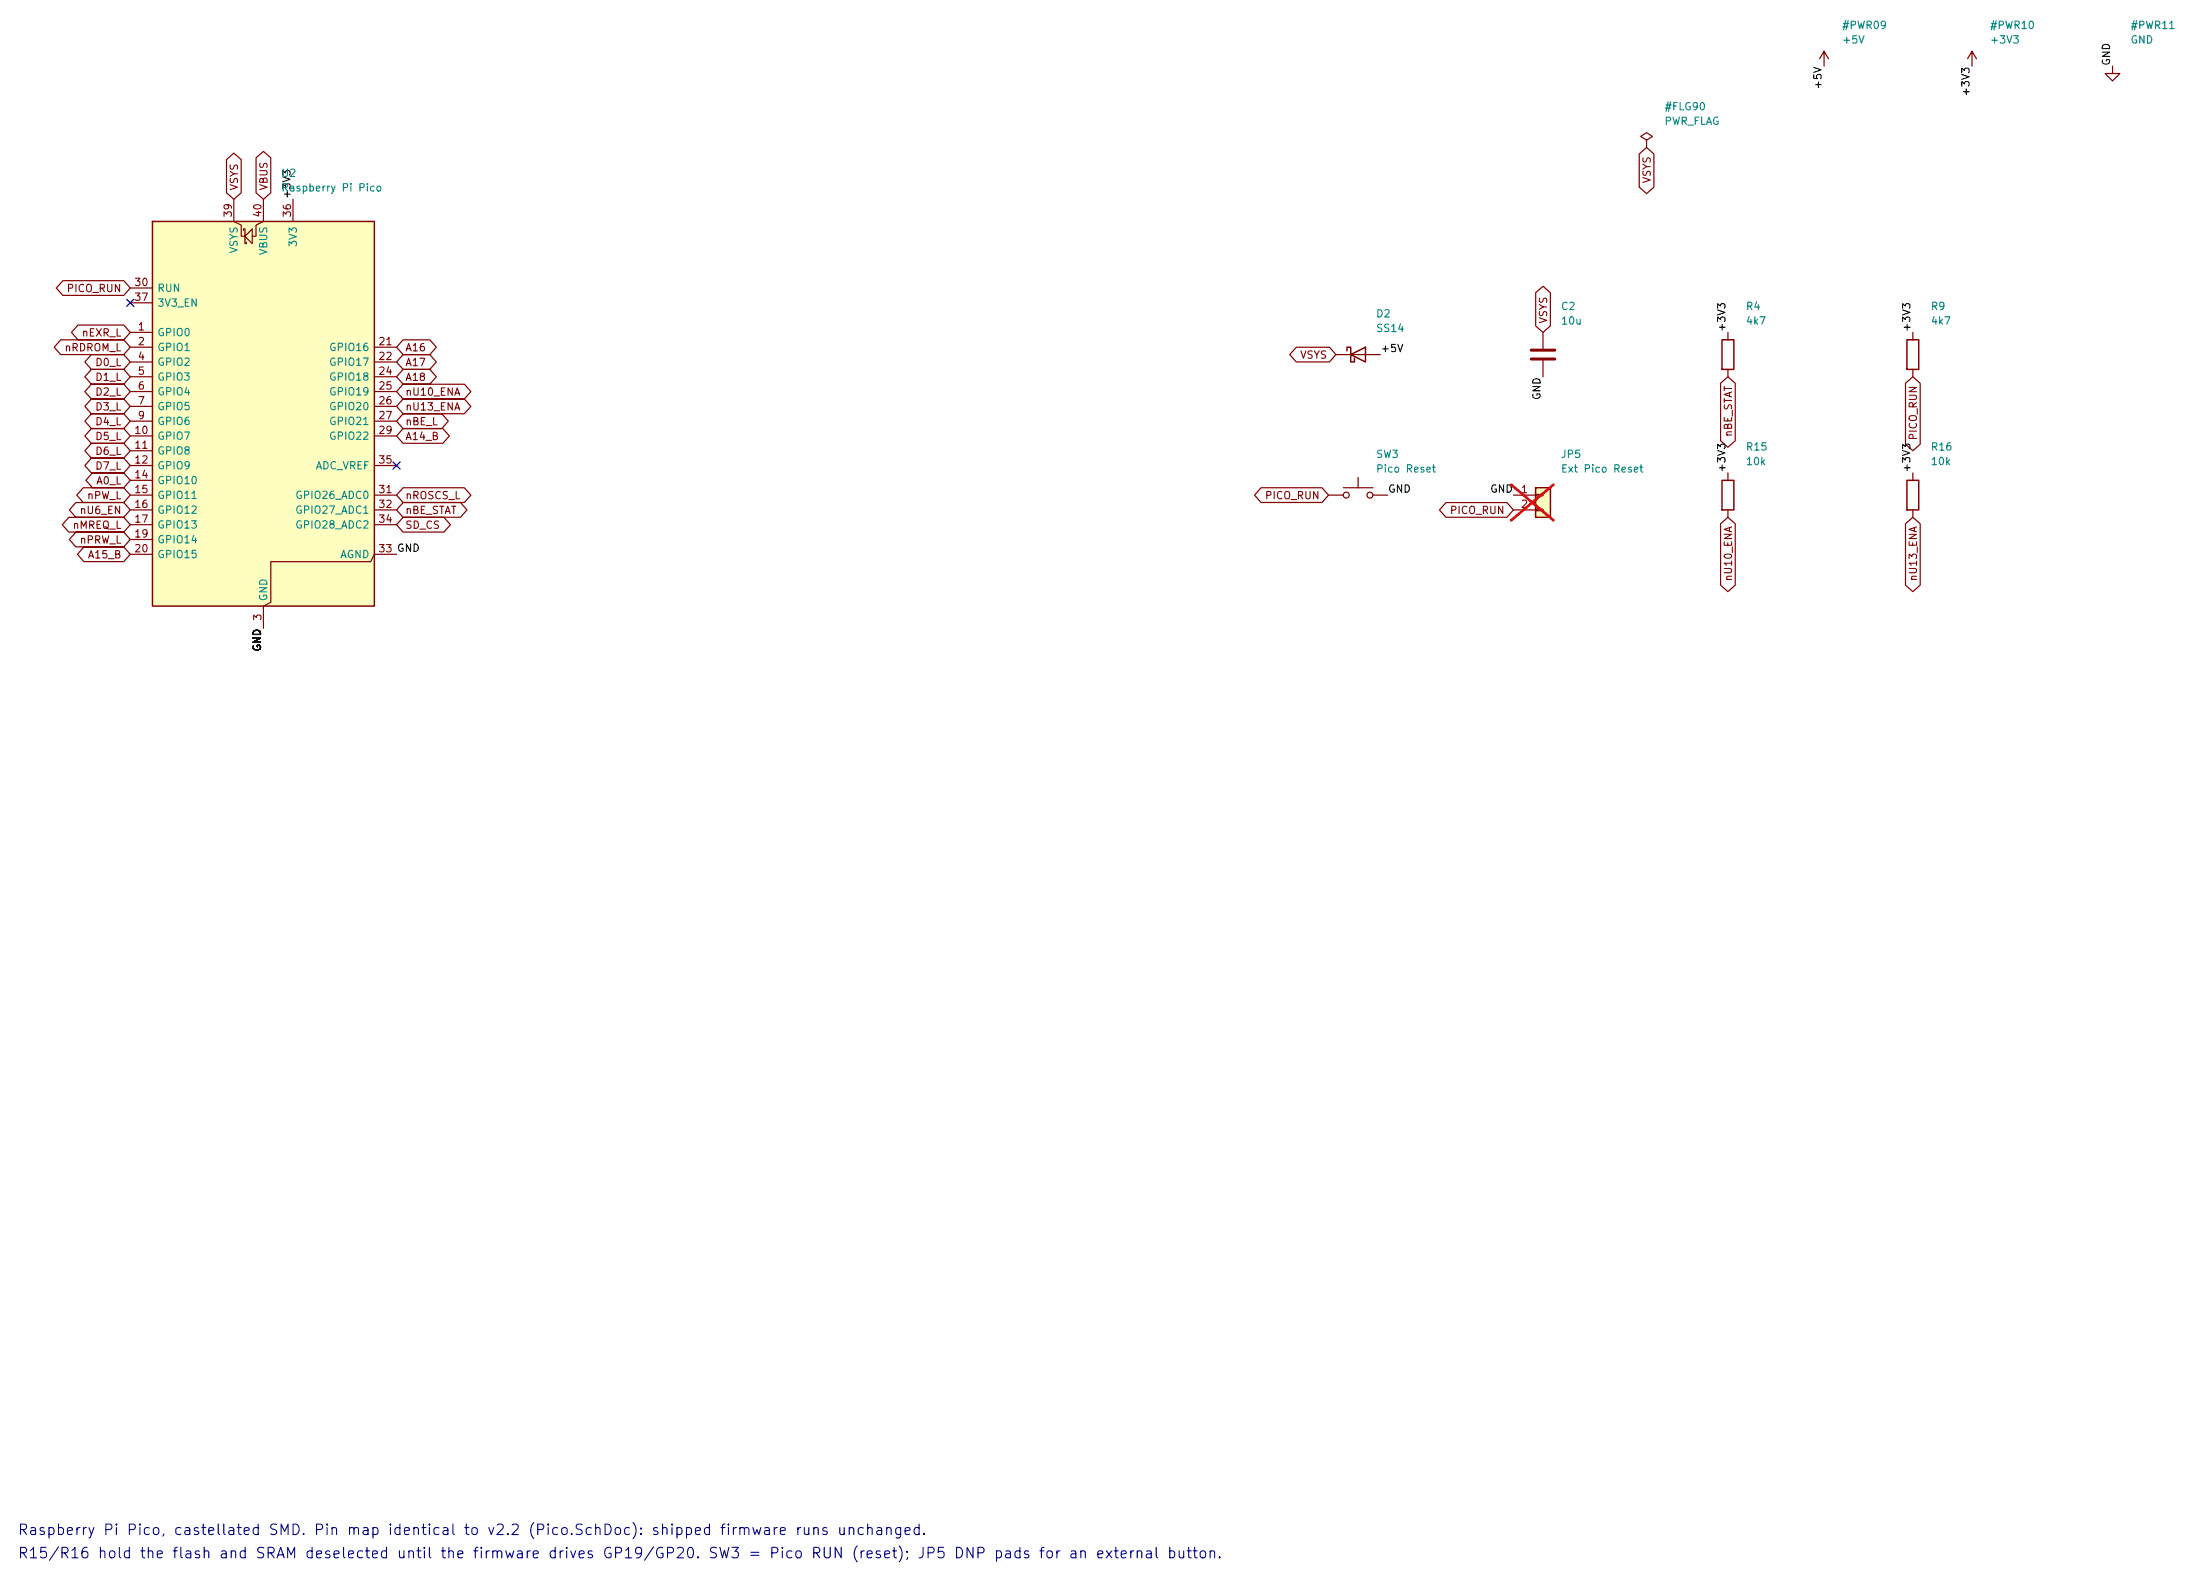
[picture p51: schematic pico.kicad_sch, TS-Pico v2.5: Raspberry Pi Pico]

Parts:
C2: 10u; C_0805_2012Metric; MPN CL21A106KAYNNNE; LCSC C15850
D2: SS14; D_SMA; MPN SS14; LCSC C2480
JP5: Ext Pico Reset; PinHeader_1x02_P2.54mm_Vertical_SMD_Pin1Left; not fitted
R4, R9: 4k7; R_0603_1608Metric; MPN 0603WAF4701T5E; LCSC C23162
R15, R16: 10k; R_0603_1608Metric; MPN 0603WAF1002T5E; LCSC C25804
SW3: Pico Reset; SW_Push_1P1T_XKB_TS-1187A; MPN TS-1187A-B-A-B; LCSC C318884
U2: Raspberry Pi Pico; RaspberryPi_Pico_SMD; MPN SC0915; LCSC C7203002

Connections:
+3V3: R4.1, R9.1, R15.1, R16.1, U2.36 (3V3); also elsewhere on the board
+5V: D2.2 (A); also elsewhere on the board
A0_L: U2.14 (GPIO10); also elsewhere on the board
A14_B: U2.29 (GPIO22); also elsewhere on the board
A15_B: U2.20 (GPIO15); also elsewhere on the board
A16: U2.21 (GPIO16); also elsewhere on the board
A17: U2.22 (GPIO17); also elsewhere on the board
A18: U2.24 (GPIO18); also elsewhere on the board
D0_L: U2.4 (GPIO2); also elsewhere on the board
D1_L: U2.5 (GPIO3); also elsewhere on the board
D2_L: U2.6 (GPIO4); also elsewhere on the board
D3_L: U2.7 (GPIO5); also elsewhere on the board
D4_L: U2.9 (GPIO6); also elsewhere on the board
D5_L: U2.10 (GPIO7); also elsewhere on the board
D6_L: U2.11 (GPIO8); also elsewhere on the board
D7_L: U2.12 (GPIO9); also elsewhere on the board
GND: C2.2, JP5.1, SW3.2, U2.3 (GND), U2.8 (GND), U2.13 (GND), U2.18 (GND), U2.23 (GND), U2.28 (GND), U2.33 (AGND), U2.38 (GND); also elsewhere on the board
PICO_RUN: JP5.2, R9.2, SW3.1, U2.30 (RUN)
SD_CS: U2.34 (GPIO28_ADC2); also elsewhere on the board
VBUS: U2.40 (VBUS); also elsewhere on the board
VSYS: C2.1, D2.1 (K), U2.39 (VSYS)
nBE_L: U2.27 (GPIO21); also elsewhere on the board
nBE_STAT: R4.2, U2.32 (GPIO27_ADC1); also elsewhere on the board
nEXR_L: U2.1 (GPIO0); also elsewhere on the board
nMREQ_L: U2.17 (GPIO13); also elsewhere on the board
nPRW_L: U2.19 (GPIO14); also elsewhere on the board
nPW_L: U2.15 (GPIO11); also elsewhere on the board
nRDROM_L: U2.2 (GPIO1); also elsewhere on the board
nROSCS_L: U2.31 (GPIO26_ADC0); also elsewhere on the board
nU6_EN: U2.16 (GPIO12); also elsewhere on the board
nU10_ENA: R15.2, U2.25 (GPIO19); also elsewhere on the board
nU13_ENA: R16.2, U2.26 (GPIO20); also elsewhere on the board

Notes on the sheet:
Raspberry Pi Pico, castellated SMD. Pin map identical to v2.2 (Pico.SchDoc): shipped firmware runs unchanged.
R15/R16 hold the flash and SRAM deselected until the firmware drives GP19/GP20. SW3 = Pico RUN (reset); JP5 DNP pads for an external button.

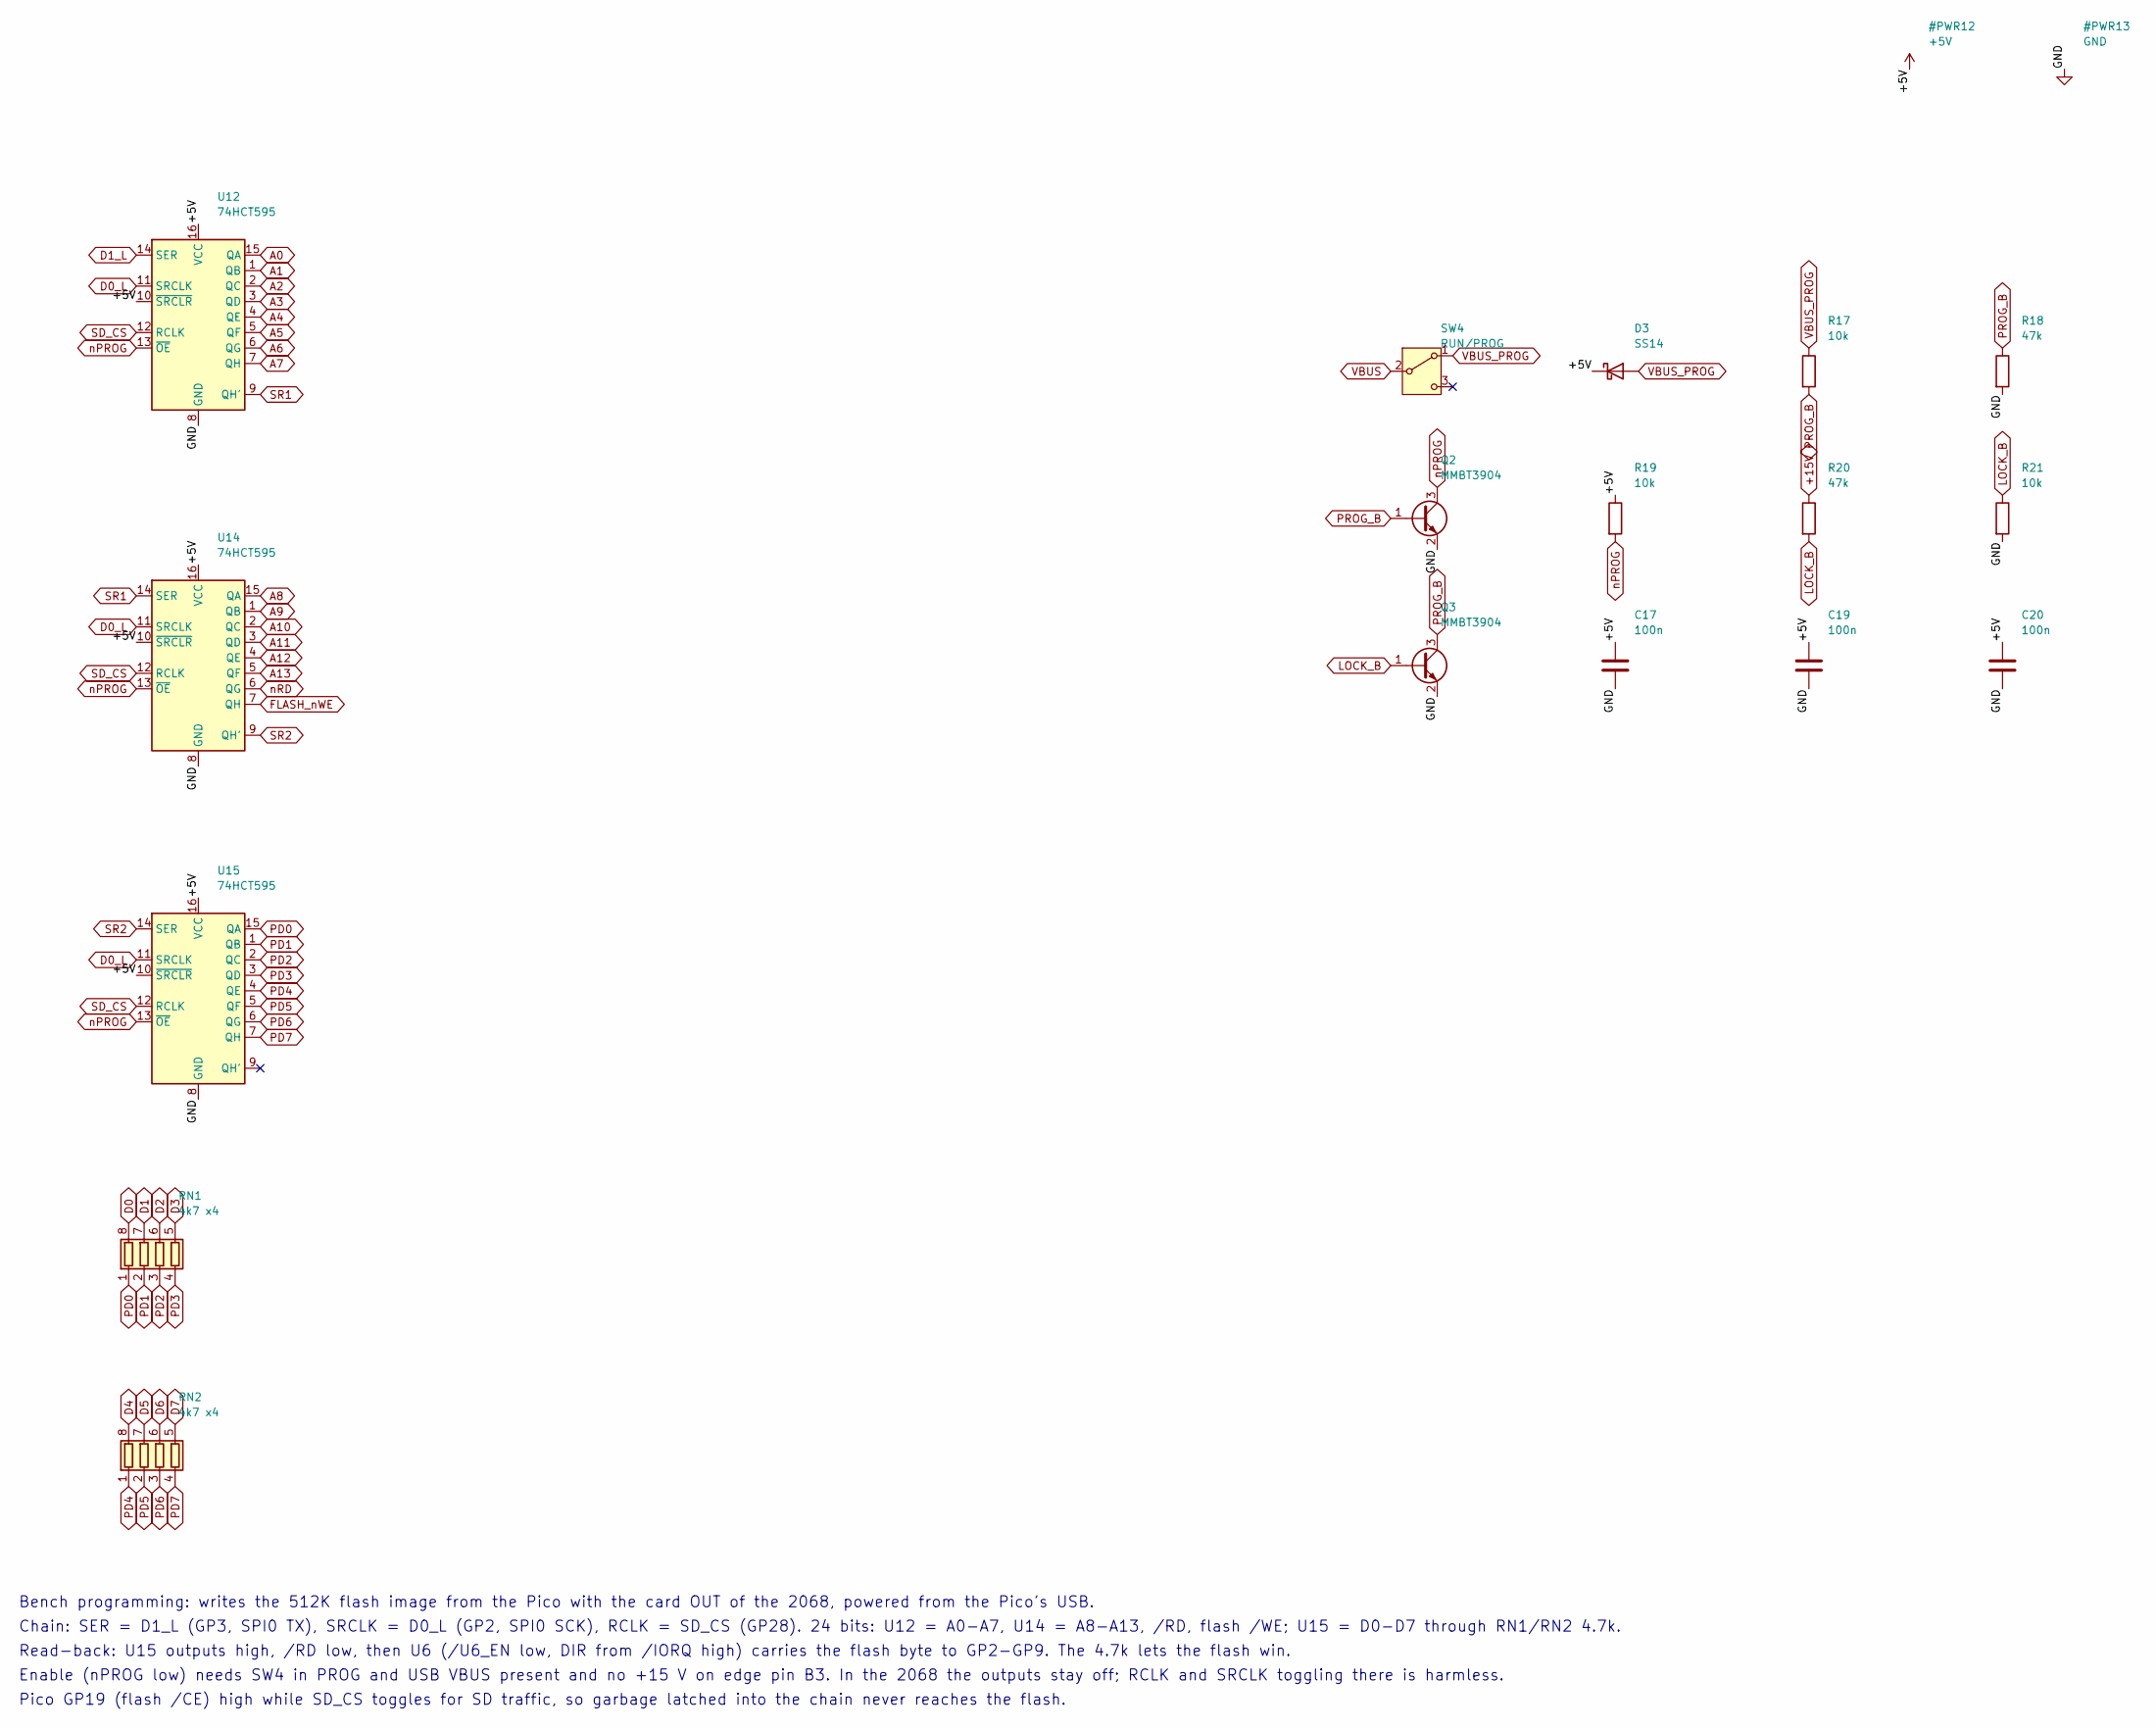
[picture p52: schematic benchprog.kicad_sch, TS-Pico v2.5: Bench Programming]

Parts:
C17, C19, C20: 100n; C_0603_1608Metric; MPN CC0603KRX7R9BB104; LCSC C14663
D3: SS14; D_SMA; MPN SS14; LCSC C2480
Q2, Q3: MMBT3904; SOT-23; MPN MMBT3904; LCSC C20526
R17, R19, R21: 10k; R_0603_1608Metric; MPN 0603WAF1002T5E; LCSC C25804
R18, R20: 47k; R_0603_1608Metric; MPN 0603WAF4702T5E; LCSC C25819
RN1, RN2: 4k7 x4; R_Array_Convex_4x0603; MPN 4D03WGJ0472T5E; LCSC C1980
SW4: RUN/PROG; SW_SPDT_Shouhan_MSK12C02; MPN MSK12C02; LCSC C431540
U12, U14, U15: 74HCT595; SOIC-16_3.9x9.9mm_P1.27mm; MPN 74HCT595D,118; LCSC C282339

Connections:
+5V: C17.1, C19.1, C20.1, D3.1 (K), R19.1, U12.10 (~SRCLR), U12.16 (VCC), U14.10 (~SRCLR), U14.16 (VCC), U15.10 (~SRCLR), U15.16 (VCC); also elsewhere on the board
+15V: R20.1; also elsewhere on the board
A0: U12.15 (QA); also elsewhere on the board
A1: U12.1 (QB); also elsewhere on the board
A2: U12.2 (QC); also elsewhere on the board
A3: U12.3 (QD); also elsewhere on the board
A4: U12.4 (QE); also elsewhere on the board
A5: U12.5 (QF); also elsewhere on the board
A6: U12.6 (QG); also elsewhere on the board
A7: U12.7 (QH); also elsewhere on the board
A8: U14.15 (QA); also elsewhere on the board
A9: U14.1 (QB); also elsewhere on the board
A10: U14.2 (QC); also elsewhere on the board
A11: U14.3 (QD); also elsewhere on the board
A12: U14.4 (QE); also elsewhere on the board
A13: U14.5 (QF); also elsewhere on the board
D0: RN1.8 (R1.2); also elsewhere on the board
D0_L: U12.11 (SRCLK), U14.11 (SRCLK), U15.11 (SRCLK); also elsewhere on the board
D1: RN1.7 (R2.2); also elsewhere on the board
D1_L: U12.14 (SER); also elsewhere on the board
D2: RN1.6 (R3.2); also elsewhere on the board
D3: RN1.5 (R4.2); also elsewhere on the board
D4: RN2.8 (R1.2); also elsewhere on the board
D5: RN2.7 (R2.2); also elsewhere on the board
D6: RN2.6 (R3.2); also elsewhere on the board
D7: RN2.5 (R4.2); also elsewhere on the board
FLASH_nWE: U14.7 (QH); also elsewhere on the board
GND: C17.2, C19.2, C20.2, Q2.2 (E), Q3.2 (E), R18.2, R21.2, U12.8 (GND), U14.8 (GND), U15.8 (GND); also elsewhere on the board
LOCK_B: Q3.1 (B), R20.2, R21.1
PD0: RN1.1 (R1.1), U15.15 (QA)
PD1: RN1.2 (R2.1), U15.1 (QB)
PD2: RN1.3 (R3.1), U15.2 (QC)
PD3: RN1.4 (R4.1), U15.3 (QD)
PD4: RN2.1 (R1.1), U15.4 (QE)
PD5: RN2.2 (R2.1), U15.5 (QF)
PD6: RN2.3 (R3.1), U15.6 (QG)
PD7: RN2.4 (R4.1), U15.7 (QH)
PROG_B: Q2.1 (B), Q3.3 (C), R17.2, R18.1
SD_CS: U12.12 (RCLK), U14.12 (RCLK), U15.12 (RCLK); also elsewhere on the board
SR1: U12.9 (QH'), U14.14 (SER)
SR2: U14.9 (QH'), U15.14 (SER)
VBUS: SW4.2 (B); also elsewhere on the board
VBUS_PROG: D3.2 (A), R17.1, SW4.1 (A)
nPROG: Q2.3 (C), R19.2, U12.13 (~OE), U14.13 (~OE), U15.13 (~OE)
nRD: U14.6 (QG); also elsewhere on the board

Notes on the sheet:
Bench programming: writes the 512K flash image from the Pico with the card OUT of the 2068, powered from the Pico's USB.
Chain: SER = D1_L (GP3, SPI0 TX), SRCLK = D0_L (GP2, SPI0 SCK), RCLK = SD_CS (GP28). 24 bits: U12 = A0-A7, U14 = A8-A13, /RD, flash /WE; U15 = D0-D7 through RN1/RN2 4.7k.
Read-back: U15 outputs high, /RD low, then U6 (/U6_EN low, DIR from /IORQ high) carries the flash byte to GP2-GP9. The 4.7k lets the flash win.
Enable (nPROG low) needs SW4 in PROG and USB VBUS present and no +15 V on edge pin B3. In the 2068 the outputs stay off; RCLK and SRCLK toggling there is harmless.
Pico GP19 (flash /CE) high while SD_CS toggles for SD traffic, so garbage latched into the chain never reaches the flash.

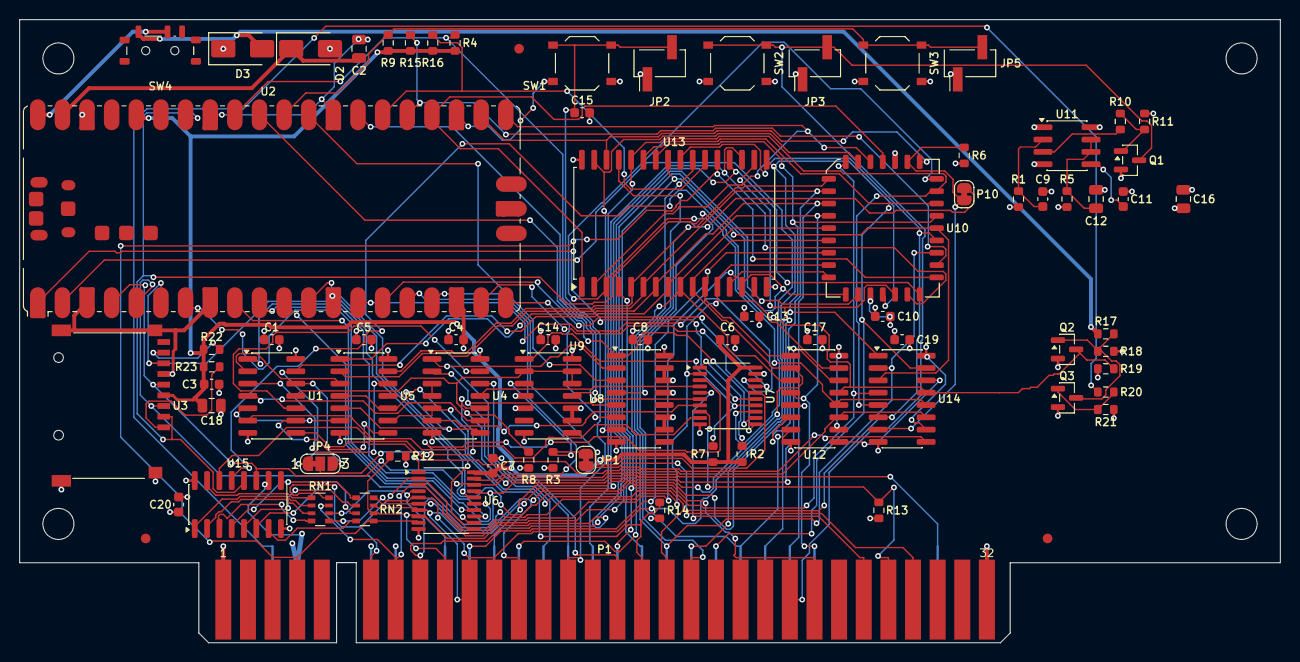
[picture p53: board tspico-v2.5.kicad_pcb from above]

Board: 4 copper layers, 130.0 x 64.2 mm, 83 parts (0 on the bottom side), 109 nets.

Other parts of the board:
FID1, FID2, FID3: Fiducial_1mm_Mask2mm
H1, H2, H3, H4: MountingHole_3.2mm_M3
