factus10/tspico-hardware/(commit log)

2026-09-16 TS-Pico v3: plan, RP2350B architecture spec, KiCad project skeleton
    - PLAN.md and docs/v3-architecture.md: RP2350B chip-down design with
    Pico-addressable flash/SRAM, PIO bank logic, PIO port decode, WiFi
    (ESP32-C3 running Zimodem, 8251 emulation at $73/$77), OLED, Kempston,
    AY emulation, tape in/out, DMA provision, power from the edge only.
    - hardware/: KiCad 10 project, 4-layer board skeleton with outline and
    TS2068 edge connector generated from the v2.2 Gerbers, eight empty
    hierarchical sheets, ERC/DRC check script.
    - old/: TS-Pico v2.2 CircuitStudio project and fab package (reference).
    [BOM_PartType-tsPico.xlsx, Logic.schdoc, Memory.SchDoc, Pico.SchDoc, audio.kicad_sch, interface.kicad_sch, joystick.kicad_sch, mcu.kicad_sch]
2026-09-16 Interface sheet: 2068 bus transceivers, gating, open-drain drivers, DMA drivers
    - lib/tspico.kicad_sym: TS2068_Edge symbol (A1..A32/B1..B32, manual pin names)
    - scripts/schlib.py: small KiCad schematic writer (stock symbols embedded
    verbatim, labels on pins, grid-snapped placement)
    - scripts/gen_interface.py: P1, 4x 74LVC245, 74LVC04/08 gating, 74LVC07
    open-drain, 74LVC126 DMA drivers, 74LVC1G86 data direction, buttons,
    reset pull-down, EAR divider, decoupling
    - Power decision: +5V from the edge only, USB is data only
    - ERC: only cross-sheet labels remain (isolated/undriven until other sheets exist)
    [interface.kicad_sch]
2026-09-16 Interface sheet: fix symbol text placement and layout overlaps
    [interface.kicad_sch]
2026-09-16 Emulated memory: rewrite architecture, add local-bus/register sheet
    - docs/v3-architecture.md: RP2350B serves DCK/ROM images from internal SRAM
    via PIO+DMA; no flash or SRAM chips; 8-bit multiplexed local bus; slot map
    file replaces fixed flash banks; ESP32-C3-WROOM-02 for Zimodem.
    - memory sheet: 74LVC257 address byte muxes, ALO/AHI/CTL/STAT registers,
    74LVC139 select, power-on clear for CTL.
    - interface sheet: 74LVC06 inverting open-drain drivers with active-high
    requests (safe power-up state), RESET_HOLD pull-up, address transceivers
    always enabled, MA8-MA15 to the muxes, WIFI_DL inverter.
    - ERC: only cross-sheet labels/inputs pending the MCU and peripheral sheets.
    Co-Authored-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
    [interface.kicad_sch, memory.kicad_sch, tspico-v3.kicad_sch]
2026-09-16 RP2350B core sheet: MCU, regulator, crystal, QSPI flash, PSRAM, USB-C, buttons, SWD
    - scripts/schlib.py: resolve chained (extends) symbols
    - gen_mcu.py: GPIO nets per the architecture map; USB-C data only with Rd
    [mcu.kicad_sch]
2026-09-16 Remaining sheets: power, SD and display, WiFi, audio, joystick; ERC clean
    - Power: Schottky diode-OR of edge +5V and USB VBUS (card runs from the
    2068/expansion bus, USB alone, or both), two TLV1117LV33 LDOs, bulk caps
    - SD: Hirose DM3AT in SPI mode with series R, pull-ups, card detect to STAT
    - OLED: 7-pin header (Waveshare 1.27in 128x96 SSD1351) on SPI1
    - WiFi: ESP32-C3-WROOM-02 on UART, EN/boot from CTL, IO8 pull-up
    - Audio: PWM low-pass, 2068 SOUND mix, MCP6002 buffers, 3.5 mm jack
    - Joystick: DE-9 Kempston with pull-ups, series R, optional +5V jumper
    - Memory sheet: activity LED on CTL bit 6
    - Docs: power decision updated
    [audio.kicad_sch, interface.kicad_sch, joystick.kicad_sch, mcu.kicad_sch, memory.kicad_sch, power.kicad_sch, storage_display.kicad_sch, wifi.kicad_sch]
2026-09-16 BOM pass: LCSC and MPN fields on every part, JLCPCB BOM export
    - scripts/parts.py: part table looked up 2026-09-16; schlib stamps fields
    - substitutions for stock: 74HC273PW, 74LVC139PW, TI LVC04/08/126/574/1G86,
    33R USB series, XKB TS-1187A switches, Panasonic polymer 220uF, B5819W
    - bom/: JLCPCB-format and full BOM CSVs
    [audio.kicad_sch, interface.kicad_sch, joystick.kicad_sch, mcu.kicad_sch, memory.kicad_sch, power.kicad_sch, storage_display.kicad_sch, tspico-v3-bom-full.csv]
2026-09-16 BOM: include quantities in the full BOM export
    [tspico-v3-bom-full.csv]
2026-09-16 Layout: netlist-driven placement of all footprints, GND/+3V3 planes
    - scripts/gen_layout.py (pcbnew API): footprints from the netlist, nets,
    placement table, zones; DRC clean except unrouted connections
    - connector orientations verified in the 3D render
    [power.kicad_sch, tspico-v3.kicad_pcb]
2026-09-16 Layout: right-edge connector stack, buttons on the top edge, passives per line
    [tspico-v3.kicad_pcb]
2026-09-16 Autoroute pass 2: plane stitching before routing, planes extended into the tongue
    Freerouting 2.4.1, 40 passes single-threaded: 16 of 532 connections left,
    no rule violations except a fiducial since moved.
    [tspico-v3.kicad_pcb]
2026-09-16 Autoroute pass 3: 519/532 routed, zero DRC violations; hand-finish list in README
    [tspico-v3.kicad_pcb]
2026-09-16 Board: default clearance 0.127 mm so the fine-pass tracks pass DRC
2026-09-16 Layout: 72 mm board (64 mm body), USB/SD on the left edge, jack/D-sub on the right, keepout under the RP2350B
    [tspico-v3.kicad_pcb]
2026-09-16 Layout: transceivers in finger order with matching bit assignments, RP2350B rotated, MD block compacted
    - gen_interface.py: 74LVC245 bit assignments follow the connector's pin order;
    U3 Z80 side moved to B, DATA_DIR = nRD xor nDMA_EN
    - gen_layout.py: data/address/control transceivers under their fingers,
    muxes+registers in one row, U20 rotated 90 (MD corner toward the rows),
    keepout allows vias
    [interface.kicad_sch, tspico-v3.kicad_pcb]
2026-09-16 Layout: keepout as four full-keepout rectangles (Freerouting crashes on wire_keepout)
    [tspico-v3.kicad_pcb]
2026-09-16 Autoroute on the reordered 72 mm board: 521/532 routed (headless Freerouting)
    [tspico-v3.kicad_pcb]
2026-09-16 Route: 520/532 on the 72 mm board, zero DRC violations; keepout limited to the chip body
    [tspico-v3.kicad_pcb]
2026-09-16 Layout: SD socket flush with the edge, flash/PSRAM 2 mm further from U20, thinner left decoupling column
    [tspico-v3.kicad_pcb]
2026-09-16 Route: 525/532 on the 72 mm board after SD/flash/decoupling moves, zero DRC violations
    [tspico-v3.kicad_pcb]
2026-09-16 Move FID2 clear of the WIFI_EN track
    [tspico-v3.kicad_pcb]
2026-09-16 SD socket shell 0.35 mm from the edge (copper-to-edge rule), SD nets rerouted: 524/532, zero DRC violations
    [tspico-v3.kicad_pcb]
2026-09-16 Hand-finish the last eight connections: fully routed, zero DRC errors
    finish_route.py adds plane vias, clearance-checked stubs and single-layer
    A* routing. Five signals run partly on the +3V3 plane layer (In2). SD_MISO
    moves from GP36 to GP32 (both SPI0 RX) because the GP36 pad has no exit.
    Schematic, GPIO table and README updated.
    [mcu.kicad_sch, tspico-v3.kicad_pcb]
2026-09-16 Fab outputs: Gerbers, drill, JLCPCB BOM and CPL via scripts/gen_fab.py
    [tspico-v3-bom-full.csv]
2026-09-17 Note the RP2350B regulator/crystal rework needed before ordering
2026-09-17 BOM cost optimisation against the JLCPCB catalog; schematic-side regulator fix
    jlc_price.py prices the BOM via JLCPCB's parts API. Substitutions cut parts+fees
    per board from $32.95 to $17.19 on a 10-board run: PSRAM DNP, electrolytic bulk
    caps, TF-01A socket, PJ-320D jack, 74HC574, GD25Q128E, 0603 10 uF, basic LED,
    preferred MCP6002; U16 decoder deleted (strobes on GPIO), U8 and U15 become
    74LVC245s; J3/J5 hand-soldered. Adds the AOTA inductor and VREG_AVDD filter.
    PCB needs a relayout; fab/ is stale.
    [audio.kicad_sch, interface.kicad_sch, joystick.kicad_sch, mcu.kicad_sch, memory.kicad_sch, power.kicad_sch, storage_display.kicad_sch, tspico-v3-bom-full.csv]
2026-09-17 Logic consolidation: 15 packages to 8 fitted
    Address buffers' output enables replace the 74LVC257 byte muxes and the MA bus;
    one 74LVC32 makes MEMRD/MEMWR/IORD/IOWR strobes (replaces the 04 and 08);
    XL9555 I2C expander replaces the CTL register, its power-on clear and the STAT
    buffer; DMA parts are a DNP stuffing option (config.DMA_OPTION), with 74LVC574
    latches directly on the address bus. GPIO map, architecture doc and cost notes
    updated. Parts + fees per board now $14.93 on a 10-board run.
    [audio.kicad_sch, interface.kicad_sch, joystick.kicad_sch, mcu.kicad_sch, memory.kicad_sch, power.kicad_sch, storage_display.kicad_sch, tspico-v3-bom-full.csv]
2026-09-17 PLAN: DMA is a stuffing option
2026-09-17 Relayout: 130 x 64.25 mm board with the consolidated logic and cheaper BOM
    Regulator and crystal hand-routed per the RP2350 design guide (locked
    pre-routes), TF-01A socket flush with the edge, custom footprints from LCSC
    land patterns, 0.15 mm signal tracks, 0.6/0.3 vias throughout. New flow:
    gen_layout -> preroute -> autoroute -> finish. Zero DRC violations; open are
    two nets of the unfitted DMA option (nMRD, nWR_ALO). Fab outputs regenerated.
    [mcu.kicad_sch, storage_display.kicad_sch, tspico-v3-bom-full.csv, tspico-v3-jlcpcb-bom.csv, tspico-v3.kicad_pcb]
2026-09-17 Drop the DMA option: board fully routed, zero DRC errors
    DMA_OPTION = False removes U8, U9, U12, U13 and six GPIOs; the data transceiver
    takes DIR from /RD with its A side on the Z80 bus. Rerouted with the scripted
    flow; finish order is DVDD before +3V3, supply pin 29 escapes through the freed
    pad lanes, DVDD widened to 0.25 mm. No signal on either plane layer, all vias
    0.6/0.3. Fab outputs regenerated; parts + fees $14.48 per board at 10 boards.
    [audio.kicad_sch, interface.kicad_sch, joystick.kicad_sch, mcu.kicad_sch, memory.kicad_sch, power.kicad_sch, storage_display.kicad_sch, tspico-v3-bom-full.csv]
2026-09-17 Plain address bytes in hardware; DVDD spine and bottom-row fan pre-routed
    U1 delivers A0-A7 and U2 A8-A15 on MD0-MD7 (U2 over its fingers, U1 in the row
    above fed from both sides), so the firmware sees ordinary addresses. preroute.py
    now also fixes the DVDD spine under the package, the inner 3.3 V supply links,
    pin 51's capacitor and a deterministic fan for the fully used bottom pad row.
    OLED_DC moves to GP34. Exposed pad gets five ground vias. finish.py: DVDD first,
    clearance-aware widening, hairline fixes, unused-via cleanup, overlapping pads.
    Fully routed, zero DRC errors; fab outputs regenerated.
    [interface.kicad_sch, mcu.kicad_sch, tspico-v3.kicad_pcb]
2026-09-17 Board regenerated by the unattended flow: clean DRC with no hand edits
    gen_layout -> preroute -> autoroute -> finish, run end to end. Fab outputs regenerated.
    [tspico-v3.kicad_pcb]
2026-09-17 Silkscreen pass: designators placed clear of pads and edge; DRC clean at every severity
    silk.py places 103 of 140 reference designators at 0.8 mm, hides the ones in
    rows too dense to label (still on F.Fab), and trims connector outlines at the
    board edge. finish.py now peels back the stubs left by removed unused vias.
    [tspico-v3.kicad_pcb]
2026-09-17 Respace audio, joystick and SD passives for silkscreen; rerouted, DRC clean
    Rows and columns of passives now leave room for a designator beside each part:
    139 of 140 are on silk (only C39 in the regulator cluster is hidden). silk.py
    sizes labels by their glyphs, keeps a row's labels on one side and retries hidden
    ones by moving a neighbour. finish.py peels unused stubs in fresh interpreters
    and fetches zones before removals (pcbnew segfaulted otherwise).
    [tspico-v3.kicad_pcb]
2026-09-17 flow.py: one-command flow that re-routes when the finisher cannot close the board
    Freerouting is not repeatable; about one run in three leaves a U1 address pin
    sealed in. finish.py now tries lifting the neighbours (rejecting via-heavy
    detours), exits non-zero when the board is not clean, and flow.py routes again
    from the placement. Board regenerated by flow.py: closed on attempt 2, DRC clean
    at every severity, 139/140 designators on silk.
    [tspico-v3.kicad_pcb]
2026-09-17 Pre-route U1's address pins as a staggered via fan; flow closes first try
    U1's Z80-side row faces U2 across a 0.8 mm gap, so A0-A7 can only leave under
    U1's body, and the router sometimes sealed one in (A5, A3). With the fan fixed
    in preroute.py three flow.py runs out of three closed on the first attempt,
    DRC clean at every severity.
    [tspico-v3.kicad_pcb]
2026-10-04 Add v3 bring-up test firmware
    USB-serial self-test for the RP2350B board: clocks, QSPI flash, XL9555
    expander, pin bridges, RESET_HOLD, microSD, ESP32-C3 EN/IO9 control and
    boot banner, OLED colour bars, plus interactive LED, joystick, audio and
    ESP32 passthrough checks. Pin map taken from the schematic netlist.
    Drives nAEN_LO, nAEN_HI and nDATA_OE high first thing: they have no
    external pull-ups, so U1-U3 are all enabled while the RP2350 is in reset
    or BOOTSEL. Proto1 board 1 passes all 12 automatic tests.
    [main.c]
2026-10-04 Add plan for porting the v2.1 firmware to v3
    Maps the v2.1 firmware's hardware layer against the v3 board, and lays
    out the port in phases: a C bus spike that proves PIO+DMA memory
    emulation on a 2068, a MicroPython upgrade isolated on v2 hardware, the
    v3 board definition and tsbus C module, a shared board layer, v2.1
    feature parity, then v3-only features. Ends with risks and the decisions
    needed from the firmware maintainers.
2026-10-04 Add ESP32-C3 USB bridge and Zimodem build; dim the LED
    esp_bridge turns the card's USB port into a USB-serial adapter for the
    ESP32-C3: UART0 follows the host's line coding, and DTR/RTS drive EN and
    IO9 through the expander with the usual auto-reset logic, so esptool and
    pio flash the module without buttons and terminals leave it running.
    firmware/zimodem builds Zimodem 4.0.3 (pinned commit) for the module with
    PlatformIO, pulling up the unconnected DTR and pulse-dial inputs so they
    cannot hang up a call. Flashed through the bridge at 460800 and verified
    on proto1; Zimodem answers at 115200 and joins WiFi.
    The pin map, safe start-up and expander code move to board.c so both
    programs share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
    [board.c, board.h, esp_bridge.c, main.c]
2026-10-07 Self-test: drive 4-pin I2C OLEDs (128x32 SSD1306, 128x64 SSD1309) on J3
    J3 is wired for the SPI SSD1351 module, but its DIN and CLK pins (GP43,
    GP42) are also I2C1 SCL and SDA, so a 4-pin I2C display works with jumper
    wires. The `o` test now probes 0x3C/0x3D first: if a display answers it
    is set up as a 128x32 SSD1306, or as a 128x64 SSD1309 with `o 64` (64
    rows, 64-row COM wiring, no charge pump since the module's boost converter
    supplies the panel), and shows a border with TS-PICO V3 / OLED OK. With no
    I2C display it falls back to the SSD1351 colour bars.
    The README gets the J3 wiring for these modules: their VCC and GND are
    swapped relative to J3, so they must be wired by name.
    Co-Autho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
    [main.c]
2026-10-07 Phase 1 bus shadow test: follow every 2068 memory read without driving it
    bus_shadow runs the whole served-memory-read path on the real bus while
    the 2068 keeps running on its own ROM. bus_fetch (PIO1) reads the address
    through the U1/U2 byte mux, appends the class from /ROSCS and /EXROM, and
    pushes a pointer to an endless two-channel DMA chain that returns the byte
    onto MD; U3 stays off, so MD never reaches the 2068. bus_decide (PIO0)
    applies the v2.1 HOME/EXROM/DOCK rule and core 1 counts the results.
    Four marker state machines in PIO2 (GPIO base 16, signalled through the
    RP2350's neighbouring-PIO IRQ flags) put the front-end, DMA, serve and /BE
    timing on J3 for the logic analyser. The by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
2026-10-07 bus_shadow: measure its own timing and log captured addresses
    Until the logic analyser arrives, the card times itself. stopwatch_strobe
    (PIO1) measures how long each read strobe stays low, and the READY marker
    (now spanning strobe seen to byte on MD) counts that interval through
    `mov y, status` on its end flag. Core 1 keeps min/avg/max and histograms;
    'm' prints them with the worst case (shortest strobe minus slowest byte).
    A third DMA channel, chained after each byte, copies the pointer into a
    16 KB ring; 'a' decodes the last 32 so address capture can be checked
    against ROM execution.
    SDK 2.1.1's pioasm emits an undefined STATUS_IRQ_INDEX for
    `.mov_status irq`, so the status selector is s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
    [bus_shadow.c]
2026-10-07 bus_shadow: keep the first 4096 reads after each release from reset
    Releasing the 2068 ('g' or 'r') now points the logging DMA channel at a
    separate boot log; once 4096 reads are in, core 1 points it back at the
    rolling ring, so 'a' keeps working. 'b [n]' prints the boot log 64 reads
    at a time, with the class and the byte served for each. The Z80 starts at
    0000, so this checks address capture from the first cycle against a
    known sequence. Releasing also clears the timing figures.
    [bus_shadow.c]
2026-10-07 bus_shadow: fix address capture timing, measured on board 1 in a 2068
    First run in a 2068: counts and timing were sound, but the captured
    addresses were wrong. Each address buffer was sampled only 13 ns after
    being enabled, so the first sample caught MD's leftover from the previous
    cycle and the second caught the high byte still lingering from U2.
    The delays are now adjustable ('x h l'). A sweep on board 1 showed a buffer
    needs about 20 ns; the defaults give 33 ns each. /ROSCS and /EXROM are
    sampled at the earliest point that allows (20 cycles, 133 ns): the boot's
    EXROM and DOCK counts were identical from 93 ns to 160 ns.
    Result: the boot log matches the stock ROM exactly (0000-0007, JP 0D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
    [bus_shadow.c]
2026-10-07 Phase 1 step 3: serve the 2068's HOME ROM from the card
    bus_serve replaces bus_decide in PIO0 while serving ('e 1', only with the
    2068 held). It classifies reads the same way; for a HOME read it asserts
    /BE once the class is known, enables U3 when bus_fetch signals (PIO0 flag
    0, raised with irq prev) that the byte is on MD, and releases both when the
    strobe ends. EXROM, DOCK and RAM reads stay with the 2068. nDATA_OE and
    BE_REQ belong to PIO0 only while serving; otherwise the SIO holds U3 off
    and /BE released.
    The served copy of the ROM says "TS-Pico v3 ROM" in place of "Timex
    Computer". On board 1 the 2068 booted to "(c) 1983 TS-Pico v3 ROM Corp"
    and ran its normal idle loop, so the card,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
    [bus_shadow.c]
2026-10-07 Phase 1 step 4: serve DOCK and EXROM reads; EXROM with /BE crashes the boot
    bus_serve now answers EXROM and DOCK reads as well as HOME, each switchable
    while running by patching its branch in PIO memory: 'y' leaves EXROM to the
    2068, serves it with /BE, or serves it without /BE; 'k' serves DOCK reads
    from the card's image (no /BE). bus_decide and bus_serve now push a raw
    snapshot of GP13-GP20 and core 1 works out the class, which freed the PIO0
    instructions for this.
    On board 1: DOCK reads work (BASIC mapping chunk 4 to the dock read
    "TS-PICO DOCK" from the card). EXROM served without /BE works, with the
    boot's EXROM-to-RAM copy identical to a stock boot. EXROM served with /BE
    crashes the b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
    [bus_shadow.c]
2026-10-07 bus_shadow: early /BE experiment and 250 MHz; opcode timing is tight
    'z 1' makes bus_serve assert /BE for every low-16K read from A15:A14 alone,
    about 60 ns after the strobe, instead of once /ROSCS and /EXROM are known.
    bus_shadow now runs at 250 MHz (flash divider 3 first, core at 1.20 V),
    keeping the measured delays in nanoseconds.
    On board 1 this showed that with late /BE the 2068's own ROM was most likely
    answering opcode fetches alongside the card. With early /BE every opcode
    comes from the card: at 180 ns to the byte on MD the boot's first memory
    loop never ends, at 156 ns it gets through. The RAM test after it then
    fails, as if writes following a card-served read are lost, the same
    s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
    [bus_shadow.c]
2026-10-07 bus_shadow: track the 2068's bank registers; every boot read predicted
    io_snoop (PIO1) reads every Z80 I/O write: the port's low address byte
    through U1 and the data through U3 (which only points from the Z80 onto MD
    during writes). Core 1 keeps a shadow of ports F4h (HSR) and FFh, predicts
    each logged read's class from the shadow and its address, and compares it
    with what /ROSCS and /EXROM said; 'v' reports. On board 1 a shadow boot's
    3.2 million reads all matched, through the boot's bank switching. That
    gives the class from the address alone, early enough for early /BE.
    The strobe stopwatch and the FRONT marker went to make room in PIO1.
    A stalled PIO instruction keeps asserting its side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
    [bus_shadow.c]
2026-10-07 bus_card: serve path redesigned around the bank shadow; HOME fully served
    A second bus program alongside bus_shadow. The class of each read now
    comes from the shadow of ports F4h and FFh, not from /ROSCS and /EXROM:
    - serve (PIO0, owns MD and BE_REQ) reads the address off MD, decides from
    A15..A13 through an 8-entry jump table at the start of PIO0 memory that
    core 1 rewrites whenever the shadow changes, asserts /BE at once for
    HOME and EXROM, pushes a pointer for exactly the byte needed, and drives
    it. Exactly 32 instructions.
    - addr_read (PIO1, owns the U1/U2/U3 enables) sequences the address
    buffers in windows that bracket serve's samples, and turns U3 on as soon
    as serve asks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
    [bus_card.c]
2026-10-07 bus_card: EXROM and DOCK served too; all three read paths work
    With the class from the bank shadow and /BE about 50 ns into the cycle,
    EXROM served with /BE now works on board 1: the boot's 1988 EXROM reads
    come from the card and its EXROM-to-RAM copy sums to 210966, as on a stock
    2068. DOCK reads served from the shadow work too ("TS-PICO DOCK" via BASIC).
    The byte stayed 48 ns after serve's request across 159 million reads
    (worst 60 ns). README records the design and the results.
2026-10-07 bus_card: DOCK RAM writes
    mem_write (PIO1) reads every Z80 memory write through the three buffers
    (U2, U1, then U3 pointing from the Z80 onto MD) and pushes address and data;
    core 1 stores the byte in the DOCK image when the bank shadow maps the chunk
    to the dock and DOCK serving is on. addr_read gives up two instructions to
    make room (the stale U3 request is cleared at the end of a read; "U1 off"
    shares an instruction), so PIO1 is exactly full.
    On board 1, BASIC wrote 256 bytes into the dock through chunk 4 and read them
    back with no errors (992 bytes over about four runs), while 168 million other
    memory writes, the boot's memory test included, were left alone.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
    [bus_card.c]
2026-10-07 bus_card: ports 0Eh/0Fh, the TS-Pico protocol ports
    OUTs come in through io_snoop: core 1 takes the 0Eh/0Fh writes, sets the
    status to 00h (busy, as v2.1's PIO did) and, in echo mode for now, queues the
    byte for IN 0Eh. INs are handled by core 1 from a GPIO edge interrupt on
    nIORD: it forces U1 on through a GPIO override to read the port and, for
    0Eh/0Fh, pushes the reply to io_drive (5 PIO0 instructions) and forces U3 on
    until the strobe ends. An IN leaves about 600 ns before the Z80 samples.
    serve went from 32 instructions to 27 to make room (/BE as side-set, the
    table dispatch by `out pc`, the READY marker removed). Fixes found on board 1:
    INs are edge-triggered and ignored while the 206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
    [bus_card.c]
2026-10-07 bus_card: TS-Pico protocol responder; ROM 2.2 served from the card
    The card now serves the TS-Pico ROM (HOME + 16K EXROM, taken from the
    firmware repo's origin/main) and answers the protocol on ports 0Eh/0Fh:
    SYNC, pre-header, command body with its XOR, an answer, and the tail that
    stages the next pre-load. tpi:info and tpi:nop work from BASIC; other
    commands say they are not here yet.
    Debugging ROM 2.2's key-click crash found the board's /BE bug: nBE has no
    pull-up on proto1, so after a served ROM byte a RAM opcode fetch read
    wrong bits. A 2.2k pull-up to +5V fixed it. New tools: a protocol trace
    (l) and a read/write/I-O snapshot around a trigger (z/Z). MD pads lose
    their pull-downs (RP235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
    [board.c, bus_card.c]
2026-10-09 bus_card: LOAD and SAVE to a RAM tape; ROM 2.3
    SAVE (header, then data) and LOAD/VERIFY/MERGE follow v2's SAVE_TS and
    LOAD_TS: the next block whose flag matches, at most one lap; length and
    XOR checked before streaming; a missing header refused with Report 8
    through the retry's SYNC. Blocks live in a 64 KB TAP-format tape in RAM.
    tpi:rew, tpi:newtap; 'T' lists the tape. CMake now takes the newest
    TSPICO-NN.ROM from the firmware repo (2.3), and tpi:info shows the ROM
    version the 2.3 pre-header carries.
    Tested on board 1 with ROM 2.3: a BASIC program and a SCREEN$ saved,
    loaded and verified.
    [bus_card.c]
2026-10-09 bus_card: printer transactions (LPRINT, LLIST, COPY)
    As v2's PRINT_IO: one transaction per character, with a pattern body
    for characters 80h and up; COPY's display memory as a checked body.
    Text goes to a buffer ('P'), translated as v2's TextCapture; 'Y' dumps
    the last COPY's screen. Tested on board 1 with ROM 2.3: LPRINT and LLIST
    text, and a COPY rebuilt on the Mac matching the screen.
2026-10-09 Port plan: phase 1 results; phase 3 gives core 1 to tsbus and makes MQ a tsbus object
    Phase 1 is done on board 1 (bus, protocol, LOAD/SAVE, printer). Record
    what the later phases depend on: 250 MHz, the bank shadow, full PIO
    blocks, INs on core 1, the /BE pull-up. Phase 3: core 1 belongs to tsbus
    (BLINK_LED and the log writer move to core 0); MQ is a tsbus object over
    core 1's queues, with a block call in place of v2's DMA streams. R2 and
    R6 updated.
2026-10-09 Port plan: phase 2 done (MicroPython v1.29.0, firmware #121)
    The firmware moved to v1.29.0 in #121 before phase 1 began. Records the
    checks phase 2 asked for: RP2350B and PIO GPIOBASE support in v1.29.0,
    mpy-cross, asm_pio_encode, sm.exec timing measured on a v2.2 board, RAM,
    and the exit test. Resolves R5 and decision 3 (v1.29.0 for both boards),
    and notes the pico-sdk 2.1.1 -> 2.3.0 step for phase 3.
2026-10-09 Bring-up on pico-sdk 2.3.0: same layout, same timing, phase 1 checks pass
    Phase 3 starts by rebuilding the bring-up on the SDK MicroPython v1.29.0
    bundles (2.3.0; phase 1 used 2.1.1), so an SDK change can't hide inside
    the move into MicroPython. All targets build clean on both. bus_card's
    runtime still ends below 0x20040000, the same functions are in RAM and
    the hot path makes no flash calls. On board 1 with ROM 2.3: boot, typing,
    tpi:info, SAVE/LOAD/VERIFY, LPRINT/LLIST/COPY and DOCK writes pass. IN
    timing matches 2.1.1 (worst 320 vs 316 ns; "late" strobes at the same
    rate on both, during protocol work only).
2026-10-10 bus_card: long IN strobes measured; cycle-counted 4 us IN guard
    Phase 1's open question: about a fifth of protocol INs outlasted core 1's
    IN guard. PIO2 now times every /IORD pulse independently (iord_len + a DMA
    ring), and core 1 logs long INs by port with the reads around them ('d').
    The 2068 stretches some IN cycles by whole T-states, up to 2.4 us, when
    the IN runs from RAM or the EXROM but hardly ever from the HOME ROM. The
    card doesn't cause it; the exact SCLD rule is left open (inferred: clock
    held against the display fetch). The old guard, 2 us of the 1 us timer
    from U3 on, could end before the Z80 sampled the reply. It is now 1,000
    core cycles (4 us) from the handler's entry: 310,22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
    [bus_card.c]
2026-10-10 Port plan: phase 3 results (exit test passed; firmware #234-#236)
    Records what phase 4 needs from phase 3: the board, the memory and core 1
    arrangements, the two clock/flash traps (no 250 MHz boot; boot2 divider
    3), tsbus and MQ as built and tested on board 1, the SCLD stale-state
    recovery, and what is left (switch_slot).
2026-10-10 Port plan: phase 4 results (exit passed on both boards)
2026-10-11 TS-Pico v2.5 and v2.6: the v2.2 circuit on the v3 outline
    Both keep v2.2's bus logic, designators and Pico GPIO map, so the shipped
    firmware runs unchanged, and both carry R12 (4.7k D6 pull-down at U6, a
    rework on built v2.2 boards that is not in the 2023 files).
    hardware-v2.5: all surface mount. Raspberry Pi Pico module reflowed on its
    castellations, SST39SF040 in PLCC-32, 512K x 8 SRAM in SOIC-32, 74LS in
    SOIC, on-board micro SD. Adds bench programming of the soldered flash from
    the Pico (three 74HCT595s on the SD pins, RUN/PROG switch, +15 V interlock)
    because the firmware maps HOME ROM from flash at power-on. Routed, ERC/DRC
    clean, $23.92/board at 10.
    hardware-v2.6: RP2040 chip-down (m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
    [benchprog.kicad_sch, interface.kicad_sch, logic.kicad_sch, mcu.kicad_sch, memory.kicad_sch, pico.kicad_sch, tspico-v2.5-bom-full.csv, tspico-v2.5-jlcpcb-bom.csv]
2026-10-12 v2.6 prototype 2: glue logic in 74LVC, TPS3808 reset
    The v2.2 glue (74LS04/27/32/09/157) is rebuilt in 74LVC at 3.3 V, because
    the SN74LS09 (56) and XL74LS27 (108) were scarce at JLCPCB and every glue
    output already ends at a 3.3 V part. Same logic at every Pico pin, so no
    firmware change:
    - U5 74LVC138 decodes the port (A4-A6 select; /IORQ, A7, /M1 enables);
    JP4 now picks output O0 ($00-$0F) or O1 ($10-$1F)
    - U4 74LVC32: /+RW (buffered so it keeps step with /+W), /+W = /+RW-select
    OR /RD, /RDROM = A14 + A15 + /RD
    - U1 74LVC1G97 (mux wired as OR with one inverted input): /MREQ_G
    - U9 74LVC2G07 open-drain /BE driver; U7 channel 5 now carries /BE_IN as
    /BE_STAT, so R4 and R7 go
    - U8 74L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
    [interface.kicad_sch, logic.kicad_sch, mcu.kicad_sch, memory.kicad_sch, tspico-v2.6-bom-full.csv, tspico-v2.6-jlcpcb-bom.csv, tspico-v2.6.kicad_pcb]
2026-10-12 v3 prototype 2: bus pull-ups, SD socket power switch, PSRAM footprint
    Fixes from proto1 bring-up and issue #21:
    - R14 2k2 from nBE (edge A29) to +5V_EDGE. The 74LVC06 only pulls /BE
    low; without a pull-up it rose too slowly and a RAM opcode fetch after
    a served byte read wrong bits. Same value as the bodge on board 1.
    - R15-R17 10k pull-ups on GP8-GP10 (nAEN_LO, nAEN_HI, nDATA_OE). The
    RP2350 resets its pads with pull-downs, so in reset and BOOTSEL all
    three buffers were enabled and U1 and U2 both drove MD.
    - U32 SY6280AAC current-limited switch on the SD socket's VDD (+3V3_SD),
    enabled from XL9555 P0.6 (SD_PWR_EN), held off by R43 until the
    firmware sets it; R42 15k sets 0.45 A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
    [interface.kicad_sch, mcu.kicad_sch, memory.kicad_sch, storage_display.kicad_sch, tspico-v3-bom-full.csv, tspico-v3-jlcpcb-bom.csv, tspico-v3.kicad_pcb]
2026-10-12 v3 proto2: fit L1 by hand (not stocked at JLCPCB)
    The RP2350 core-regulator inductor, Abracon AOTA-B201610S3R3-101-T,
    was out of stock at JLCPCB and LCSC on 2026-10-12. Raspberry Pi's
    design guide names no substitute (it is the only polarity-marked 0806
    part, made for them), so L1 is DNP in the JLCPCB order and fitted by
    hand from DigiKey/Mouser stock: dot on pad 2 (DVDD), the end away from
    the board's top edge.
    Only L1's DNP attribute changes in the board file; no routing touched.
    Gerbers identical to v3.0-proto2 apart from date stamps; the BOM and
    placement file lose L1 (39 lines, 139 parts). Also corrects the parts
    table note, which had the dot on pin 1.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
    [mcu.kicad_sch, tspico-v3-bom-full.csv, tspico-v3-jlcpcb-bom.csv, tspico-v3.kicad_pcb]
2026-10-12 Port plan: phase 6 progress (SD slots, the TS2050 modem)
2026-10-19 v3: schematic and PCB PDFs, renders in the README
    hardware/docs/ holds the schematic PDF (9 sheets) and a multipage PCB
    plot (copper, silkscreen, fab layers). hardware/renders/ has top, bottom
    and isometric renders. The root README shows the v3 renders plus the
    existing v2.6 and v2.5 ones; hardware/README.md lists the kicad-cli
    commands to regenerate everything.
2026-10-19 v3 proto3: male DE-9, I2C OLED header, buttons in a 2x2 block
    - J5: male DE-9 (CONNFLY DS1037-09MNAKT74-0CC, C75750). Atari sticks end
    in a female plug; proto1/2's female footprint mirrors every pin under a
    male part, putting the stick's ground on pin 7 (JOY_5V, open), so nothing
    read. Same body position and mounting holes as proto2.
    - J3: 1x4 header for a 1.54in 128x64 SSD1309 I2C module (1 GND, 2 +3V3,
    3 SCL GP43, 4 SDA GP42) on I2C1, R44/R45 4k7 pull-ups. Replaces the 7-pin
    SSD1351 SPI header; GP34, GP41 and expander P0.2 (with R11) are freed.
    - SW3 under SW1, SW4 under SW2, so the module covers no buttons; D4/R5
    move left of the ESP32, between H1 and the USB-C socket.
    Routed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
    [joystick.kicad_sch, mcu.kicad_sch, memory.kicad_sch, storage_display.kicad_sch, tspico-v3-bom-full.csv, tspico-v3-jlcpcb-bom.csv, tspico-v3.kicad_pcb]
2026-10-19 v3 proto3: schematic and PCB PDFs, renders
2026-10-19 README: what the TS-Pico does, and each board's hardware
2026-10-19 CERN-OHL-S-2.0 licence; board labels and OSHW logo on v3 and v2.6
    - LICENSE: CERN Open Hardware Licence v2, Strongly Reciprocal, for the
    hardware designs; the README says what it covers and what it does not
    (firmware/, the Pico SDK import file, Zimodem, KiCad library parts).
    - hardware/scripts/labels.py: board name on the top silkscreen; name,
    repository URL (the licence's Source Location), licence and the OSHW logo
    on the bottom. Silkscreen only, rerunnable on a routed board, and it
    refuses to save a label that lands on a pad, courtyard or other silk.
    Both flow.py scripts run it last, since gen_layout.py rebuilds the board.
    - Applied to the v3 and v2.6 boards: copper untouched,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
    [tspico-v2.6.kicad_pcb, tspico-v3.kicad_pcb]
2026-10-19 Edge connector: side A confirmed as the top side
    Proto1 proved it in a 2068 on 2026-10-07: in shadow mode it read every
    address through the side-B fingers, the boot log matching the ROM, then
    served the HOME ROM onto side A (/MREQ, /RD, /BE on A29, D0-D7) and the
    2068 booted to the card's ROM banner. The README's "assumption to verify"
    and gen_board.py's comment now say so.
2026-10-20 Scripts: flow.py falls back to FREEROUTING_JAR
    flow.py's --jar now defaults to $FREEROUTING_JAR, as autoroute.py's
    already did. Both expand ~ and stop before touching the board if
    the jar isn't there.
2026-10-22 v3 proto3.1: proto3 with board labels, L1 assembled again
    Same copper as v3.0-proto3: copper, mask, paste, outline and drill
    Gerbers are identical; only the two silkscreen layers differ, carrying
    the board name, repository URL, licence and OSHW logo added on main
    (labels.py, a875e92).
    L1 (Abracon AOTA-B201610S3R3-101-T) is back in the JLCPCB BOM and
    placement: 326 in stock on 2026-10-22, after being out of stock on
    2026-10-12 (proto2.1 and proto3 hand-fitted it). Only L1's DNP flag
    changes in the schematic and board; no routing touched. The fab notes
    say to recheck its stock at upload and to fall back to hand-fitting.
    U22 (PSRAM) stays hand-fitted.
    DRC clean at every severity; ERC: the one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
    [mcu.kicad_sch, tspico-v3-bom-full.csv, tspico-v3-jlcpcb-bom.csv, tspico-v3.kicad_pcb]
2026-10-22 Full BOM: list every part, with who fits it
    bom/tspico-v3-bom-full.csv was exported with --exclude-dnp, so the
    hand-fitted parts (U22, and L1 while it was DNP) were missing from the
    one BOM meant to list everything. It now includes DNP parts and adds a
    "Fitted by" column: JLCPCB, hand (DNP), hand (J3/J5, through-hole), or
    none (edge fingers, test points, solder jumper). Grouping adds DNP so a
    fitted and an unfitted part never share a line.
    The JLCPCB upload BOM and CPL are unchanged.
    [tspico-v3-bom-full.csv]
2026-10-22 v3 proto3.1: regenerate schematic and PCB PDFs, renders
    L1 is assembled again in proto3.1, so the schematic no longer marks it
    DNP and the PCB fab pages no longer cross it out. U22 is the only DNP
    part left.
2026-11-04 v3 proto4: feed the RP2350 core from an ME6211C12 LDO, drop L1
    Replace L1 (Abracon AOTA-B201610S3R3-101-T, out of stock at JLCPCB on
    2026-10-12 and down to 1 on 2026-11-04) and the RP2350's on-chip switcher
    with an ME6211C12M5G-N LDO (U33, C236672) on DVDD, per RP2350 datasheet
    section 6.3.7 / figure 24: VREG_LX open, VREG_FB to GND, VREG_VIN and
    VREG_AVDD still powered. C53 1 uF at its input, C20 4.7 uF at its output.
    1.2 V is the value the firmware already sets for the 250 MHz bus clock
    (OpenSpand made the same choice at 208 MHz). The ME6211 is +/-1%, tighter
    than the on-chip regulator's +/-3% at the same setting.
    Layout: U33 sits above the chip's top-left corner (C31 moves left of R28);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
    [mcu.kicad_sch, tspico-v3-bom-full.csv, tspico-v3-jlcpcb-bom.csv, tspico-v3.kicad_pcb]
